MahmudElyamani/1kW-Resonant-Inductive-Wireless-Power-Transfer-System-Graduation-Project-/WPT Coil design/README.md

# Coil Topology Presentation
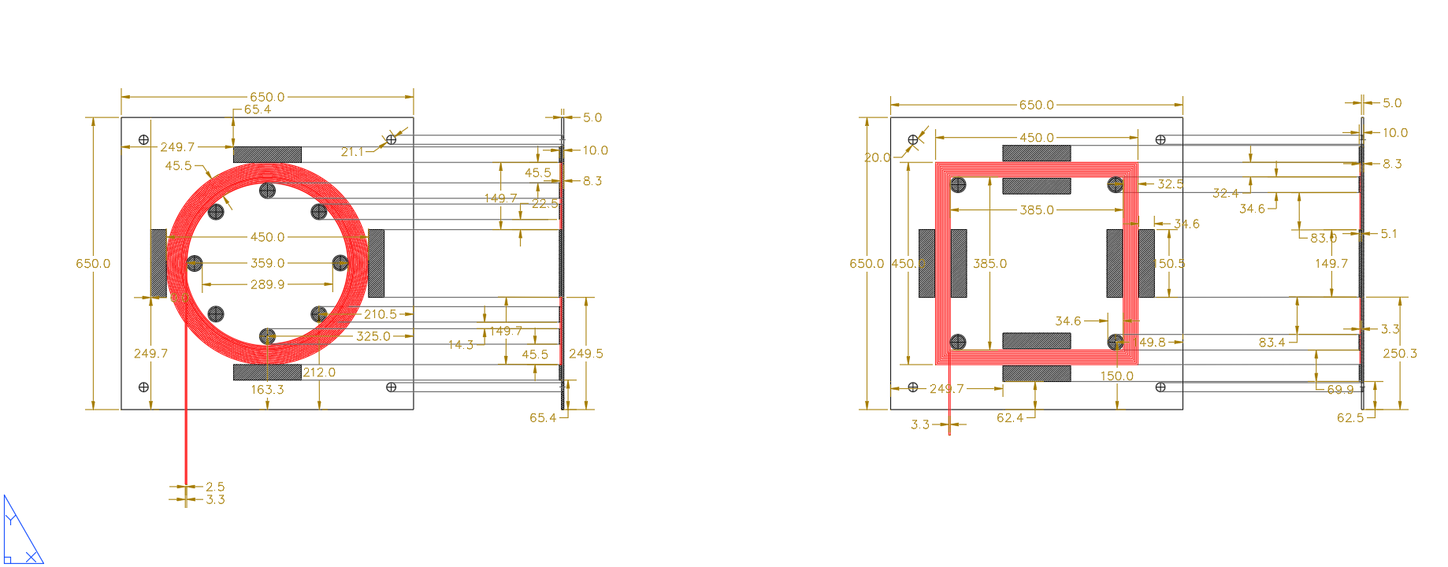
[picture p23: WPT Coil design/inductco.PNG]
Full Power System Model


# Actual Induction coils shot from laboratory 
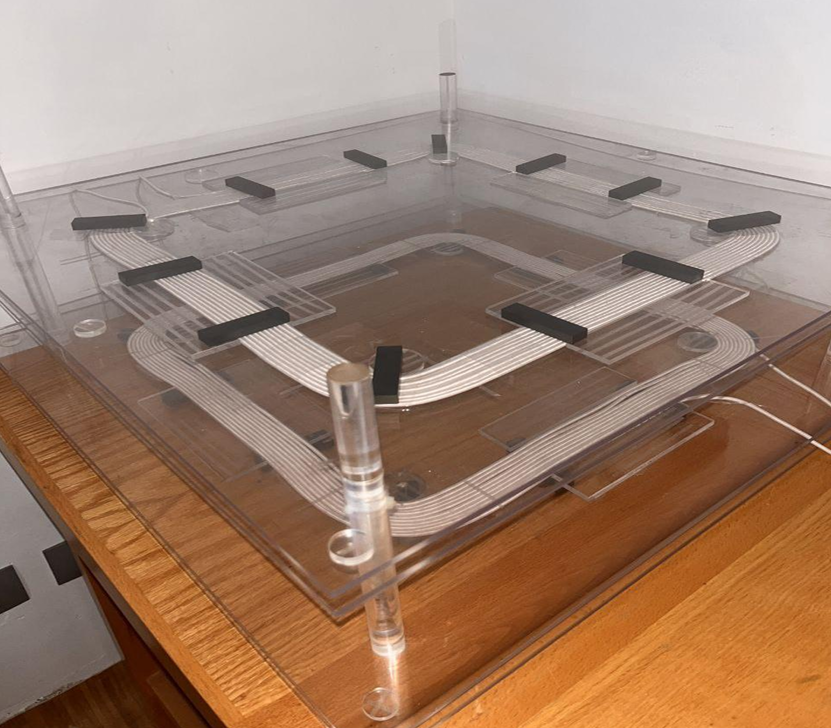
[picture p24: WPT Coil design/WPTC.PNG]
InductionCoilsActual
