MahmudElyamani/1kW-Resonant-Inductive-Wireless-Power-Transfer-System-Graduation-Project-/WPT-Book.pdf

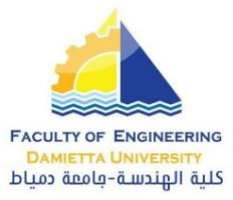
[picture p45: figure]
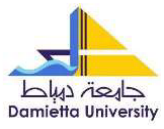
[picture p46: figure]

# An efficient 1KW resonant inductive wireless power transfer prototype for electric vehicles, with square-shaped coils

### Prepared by

Mahmoud Hisham Elyamani | Walid Salah Gebril
Mohamed Atef Ameen | Ezzeldin Ali Khedr
Mohamed Tarek Ouf | Manar Dawoud Mohammed
Eslam Ayman Badawy | Zeinab Elsayed Abdelbasset

B.Sc. Students in Electrical Power and Machines Department Faculty of Engineering, Damietta University

### Under Supervision of

# Prof.Dr. Osama Ali Orabi Dr. Mohamed Osman Atallah

Electrical Power and Machines Department Faculty of Engineering
Damietta University
| 2024 – 2025

# An efficient 1KW resonant inductive wireless power transfer prototype for electric vehicles, with square-shaped coils

### Prepared by

Mahmoud Hisham Elyamani | Walid Salah Gebril
Mohamed Atef Ameen | Ezzeldin Ali Khedr
Mohamed Tarek Ouf | Manar Dawoud Mohammed
Eslam Ayman Badawy | Zeinab Elsayed Abdelbasset

B.Sc. Students in Electrical Power and Machines Department Faculty of Engineering, Damietta University

### Under Supervision of

# Prof.Dr. Osama Ali Orabi Dr. Mohamed Osman Atallah

Electrical Power and Machines Department Faculty of Engineering
Damietta University
| 2024 – 2025

# ر ِحيِم

# ِن ال َّ

ـ

ٰ
ح َم

ْ
ر

# ـ ِه ال َّ

َّ

# سِم الل

ْ ِ
ب

## ل َحِكيمُ "

## لعَِليمُ اْ

## أن َت اْ

ن َك َ

َّ

## ل ْمتََناۖ إِ

َّ

## َل َما َع

َّ

## لَنا إِ

َ
لمَ

## لوا سُ ْب َحاَن َك ََل ِعْ

قاُ
َ "

## سورة البقرة اآلية )32(

I

# Team Data

No. | Name | E-mail
1 | Mahmoud Hisham Elyamani | Mahmoud.elyamani.7@gmail.com
2 | Walid Salah Gebril | walidsalahgebril1282002@gmail.com
3 | Mohamed Atef Ameen | mfarh2684@gmail.com
4 | Ezzeldin Ali Khedr | ezzoeldin24@gmail.com
5 | Mohamed Tarek Ouf | mohamedtarekouf1@gmail.com
6 | Manar Dawoud Mohammed | manardawoud80@gmail.com
7 | Eslam Ayman Badawy | eslaambadawy@gmail.com
8 | Zeinab Elsayed Abdelbasset | zeinabsraya@gmail.com

II

# Acknowledgment

## Before all, we deeply thank ALLAH for helping us to accomplish this Project and we devote it to our families especially our parents, for their encouragement, patience

and assistance over the years.

## It is a pleasure to express our deepest thanks and profound respect to Dr. Mohamed Osman Atallah for his continuous encouragement and invaluable supervision and guidance throughout this work. It has been an honor and a

privilege to work under his generous supervision.

Also, we wish to express our deep gratitude to Prof.Dr.

## Osama Ali Orabi for his kind support, help and careful

supervision.

## Furthermore, we wish to express our deep gratitude to Assistant Prof.Dr. Marwa Fayez Fahmy, the head of the Electrical Power and Machines Department, Faculty of

Engineering, Damietta University, for her supervision, guidance and meticulous oversight.

## Sponsored by:

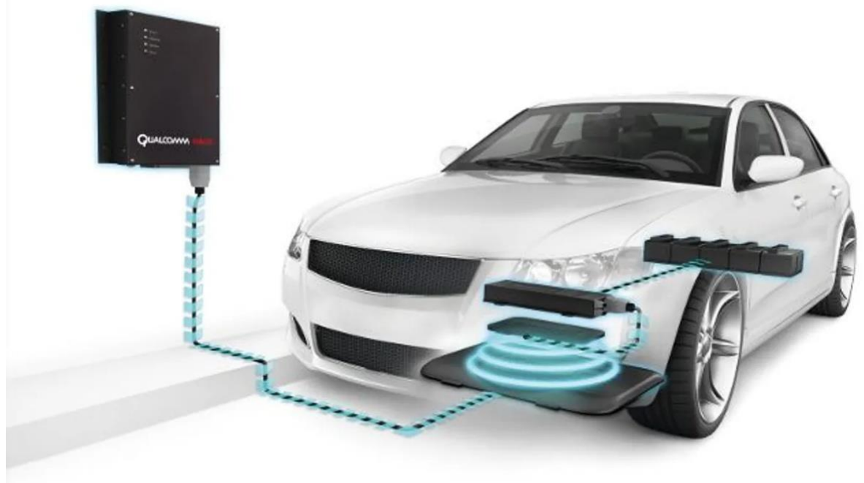
[picture p47: figure]

III

# Abstract

In this project, a practical prototype of a resonant inductive wireless

charging system for electric vehicles is implemented. The system delivers

a DC output power of 823-watt when the coils are aligned with a 15 cm air

gap between the 45 x 45 cm square transmitter coil and the 45 x 45 cm

square receiver coil. The system operates at a resonant frequency of 83.5

kHz which is in accordance with the SAE J2954 international standard,

achieving an efficiency of 77.5%.

The system is simulated using ANSYS Maxwell 3D and ANSYS

Simplorer softwares to study the magnetic-field distribution for different

coil geometries such as circular and square coils at various misalignment

positions as well as the effect of ferrite magnets, and to determine the

system parameters.

The simulation results are compared with practical values and

verified using mathematical equations and MATLAB/Simulink software

to ensure the accuracy of the simulation.

IV

# Table of Contents

V

# List of Abbreviations

AC | Alternating Current
BMS | Battery Management System
CC | Constant Current
CF | Crest Factor
CL | Capacitor Inductor
CV | Constant Voltage
CWPT | Capacitive Wireless Power Transfer
DC | Direct Current
DD | Double-D
EVs | Electric Vehicles
FEA | Finite Element Analysis
FEMs | Finite Element Models
GCR | Ground Clearance Range
GSP | Ground Side Pad
HF | High Frequency
HFI | High Frequency Inverter
HV | High Voltage
IWPT | Inductive Wireless Power Transfer
KVL | Kirchhoff’s Voltage Law
LC | Inductor Capacitor
LCC | Inductor Capacitor Capacitor
MEPT | Maximum Efficiency and Power Tracking
MGWPT | Magnetic Gear Wireless Power Transfer
MPP | Maximum Power Point
NPPs | Non-Polarized Pads
PF | Power Factor
PMs | Permanent Magnets
PP | Parallel-Parallel
PPs | Polarized pads
PS | Parallel-Series
QD | Quad-D
RIWPT | Resonant Inductive Wireless Power Transfer
SAE | Society of Automotive Engineering

VI

SP | Series-Parallel
SS | Series-Series
WPT | Wireless Power Transfer

VII

# List of Acronyms

CF | The filtering capacitance before the load
Cr | The capacitance of the receiving circuit
Ct | The capacitance of the transmitting circuit
Di | The inner diameter of each turn
Do | The outer diameter of each turn
Ds | The diameter of each strand
f | The resonant frequency
H A constant correlating to the number of strands, as | specified in the datasheet of Litz wire
h | The gap distance between the two coils
Iin | The input RMS supply current
IL | The output load DC current
Ir | The RMS receiving current
It | The RMS transmitting current
K The coupling coefficient
Lr | The self-inductance of the receiving coil
Lt | The self-inductance of the transmitting coil
lLitz | The length of the Litz wire
lr | The outer length of the receiving coil
lri | The inner length of the receiving coil
lt | The outer length of the transmitting coil
lti | The inner length of the transmitting coil
M The mutual inductance
N The number of strands
PAC | The RMS power delivered to the equivalent AC resistive load
Pbat | The battery power
Pin | The input active power
PL | The output load DC power
Qin | The input reactive power
RAC | The AC resistance of the Litz wire which represents both the skin and proximity effects
RDCl | The DC resistance of the Litz wire per length
RL | The DC resistive load
RLeq | The equivalent AC resistive load

VIII

Rr | The DC resistance of the receiving coil
Rt | The DC resistance of the transmitting coil
rr | The half of side length of the receiving coil
rt | The half of side length of the transmitting coil
Si | Surface copper area of each turn, without the insulation
sin | The input apparent power
So | Surface area of each turn, considering the insulation
Tr | No. of turns of the receiving coil
Tt | No. of turns of the transmitting coil
u | The square side length of each coil
V1 | The output HF AC voltage
V2 | The AC voltage across the equivalent AC resistive load
V1o | The output HF AC voltage at resonance
V2o | The AC voltage across the equivalent AC resistive load at resonance
Vbat | Battery Voltage
VDC | DC output voltage from the DC supply (Input DC voltage to HFI)
Vin | The input RMS supply voltage
VL | The output load DC voltage
W The resistance ratio of a single strand when isolated
wr | The outer width of the receiving coil
wri | The inner width of the receiving coil
wt | The outer width of the transmitting coil
wti | The inner width of the transmitting coil
ηs−s | The efficiency while using SS compensation
µo | The permeability of the vacuum
ρcu | The resistivity of the copper
ω | The angular frequency
ωo | The resonant angular frequency

IX

# List of Tables

Table 1-1: Specific characteristics of compensation circuit topology .......9

Table 1-4: The characteristics of Mn-Zn large size ferrite for high power

Table 2-1: Comparative analysis of the proposed system and existing

Table 3-1: SAE j2954 recommendations concerning Z- class

Table 3-3: Misalignment data in different positions for each scenario....36 Table 3-4: Multiple misalignment error data in case of horizontal

Table 3-5: Multiple misalignment error data in case of horizontal

Table 3-6: Multiple misalignment error data in case of horizontal misalignment in (-x, -y) with a non-uniform air gap in the Z-axis

Table 3-7: Multiple misalignment errors is a horizontal misalignment in (-x, -y) direction, combined with a non-uniform air gap in the Z-axis

X

Table 4-1: The simulated, calculated and measured values of the self-

Table 4-2: The simulated, calculated and practical values of the coupling

Table 4-3: The simulated, calculated and measured values of the self-

Table 4-4: The simulated, calculated and practical values of the coupling

Table 4-5: The simulated, calculated and measured values of the capacitances of the receiving and the transmitting circuits without using

Table 4-6: The simulated, calculated and measured values of the capacitances of the receiving and the transmitting circuits with using

Table 4-7: ANSYS Maxwell 3D results of the M, K and the magnitude of the magnetic flux of the two coils and ANSYS Simplorer results of the

Table 4-8: The comparison between the ANSYS Simplorer, MATLAB Simulink, calculated and practical values of the different electrical

XI

# List of Figures

Figure 3-2: The SS compensation topology with AC/DC converter .......25

Figure 3-4: The ANSYS Maxwell 3D model for the WPT system.........32

Figure 3-6: The different air gaps between the transmitter and receiver

Figure 3-7: The different positions of horizontal misalignment for each

Figure 3-8: Angles exist between the transmitting and receiving coil

Figure 3-9: A non-uniform air gap in the Z-axis direction with rotation

Figure 3-10: Multiple misalignment error positions in case of horizontal

Figure 3-11: Multiple misalignment error positions in case of horizontal

Figure 3-12: Multiple misalignment error positions in case of horizontal misalignment in (-x, -y) with a non-uniform air gap in the Z-axis

Figure 3-13: Multiple misalignment errors is a horizontal misalignment in (-x, -y) direction, combined with a non-uniform air gap in the Z-axis

Figure 3-16: The m-file and the function file for calculating the half of

Figure 3-17: The m-file and the function file for calculating the DC

XII

Figure 3-18: The m-file and the function file for calculating the self-

Figure 3-19: The m-file and the function file for calculating the mutual

Figure 3-20: The m-file and the function file for calculating the coupling

Figure 3-21: The m-file and the function file for calculating the capacitances of the transmitting and the receiving circuits without using

Figure 3-22: The m-file and the function file for calculating the RMS

Figure 3-23: The m-file and the function file for calculating the RMS

Figure 3-24: The m-file and the function file for calculating the RMS power delivered to the equivalent AC resistive load with using ferrite ...77 Figure 3-25: The m-file and the function file for calculating the efficiency

Figure 3-26: Pie chart showing the distribution of the production price for

Figure 4-1: the relationship between horizontal misalignment in X-axis

Figure 4-2: The relationship between horizontal misalignment in X-axis

Figure 4-3: The relationship between vertical misalignment in Z-axis and

Figure 4-4: The relationship between vertical misalignment in Z-axis and

Figure 4-5: The relationship between horizontal misalignment in X-axis,

XIII

Figure 4-6: The relationship between horizontal misalignment in X-axis,

Figure 4-7: The magnetic flux animations of shapes of figure 3-14, 1.

Figure 4-8: The magnetic flux animations of shapes of figure 3-14, 2.

Figure 4-9: The magnetic flux animation of the WPT design using ferrite

Figure 4-10: The results of m-file for calculating the half of side lengths

Figure 4-11: The results of m-file for calculating the DC resistances of

Figure 4-12: The results of m-file for calculating the self-inductances of

Figure 4-13: The results of m-file for calculating the mutual inductance

Figure 4-14: The results of m-file for calculating the coupling coefficient

Figure 4-15: The results of m-file for calculating the capacitances of the

Figure 4-16: The results of m-file for calculating the RMS transmitting

Figure 4-17: The results of m-file for calculating the RMS receiving

Figure 4-18: The results of m-file for calculating the RMS power

Figure 4-19: The results of m-file for calculating the efficiency while

Figure 4-20: The transmitter’s AC current wave obtained from ANSYS

Figure 4-21: The receiver’s AC current wave obtained from ANSYS

Figure 4-22: The load DC current through the resistive load obtained

Figure 4-23: The load DC voltage at the resistive load obtained from

Figure 4-24: The transmitter’s AC current wave obtained from MATLAB

XIV

Figure 4-25: The receiver’s AC current wave obtained from MATLAB
Simulink in case of 15 cm air gap | 121
Figure 4-26: The load DC current through the resistive load obtained
from MATLAB Simulink in case of 15 cm air gap | 122
Figure 4-27: The load DC voltage through the resistive load obtained
from MATLAB Simulink in case of 15 cm air gap | 122
Figure 4-28: The relation between the frequency and output power ..... 124 Figure 4-29: The relation between the frequency and the efficiency .... 124 Figure 4-30: The transmitter electrical box which includes the HFI and
the series transmitter’s compensation | 126
Figure 4-31: The receiver electrical box which includes the series
receiver’s compensation and the AC/DC converter | 126
Figure 4-32: The practical RIWPT system | 127
Figure 4-33: The reading of the DC voltage through the load by a
laboratory scope | 127
Figure 4-34: The reading of the DC current through the load by a
laboratory clamp meter | 128

Chapter (1) | Project Introduction | 1

### 1 Chapter (1): Project Introduction

### 1.1 Introduction

With the world's increasing interest in finding solutions to

environmental issues and climate change, the need has emerged to replace

traditional vehicles that run by fossil fuels with clean EVs that have been

recently developed and spread widely to reduce environmental

pollution[1,2,3]. Recently, electrification has been considered as a

significant revolution within the transportation sector, aiming to improve

efficiency, promote environmental sustainability and enhance safety [4].

The adoption of EVs contributes to decreasing greenhouse gas emissions,

reducing dependance on fossil fuels, improving driving satisfaction and

lower operational costs [4]. The challenges facing the widespread adoption

of EVs include concerns about charging infrastructure availability, range

limits and long duration of the recharging [4].

WPT offers numerous advantages, including automatic operation

without the need for driver intervention, maintenance-free operation,

enhanced safety and convenience in challenging conditions such as snow,

rain, and dust [4].

EV charging is classified into onboard and offboard charging. In

onboard charging, the charging and conversion system is inside the vehicle

and the charging speed is slow because it is limited by the size of the

vehicle, while in offboard charging, the charging and conversion system is

outside the vehicle, usually at charging stations and is connected directly

to the vehicle battery and the charging speed is faster. The charging

systems developed from slow charging (level 1) which is used in homes to

fast charging (level 2) which is used in public places and then to faster DC

charging (level 3) [2].

Chapter (1) | Project Introduction | 2

EV charging systems have developed to become wireless, which

relies on the transfer of energy through a magnetic field between

transmitter and receiver as it does not require cables like traditional

charging. The WPT process is autonomous, which has made it attractive to

charge self-driving EVs as the vehicle can charge itself automatically

without connecting the charging cable. It can also be developed to charge

vehicles while moving wirelessly, which helps increase the range that the

vehicle can travel before the battery runs out, thus saving time and making

the charging process more convenient [1,2,5].

Chapter (1) | Project Introduction | 3

### 1.2 Methods of WPT

I) CWPT: This type is characterized by its low cost, as it does not

require a ferrite magnet, and it also features simple power transfer [2]. In

this type, capacitors are used to transfer power, as shown in Figure 1-1. An

AC voltage is connected to an H-bridge inverter, which in turn produces a

high-frequency alternating voltage. Then, some inductors are connected in

series with the capacitors to reduce the impedance on both sides of the

transmitter and receiver. This type is used in low-power applications such

as phone chargers and rotating machinery [6].

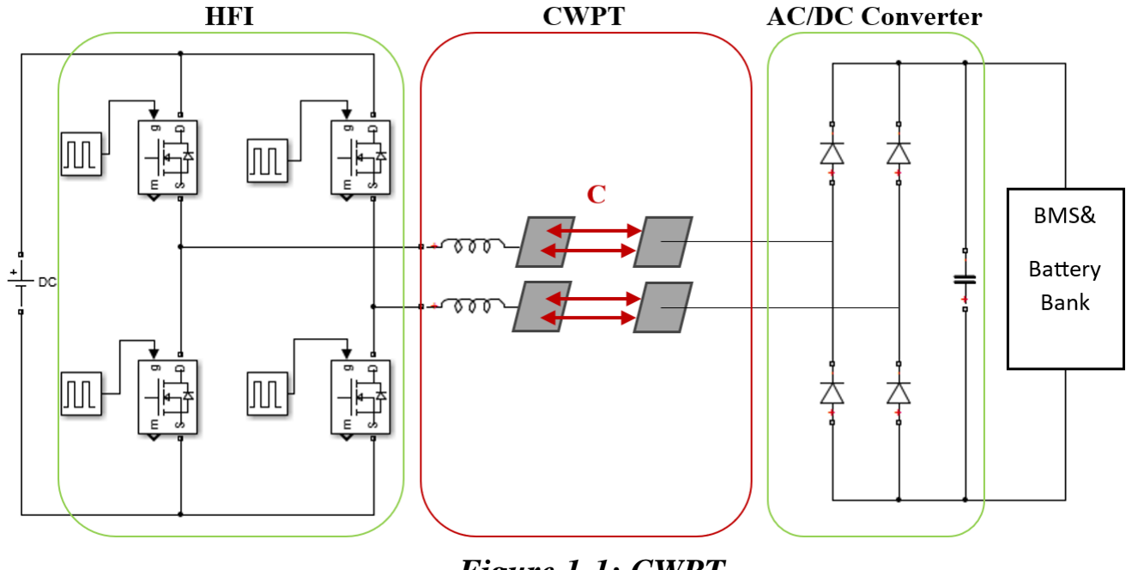
[picture p48: figure]

II) MGWPT: In this type, two synchronous PMs are placed next to

each other. An Alternating Current (AC) voltage is connected to the

transmitter winding, which generates a mechanical torque on the

transmitter magnet, causing it to rotate. This causes the receiver magnet to

rotate. It is clear that the transmitter magnet acts as a generator, while the

receiver magnet receives energy from the transmitter magnet. Through a

Battery Management System (BMS), this energy is delivered to the battery

[6], this process is shown in Figure 1-2.

Figure 1-1: CWPT

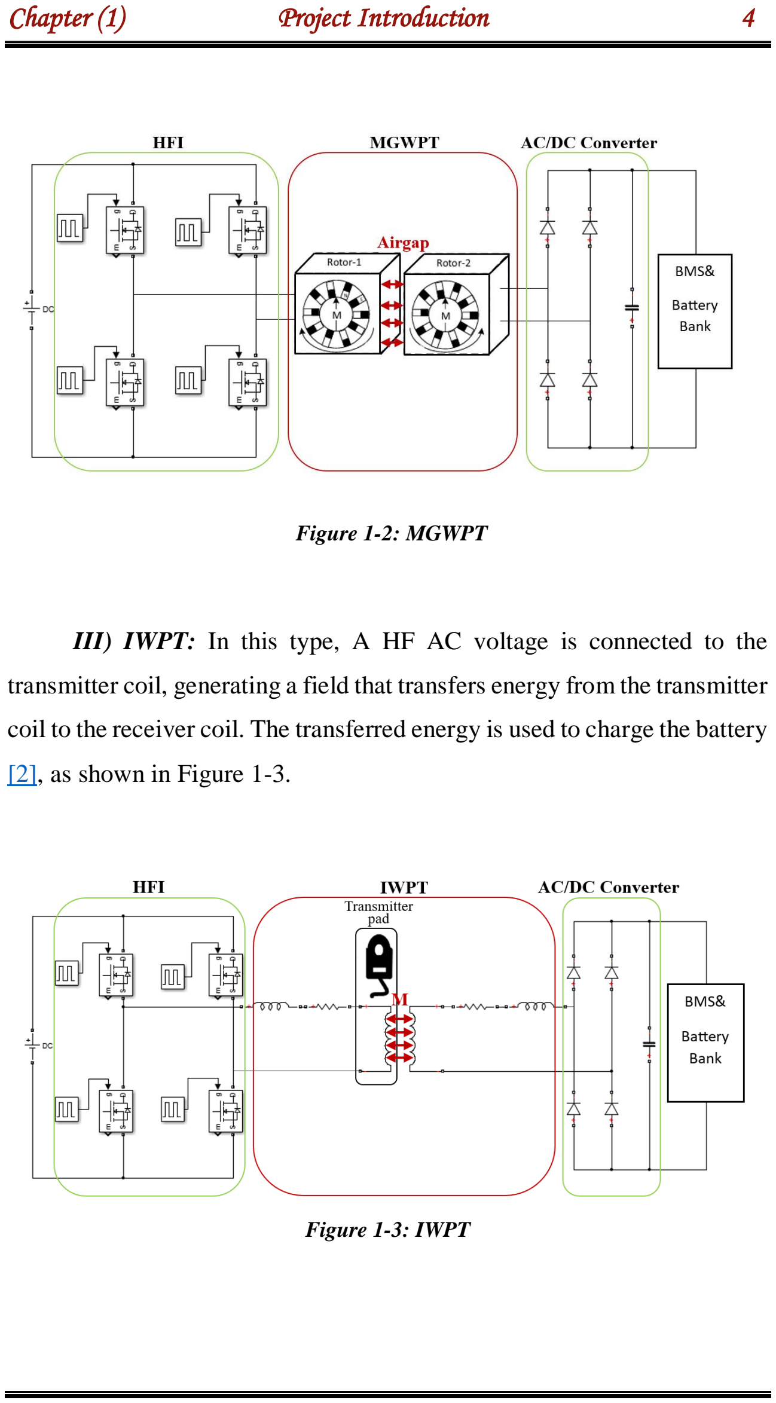
[picture p49: page 21]

Chapter (1) | Project Introduction | 4

III) IWPT: In this type, A HF AC voltage is connected to the

transmitter coil, generating a field that transfers energy from the transmitter

coil to the receiver coil. The transferred energy is used to charge the battery

[2], as shown in Figure 1-3.

Figure 1-3: IWPT

Figure 1-2: MGWPT

Chapter (1) | Project Introduction | 5

IV) RIWPT: This type is similar to IWPT, but it is more advanced.

It uses magnetically resonant coupled coils to transfer energy. A HF AC

voltage is connected to the transmitter coil, generating a magnetic field that

transfers energy. The receiver coil receives this energy, which is then used

to charge the battery. The difference between this type and IWPT is that

this type includes compensation circuits responsible for creating resonance,

reducing losses and improving power factors [6], this process is shown in

Figure 1-4. We will use this type in our project.

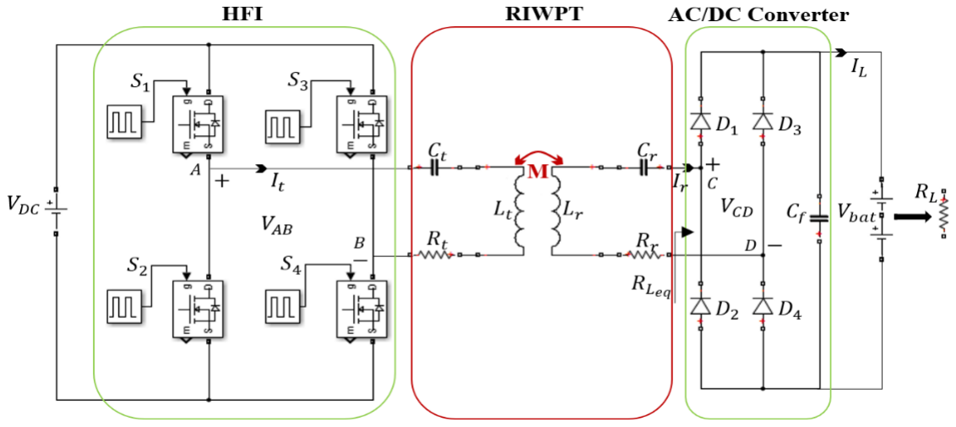
[picture p50: figure]

The schematic block diagram of WPT system for EVs is shown in

Figure 1-5. The AC voltage from the grid is converted to DC voltage

through AC/DC converter and then to high frequency AC voltage through

DC/AC inverter. To improve efficiency, Transmitting and receiving

compensation capacitors are added. The power is transferred through

magnetic field from the transmitter to the receiver both with ferrite magnets

to improve flux distribution and reduce leakage fluxes. The transmitted

power is converted to DC for charging the battery through AC/DC

converter. The transferred power decreases in case of misalignment

between the transmitter and the receiver [1,6].

Figure 1-4: RIWPT

Chapter (1) | Project Introduction | 6

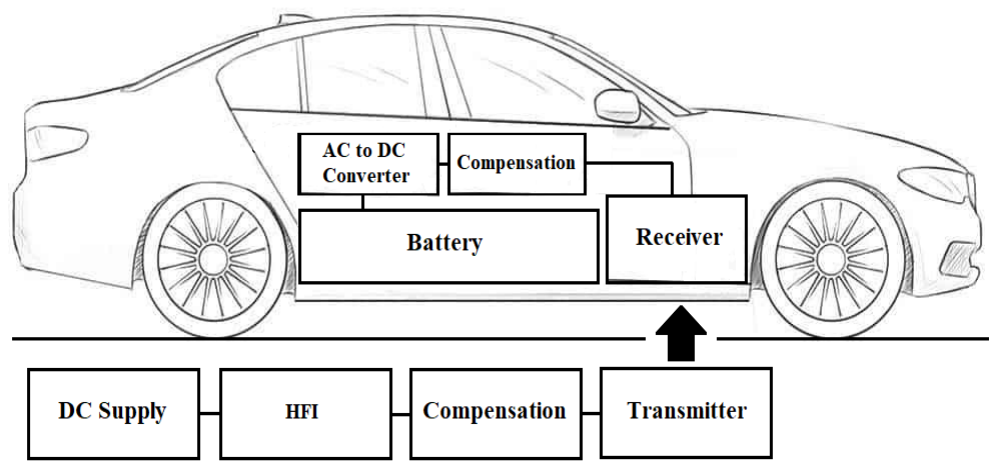
[picture p51: figure]

Figure 1-5: Schematic block diagram of WPT system for EVs

Chapter (1) | Project Introduction | 7

### 1.3 Compensation circuit

A major problem is efficiency in WPT, as cable charging is more

efficient than WPT. The transmitter and receiver coils in WPT have high

leakage inductance, requiring a large transmitter's current, which leads to

transmission losses and reduced efficiency. To solve this problem,

compensation capacitors are used [1].

Advantages of the compensation circuit include its ability to operate

in CV or CC modes, and it also improves the coupling coefficient (K) and

quality factor (Q) [7]. The main disadvantages are the high current and

voltage values associated with the resonance components [5].

To implement a compensation circuit, capacitors are added next to

the transmitter and the receiver coils in specific configurations. There are

four main types:

SS: A series capacitor is added to both transmitter and receiver coils.

SP: A series capacitor is added to the transmitter coil, and a parallel

capacitor is added to the receiver coil.

PS: A parallel capacitor is added to the transmitter coil, and a series

capacitor is added to the receiver coil.

PP: A parallel capacitor is added to the transmitter and receiver coils [2].

Figure 1-6. illustrates the compensation topologies. A capacitor is

placed next to the transmitter coil to reduce reactive power, and another

capacitor is placed next to the receiver coil to improve power transfer

efficiency [6].

Chapter (1) | Project Introduction | 8

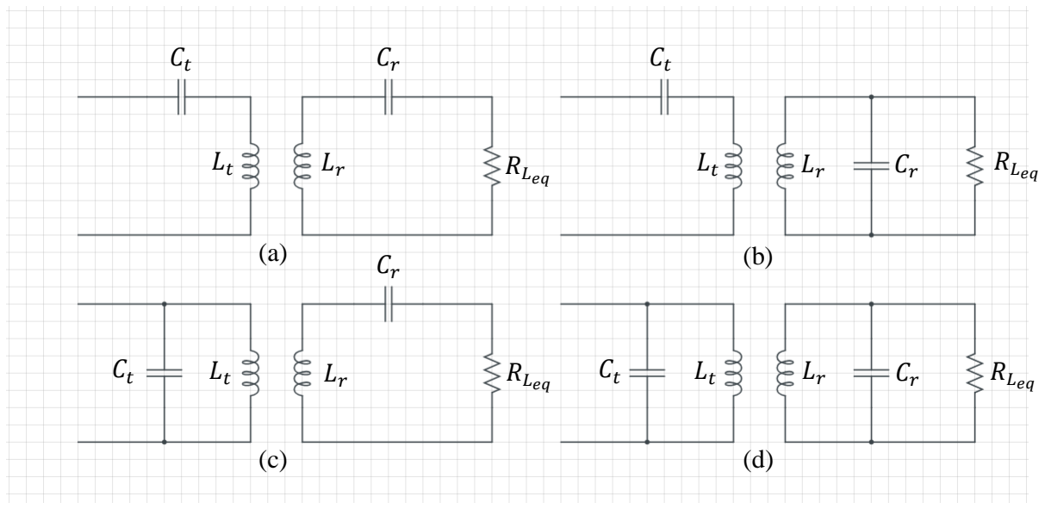
[picture p52: figure]
RLeq

Figure 1-6: Compensation topology

a. SS | b. SP | c. PS | d. PP

Each type of compensation circuit has its advantages and

disadvantages: PP and PS are safe because the transmitter coil does not

operate without the receiver coil. However, these types suffer from reduced

efficiency with misalignment. SP is highly beneficial because the

transmitter capacitor value does not depend on the mutual inductance but

on the load [6]. SS is one of the most common types and is ideal for EV

charging because it has an improved power transfer, the transmitter

capacitor value does not depend on the mutual inductance, and the resonant

frequency does not depend on the load or the mutual coupling [2].

Therefore, we will use this type in our project.

Each compensation circuit topology differs based on its specific

characteristics, including advantages, limitations, and parameters of

compensation. Table 1-1 [2,8] and table 1-2 [5,6] illustrate these

differences.

Chapter (1) | Project Introduction | 9

Table 1-1: Specific characteristics of compensation circuit topology

Features | SS | SP | PS | PP
Suitability for EV application | High | High | Moderate | Moderate
Frequency tolerance on efficiency | Low | High | Low | High
Power transfer capability | High | High | Low | Low
The sensitivity of the power factor over a distance | Low | Low | Moderate | Moderate
Alignment tolerance | High | High | Moderate | Low
The impedance at resonant state | Low | Low | High | High

Table 1-2: Parameters of compensation

Features | SS | SP | PS | PP
Transmitter capacitor | 1 2Lt ω0 | 1 M² ω0 2(Lt − ) Lr | 1 2 . M⁴ ω0 ω0 2(Lt − ) Lt . RL | 1 M⁴ 2 . RL ((Lt − M² ) + Lr 4 ω0 2 ) Lr M² . (Lt − ) 2 ω0 Lr
Receiver capacitor | 1 2Lr ω0 | 1 2Lr ω0 | 1 2Lr ω0 | 1 2Lr ω0
Load | ω0Lr Qr | ω0LrQr | ω0Lr Qr | ω0LrQr

Chapter (1) | Project Introduction | 10

### 1.4 Coil design

There are two types of coils based on main parts such as coil and protection

layers:

NPPs: consist of only one coil transmits and receives the flux in the

vertical direction only like traditional forms (circular, square, rectangular

and hexagonal). Circular coil is the most common shape because the eddy

current is as little as possible due to absence of any sharp edges. We used

the square coil because it allows horizontal misalignment compared to the

circular, reduces leakage flux and has higher power transfer capability. One

of the disadvantages of the square coil is that it has sharp edges which lead

to eddy current that increases the impedance, so it is not suitable in high

power applications [6].

PPs: Consist of several coils, transmit and receive flux in the vertical

and the horizontal directions, this is the least common type because it has

some disadvantages such as complex circuit design, slow switching speed

and high manufacturing costs. There are several shapes of it (Double D –

Bi-polar - Double D Quadrature - Quad D Quadrature) [6], table 1-3

illustrates these shapes.

Chapter (1) | Project Introduction | 11

Table 1-3: Several shapes of PPs

Shapes | Features
Double-D | It consists of two square or rectangular coils and generates flux in one direction only so the leakage flux at the edges decreases [6].
Bi-Polar | It consists of several coils of the same size but the coupling coefficient decreases if there is misalignment [6].
Double-D quadrature | It consists of more than one circular or square coil with a high coupling coefficient, its efficiency is very high, and it is very suitable in the receiver side because it attracts the magnetic flux in horizontal and vertical directions [6].
Quad-D Quadrature | It improves power transmission efficiency as it reduces energy loss during transmission. Its design reduces the effect of misalignment due to its multiple polarizations. It provides a wider charging area without the need for precise alignment.

Coil shapes are illustrated in Figure1-7.

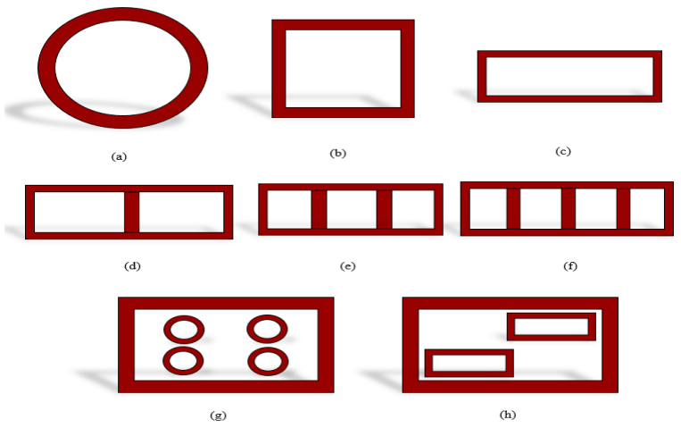
[picture p53: figure]

(a) Circular | (b) Square | (c) Rectangular | (d) Double D
(e) Bi-Polar | (f) DD Quadrature | (g) QD Quadrature | (h) Extended DD

Figure 1-7: Coil shapes

Chapter (1) | Project Introduction | 12

### 1.5 Ferrite magnets

Ferrite magnets are used in transmitting and receiving coils in WPT

systems to improve flux distribution. The high permeability of the ferrite

magnets minimizes the losses at high ranges of frequencies. The low

electrical conductivity of the ferrite magnets aids in minimizing eddy

currents [4].

When choosing ferrite magnets, several factors are taken into

consideration including shape, size, frequency and cost. Simple ferrite

shapes such as circular, square, rectangular and striated blocks have been

used in WPT systems for EVs.

Although other ferrite shapes such as U-core, Double U, T-core and

E-core give higher coupling coefficient, they are not suitable because of

their height as EVs have limited height from the ground, as shown in Figure

1-8 [6].

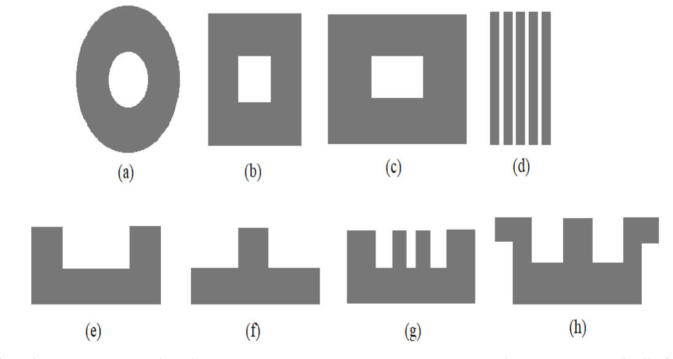
[picture p54: figure]

(a) Circular | (b) Square | (c) Rectangular | (d) Striated blocks
(e) U-core | (f) T-core | (g) Double U | (h) E-core

Figure 1-8: Ferrite shapes

Chapter (1) | Project Introduction | 13

Table 1-4 shows the characteristics of Mn-Zn large size ferrite for

high power (PC40) used in our prototype.

Table 1-4: The characteristics of Mn-Zn large size ferrite for high power (PC40) used in our prototype

Ferrite specifications
Initial permeability (µi) | 2300
Curie temperature | >200 °C
| At 100 KHz Pcv=420 kW/m³ Core loss
Electrical resistivity | 6.5 Ωm
Saturation magnetic flux density | At T=23°C Bs=500 mT At T=100°C Bs=380 mT
Remanent flux density | At T=23°C Br=125 mT

A thin aluminum layer is placed beneath the ferrites at a small

separation distance. This plate acts as a passive shielding, designed to

reduce the leakage electromagnetic fields [4].

Chapter (1) | Project Introduction | 14

### 1.6 Contribution

We conducted a detailed study on the issue of misalignment by

examining 52 different misalignment positions of the secondary coil to

understand their effect on the coupling coefficient and mutual inductance,

and consequently, on system efficiency. The misalignment cases

investigated can be categorized into the following types:

### 1. With uniform air gap:

- Air gap
- Horizontal misalignment
- Rotation around the Z-axis

### 2. With non-uniform air gap:

- Rotation around the X-axis or Y-axis

### 3. With multiple misalignment (hybrid):

- Horizontal misalignment with rotation around the Z-axis
- Horizontal misalignment in (-x, -y) direction with rotation

around the Z-axis

- Horizontal misalignment in (-x, -y) direction with a non-

uniform air gap along the Z-axis and rotation around the Y-axis

- Horizontal misalignment in (-x, -y) direction, combined with a

non-uniform air gap along the Z-axis and rotation around both

the Y-axis and Z-axis

Chapter (1) | Project Introduction | 15

We introduce by MATLAB software about ten script files which are

related to another ten script function files, in order to compare between the

calculated values of many parameters such as the self-inductances, the

mutual inductance, the coupling coefficient, ...etc. obtained by MATLAB

command windows, with the values obtained by ANSYS Maxwell 3D or

ANSYS Simplorer or MATLAB Simulink, also with the practical values.

We concluded a relation Eq. (22) to obtain our equivalent AC

resistive load. This is by equaling two equations of the transmitting RMS

current with each other. The first equation is Eq. (18), and the second

equation is Eq. (21) which is from Eq. (20) of the RMS power. At Eq. (22)

all parameters are included, where PAC is assumed, except RLeq

Chapter (2) | Literature Survey | 14

### 2 Chapter (2): Literature Survey

A prototype using a rectangular-shaped coil was created with a SS

compensation circuit at a frequency of 85 kHz. They then carried out a

comparison of different misalignment cases using ANSYS Maxwell 3D

software. One of the most significant challenges they encountered was the

misalignment issues [1].

This paper designs a WPT level 3/Z2-class with a circular

transmitting with both circular and DD receiver. The efficiency in the case

of circular receiver is 95.1% but it is reduced to 87.1% in maximum

misalignment case. While for a DD receiver the efficiency is 91.6% and it

is decreased to 89.5% which is higher compared to the circular receiver in

maximum misalignment case [4].

A comparison was made between SS and SP compensation

topologies. The effect of mutual inductance, load and operating resonant

frequency on them was studied to determine the suitable topology for WPT

systems for EVs. Studies have shown that SS topology is better in the case

of lower loads, while SP is preferred in the case of higher loads. Also, a

500-watt WPT system was designed using ANSYS Maxwell simulation to

study SS and SP compensation topologies. It was noted that at higher gaps

between the transmitter and the receiver, the efficiency of SP was better

than of SS. However, the SS does not depend on the mutual inductance or

coupling coefficient, therefore the SS compensation topology is suitable

for WPT systems for EVs [7,9].

A prototype using a circular coil was created with SS compensation

circuit and discovered a method to improve the charging performance,

thereby maximizing the charging efficiency [8].

Chapter (2) | Literature Survey | 15

A wireless charger for EVs was developed based on a high-

frequency power converter to charge a lithium-ion battery at an air gap of

10 cm, achieving an efficiency of 85%. They used transmitter and receiver

coils in a circular shape with 10 turns, and the distance between each turn

was 1 mm. They also chose a compensation circuit of the SS type and used

a ferrite magnet board to increase both the self and mutual inductances. A

DC voltage was used as the main power source, which was then converted

to AC at a frequency of 80 kHz using a single-phase inverter, providing 3.2

kW power on a 4-ohm load [10].

It discussed one of the main challenges in WPT, which is the

misalignment issue. To address this, they created 8 scenarios for

misalignment variations for a 1 kW prototype to solve the misalignment

issues at the MPP. In each scenario, the output power value varied

according to the specific misalignment pattern of that scenario. The coil

used in all scenarios was of the circular shaped coil, with SS-type

compensation [11].

A 1,000-watt prototype was created at a frequency of 85 kHz with

an air gap of 15 cm [12].

A MATLAB code was developed to calculate the parameters. Using

these parameters, they performed a simulation at ANSYS Maxwell 3D,

where they designed a rectangular coil with a SS compensation circuit at a

frequency of 17,702 Hz with an air gap of 20 cm. The output power was

15 kW with an efficiency of 75.38%. The dimensions were 100×60 cm and

60×60 cm respectively. They also studied different misalignment cases,

and the efficiency varied depending on the type of misalignment used in

the simulation. They analyzed the flux density distribution using ANSYS

Maxwell 3D and observed that the magnetic field exposure for the human

Chapter (2) | Literature Survey | 16

body remained within international safety standards. When comparing

MATLAB and ANSYS Maxwell 3D, it was found that the efficiency value

in MATLAB differed from that in ANSYS Maxwell 3D, because

MATLAB doesn’t account for losses [13].

A 300-W solar energy powered SS compensated WPT system that

requires fewer passive components is built over a transfer distance of 10

cm with an 88.5 % system efficiency. The proposed design has a ferrite-

less structure and efficient converters. The performance of the system is

evaluated under conditions of z-axes, horizontal and diagonal

misalignments. A 10 cm horizontal misalignment results in a 4.34 %

reduction in the output power, while the output power decreases by only

3.34 % with a diagonal misalignment. So, the system is robust under these

variations since there is no significant effect on the overall performance of

system [14].

The impact of tolerance on the overall performance of the WPT

system was studied and measured. The focus of this study was on the test

systems and coil structures outlined in SAE J2954, with particular

emphasis on tolerances related to the magnetic properties of materials and

the values of the compensation circuits. The main objective of this research

is to analyze the effect of uncertainties on the overall performance of the

WPT system, highlighting which components can have tolerances and

which cannot. This sheds light on the importance of component selection.

In this study, the coil used had a rectangular shape, and an SS-type

compensation circuit was implemented [15].

A mathematical optimization method was discovered and applied to

develop a prototype using a square coil with an LCC-S compensation

circuit and a power rating of 11 KW, in compliance with the SAE J2954

Chapter (2) | Literature Survey | 17

standard. The primary objective of the research was to ensure that the

overall system efficiency did not fall below 95%. To validate the results

before implementing the prototype, they conducted simulations using

MATLAB Simulink [16].

Two transmitter coils of same dimensions were used, connecting

their inner and outer terminals together, which improves the performance

of WPT system and its sensitivity to misalignment issues. A simulation

was conducted using ANSYS Maxwell 3D to calculate the mutual and self-

inductances of the system. Simulation results were verified using LTspice.

A prototype was developed using two transmitter coils and a receiver coil,

all in a circular shape. Additionally, an LCC-LCC compensation circuit

was implemented. The results showed that the system achieved a power

output of 1.95 kW with an efficiency of 93.07% at an air gap of 15 cm [17].

A system that integrates MEPT with an LCC-S compensation circuit

was developed, which dynamically adjusts its parameters and criteria to

enhance efficiency and overall WPT system performance, achieving

optimal operation, especially in cases of misalignment. They conducted

simulations using ANSYS Maxwell 3D and MATLAB Simulink to

validate the results, which showed that, compared to other compensation

circuits, this system improves efficiency by 4.67% and ensures dynamic

stability. A 3.3 kW prototype was built using a DD coil with a resonant

frequency of 85 kHz [18].

Chapter (2) | Literature Survey | 18

Table 2-1: Comparative analysis of the proposed system and existing literature

Ref. | f (KHz) | Compensation type | Coils size (cm) | Coils shape | Air gap (mm) | Power (KW) | Efficiency (%)
[1] | 85 | SS | 42x42, 32x32 | Rectangular | 60 | 4 | 96.89
[4] | 79.5 | LC-CL | 75x50, 35x32 | DD | 210 | 11.1 | 95.1
[7] | 85 | SS-SP | 10 outer diameter | Circular | ـــــ | 0.5 | ـــــ
[8] | 85 | SS | 50 outer diameter | Circular | 150 | 2 | 90.2
[10] | 80 | SS | 10 outer diameter | Circular | 100 | 3.2 | 85
[12] | 85 | SS | 44 outer diameter | Circular | 150 | 1 | 93.8
[13] | 17.702 | SS | 60x100, 60x60 | Rectangular | 200 | 15 | 75.38
[14] | 85 | SS | 40x40,35x35 | Square | 100 | 0.3 | 88.5
[17] | 85 | LCC-LCC | ـــــ | Dual | 150 | 1.95 | 93.07
[18] | 85 | LCC-Series | ـــــ | DD | 100 | 3.3 | 93.12
Proposed | 83.3 | SS | 45x45 | Square | 150 | 1 | Calculated 98.21 Practical 77.5

Chapter (3) | Methodology | 19

### 3 Chapter (3): Methodology

### 3.1 Equations

In the scaling of the windings, the outer and inner widths and lengths

of the transmitting and the receiving windings are denoted as wt ,
wti

, wr

,wri

, lt

,lti

,lrand lri
respectively as shown in Figure 3-1.

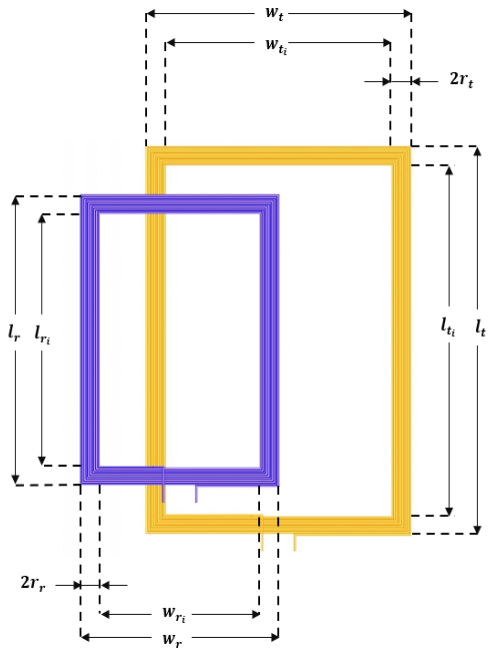
[picture p55: figure]

By following equations given by Sallán et al., the single side lengths

(2rt and 2rr) created by the windings are given by Eq. (1) and Eq. (2)

respectively [13].

rt = Tt√
So
π

(1)

Figure 3-1: Windings geometry

rr = Tr√
So
π

(2)

Where,

Tt

is the no. of turns of the transmitting coil.

So is the surface area of each turn, considering the insulation.

Tr

is the no. of turns of the receiving coil.

For considering both the skin and proximity effects, the AC

resistance of the Litz wire (RAC) is given by Eq. (3) [4].

RAC = RDCl

[W + H (

N Ds
Do

)

2
(

Ds √f
10.44 )

4
] | (3)

Where,

RDCl

is the DC resistance of the Litz wire per length.

W represents the resistance ratio of a single strand when isolated.

H is a constant correlating to a number of strands (N), as specified in

the datasheet.

N is the number of strands.

Ds

is the diameter of a strand.

Do is the outer diameter of each turn.

f is the resonant frequency.

But since we use Litz wire, the skin and proximity effects are

neglected. The DC transmitting and receiving windings resistances (Rt

and Rr) are given by Eq. (4) and Eq. (5) [13].

Rt = ρcuTt

2(wt+lt

)
Si

(4)

Rr = ρcuTr

2(wr+lr

)
Si

(5)

Where,
ρcu is the resistivity of the copper.

Tt

is the number of turns of the transmitting coil.

wt

is the outer width of the transmitting coil.

lt

is the outer length of the transmitting coil.

Si

is the surface copper area of each turn, without the insulation.

Tr

is the number of turns of the receiving coil.

wr

is the outer width of the receiving coil.

lr

is the outer length of the receiving coil.

The transmitting and the receiving windings self-inductances are

given by Eq. (6) and Eq. (7) [13].

Lt=

µo
π

×Tt

2
[ at+bt − 2ct + 0. 25(wt + lt)] | (6)

Where,
µo is the vaccum permeability.

Tt

is the number of turns of the transmitting coil.

wt

is the outer width of the transmitting coil.

lt

is the outer length of the transmitting coil.

at = wt × ln

2wt

lt
rt(wt + √wt
2 + l
t

2
)

bt = lt × ln

2wt

lt
rt

(lt + √wt
2 + l
t

2
)

ct = wt + lt − √wt
2 + l
t

2

Lr=

µo
π

×Tr

2
[ ar+br − 2cr + 0. 25(wr + lr)] | (7)

Where,
µo is the vaccum permeability.

Tr

is the number of turns of the receiving coil.

wr

is the outer width of the receiving coil.

lr

is the outer length of the receiving coil.

ar = wr × ln

2wr

lr
rr(wr + √wr
2 + lr

2)

br = lr × ln

2wr

lr
rr(lr + √wr
2 + lr

2)

cr = wr + lr − √wr
2 + lr

2

The mutual inductance can be approximated using the following

expression derived from Neumman’s formula, that is, valid for square coils

that are perfectly aligned [19].

M =

2µo
π

×TtTr

[uln(

u√h2+u2+h
2+u

2
hu+h√h2+2u2

) + h − 2√h2 + u2 + √h2 + 2u2]

(8)

Where,
µo is the vaccum permeability.

Tt

is the number of turns of the transmitting coil.

Tr

is the number of turns of the receiving coil.

u is the square side length of each coil (equals wt = lt = wr = lr , for
square coils).

h is the gap distance between the two coils.

The degree of coupling between the transmitting and receiving coils

is represented by the magnetic coupling coefficient K, which is directly

related to mutual inductance. This can be defined by Eq. (9) [1].

K =

M
√Lt×Lr

(9)

Where,

M is the mutual inductance.

Lt
is the self-inductance of the transmitting coil.

Lr
is the self-inductance of the receiving coil.

Wireless Power Transfer (WPT) technology is less efficient than

conductive charging methods while transferring and receiving power,

which remains its main limitation. Most recent research on WPT focuses

on developing resonant circuit topologies and optimizing power electronic

converter control strategies, whether on the charger side or the load side.

For efficient power transfer, a large transmitter current is required.

However, this high current reduces the system’s efficiency because it

causes losses in the system. To improve efficiency, reactive elements can

be compensated using capacitors, leaving only resistive elements in the

system, which helps minimize losses. Various compensation topologies

have been explored, each with their own benefits and drawbacks. The

choice of topology depends on the specific requirements of the application.

For electric vehicle (EV) charging, the series-series compensation

topology is the most suitable, as it can be designed independently of

coupling and load variations. At resonance, the following relation can be

satisfied as shown in Eq. (10). For WPT, the SAE J2954 frequency range

of 79 to 90 KHz should be used. The 85 KHz is the nominal frequency.

The capacitances of the SS compensations of the transmitting and

the receiving circuits can be calculated by Eq. (10) and Eq. (11).

Ct =

1
4 π2 f

2 Lt

(10)

Cr =

1
4 π2 f

2 Lr

(11)

Where,
f is the resonant frequency.

Lt
is the self-inductance of the transmitting coil. Lr
is the self-inductance of the receiving coil.

The resonant angular frequency can be calculated by Eq. (12).

ωo =

1
√Lt×Ct

=

1
√Lr×Cr

(12)

Where,
Lt
is the self-inductance of the transmitting coil.

Ct
is the capacitance of the transmitting circuit.

Lr
is the self-inductance of the receiving coil. Cr
is the capacitance of the receiving circuit.

The input DC voltage to HFI (VDC), is converted into HF AC

voltage. The electromagnetic field effect transfers AC power to the

receiving coil. The transmitting and receiving coils act as magnetic

couplers between the power source and the load. The AC power from the

receiving coil is then rectified, with an output capacitor filtering any ripples

as shown in Figure 3-2.

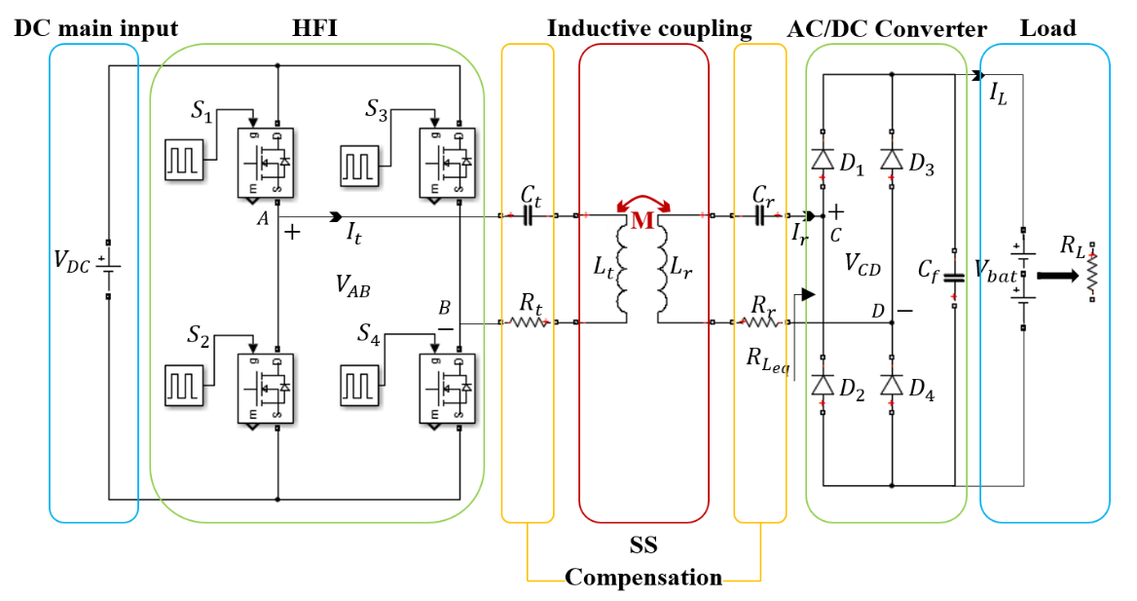
[picture p56: figure]

Figure 3-2: The SS compensation topology with AC/DC converter

The receiver side rectifier, filter and battery load are modeled as an

equivalent AC resistive load (RLeq

) based on battery power (Pbat) and

voltage (Vbat) [1,12]. as shown in Figure 3-3. This can be defined by Eq.

(13)

RLeq
=

8
π2

×

Vbat

2

Pbat

(13)

Where,

Vbat is the battery voltage.

Pbat is the battery power.

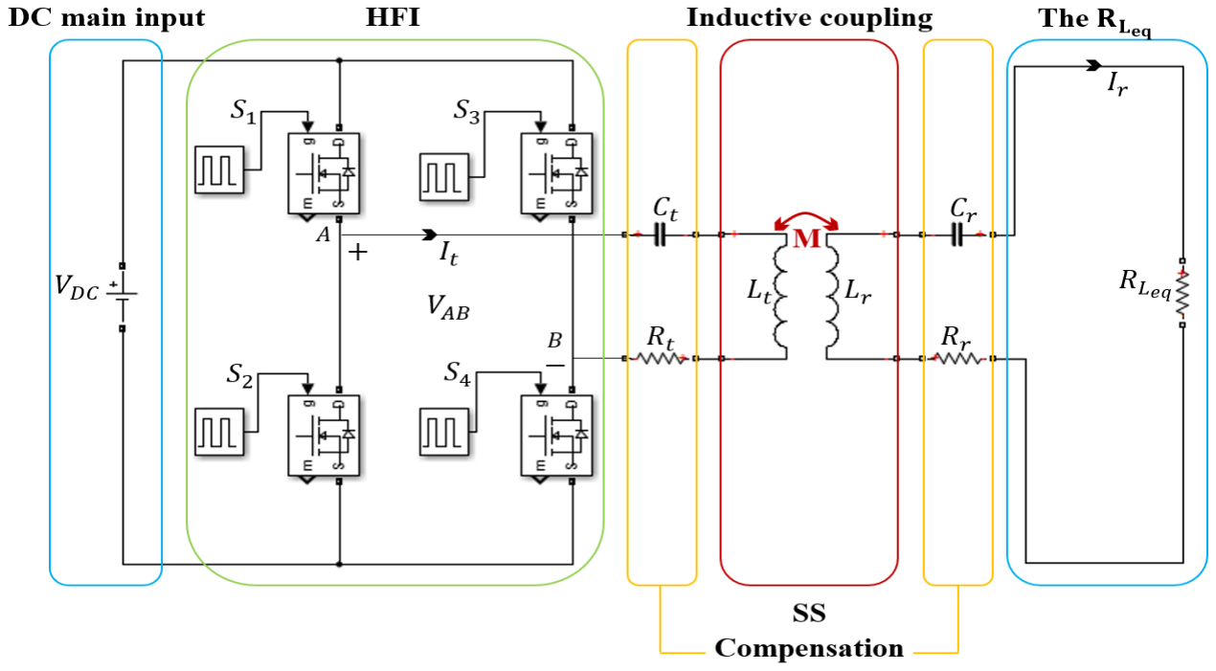
[picture p57: figure]

The effect of mutual inductance on the electrical circuit containing

the transmitting coil can be represented by a dependent voltage source,

which is a function of the current flowing through the receiving coil. By

applying Kirchhoff’s Voltage Law (KVL) to the transmitting coil circuit,

the output high-frequency (HF) AC voltage is given by Eq. (14) [1].

V1= (

1
jωCt

+ jωLt + Rt ) It − jωMIr
(14)

Where,
ω is the angular frequency.

Ct
is the capacitance of the transmitting circuit.

Lt
is the self-inductance of the transmitting coil. Rt
is the DC resistance of the transmitting coil.

Figure 3-3: The SS compensation topology with RLeq load

It
is the RMS transmitting current.

M is the mutual inductance.

Ir
is the RMS receiving current.

Similarly, the effect of mutual inductance on the electrical circuit

containing the receiving coil can be represented by a dependent voltage

source, which depends on the current flowing through the transmitting coil.

By applying KVL to the receiving coil circuit, the AC voltage across the

equivalent AC resistive load is given by Eq. (15) [1].

V2= (

1
jωCr

+ jωLr + Rr ) Ir − jωMIt
(15)

Where,
ω is the angular frequency.

Cr
is the capacitance of the receiving circuit. Lr
is the self-inductance of the receiving coil.

Rr
is the DC resistance of the receiving coil.

Ir
is the RMS receiving current.

M is the mutual inductance.

It
is the RMS transmitting current.

At resonance, V1o

and V2o
can be calculated by Eq. (16) and Eq. (17) [1].

V1o= ItRt − jωoMIr
(16)

V2o= IrRr − jωoMIt
(17)

Where,
It
is the RMS transmitting current.

Rt
is the DC resistance of the transmitting coil.

ωo is the resonant angular frequency.

M is the mutual inductance.

Ir
is the RMS receiving current.
Rr
is the DC resistance of the receiving coil.

The expressions for RMS current flowing through the transmitting

and receiving coils at resonance are given by Eq. (18) and Eq. (19) [12].

It =

V1o

(RLeq

+Rr

)

Rt

(RLeq+Rr

)+(ωoM)

2

(18)

Ir =

−jωoMIt

RLeq+Rr

(19)

Where,
V1o
is the output HF AC voltage at resonance.

RLeq
is the equivalent AC resistive load.

Rr
is the DC resistance of the receiving coil. Rt
is the DC resistance of the transmitting coil.

ωo is the resonant angular frequency.

M is the mutual inductance.

At resonance, the RMS power delivered to the equivalent AC

resistive load is given by Eq. (20) [19].

PAC =

(ωoMIt

)

2

RLeq+Rr

(20)

Where,
ωo is the resonant angular frequency.

M is the mutual inductance.

It
is the RMS transmitting current.

RLeq
is the equivalent AC resistive load.

Rr
is the DC resistance of the receiving coil.

From the previous equation, we get the transmitting current as given

by Eq. (21).

It = √
PAC(RLeq+Rr

)

(ωoM)

2

(21)

Where,

RLeq
is the equivalent AC resistive load.

Rr
is the DC resistance of the receiving coil.

ωo is the resonant angular frequency.

M is the mutual inductance.

By equaling Eq. (18) with Eq. (21), we get the following relation

(22) in which all parameters are included, where PAC is assumed, except

our equivalent AC resistive load.

PAC
(ωoM)

2 =

V1o

2

(RLeq

+Rr)

[Rt(RLeq

+Rr)+(ωoM)
2]

2

( 22)

When using SS compensation, the efficiency ηs−s can be given by

Eq. (23) [1,8].

ηs−s =

(ωoM)

2 RLeq

Rt(RLeq +Rr)

2
+(ωoM)

2(RLeq+Rr
)

=

RLeq

RLeq+Rr+(

Rt(RLeq+Rr)

2

(ωoM)

2

)

(23)

Where,
ωo is the resonant angular frequency.

M is the mutual inductance.

RLeq
is the equivalent AC resistive load.

Rt
is the DC resistance of the transmitting coil. Rr
is the DC resistance of the receiving coil.

### 3.2 Simulations

### 3.2.1 Simulation with ANSYS Maxwell 3D

To simulate this application, we first used ANSYS Maxwell 3D to

design the two coils. ANSYS Maxwell 3D uses FEA to analyze the

magnetic field emitted from the transmitter to the receiver and provides the

most accurate results as much as possible since it has golden value for

applications where it is impossible to obtain accurate analytical solutions.

FEA can calculate the values of self-inductance, mutual inductance,

coupling coefficient, and magnetic flux as numerical and graphical results.

Based on the previously mentioned assumptions, we were able to

calculate the outer and inner diameters of the coil. Consequently, we

determined the number of turns and thus could estimate the length of the

wire that is used to wind the transmitter and receiver coils. We used these

parameters in the design to achieve the required power value with the

desired efficiency.

Table 3-1 shows SAE j2954 recommendations concerning Z- class

requirements and transmission power levels. We designed an ANSYS

Maxwell 3D model for the transmitter and receiver coils in a square shape

with the specifications shown in table 3-2 , and the spacing between two

coils equals 15 cm.

Table 3-1: SAE j2954 recommendations concerning Z- class requirements and transmission power levels

Table 3-2: The specifications of ANSYS Maxwell 3D model

Figure 3-4 shows the ANSYS Maxwell 3D model for the WPT

system. For minimizing computational time and effort for FEA, while

striking a suitable balance between accuracy and model complexity, the

coil windings may be represented in the configuration as one block of

copper, each representing a single turn [4].

GCR (cm) | Actual h | Power levels for light-duty EVs (kVA)
Z1-class | Z2-class | Z3-class | Above ground | Flush ground | Under ground | WPT1 | WPT2 | WPT3 | WPT4
10-15 | 14-21 | 17-25 | >GCR | =GCR | >GCR | 3.7 | 7.7 | 11.1 | 22
Specifications | Transmitter | Receiver
Length of wire | 20 m | 20 m
Diameter of wire | 3.25 mm | 3.25 mm
Dimension of coils | 450 mm × 450 mm | 450 mm × 450 mm
Number of turns | 10 turns | 10 turns
Region medium | Air
Material of coils | Copper | Copper
Current excitation | 10 A | 10 A
Terminal length | 700 mm | 700 mm

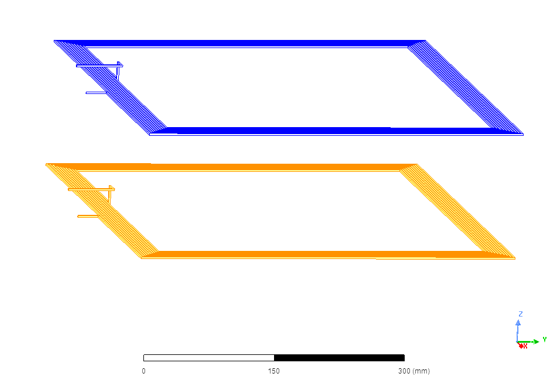
[picture p58: figure]

With this design, we have calculated the values of self-inductance,

mutual inductance, and the coupling coefficient both numerically and

graphically.

What sets ANSYS Maxwell 3D Electronics Desktop apart from

other simulation programs is the ability to design the transmitter and

receiver coils in ANSYS Maxwell 3D. This allows us to calculate values

such as mutual inductance, self-inductance, coupling coefficient, and

magnetic flux.

Then, this design can be used in the electric circuit in ANSYS

Simplorer and two model are simulate Jointly to ensure accurate results in

various electrical calculations necessary for wireless charging of electric

vehicles Similar to reality results.

Figure 3-5 illustrates the electrical circuit for ANSYS Simplorer, and

the components used in its design to create a WPT system.

Figure 3-4: The ANSYS Maxwell 3D model for the WPT system

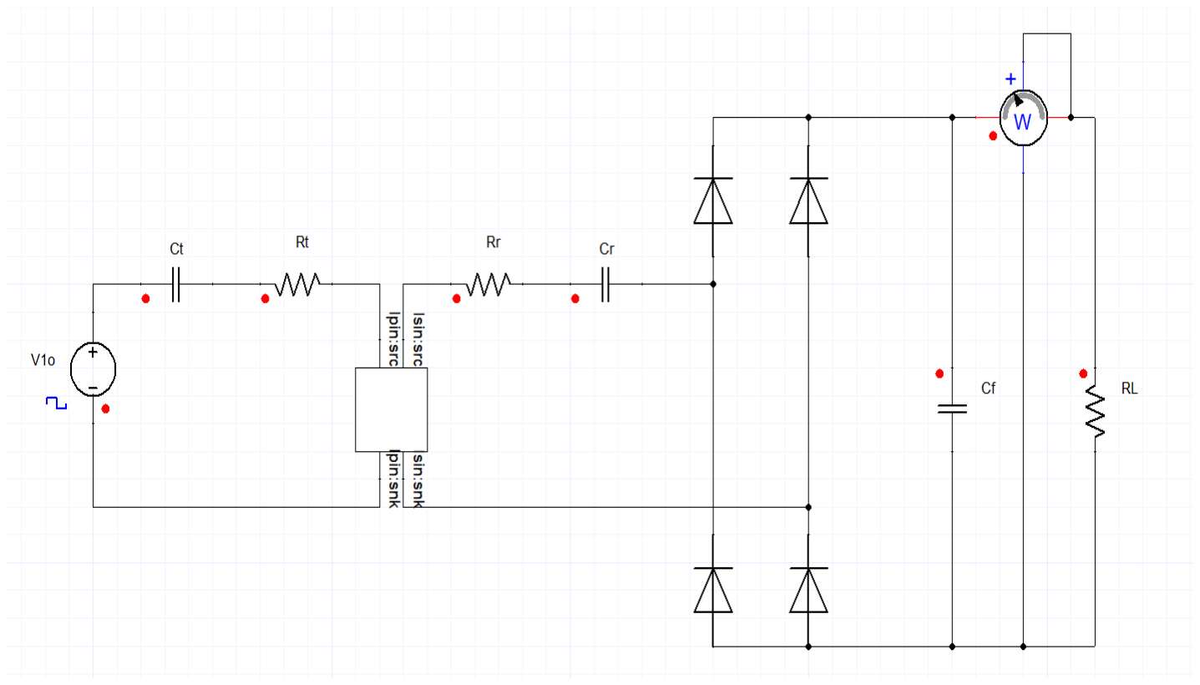
[picture p59: figure]

The issue of misalignment is considered one of the biggest problems

facing wireless charging for electric cars, if not the biggest. For this reason,

in this research paper, we conducted a detailed study on all the different

misalignment scenarios that could occur in reality to understand their

impact on transmission efficiency. This way, we can take them into account

and try to find solutions or reduce their effects.

First, we studied different air gap scenarios between the transmitter

and the receiver, where the vertical distance between the transmitter and

receiver increases by raising the receiver upwards, as shown in Figure 3-6.

Figure 3-5: ANSYS Simplorer RIWPT system

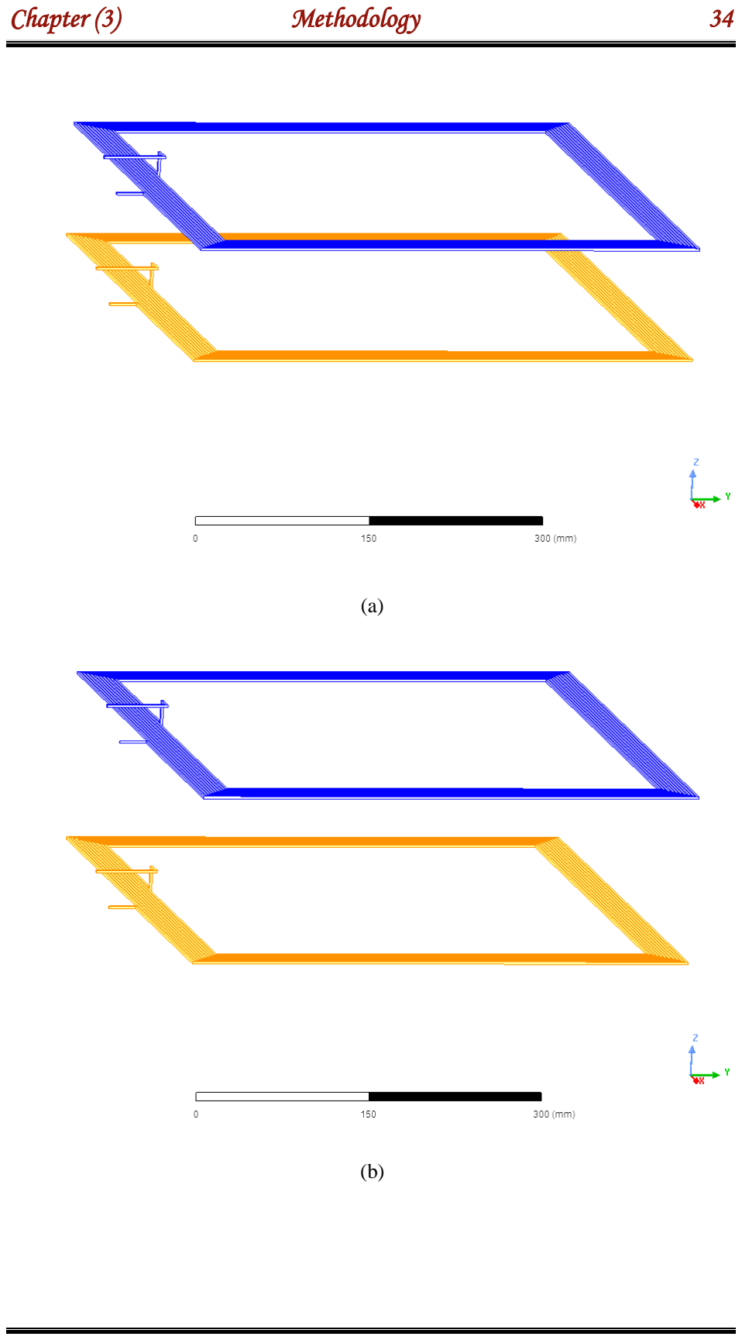
[picture p60: page 53]

(a)

(b)

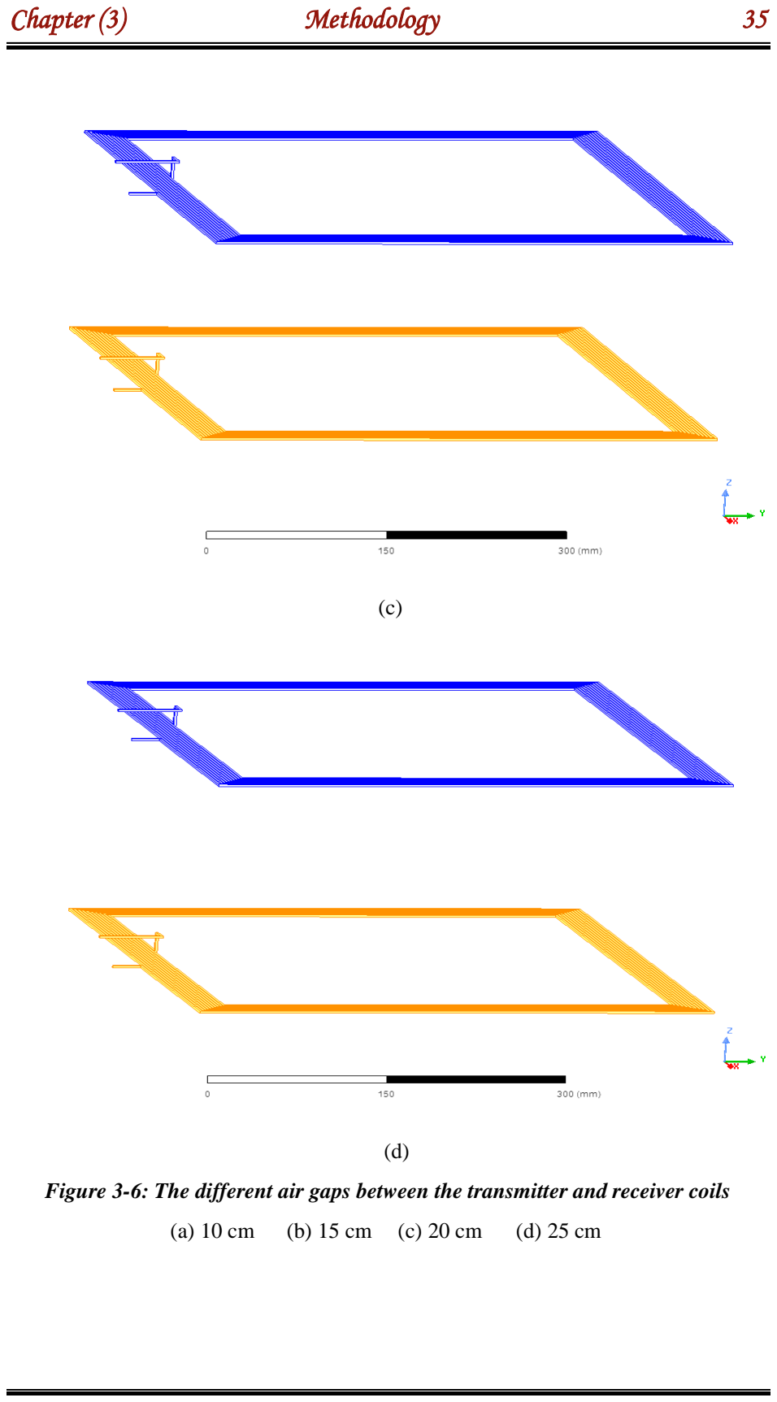
[picture p61: page 54]

Figure 3-6: The different air gaps between the transmitter and receiver coils

(a) 10 cm | (b) 15 cm | (c) 20 cm | (d) 25 cm

(c)

(d)

Secondly, we studied different horizontal misalignment scenarios,

as shown in table 3-3.

Table 3-3: Misalignment data in different positions for each scenario

Here, the receiver coil moves parallel to the transmitter coil in

different positions for each scenario, as shown in Figure 3-7.

Misalignment data in different positions for each scenario

No. | Case | a | b | c
1 | (-x, -y) (cm) | (-10, -12) | (-15, -15) | ____
2 | -x (cm) | -10 | -15 | -30
3 | -y (cm) | -12 | -15 | -30
4 | (-x, +y) (cm) | (-10, +12) | (-15, +15) | ____

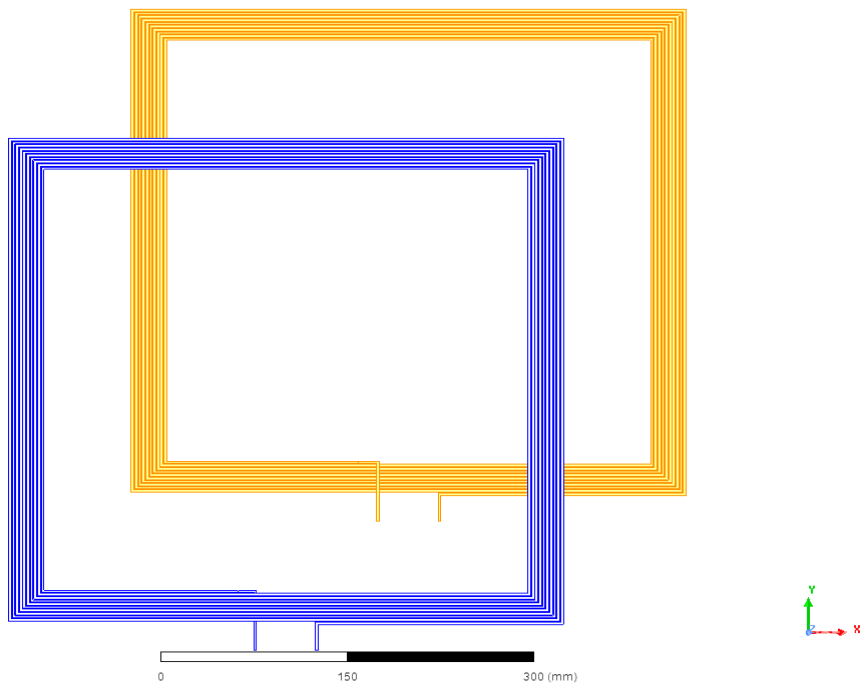
[picture p62: figure]

(a)

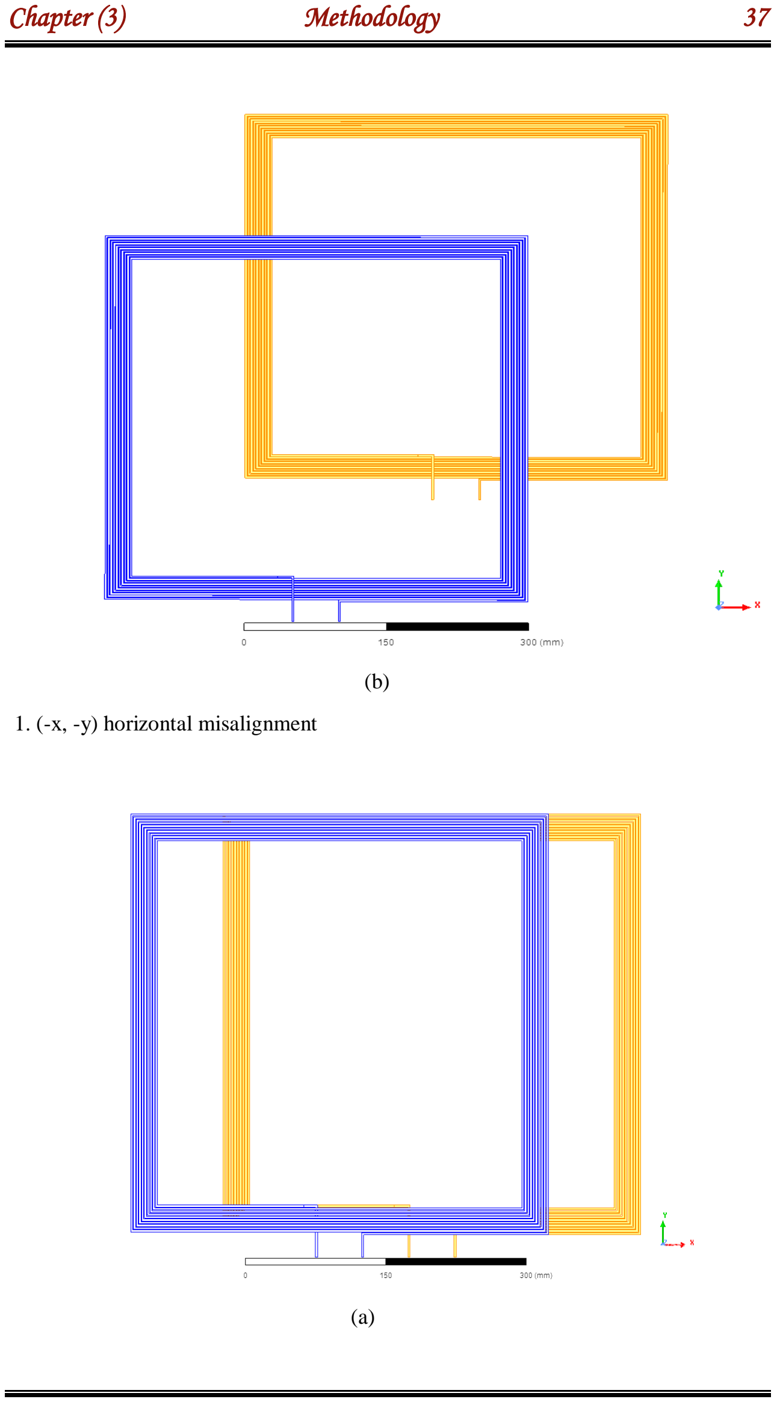
[picture p63: page 56]

1. (-x, -y) horizontal misalignment

(b)

(a)

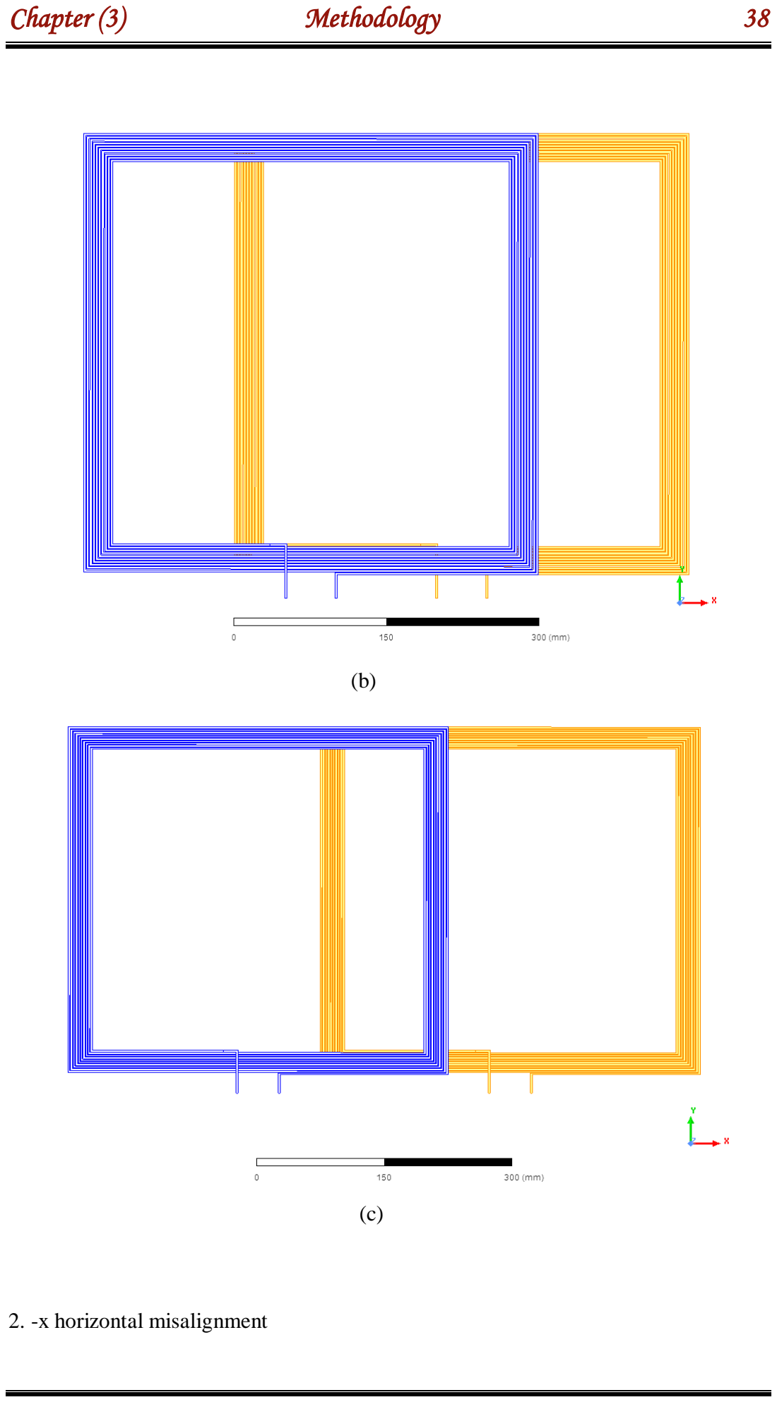
[picture p64: page 57]

2. -x horizontal misalignment

(b)

(c)

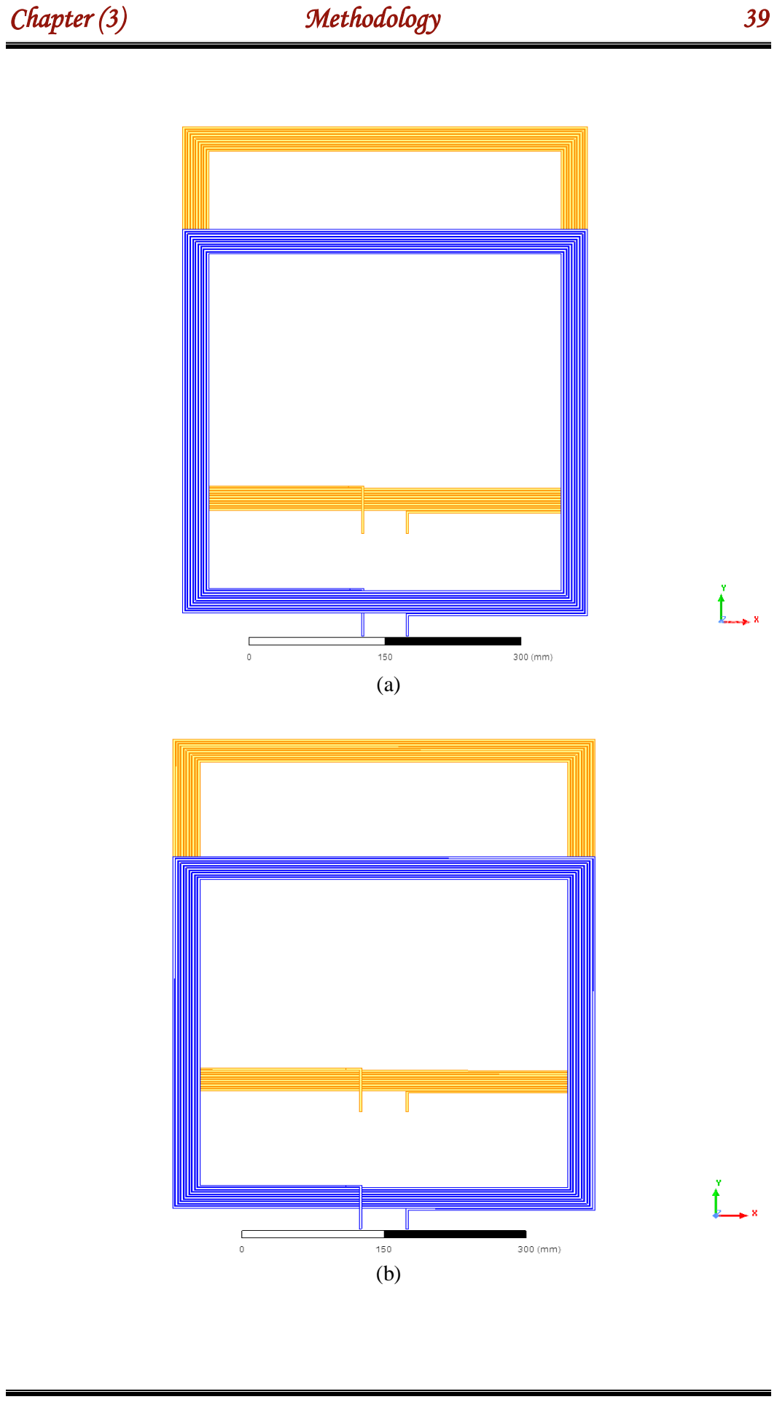
[picture p65: page 58]

(a)

(b)

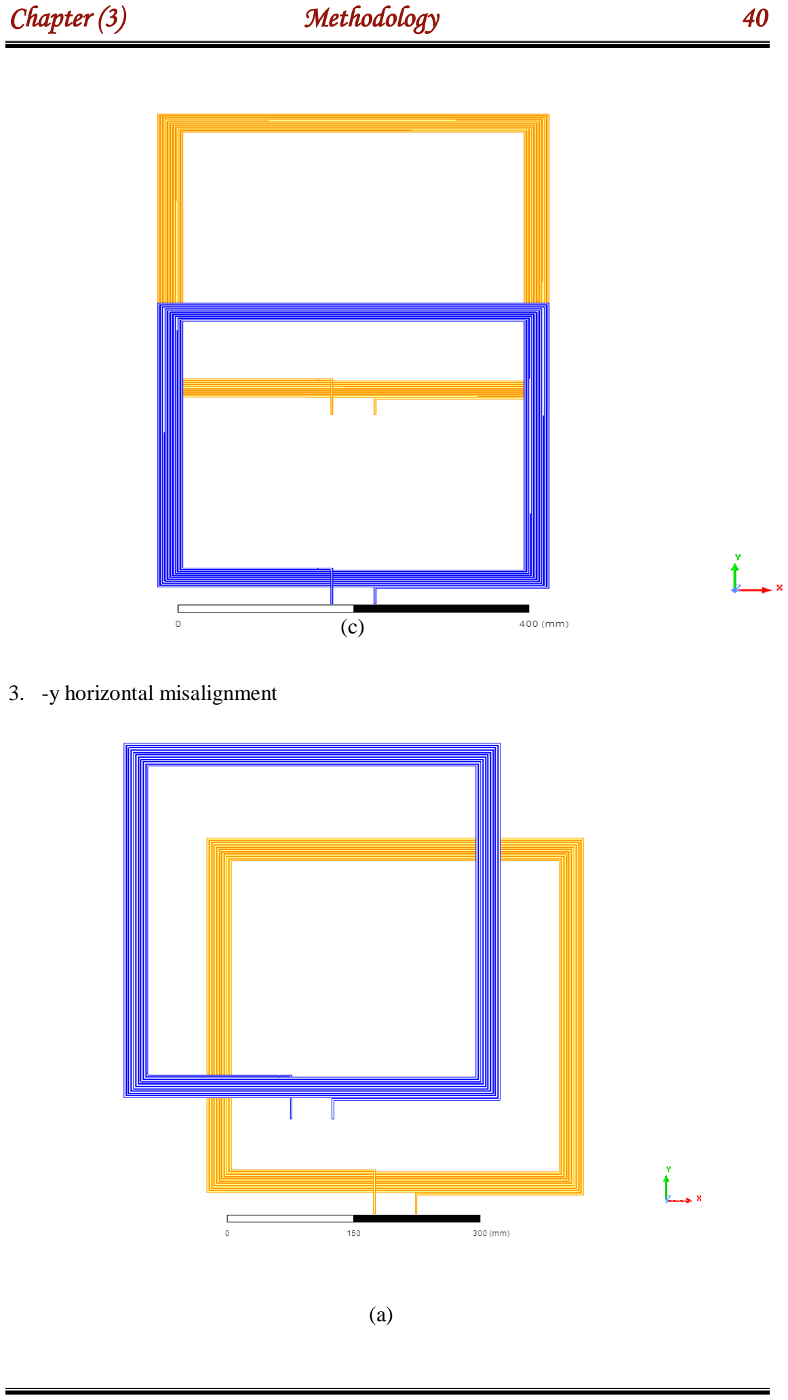
[picture p66: page 59]

3. -y horizontal misalignment

(c)

(a)

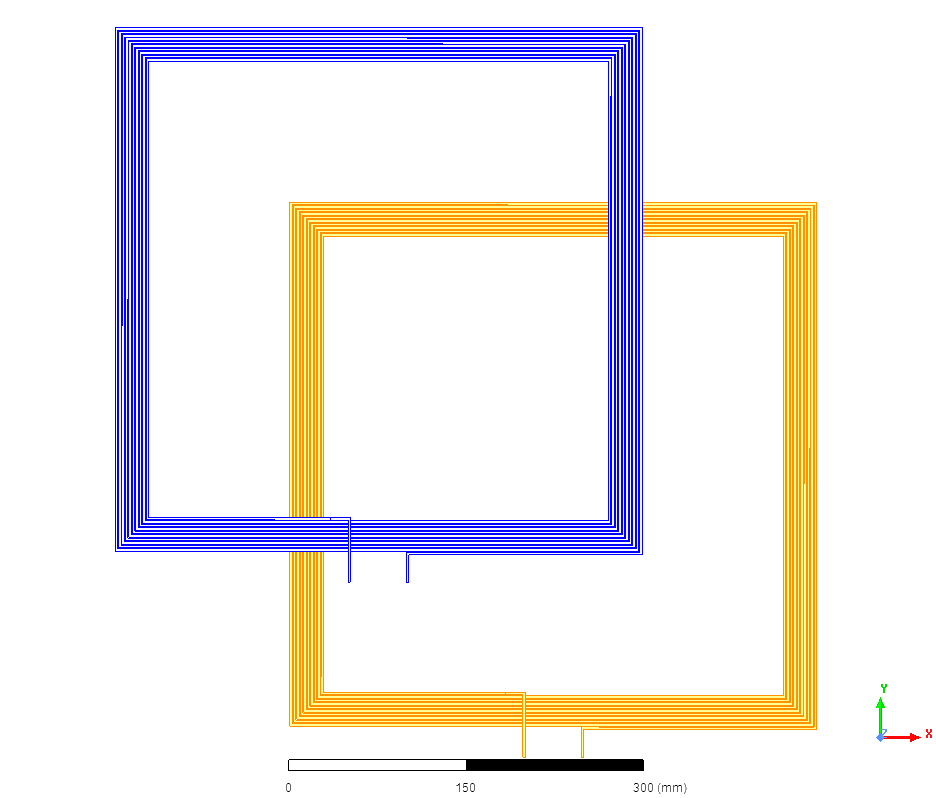
[picture p67: figure]

4. (-x, +y) horizontal misalignment

Figure 3-7: The different positions of horizontal misalignment for each scenario

1. (-x, -y) | 2. -x | 3. -y 4. (-x, +y)

Thirdly, we studied one of the most critical misalignment cases that

may frequently occur during wireless charging: the rotation around the Z-

axis. In this situation, the receiver coil is parallel to the transmitter coil, but

an angle exists between them concerning the Z-axis. The study was

conducted for various angles to comprehensively understand this type of

misalignment, as illustrated in Figure 3-8.

(b)

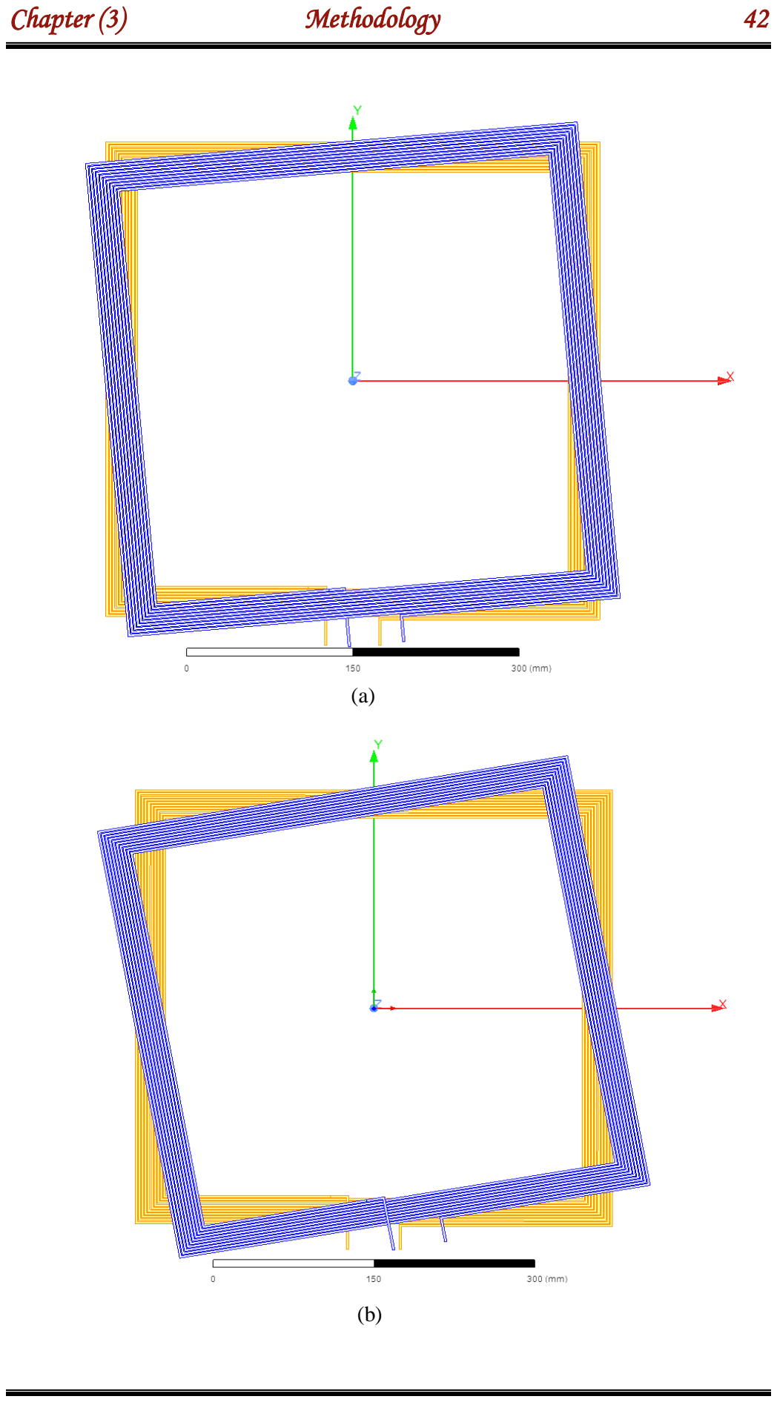
[picture p68: page 61]

(b)

(a)

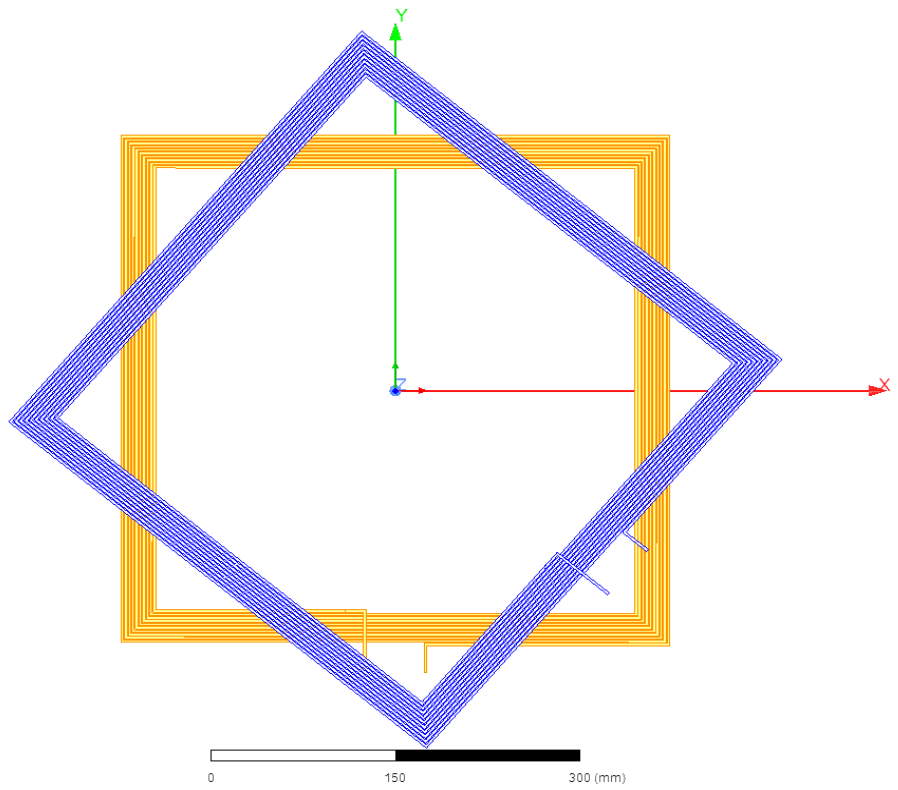
[picture p69: figure]

Figure 3-8: Angles exist between the transmitting and receiving coil concerning the Z-axis

(a) 5° | (b) 10 ° | (c) 50°

In all the previous cases, the transmitting coil was parallel to the

receiver coil. Due to the possibility of one side of the receiver coil moving

downward, we conducted a fourth study on the non-uniform airgap. This

study was performed by rotating the receiver around the Y-axis. To

understand the impact of this type of error, we analyzed it at different

angles as shown in Figure 3-9.

(c)

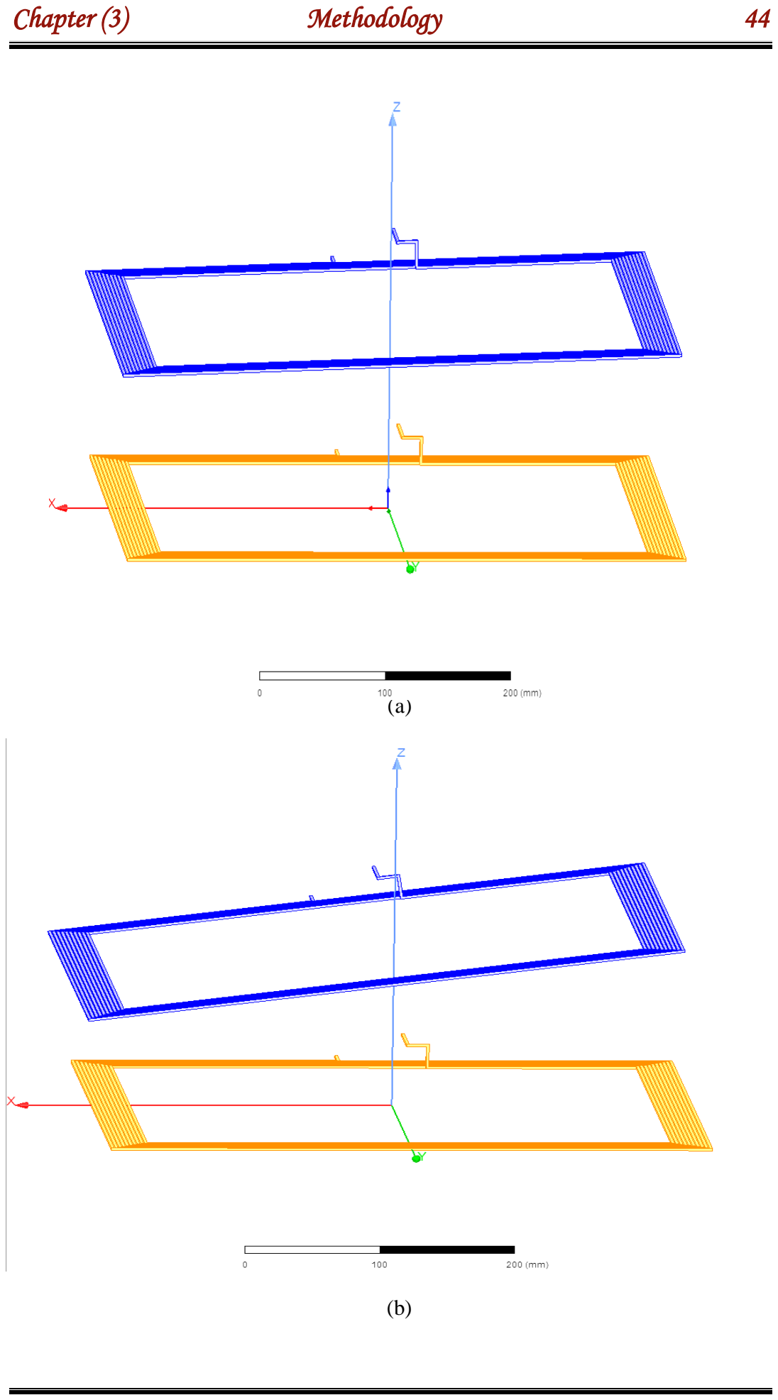
[picture p70: page 63]

(a)

(b)

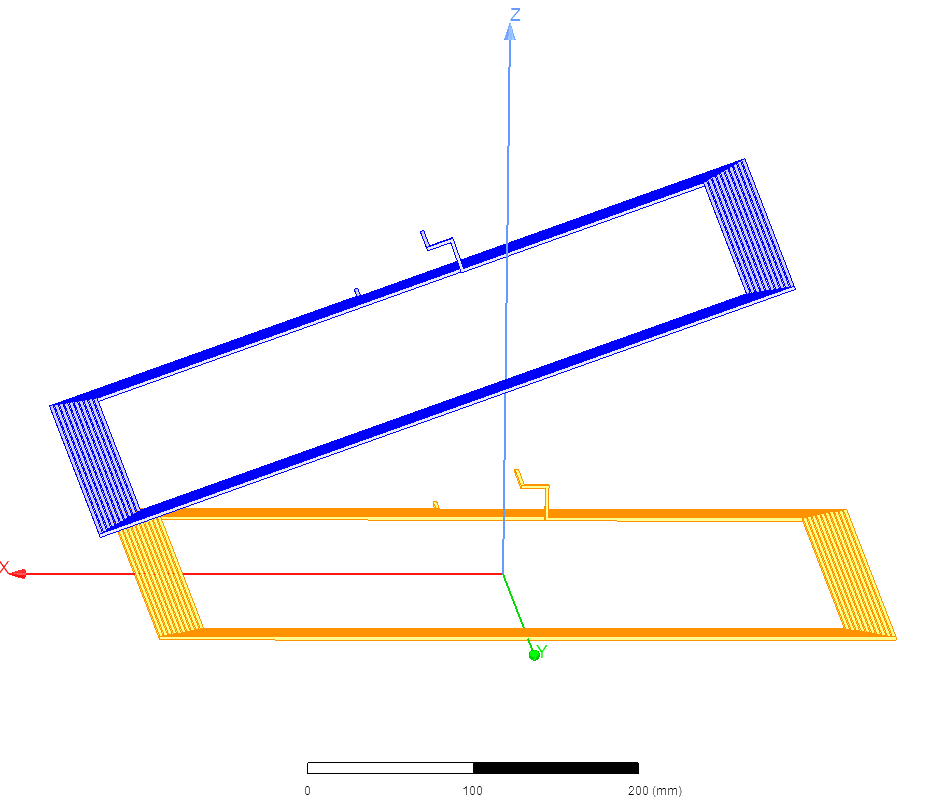
[picture p71: figure]

Figure 3-9: A non-uniform air gap in the Z-axis direction with rotation around the Y- axis

(a) 5° | (b) 8° | (c) 20°

Due to the likelihood of multiple misalignment errors occurring

during the wireless charging of electric vehicles, we conducted an

extensive study focusing on this crucial aspect.

The first multiple misalignment error is horizontal misalignment

with rotation around the Z-axis, as shown in table 3-4.

(c)

Table 3-4: Multiple misalignment error data in case of horizontal misalignment with rotation around the Z-axis

Figure 3-10 shows multiple misalignment error positions since the

receiver coil moves parallel to the transmitter coil in different positions

with an angle existing between them concerning the Z-axis.

Case No. | -y (cm) | D°
1 | -5 | 10
2 | -5 | 50
3 | -15 | 10
4 | -15 | 50
5 | -30 | 10
6 | -30 | 50

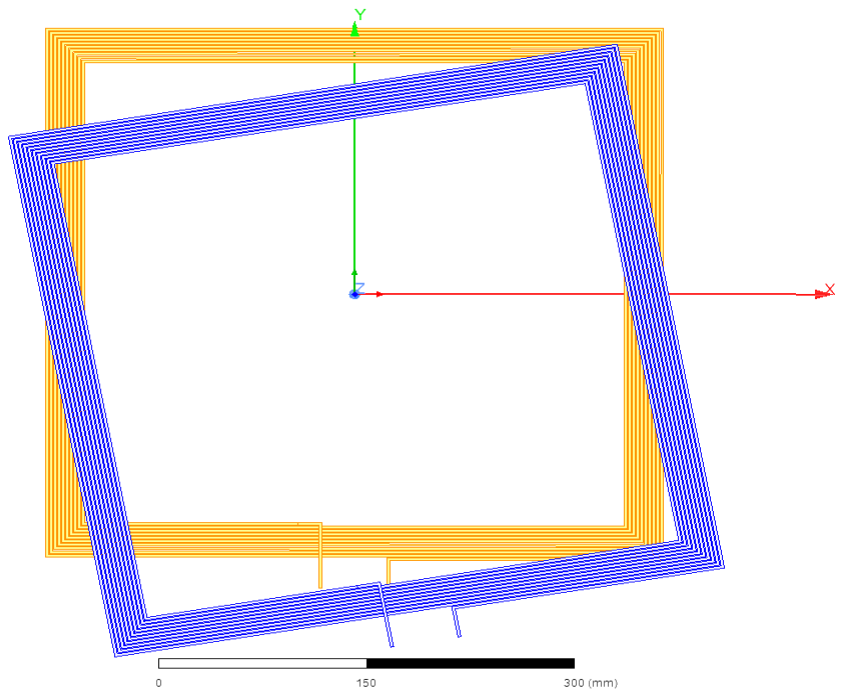
[picture p72: figure]

Case 1

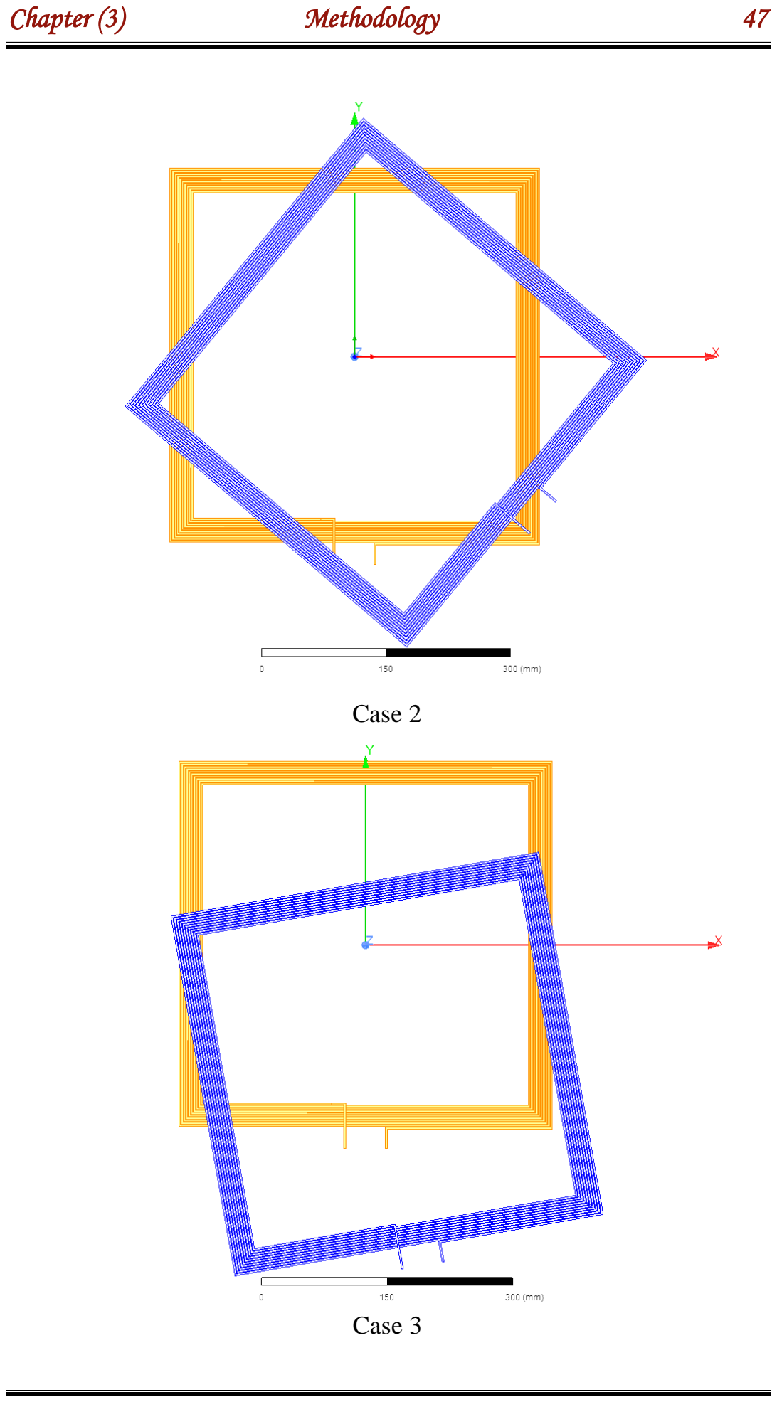
[picture p73: page 66]

Case 2

Case 3

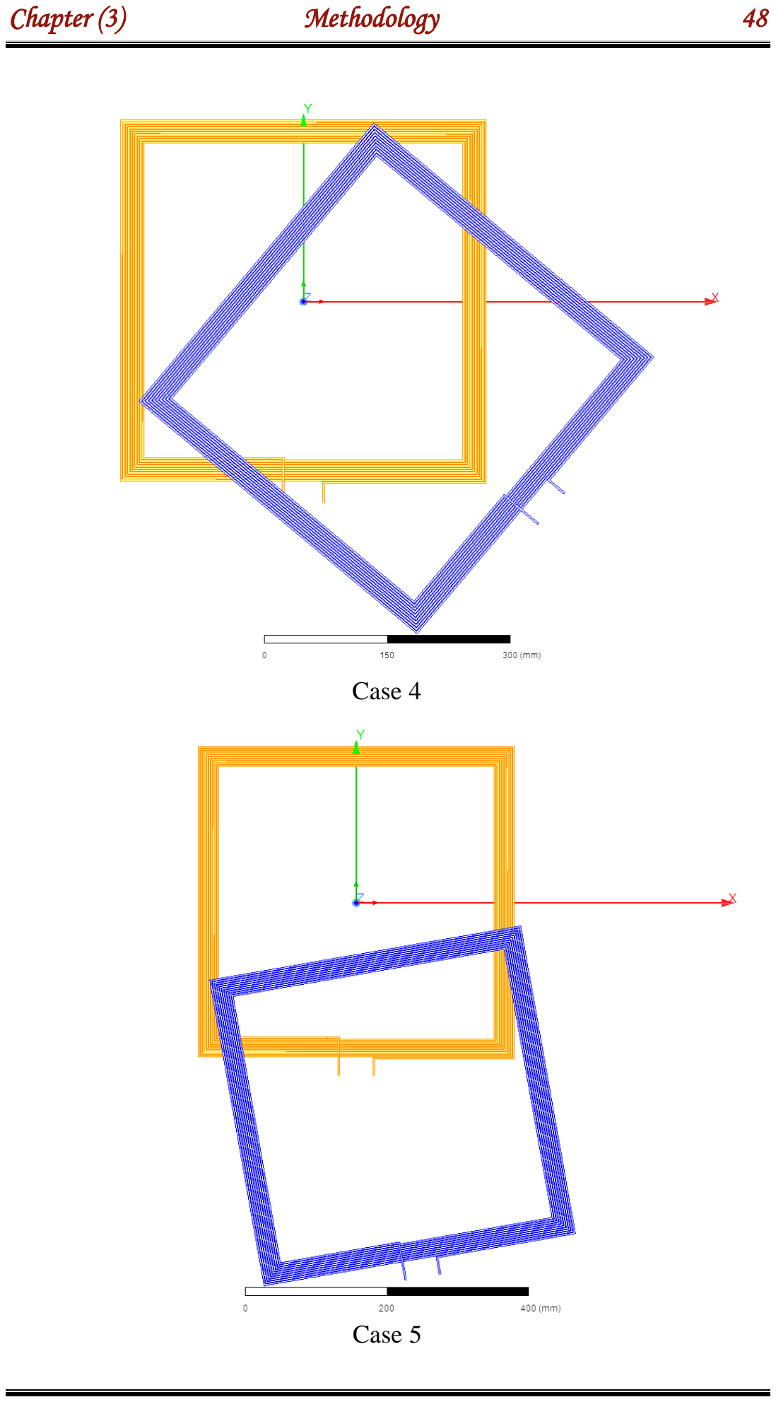
[picture p74: page 67]

Case 4

Case 5

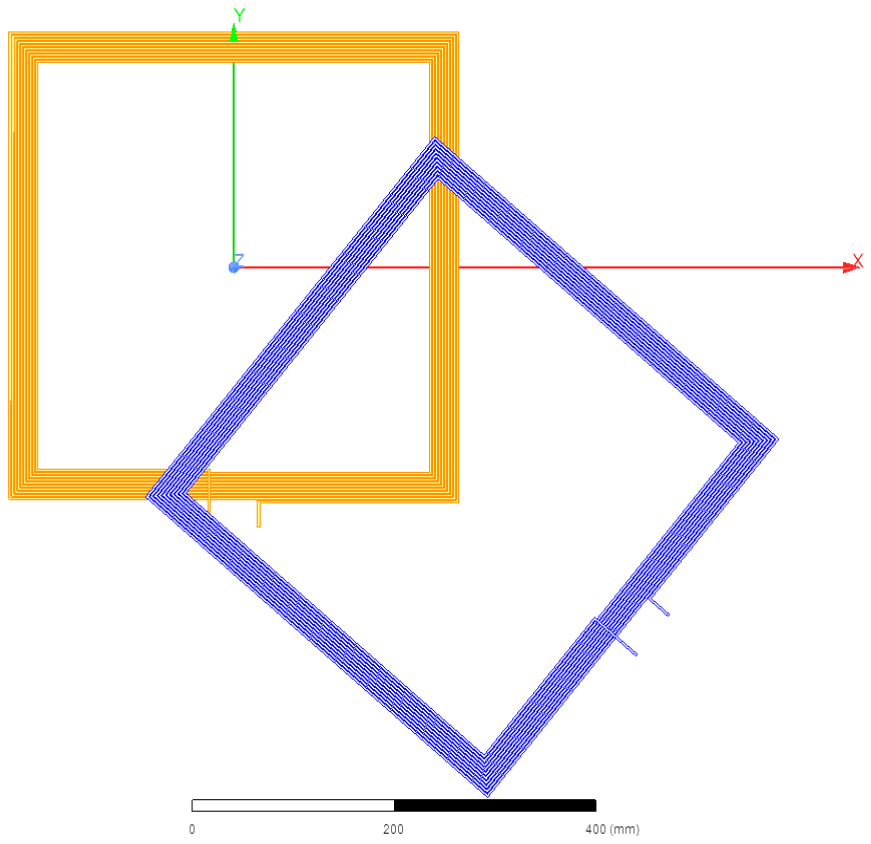
[picture p75: figure]

Figure 3-10: Multiple misalignment error positions in case of horizontal misalignment with rotation around the Z-axis

Case 1) -5 cm, 10° | Case 2) -5cm ,50° | Case 3) -15 cm ,10°
Case 4) -15 cm, 50° | Case 5) -30 cm, 10° Case 6) -30 cm, 50°

The second multiple misalignment error is horizontal misalignment

in (-x, -y) with rotation around the Z-axis as shown in table 3-5.

Case 6

Table 3-5: Multiple misalignment error data in case of horizontal misalignment in (-x, -y) with rotation around the Z-axis

Figure 3-11 shows multiple misalignment error positions since the

receiver coil moves parallel to the transmitter coil in different positions in

(-x, -y) with an angle existing between them concerning the Z-axis.

Case No. | (-x, -y) (cm) | D°
1 | (-5, -5) | 10
2 | (-5, -5) | 50
3 | (-15, -15) | 10
4 | (-15, -15) | 50

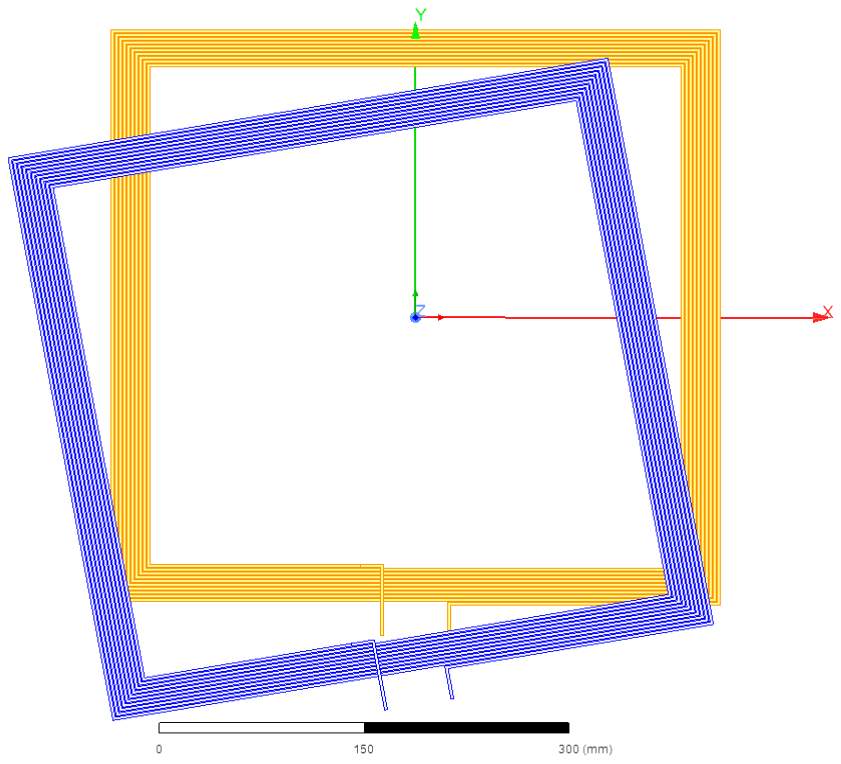
[picture p76: figure]

Case 1

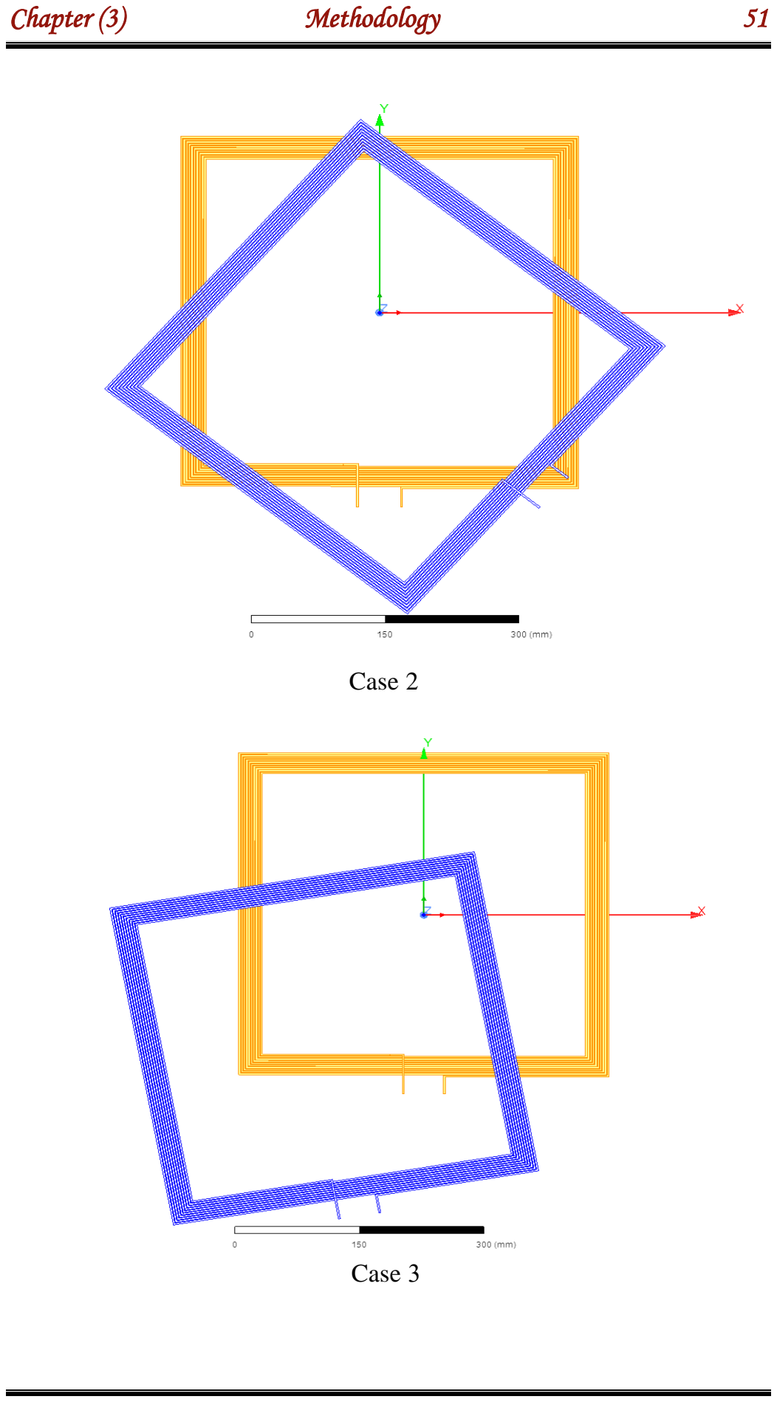
[picture p77: page 70]

Case 2

Case 3

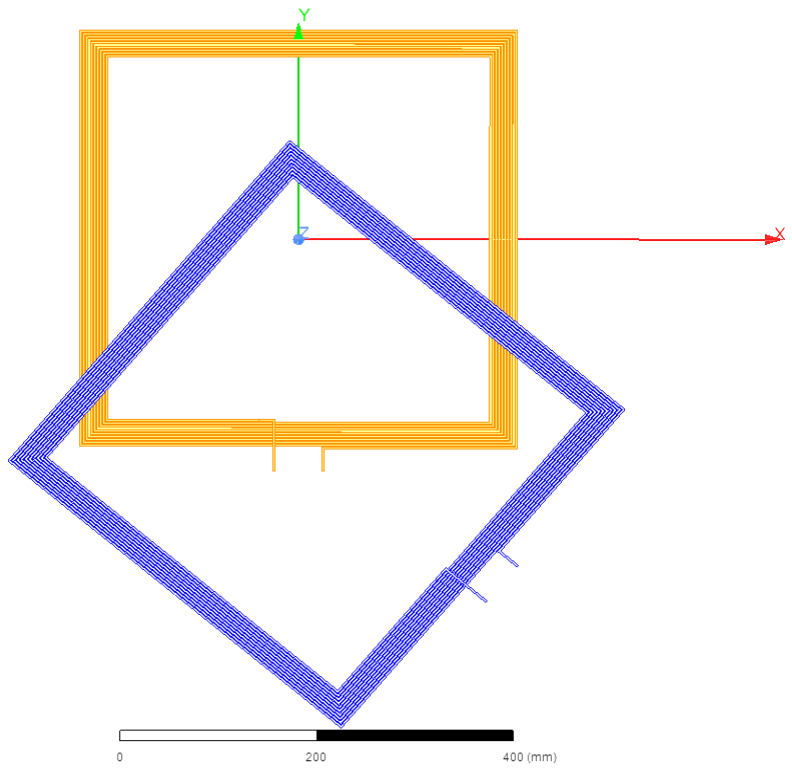
[picture p78: figure]

Figure 3-11: Multiple misalignment error positions in case of horizontal misalignment in (-x, -y) with rotation around the Z-axis

Case 1) (-5, -5) cm, 10° | Case 2) (-5, -5) cm ,50°
Case 3) (-15, -15) cm ,10° | Case 4) (-15, -15) cm, 50°

The third multiple misalignment error is horizontal misalignment in

(-x, -y) with a non-uniform air gap in the Z-axis direction with rotation

around the Y- axis as shown in table 3-6.

Case 4

Table 3-6: Multiple misalignment error data in case of horizontal misalignment in (-x, -y) with a non-uniform air gap in the Z-axis direction with rotation around the Y- axis

Figure 3-12 shows multiple misalignment error positions since one

side of the receiver coil moving downward with an angle that exists

between them concerning the Y-axis, also it moves in different positions in

(-x, -y).

Case No. | Non-uniform | Horizontal (cm)
1 | 5° | (-5, -5)
2 | 8° | (-5, -5)
3 | 5° | (-15, -15)
4 | 8° | (-15, -15)

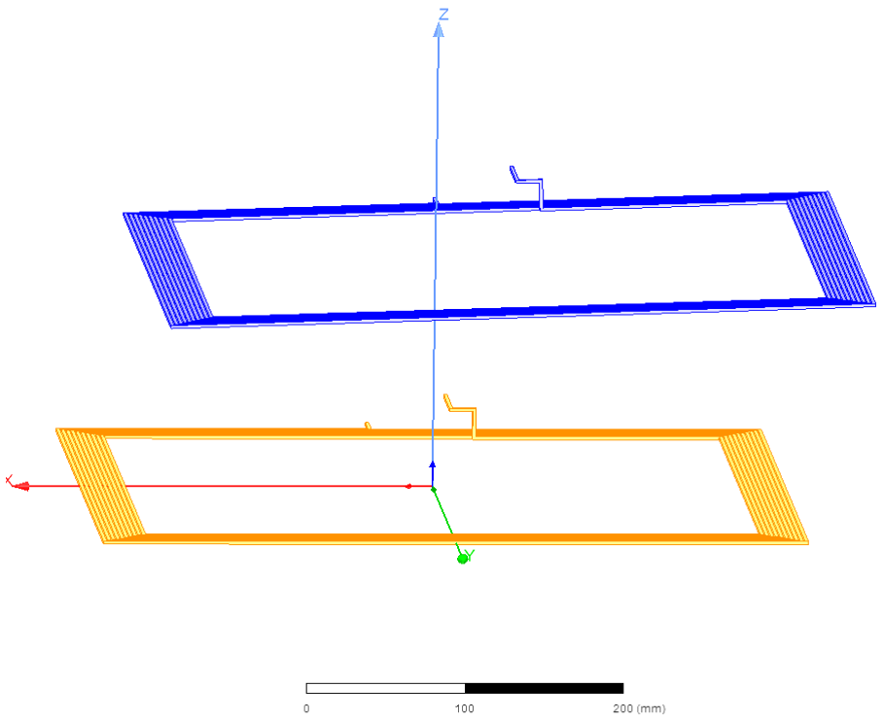
[picture p79: figure]

Case 1

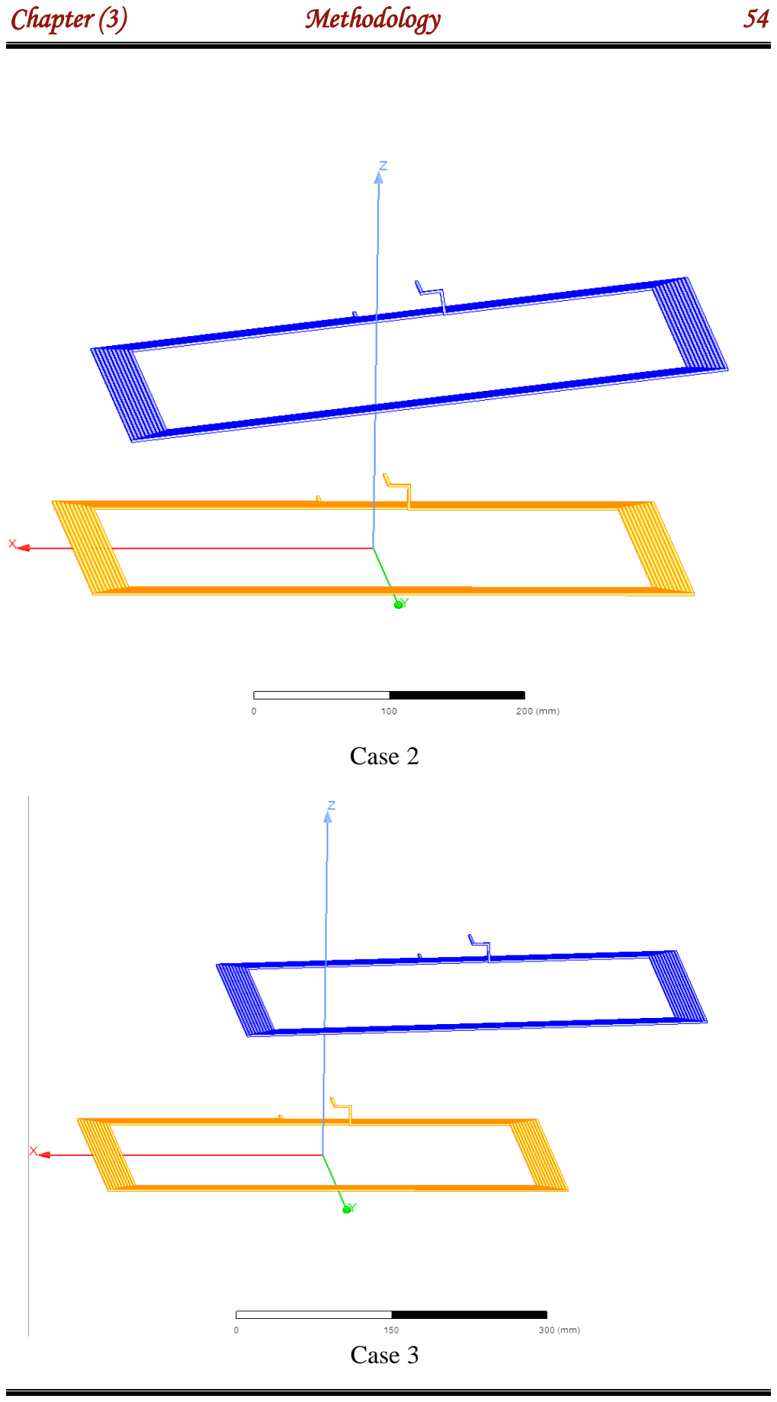
[picture p80: page 73]

Case 2

Case 3

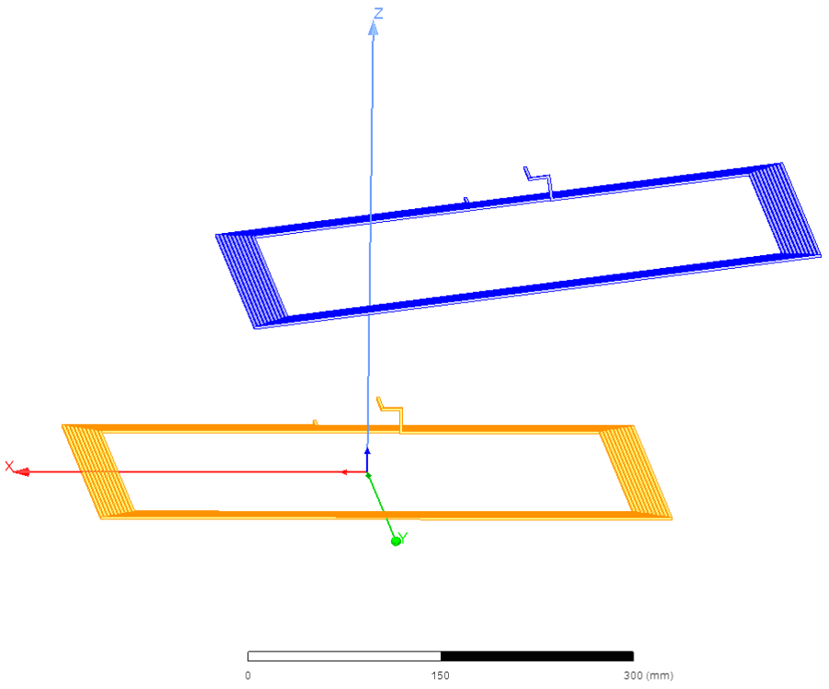
[picture p81: figure]

Figure 3-12: Multiple misalignment error positions in case of horizontal misalignment in (-x, -y) with a non-uniform air gap in the Z-axis direction with rotation around the Y- axis

Case 1) (-5, -5) cm, 5° | Case 2) (-5, -5) cm ,8°
Case 3) (-15, -15) cm, 5° | Case 4) (-15, -15) cm, 8°

Case 4

In this final section, we will examine the most extreme cases of

multiple misalignments that may occur during the charging of an electric

vehicle, particularly when three types of misalignments happen

simultaneously.

The final case of multiple misalignment errors is a horizontal

misalignment in (-x, -y) direction, combined with a non-uniform air gap in

the Z-axis direction with rotation around the Y-axis and Z-axis that

identified in table 3-7.

Table 3-7: Multiple misalignment errors is a horizontal misalignment in (-x, -y) direction, combined with a non-uniform air gap in the Z-axis direction with rotation around the Y-axis and Z-axis

Fig 3-13 shows multiple misalignment error positions since the

receiver coil moves horizontally with a non-uniform air gap to the

transmitter coil in different positions with an angle existing between them

concerning the Y-axis and Z-axis.

Case No. | Non-uniform air gap (D°) | Horizontal (cm) | Around Z-axis (D°)
1 | 8 | (-15, -15) | 10
2 | 8 | (-15, -15) | 50
3 | 8 | (-10, -12) | 10
4 | 8 | (-10, -12) | 50
5 | 5 | (-10, -12) | 10
6 | 5 | (-15, -15) | 10

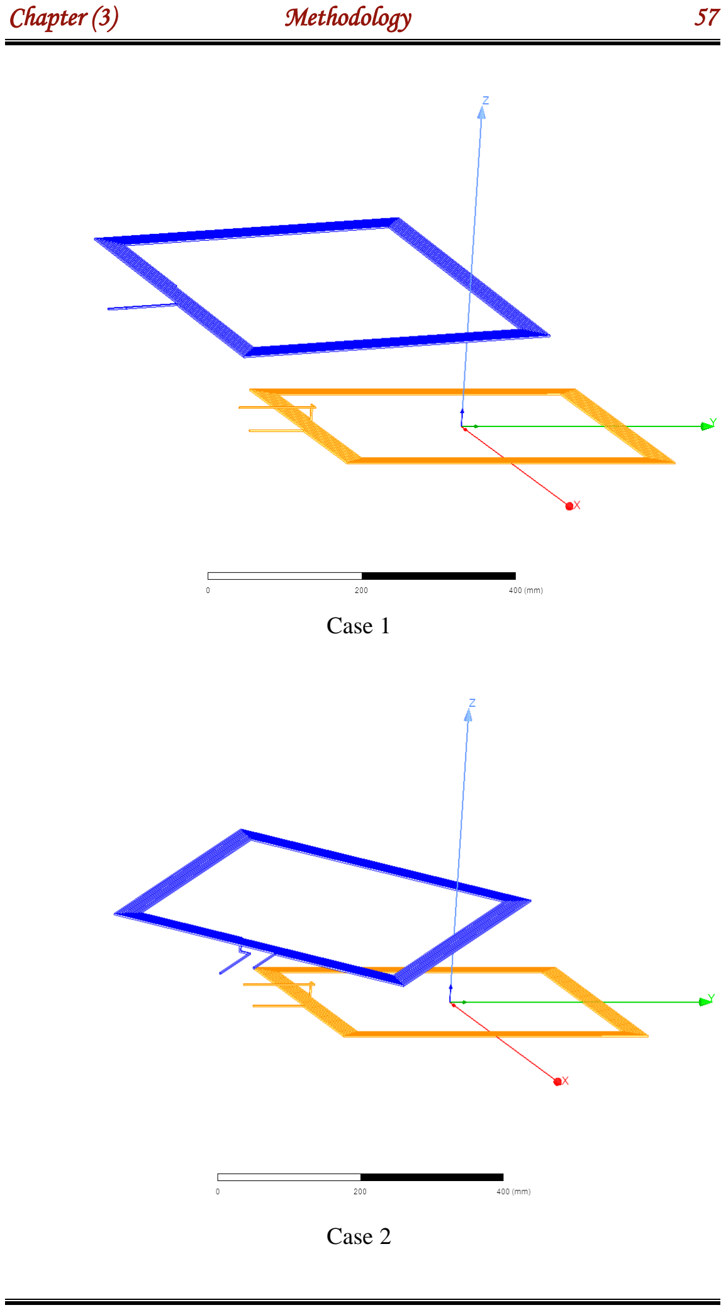
[picture p82: page 76]

Case 1

Case 2

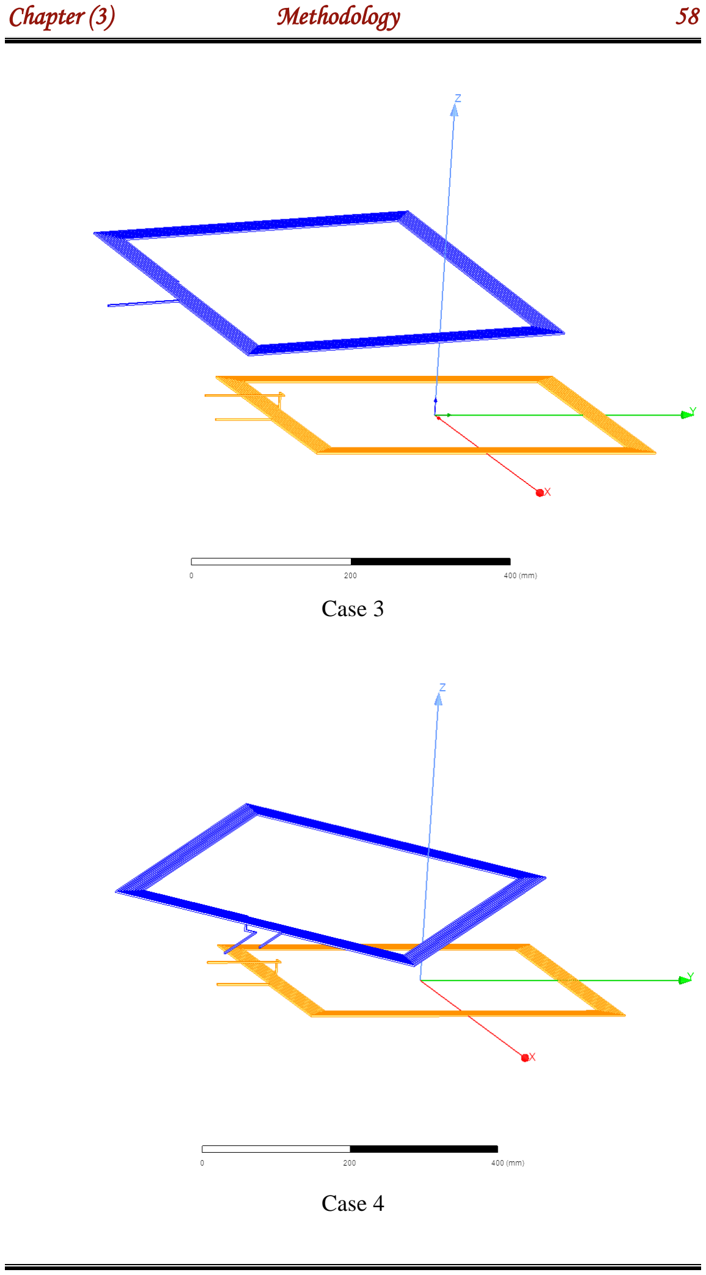
[picture p83: page 77]

Case 3

Case 4

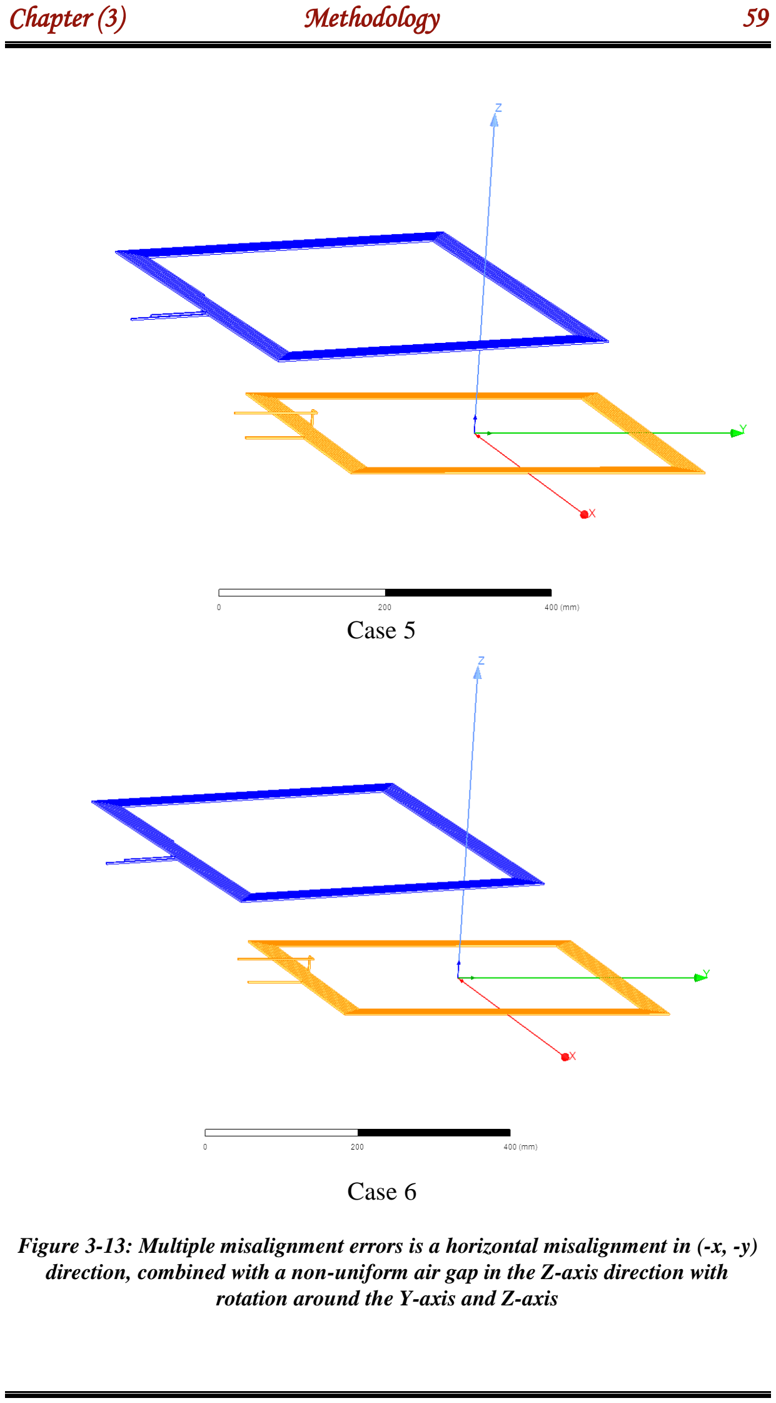
[picture p84: page 78]

Figure 3-13: Multiple misalignment errors is a horizontal misalignment in (-x, -y) direction, combined with a non-uniform air gap in the Z-axis direction with rotation around the Y-axis and Z-axis

Case 5

Case 6

Finally, given that the misalignment issue is the most significant

problem, as mentioned earlier, we will conduct an extensive study of the

different shapes of the coils. We will compare them in terms of horizontal

misalignment scenarios as shown in table 3-8 to identify the most suitable

design for the WPT system.

Table 3-8: The models used in design for WPT system

1.Aligned at 15 cm vertical air gap

| a | b | c | d
Transmitter | Circle | Square | Circle | Square
Receiver | Circle | Square | Square | Circle

2.Horizontal misalignment of 15 cm in X-axis

| a | b | c | d
Transmitter | Circle | Square | Circle | Square
Receiver | Circle | Square | Square | Circle

3.Horizontal misalignment of 25 cm in X-axis

| a | b | c | d
Transmitter | Circle | Square | Circle | Square
Receiver | Circle | Square | Square | Circle

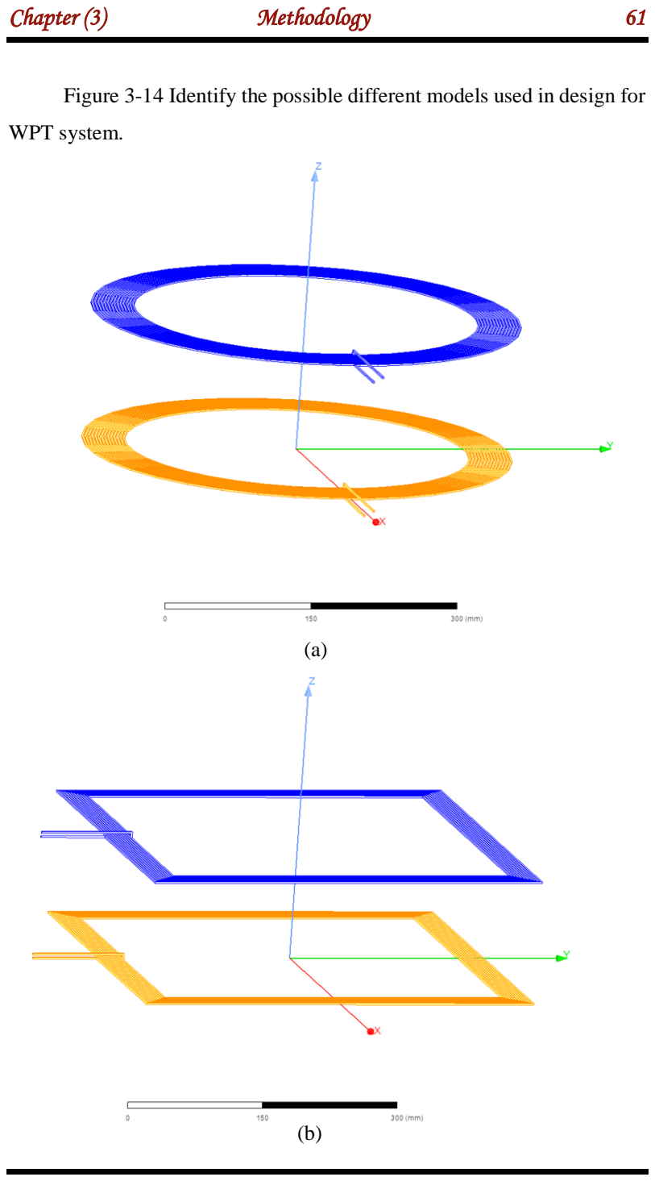
[picture p85: page 80]

Figure 3-14 Identify the possible different models used in design for

WPT system.

(a)

(b)

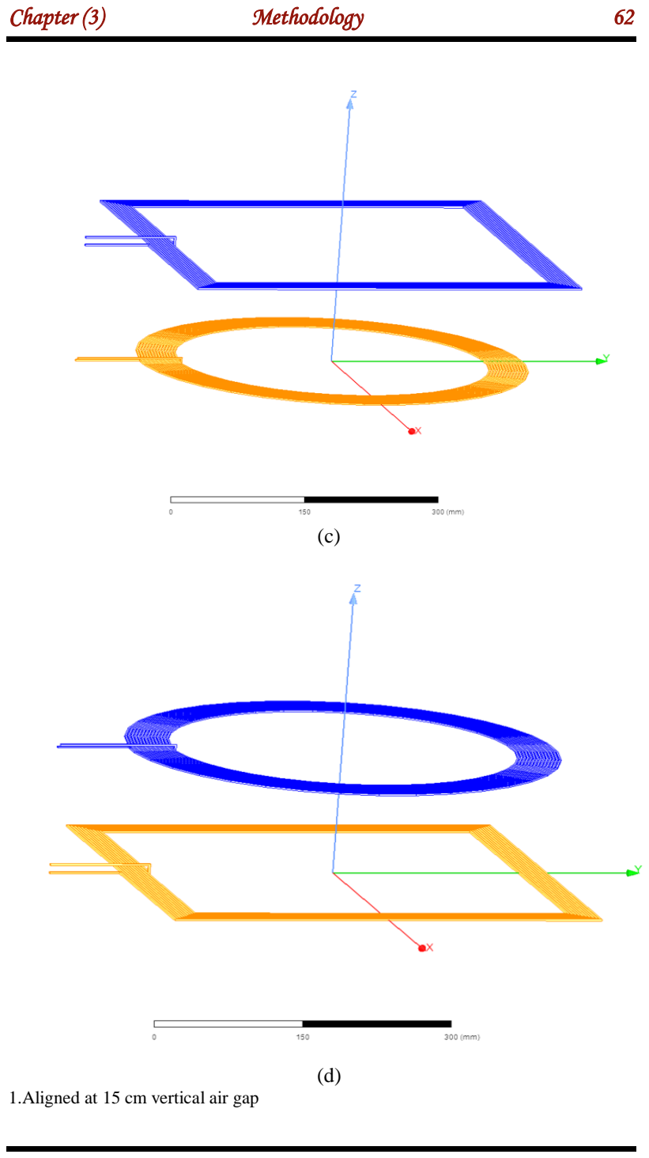
[picture p86: page 81]

1.Aligned at 15 cm vertical air gap

(c)

(d)

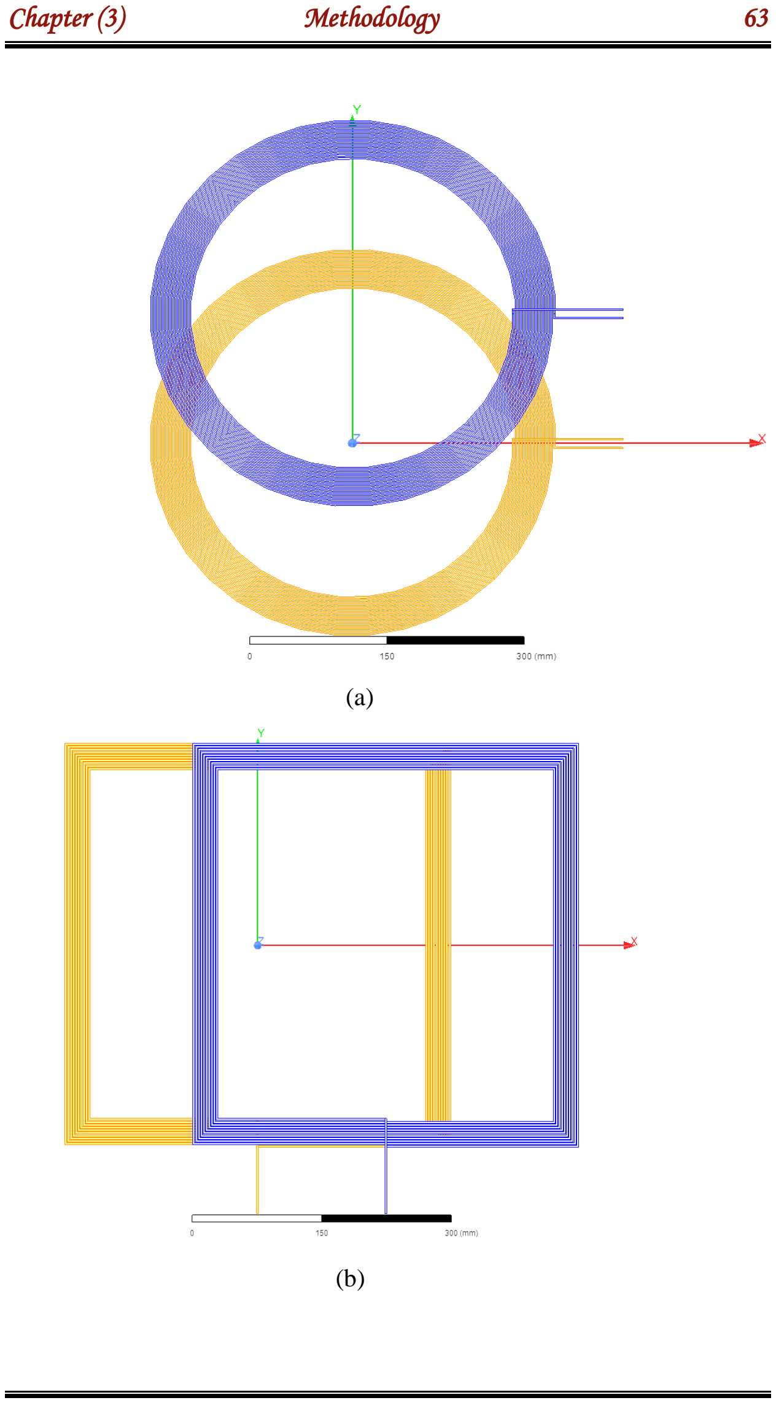
[picture p87: page 82]

(b)

(a)

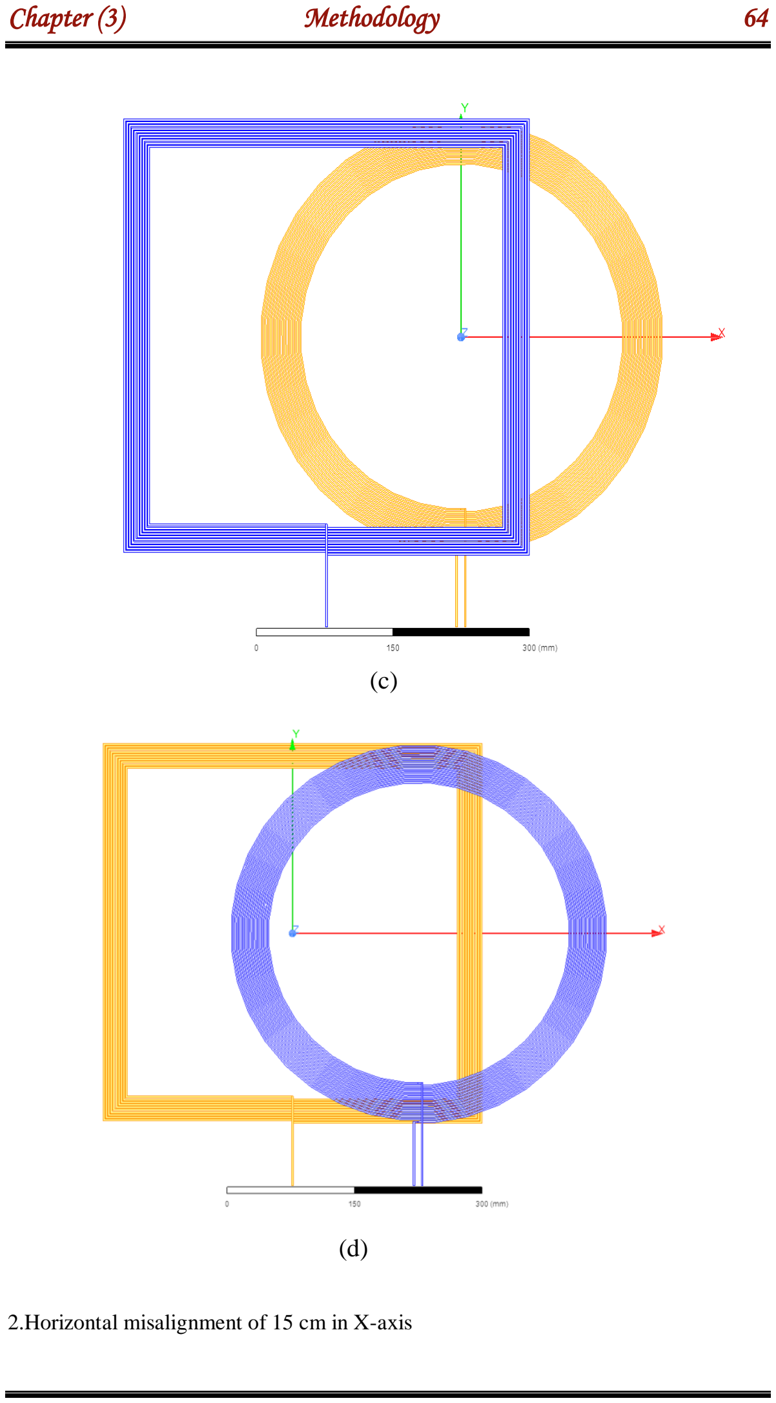
[picture p88: page 83]

2.Horizontal misalignment of 15 cm in X-axis

(c)

(d)

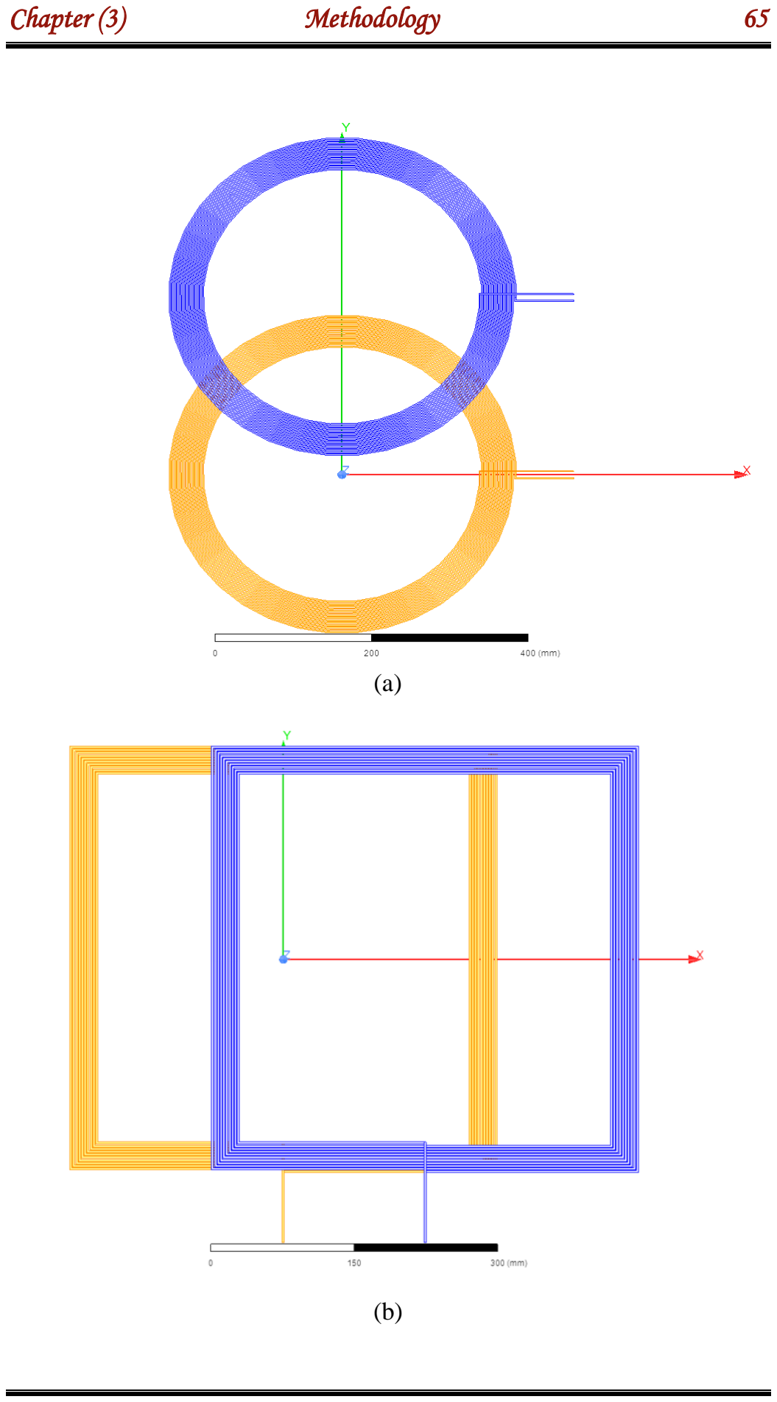
[picture p89: page 84]

(a)

(b)

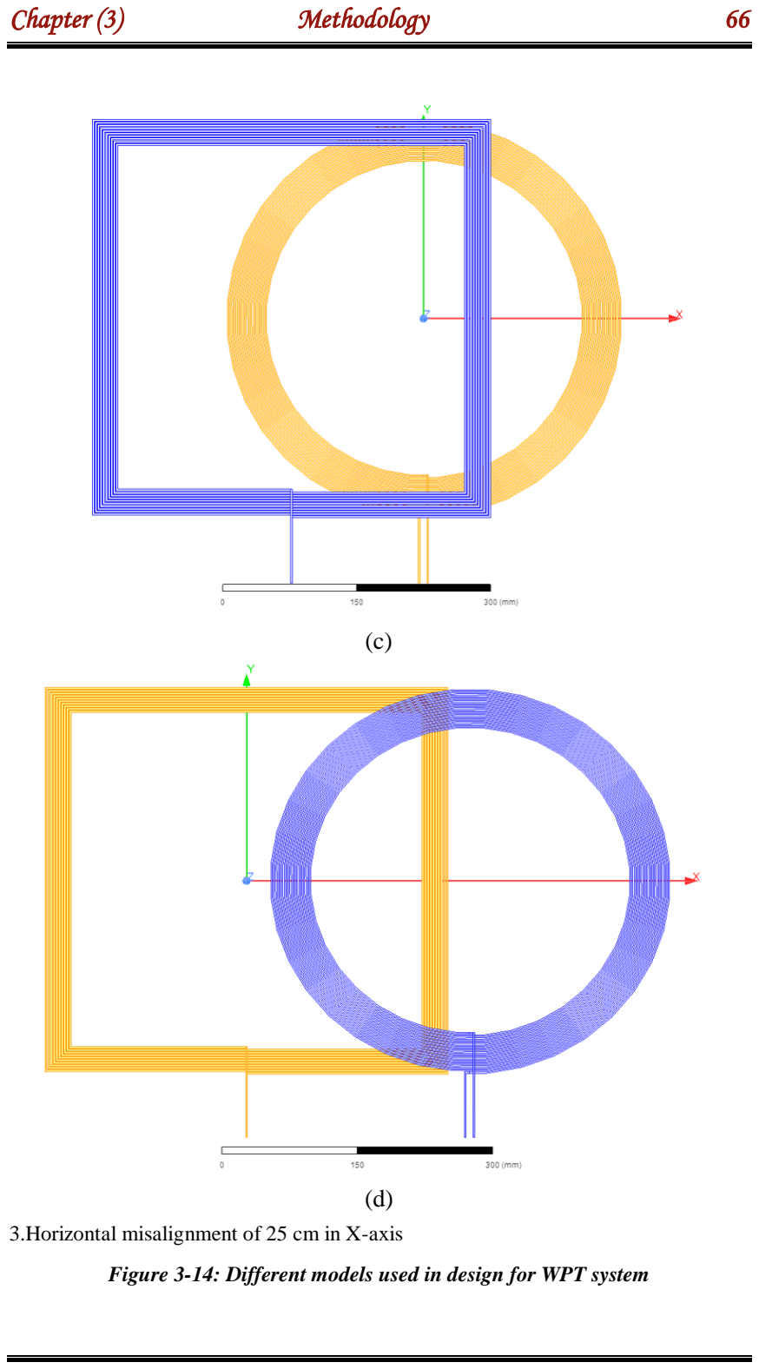
[picture p90: page 85]

3.Horizontal misalignment of 25 cm in X-axis

Figure 3-14: Different models used in design for WPT system

(b)

(c)

(d)

### 3.2.2 Simulation with MATLAB

The values of self-inductances for both the transmitting and

receiving coils (Lt and Lr
), mutual inductance (M) and coupling coefficient
(K) were obtained using ANSYS Maxwell 3D.

Depending on the number of turns and coil dimensions, equations

were used in MATLAB code to obtain the values of both resistances and

self-inductances of both the transmitting and receiving coils, and

depending on the number of turns, coil dimensions and the air gap between

the coils the mutual inductance was calculated, and using the values of both

the self-inductances and mutual inductance, the value of coupling

coefficient was calculated.

After confirming the design values and comparing them

with ANSYS Maxwell 3D, MATLAB code was used also to calculate the

compensation values, output power and the efficiency of the system and

calculate the values of the mutual inductance, coupling coefficient and the

output power also when there is a misalignment between the transmitting

and receiving coils.

MATLAB®/Simulink is used to simulate the wireless power

transfer system and to verify the output power and the efficiency of the

system, the simulation model is shown in Figure 3-15.

First the AC voltage is converted to dc voltage by using a rectifier.

After that the dc voltage is converted to high frequency (HF) ac voltage

using an inverter and the block called mutual inductance then is used in

MATLAB as an alternative to the two coils.

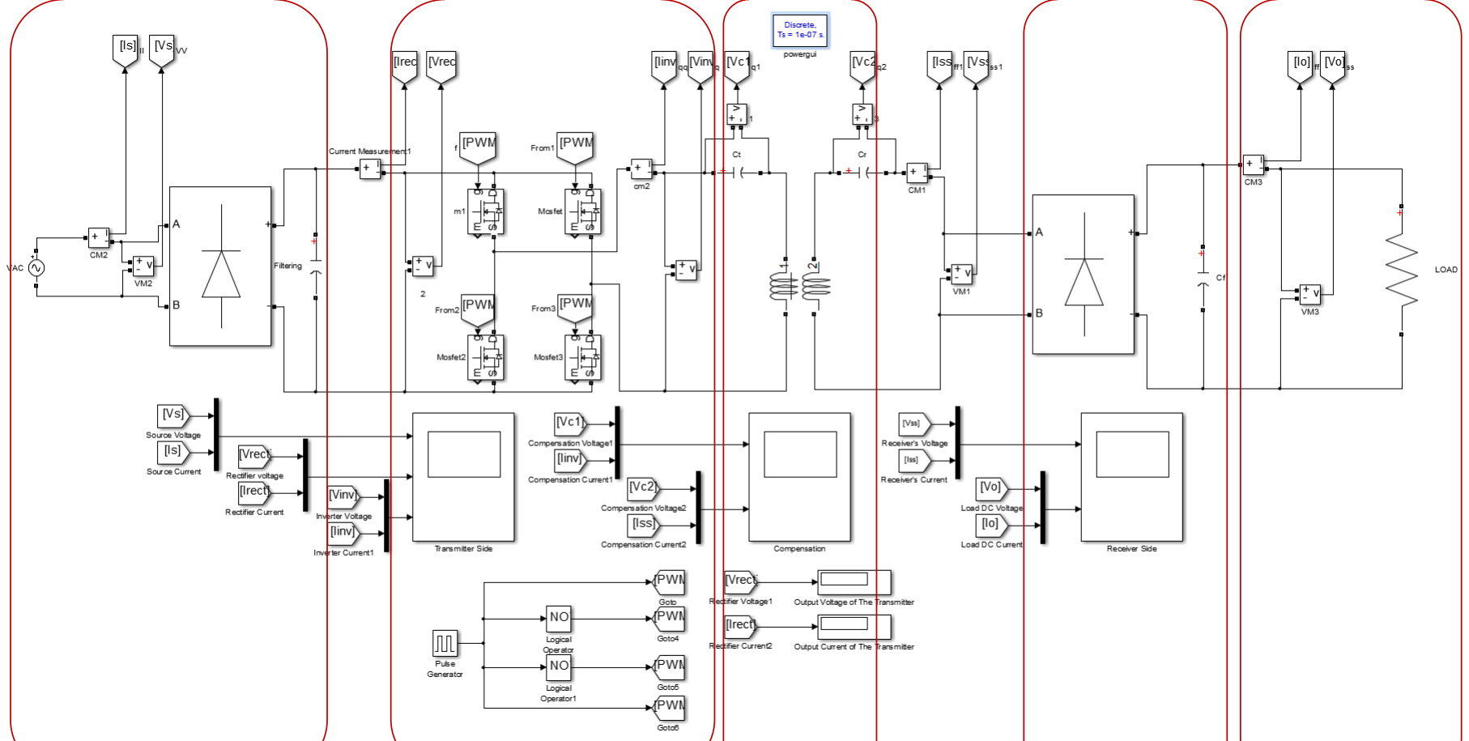
[picture p91: figure]

Figure 3-15: MATLAB Simulink RIWPT system

The specifications of the components used in MATLAB are shown

in table 3-9.

Table 3-9: Parameters values in MATLAB

Diodes | Value | MOSFETs | Value | Pulse generator | Value
Ron | 0.001 Ω | Ron | 0.1 Ω | Amplitude | 1
Vf | 0.8 V | Rd | 0.01 Ω | Period | 1/83500
Cs | 250 nF | Cs | ꝏ | Pulse Width -Phase delay | 50% - 0
DC Supply | HFI | RIWPT | AC/DC Converter | Load

Figure 3-16 shows the m-file and the function file for calculating the

half of side lengths of both coils.

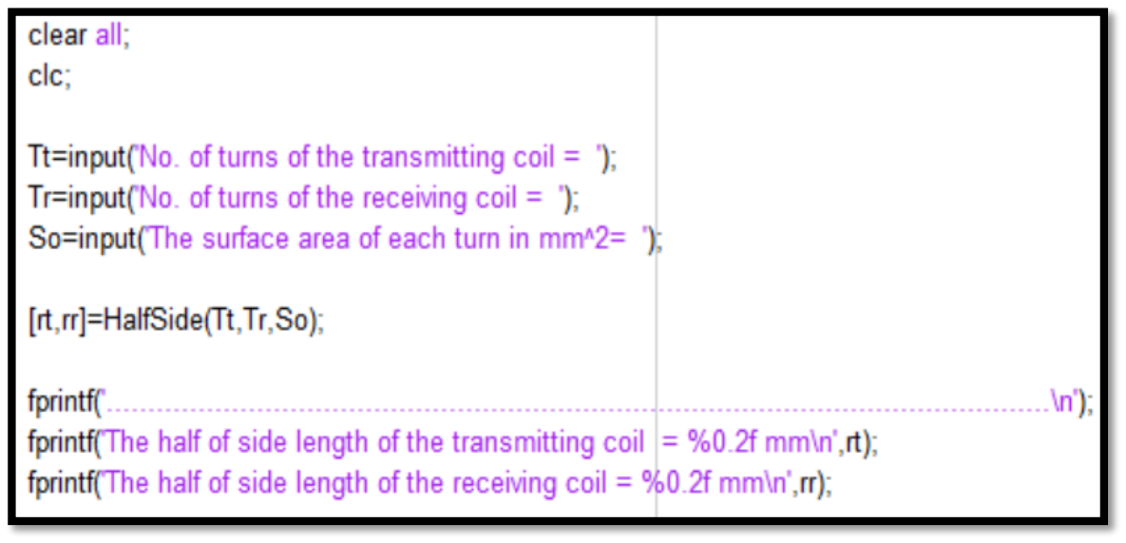
[picture p92: figure]
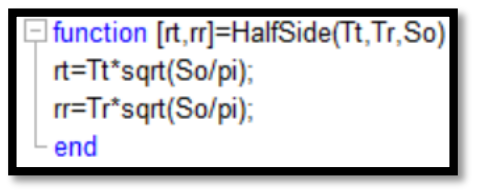
[picture p93: figure]

Figure 3-16: The m-file and the function file for calculating the half of side lengths of both coils

Figure 3-17 shows the m-file and the function file for calculating

the DC resistances of both coils.

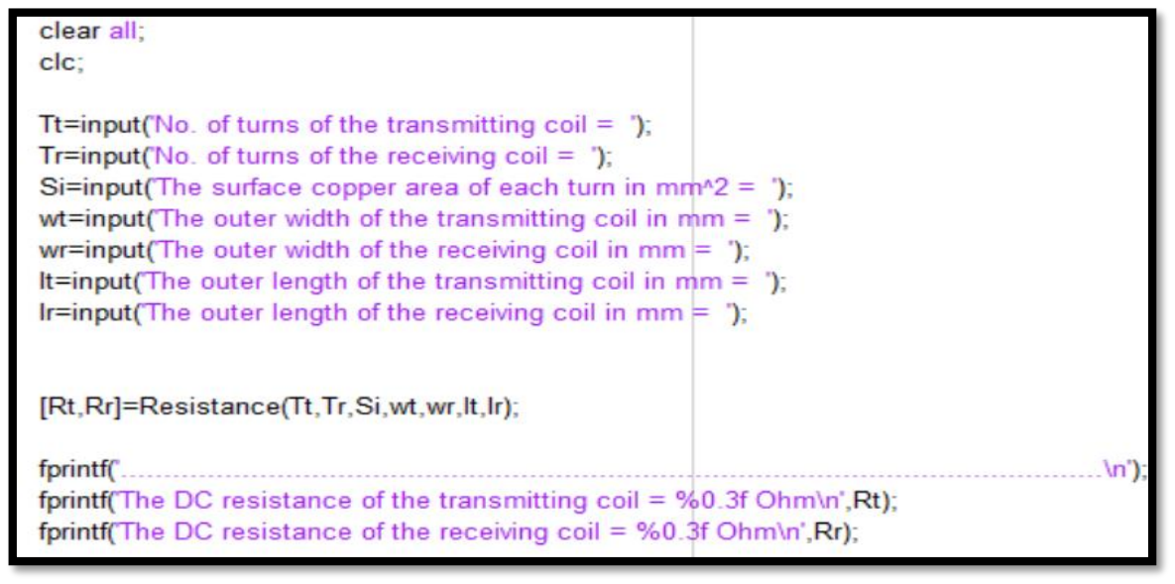
[picture p94: figure]
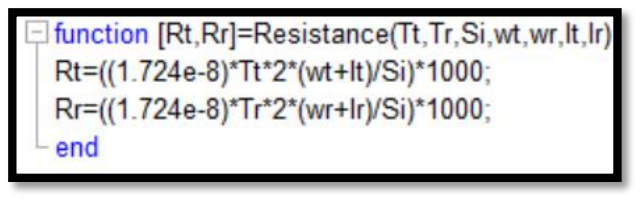
[picture p95: figure]

Figure 3-17: The m-file and the function file for calculating the DC

resistances of both coils

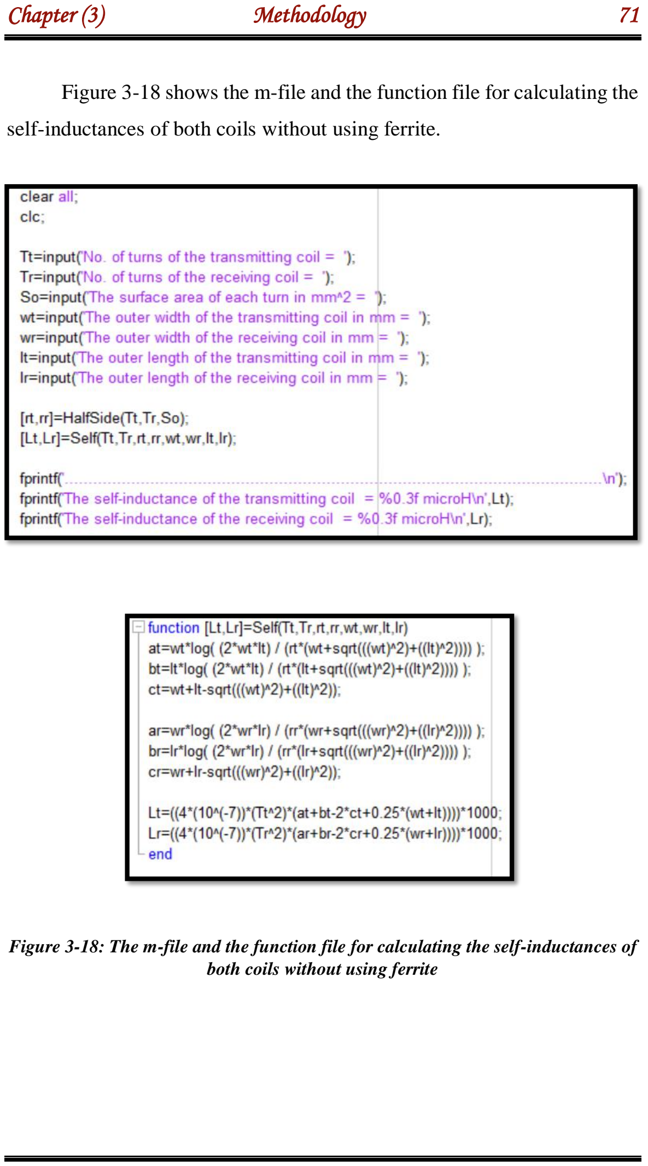
[picture p96: page 90]

Figure 3-18 shows the m-file and the function file for calculating the

self-inductances of both coils without using ferrite.

Figure 3-18: The m-file and the function file for calculating the self-inductances of both coils without using ferrite

Figure 3-19 shows the m-file and the function file for calculating the

mutual inductance between both coils without using ferrite.

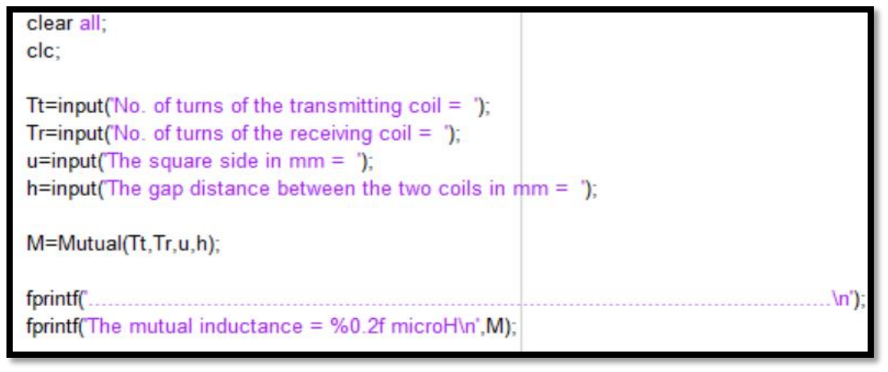
[picture p97: figure]
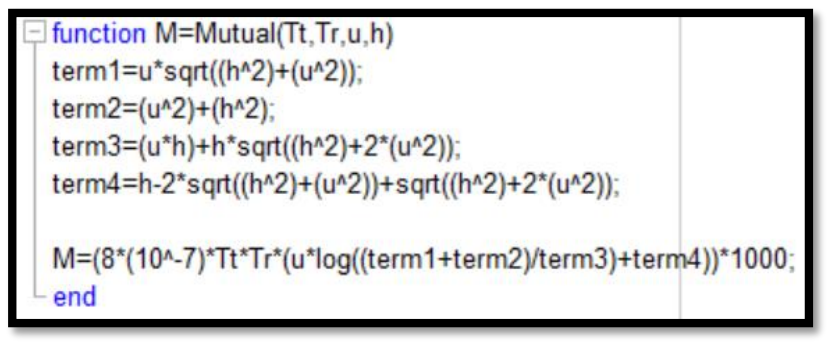
[picture p98: figure]

Figure 3-19: The m-file and the function file for calculating the mutual inductance between both coils without using ferrite

Figure 3-20 shows the m-file and the function file for calculating the

coupling coefficient between both coils without using ferrite.

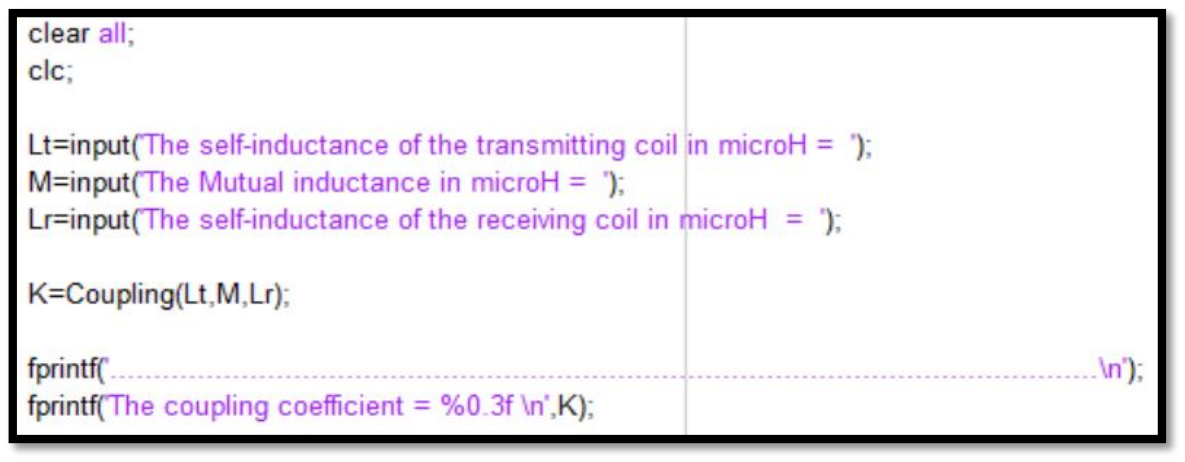
[picture p99: figure]
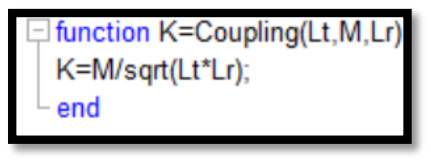
[picture p100: figure]

Figure 3-20: The m-file and the function file for calculating the coupling coefficient between both coils without using ferrite

Figure 3-21 shows the m-file and the function file for calculating the

capacitances of the transmitting and the receiving circuits without using

ferrite.

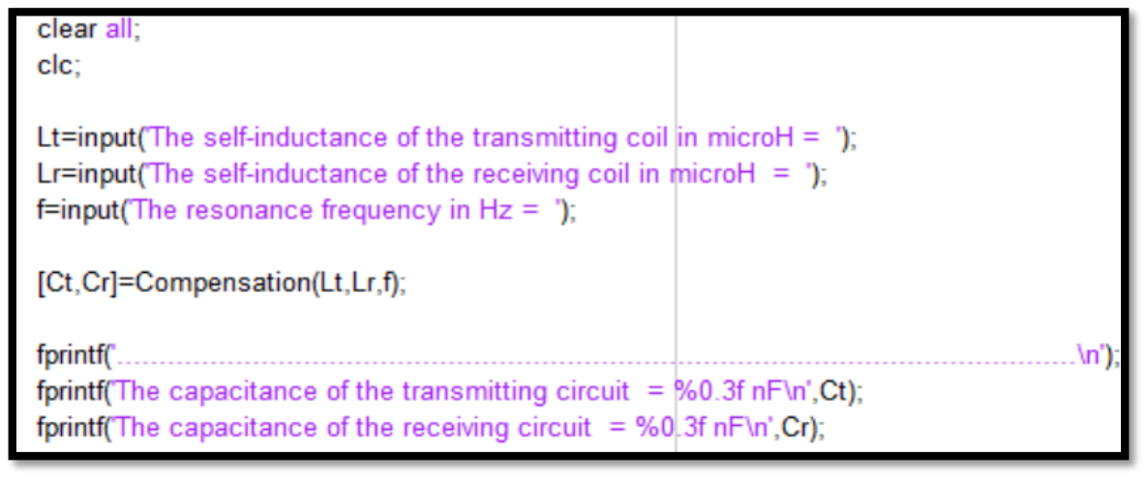
[picture p101: figure]
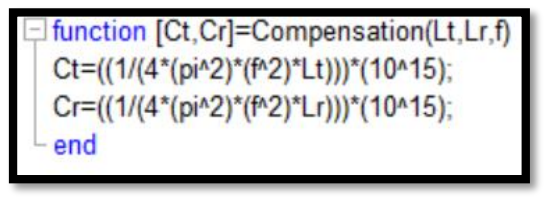
[picture p102: figure]

Figure 3-21: The m-file and the function file for calculating the capacitances of the transmitting and the receiving circuits without using ferrite

Figure 3-22 shows the m-file and the function file for calculating the

RMS transmitting current with using ferrite.

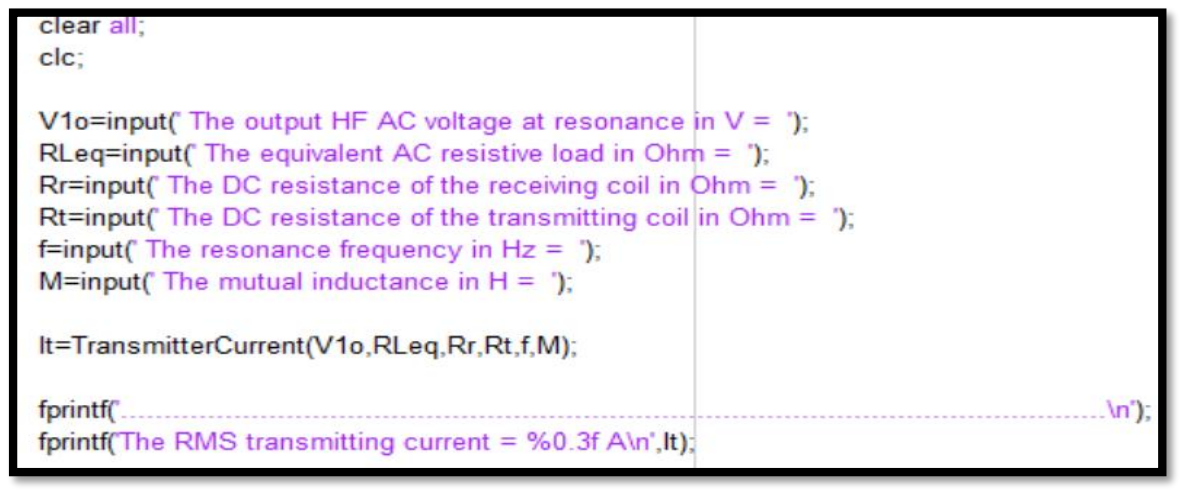
[picture p103: figure]
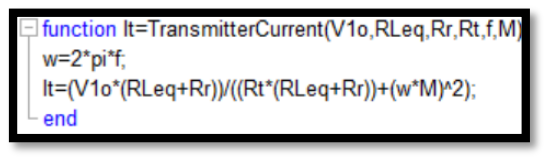
[picture p104: figure]

Figure 3-22: The m-file and the function file for calculating the RMS transmitting current with using ferrite

Figure 3-23 shows the m-file and the function file for calculating the

RMS receiving current with using ferrite.

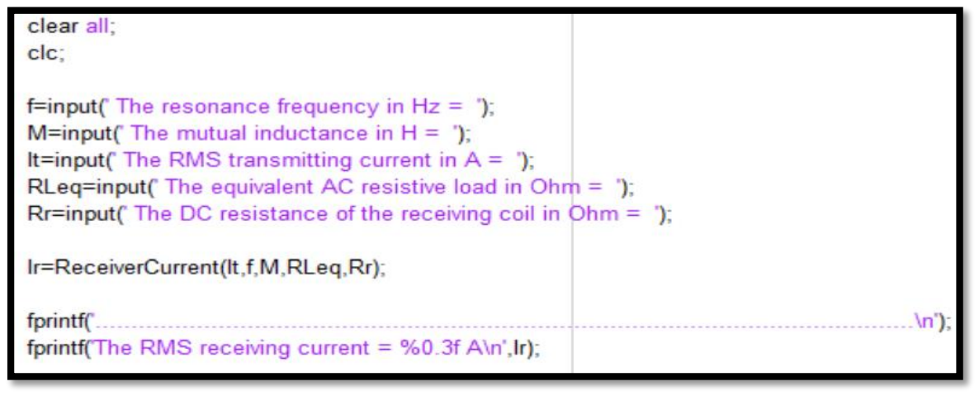
[picture p105: figure]
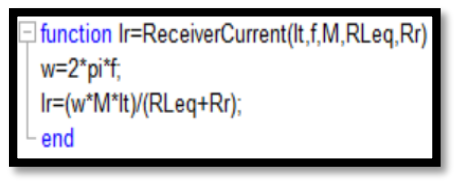
[picture p106: figure]

Figure 3-23: The m-file and the function file for calculating the RMS receiving current with using ferrite

Figure 3-24 shows the m-file and the function file for calculating the

RMS power delivered to the equivalent AC resistive load with using ferrite.

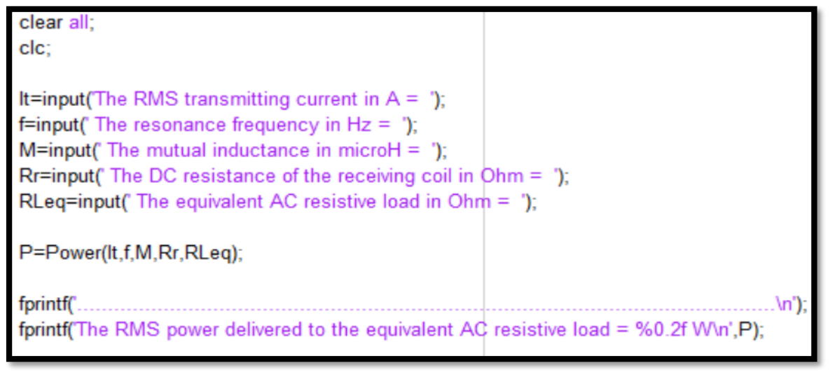
[picture p107: figure]
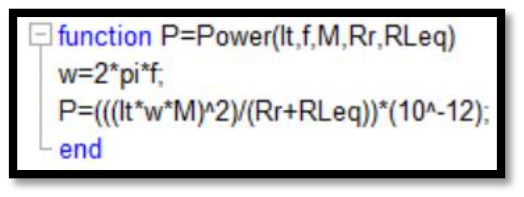
[picture p108: figure]

Figure 3-24: The m-file and the function file for calculating the RMS power delivered to the equivalent AC resistive load with using ferrite

Figure 3-25 shows the m-file and the function file for calculating the

efficiency while using the SS compensation with using ferrite.

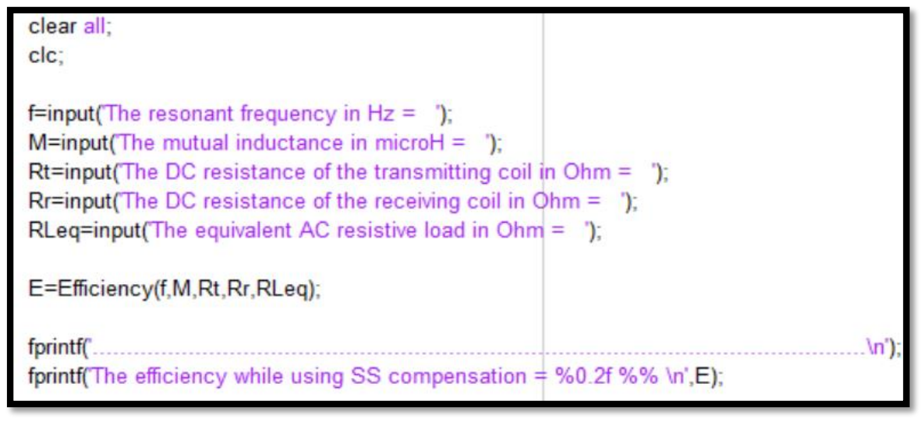
[picture p109: figure]
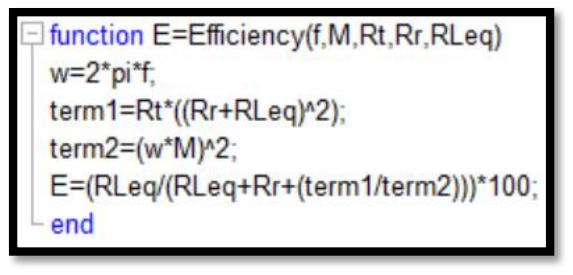
[picture p110: figure]

Figure 3-25: The m-file and the function file for calculating the efficiency while using the SS compensation with using ferrite

### 3.2.3 WPT system’s costs

Table 3-10: Cost of the HFI

Component | Quantity | Price (each) | Taxes (L.E) | Shipping (L.E) | Total price (L.E)
G3R40MT12D SiC Mosfet (https://www.aliexpress.com/item/1005008948528361.html?pdp_ext_f=%7b) [20] | 4 | 131.91 | 75 | 290.19 | 1025
Aluminum Heatsink (https://makerselectronics.com/product/aluminum-heatsink-10x10-20x10cm) 100*150*20 (https://makerselectronics.com/product/aluminum-heatsink-10x10-20x10cm) [21] | 1 | 260 | — | 70 | 330
PCB Prototype Board (https://makerselectronics.com/product/pcb-prototype-board-vero-board-fr-2-dotted-line-center-splitted-breadboard) [22] | 1 | 18 | — | — | 18
PCB for Inverter (https://metanoia-eg.com/order-now/) [23] | 1 | 800 | — | 100 | 900
STM32F401 (https://makerselectronics.com/product/stm32f401rct6-stm32-development-board-the-black-pill) microcontroller (https://makerselectronics.com/product/stm32f401rct6-stm32-development-board-the-black-pill) [24] | 1 | 320 | — | — | 320
ST-LINK V2 Emulator (https://makerselectronics.com/product/st-link-v2-emulator-and-debuggerprogrammer-for-stm8-and-stm32) [25] | 1 | 220 | — | — | 220
3.3V voltage adapter (https://www.amazon.eg/-/en/Adaptor-Adapter-Heater-Replacement-YusufMarket/dp/B0DP5NVX8Q?sr=8-1) [26] | 1 | 86 | — | — | 86
IR2110 Gate driver (https://makerselectronics.com/product/ir2110-high-side-and-low-side-gate) [27] | 2 | 95 | — | 70 | 260
UF4007 Fast recovery diode (https://makerselectronics.com/product/diodes-fast-recovery-rectifier-uf4007-1-7v1a-75ns-1a-1kv-do-41) [28] | 6 | 1 | — | — | 6
Carbon Resistor 13Ω 0.25W (https://makerselectronics.com/product/carbon-resistor-13%cf%89-0-25w-through-hole) [29] | 10 | 0.15 | — | — | 1.5
22uF 160V Capacitor (https://makerselectronics.com/product/capacitor-22uf-160v) [30] | 2 | 1.5 | — | — | 3
0.22uF 50V Capacitor (https://makerselectronics.com/product/capacitor-220nf-50v) [31] | 3 | 0.75 | — | — | 2.25
490nF 275V Ceramic (https://makerselectronics.com/product/capacitors-polypropylene-film-470nf-2) Capacitor (https://makerselectronics.com/product/capacitors-polypropylene-film-470nf-2) [32] | 4 | 2 | — | — | 8
Breadboard (https://makerselectronics.com/product/breadboard-830-point-splitted-power-rails) [33] | 1 | 40 | — | — | 40
5.6k 0.25W ohm Resistor (https://makerselectronics.com/product/carbon-resistor-5-6k%cf%89-0-25w-through-hole) [34] (https://makerselectronics.com/product/carbon-resistor-5-6k%cf%89-0-25w-through-hole) | 10 | 0.15 | — | — | 1.5
6N135 Optocoupler (https://makerselectronics.com/product/6n135-high-speed-optocoupler-with-transistor-output-dip-8) [35] | 2 | 30 | — | — | 60
220V to 12Vdc converter (https://makerselectronics.com/product/ac-dc-220vac-to-12vdc-400ma-4-5w-converter-step-down) [36] | 3 | 65 | — | — | 195
Terminal block 2 pins (https://makerselectronics.com/product/kf127-5-0-2p-green-terminal-block) [37] | 5 | 3.25 | — | — | 16.25
Red Led (https://makerselectronics.com/product/red-led-5mm-trans) [38] | 1 | 0.5 | — | — | 0.5
Jumper Wire (https://makerselectronics.com/product/jumper-wire-10-cm-male-to-male-pin) [39] | 30 | 0.75 | — | — | 22.5
Total Price: | | | | | 3515.5

Table 3-11: Cost of the transmitter’s compensation

Component | Quantity | Price (each) | Taxes (L.E) | Shipping (L.E) | Total price (L.E)
0.33uF Resonance Film (https://makerselectronics.com/product/high-voltage-resonance-film-capacitor-for-induction-0-33uf-1200v) Capacitor (https://makerselectronics.com/product/high-voltage-resonance-film-capacitor-for-induction-0-33uf-1200v) [40] | 14 | 40 | — | 70 | 630
PCB prototype board (https://makerselectronics.com/product/pcb-prototype-board-vero-board-fr-4-dotted-line-center-splitted) [41] | 1 | 32 | — | — | 32
Total Price: | | | | | 662

Table 3-12: Cost of the induction coils

Component | Quantity | Price (each) | Taxes (L.E) | Shipping (L.E) | Total price (L.E)
Litz Wire 0.1*600 strands (https://www.aliexpress.com/item/1005009074696221.html?pdp_ext_f=%7b) (20m) (https://www.aliexpress.com/item/1005009074696221.html?pdp_ext_f=%7b) [42] | 2 | 2100 | 4477.94 | 7000 | 15677.94
Iclyric Board 65*65cm | 4 | 822.5 | — | — | 3290
Iclyric Rod 20cm | 4 | 167.5 | — | — | 670
PC40 Mn-Zn Soft Ferrite (https://www.aliexpress.com/item/1005006158154308.html?pdp_ext_f=%7b) core 4 pieces 60*16*8 (https://www.aliexpress.com/item/1005006158154308.html?pdp_ext_f=%7b) [43] | 6 | 425 | 1580 | Free | 4130
Total Price: | | | | | 23767.94

Table 3-13: Cost of the receiver’s compensation

Component | Quantity | Price (each) | Taxes (L.E) | Shipping (L.E) | Total price (L.E)
0.33uF Resonance Film (https://makerselectronics.com/product/high-voltage-resonance-film-capacitor-for-induction-0-33uf-1200v) Capacitor (https://makerselectronics.com/product/high-voltage-resonance-film-capacitor-for-induction-0-33uf-1200v) [40] | 14 | 40 | — | 70 | 630
PCB prototype board (https://makerselectronics.com/product/pcb-prototype-board-vero-board-fr-4-dotted-line-center-splitted) [41] | 1 | 32 | — | — | 32
Total Price: | | | | | 662

Table 3-14: Cost of the AC/DC converter

Component | Quantity | Price (each) | Taxes (L.E) | Shipping (L.E) | Total price (L.E)
220uF 450V Capacitor (https://makerselectronics.com/product/capacitor-220%ce%bcf-450v) [44] | 3 | 35 | — | 70 | 175
SEI60-10A Diode 1000V (https://makerselectronics.com/product/dsei60-10a-diode-1000-v-60a-to-247ad) 60A (https://makerselectronics.com/product/dsei60-10a-diode-1000-v-60a-to-247ad) [45] | 4 | 90 | — | — | 360
Secondary Rectifier PCB (https://metanoia-eg.com/order-now/) [46] | 1 | 200 | — | — | 200
5.8ohm 5KW Load | 1 | 2000 | — | 20 | 2020
Total Price: | | | | | 2755

Table 3-15: Cost of other components

Component | Quantity | Price (each) | Taxes (L.E) | Shipping (L.E) | Total price (L.E)
Electrical Box PI65 (30*40*17) cm | 1 | 1280 | — | — | 1280
Electrical Box PI65 (25*35*15) cm | 1 | 680 | — | — | 680
DC Fan 12V 0.22A (https://makerselectronics.com/product/dc-fan-12v-0-22a-8x8cm) [47] | 3 | 55 | — | — | 165
Male Blade crimp Terminal | 100 | 1 | — | — | 100
Female Blade crimp Terminal | 100 | 1 | — | — | 100
AC Power Socket 3 Pin (https://makerselectronics.com/product/ac-power-socket-3-pin-male-plug-connector-10a-250v-with-fuse-compartment) [48] (https://makerselectronics.com/product/ac-power-socket-3-pin-male-plug-connector-10a-250v-with-fuse-compartment) | 1 | 15 | — | — | 15
PCB Male Terminals (https://makerselectronics.com/product/terminal-pcb-male-flat-6-3mm) [49] | 20 | 1 | — | — | 20
Stranded 6mm copper wire (5m) | 2 | 50 | — | — | 100
Total Price: | | | | | 2460

Table 3-16: Total production price for the project

Part | Total price (L.E)
HFI | 3515.5
Transmitter’s compensation | 662
Induction coils | 23767.94
Receiver’s compensation | 662
AC/DC converter | 2755
Other components | 2460
Total Price: | 33822.44

Figure 3-26 shows the distribution of the production price for the

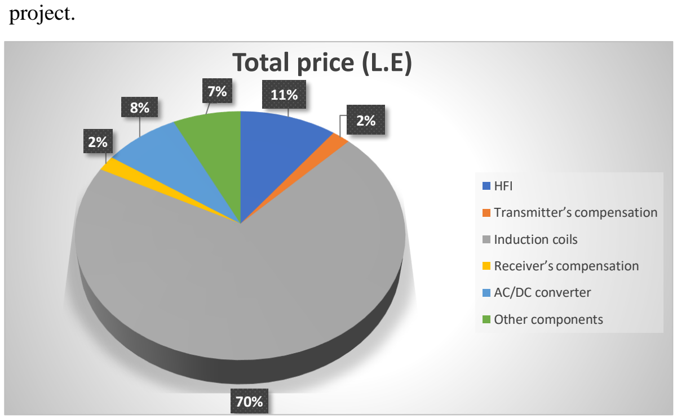
[picture p111: figure]
project.; Total price (L.E); HFI; Transmitter’s compensation; Induction coils; Receiver’s compensation; AC/DC converter; Other components

Figure 3-26: Pie chart showing the distribution of the production price for the project

### 3.3 Practical implementation

The real-life implementation of the proposed system differs from

actual charging systems designed for EVs in that it’s not designed to charge

a battery but rather to provide the power capable of charging the battery in

the receiving side, in normal conditions, this power would then be

converted to the volts and amps necessary for the battery via a BMS and

an on-board charging controller, for the sake of simplicity this step has

been skipped and an AC/DC converter and a high power load will take

place of the on-board charging system to demonstrate the power

transferred. The components of the proposed system are demonstrated in 7

parts as shown in Figure 3-27 and will be discussed in the following steps.

### 1. DC Supply: the start of the system, where it provides the necessary

power to be transferred from grid by converting 220v 50Hz AC to DC,

rating for this project a 1kVA power supply has been selected as the DC

source due to its safety of operation as well as flexibility in varying the

output voltage for testing purposes.

Figure 3-27: The components of the proposed system

The DC supply used in our prototype is shown in Figure 3- 28

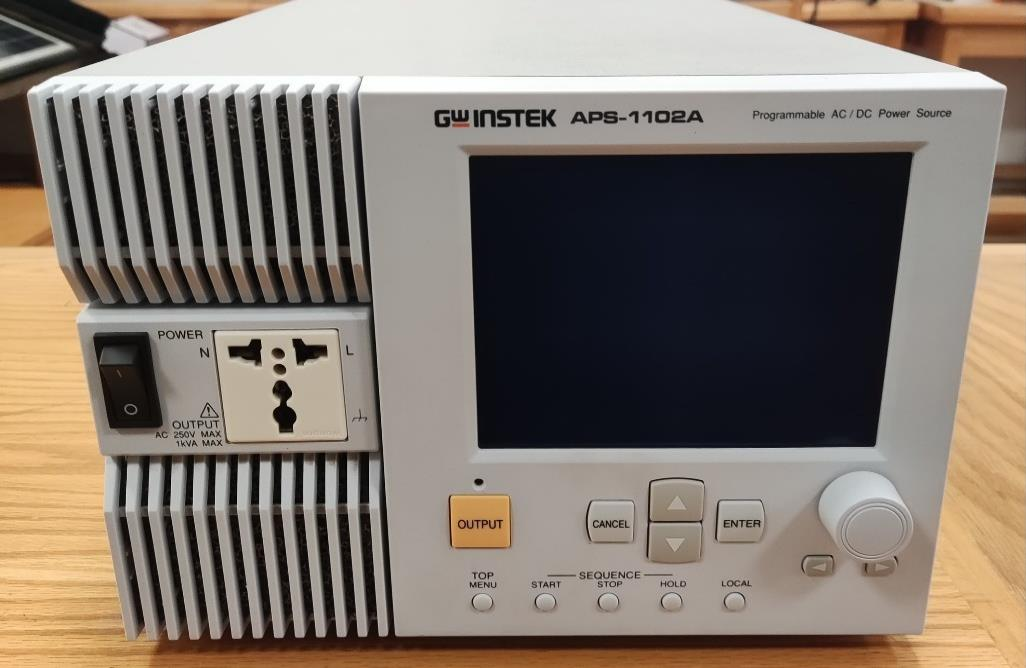
[picture p112: figure]

### 2. HFI: in order to obtain a high frequency signal for the

transmission process, a high frequency inverter is developed, The DC

current is turned into a square wave AC current via an H-Bridge MOSFET

connection, the gate pulses provided to the MOSFET are through a half

bridge drive (IR2110) which takes input from a separate micro-controller

(STM32F401RCT6, Black Pill) which can be modified to output a high

frequency pulse with the specified duty cycle.

Table 3-17: Gate driver specifications

Gate driver specifications
Turn-on propagation delay | 120 ns
Turn-off propagation delay | 94 ns
Shutdown propagation delay | 110 ns
Turn-on rise time | 25 ns
Turn-off fall time | 17 ns
Delay matching | 10 ns
High side floating supply offset voltage | 500 V
Turn-on propagation delay | 120 ns

Figure 3-28: The laboratory power supply

Table 3-18: STM specifications

STM specifications
Operating voltage | 1.7 to 3.6 V
Maximum CPU frequency | 84 MHz
Flash memory | 256 Kbytes
SRAM | 64 Kbytes
Operating temperatures | Ambient temperatures: –40 to +85 °C/–40 to +105 °C/–40 to +125°C Junction temperature: –40 to + 130°C

The MOSFETs are picked up on the basis of their switching speed

and current rating. Ultra-fast switching (G3R40MT12D SiC) MOSFETs

with ratings of 1200 V were picked as they work perfectly. Table 3-19

shows SiC MOSFET specifications.

Table 3-19: SiC MOSFET specifications

SiC MOSFET specifications
Drain-Source Voltage Vds (max) | 1200 V
Continuous Forward Current | T=25°C Id=63A T=100°C Id=44A T=135°C Id=32A
Turn on delay time | 45 ns
Rise time | 16 ns
Turn off delay time | 19 ns
Fall time | 11 ns
Drain-Source On resistance | 40 mΩ
Gate Threshold Voltage | 2.7 V

The optocoupler (6N135) is a vital component that ensures safe

transmission of the pulses from the microcontroller to the gate driver, the

STM's ground pin should be completely isolated from the rest of the circuit

otherwise a fault will occur, given the very high frequency this inverter

operates at, it is necessary that the optocoupler is capable of handling that

frequency, the 6N135 has a rise time and fall time of 1.5 µs and can handle

switching of up to 300 kHz, that's why it was chosen for this operation.

Table 3-20: Optocoupler specifications

Optocoupler specifications

Rise time | 1.5 µs
Fall time | 1.5 µs
Switching frequency | Up to 300 KHz

The HFI components are shown in Figure 3-29

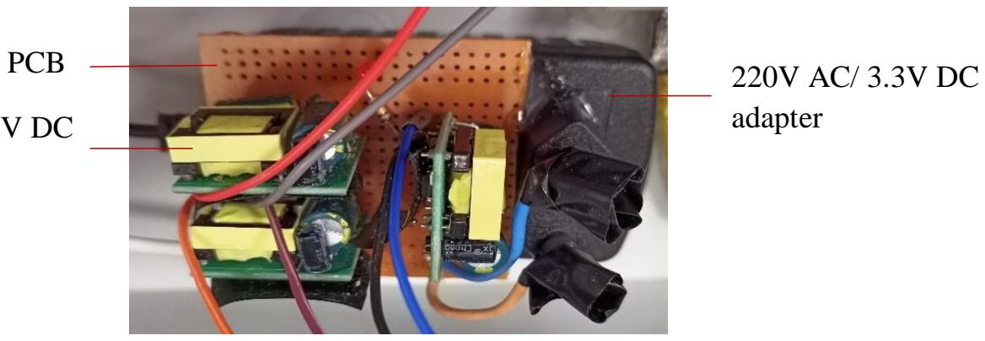
[picture p113: figure]
PCB; adapter
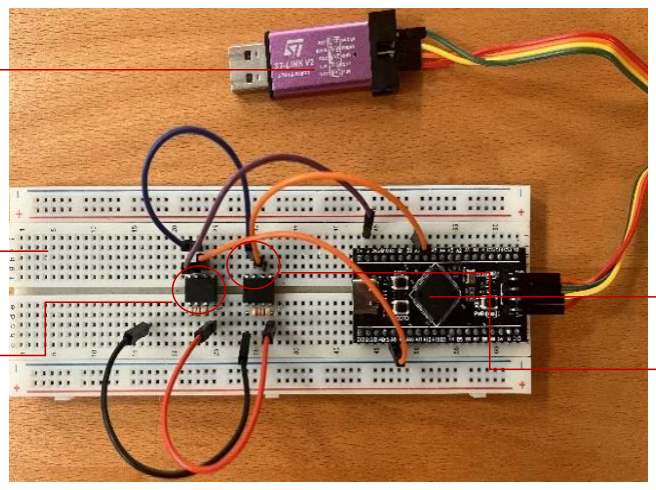
[picture p114: figure]
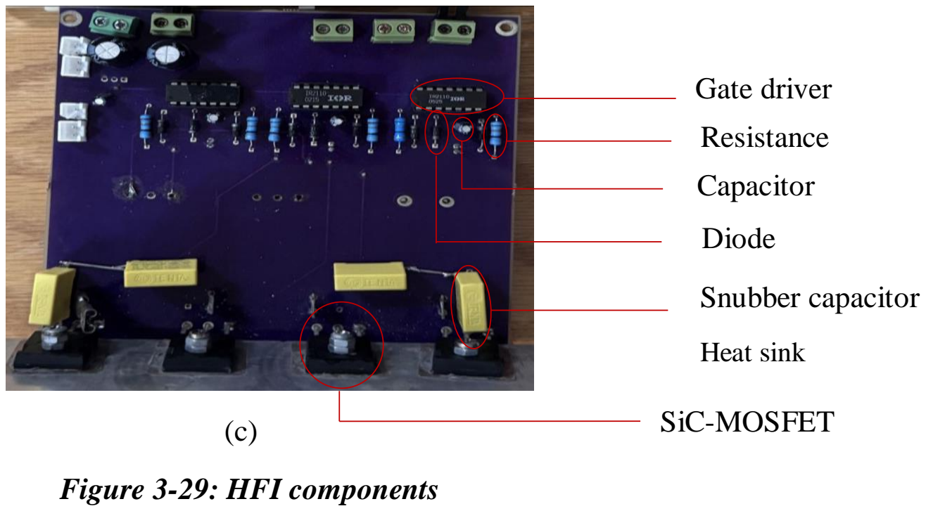
[picture p115: figure]
Heat sink; SiC-MOSFET; Snubber capacitor; Gate driver; Diode; Resistance; Capacitor; Figure 3-29: HFI components

(a) Feeding of gate
driver and fan cooling
(b) STM and
optocoupler circuits
(c) MOSFETs and gate
driver circuits

Optocoupler

STM

Bread board

220V AC /12V DC
converter

(a)

(b)

Resistance

ST-LINK

### 3. Transmitter’s Compensation Topology: an important part which

is responsible for the resonance in the transmitter's circuit, the topology

was picked to be series as discussed in [6] and the capacitors used to fit

that purpose have characteristics which are presented in table 3-21.

Table 3-21: Compensation characteristics

Metallized Polypropylene Film Capacity

Rated DC voltage | 1200 V
Capacitance | 0.33 μF
DC Voltage proof | 2*UR/ 10s
Insulation resistance | ≥30000 Ω (100 DC V, 60s)
Tangent of loss angle (20℃) | ≤0.0007 (10 kHz)
Pulse rise time (dv/dt) | 500V/μs Max

The series transmitter's compensation with its capacitance read by the LCR

meter is shown in Figure 3-30

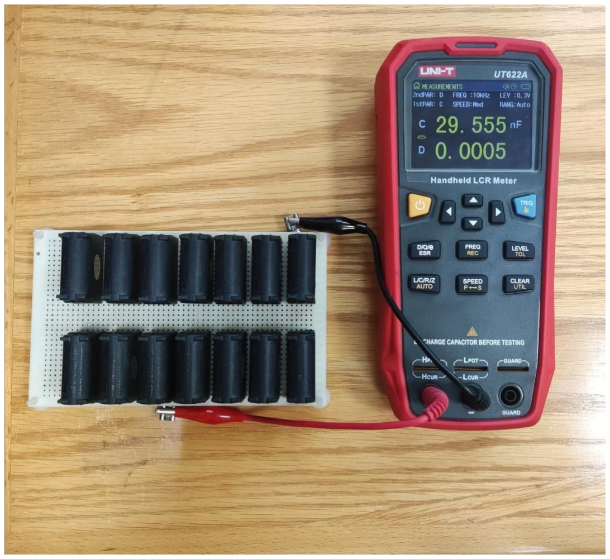
[picture p116: figure]

Figure 3-30: Transmitter's practical compensation

### 4. Inductive Coupling: the design of the two coils was identical in

order to achieve optimal operation in the SS topology state [1]. As well as

it was easier to predict the behavior of equation-wise. Two designs were

discussed, circular and square, the material used for the construction of the

coils was Litz wire 0.1x600 strands, and that’s due to skin effect of current

passing through the conductor, each strand of Litz wire is insulated from

one another. The number of the strands is high to reduce conduction losses

as well as heating losses within the wire.

The coils were placed on a platform made out of Iclyric for

transparency as well as not to interfere with the electromagnetic field

radiated from the coil [19]. The design and construction of the coils is

shown in Figure 3-31.

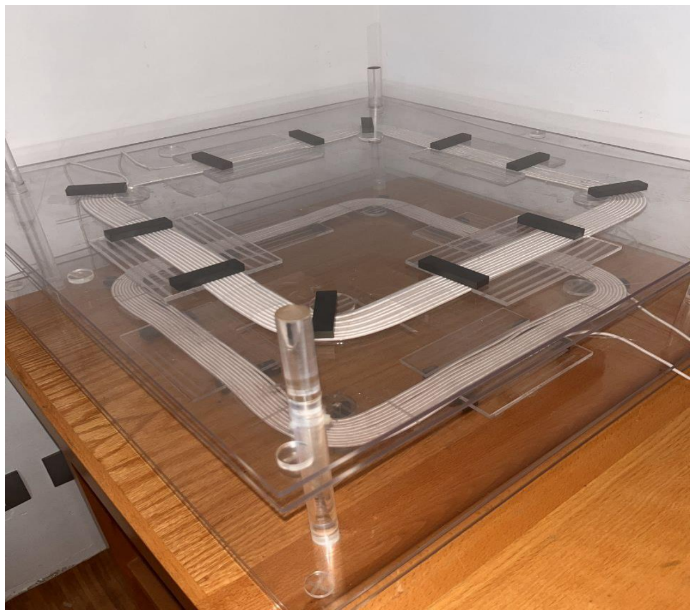
[picture p117: figure]

Figure 3-31: The coil design

The parameters of the coils were studied to reach optimal efficiency.

The model followed by constructing such a design is presented in the

flowchart shown in Figure 3-32. This flowchart determines the number of

turns and dimensions of coils, assuming a desired air gap distance. The

relation will also determine the approximate wire length needed for the

construction of the system.

Table 3-22: WPT Coil Properties

Parameter | Value | Parameter | Value
Di | 2.45 mm | rt | 16.25 mm
| 3.25 mm | | 4.17 mm² Si Do
| 0.1 mm | So | 8.3 mm² Ds
| 150 mm | T r | 10 turns h
l | 40 m Litz | T | 10 turns t
lr | 450 mm | u | 450 mm
lri | 385 mm | wr | 450 mm
lt | 450 mm | wri | 385 mm
lti | 385 mm | wt | 450 mm
N | 600 strands | wti | 385 mm
RDC l | 0.006 Ω/m | µo | 4 π × 10⁻7 H/m
r | 16.25 mm | ρcu r | 1.724 × 10⁻8 Ωm

Table 3-23: The DC resistances of the Litz wire used

DC resistance | Calculated value by Eq.4 and Eq.5 | Measured Value by LCR meter device
Rr | 0.0744 Ω | 0.1 Ω
Rt | 0.0744 Ω | 0.1 Ω

After the coil parameters are obtained, the values of self and mutual

inductances are calculated based on the m-file script provided in [Figure 3-

18 and Figure 3-19].

Once these values have been calculated a coupling coefficient is

calculated to determine whether the system produced is viable or not.

According to SAE J2954, K should not reach below 0.2 or the WPT system

will not be efficient.

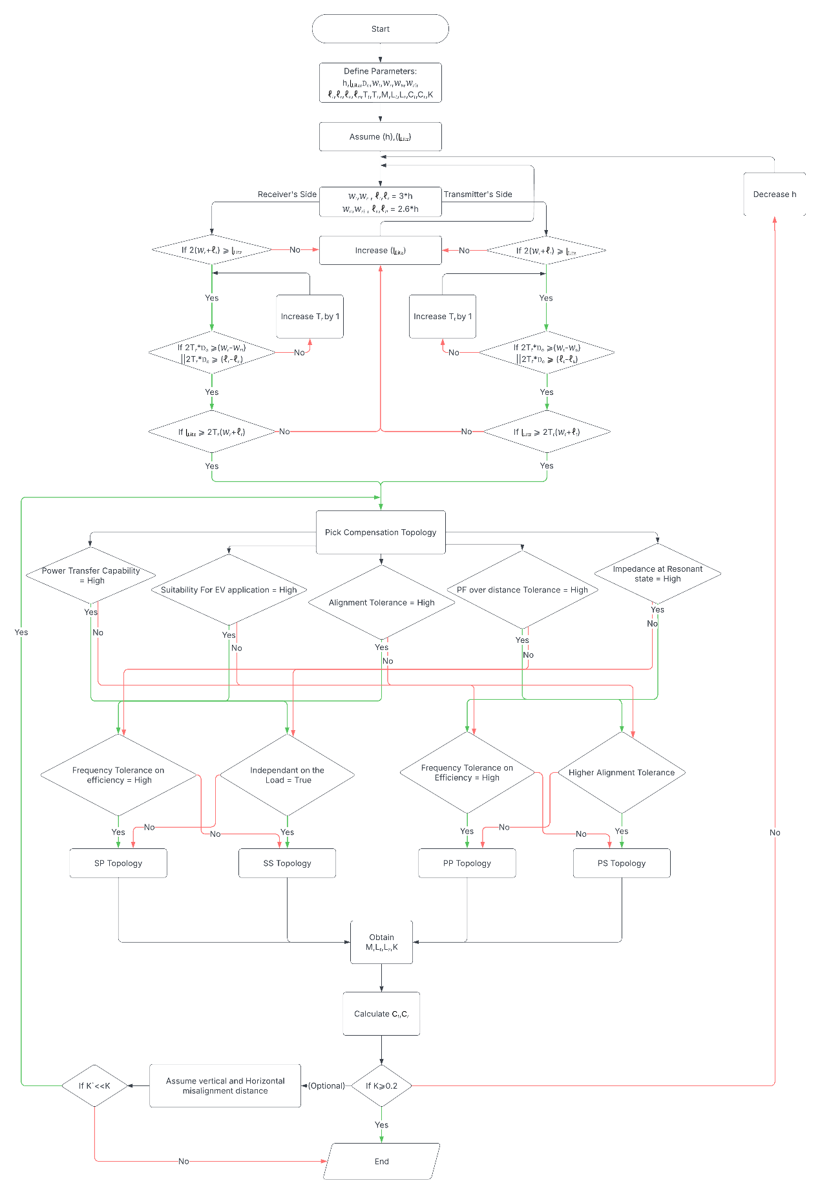
[picture p118: figure]

Figure 3-32: Flow chart of the design

The general design procedure for implementing WPT system, as

outlined in the flowchart:

a) Define system parameters such as the coil’s inner and outer dimensions

from height and width, length of the wire used as well as the number

of turns, air gab distance between the two coils and special parameters

such as coils’ self and mutual inductances, transmitter and receiver

capacitances as well as coupling coefficient.

b) We obtain the required Litz wire length per air gab distance by

assuming their desired values for start, these values will change until a

proper solution is achieved based on the equations presented in the

flowchart.

c) Coils’ inner and outer dimensions are obtained with an equation that

involves the air gab distance between them, the first stage involves

ensuring that the wire could complete one full turn of the coil based on

the obtained dimensions.

d) The possible number of turns is calculated based on the difference

between the inner and outer dimensions; the second stage ensures that

the wire length could cover the coil dimensions per turn of the obtained

number of turns value.

e) Picking the compensation topology depends on the type of application

needed for your system, for example if a high alignment tolerance is

needed as well as frequency tolerance on efficiency then SP

compensation is most fitting.

f) Once a compensation topology has been picked, the rest of the coil’s

parameters from self and mutual inductances as well as compensation

capacitors’ values are calculated based on the perspective equations of

picked compensation topology.

g) To ensure the system is reliable, based on the SAE J2954 standard, if the coupling coefficient of 0.2 or above is not met, the assumed air gab

distance at the start will have to be reconsidered and the process will

repeat.

h) Optionally, if alignment considerations are not met as desired, the

compensation topology will have to be reconsidered for one that works

better for misalignment conditions.

### 5. Receiver’s Compensation Topology: the connection is series to

obtain the SS topology, the capacitor characteristics used is given in table

3-21.

The series receiver's compensation with its capacitance read by the

LCR meter is shown in Figure 3-33.

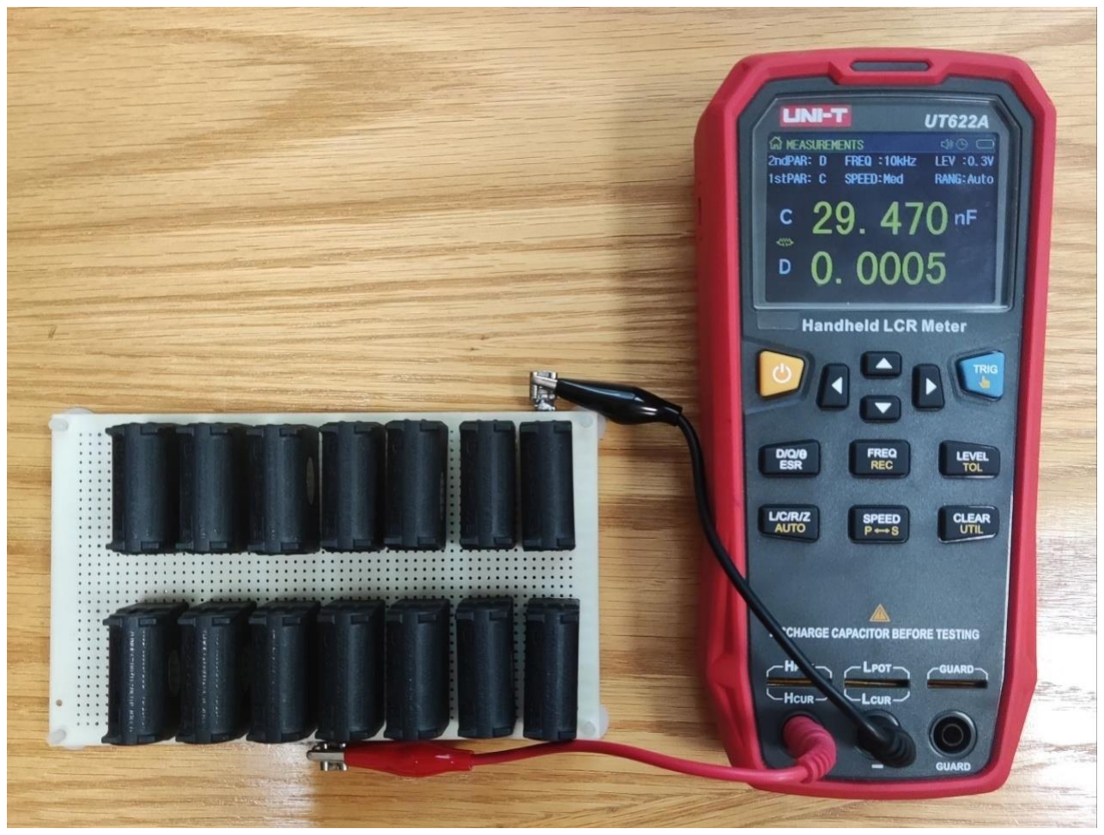
[picture p119: figure]

Figure 3-33: Receiver's practical compensation

### 6. AC/DC Converter: to turn the received power from the coil into

DC, the use of ultra-high switching speed diodes is required, this minimizes

the amount of power lost in rectification thereby increasing efficiency for

this prototype a (DSEI 60) diode was used. Table 3-24 shows Diode

specifications.

Table 3-24: Diode specifications

Diodes specifications

Reverse Recovery Time | 50 ns
Peak Inverse Voltage | 1000 V
Forward Current Rating | 60 A

Figure 3-34 shows the full bridge AC/DC coverter before the load

which consists of four ultra-high switching, 1000V-60A rating diodes and

3×220 uF electrolytic capacitors in order to filter the DC output voltage

across the load and ensure small ripples in it.

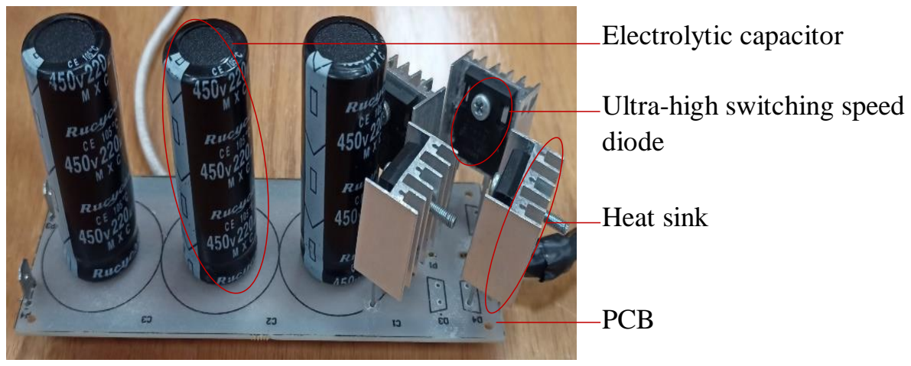
[picture p120: figure]
Ultra-high switching speed diode; PCB; Electrolytic capacitor; Heat sink

Figure 3-34: Practical AC/DC converter

### 7. Load: the load used is 5 Ω power resistance rated at 5 KW, which

can handle the high power coming from the coil.

Figure 3-35 shows the 5KW rated load which followed the AC/DC

converter, and we will measure the DC current through it and also the DC

voltage across it.

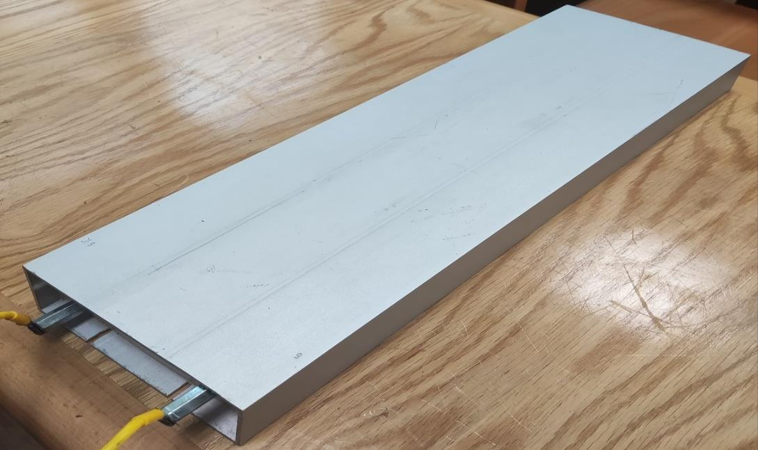
[picture p121: figure]

Figure 3-35: The practical resistive load

Chapter (4) | Results and Discussion | 97
| 4 Chapter (4): Results and Discussion

### 4.1 Simulation results

Table 4-1: The simulated, calculated and measured values of the self-inductances for both coils, without using ferrite

Self-inductance | Obtained value from ANSYS Maxwell 3D | Calculated value from Eq.6 and Eq.7 | Measured value by LCR meter device
Lt | 113.187 µH | 100.688 µH | 101 µH
Lr | 113.182 µH | 100.688 µH | 101.5 µH

Table 4-2: The simulated, calculated and practical values of the coupling coefficient and the mutual inductance, without using ferrite

Coupling coefficient and mutual inductance | Obtained value from ANSYS Maxwell 3D | Calculated value from Eq.8 and Eq.9 | Practical Values
M | 19.343 µH | 23.47 µH | 17.5 µH
K | 0.171 | 0.233 | 0.173

Table 4-3: The simulated, calculated and measured values of the self-inductances for both coils, with using ferrite

Self-inductance | Obtained value from ANSYS Maxwell 3D | Calculated value from Eq.6 and Eq.7 | Measured value by LCR meter device
Lt | 125.817 µH | ____ | 116.7 µH
Lr | 125.83 µH | ____ | 117.13 µH

Table 4-4: The simulated, calculated and practical values of the coupling coefficient and the mutual inductance, with using ferrite

Coupling coefficient and mutual inductance | Obtained value from ANSYS Maxwell 3D | Calculated value from Eq.8 and Eq.9 | Practical Values
M | 21.9 µH | ____ | 20 µH
K | 0.174 | ____ | 0.171

Chapter (4) | Results and Discussion | 98

Table 4-5: The simulated, calculated and measured values of the capacitances of the receiving and the transmitting circuits without using ferrite

Capacitances | Simulated value used in ANSYS Simplorer | Calculated value from Eq.10 and Eq.11 | Measured value by LCR meter device
Ct | 32.097 nF | 36.082 nF | 35.964 nF
Cr | 32.099 nF | 36.082 nF | 35.691 nF

Table 4-6: The simulated, calculated and measured values of the capacitances of the receiving and the transmitting circuits with using ferrite

Capacitances | Simulated value used in ANSYS Simplorer | Calculated value from Eq.10 and Eq. 11 | Measured value by LCR meter device
Ct | 28.875 nF | ____ | 29.555 nF
Cr | 28.872 nF | ____ | 29.47 nF

Chapter (4) | Results and Discussion | 99

Table 4-7: ANSYS Maxwell 3D results of the M, K and the magnitude of the magnetic flux of the two coils and ANSYS Simplorer results of the PAC and ηs-s for different cases

Cases | M (µH)
K

Magnetic
flux of
transmitter
(mWb)

Magnetic
flux of
receiving
(mWb)

PAC
(KW)

ηs-s

Figure 3-6: The different air gaps between the transmitter and receiver coils

10 | 28.28 | 0.253 | 1.12 | 1.12 | 1.6 | 97.63
15 | 19.34 | 0.171 | 1.06 | 1.06 | 3.346 | 97.31
20 | 13.57 | 0.12 | 1.011 | 1.01 | 6.178 | 96.5
25 | 9.737 | 0.085 | 0.993 | 0.998 | 10.83 | 95.44

Figure 3-7: The different positions of horizontal misalignment for each scenario

1. (-x, -y)
(-10, -12) | 13.07 | 0.115 | 1.013 | 1.01 | 6.667 | 96.6
(-15, -15) | 9.51 | 0.084 | 0.982 | 0.979 | 10.4 | 95.38
2. (-x)
-10 | 16.52 | 0.146 | 1.032 | 1.032 | 4.353 | 97.07
-15 | 13.75 | 0.12 | 1.02 | 1.021 | 5.92 | 96.6
-30 | 4.745 | 0.042 | 0.94 | 0.941 | 12.1 | 87.29
3. (-y)
-12 | 15.38 | 0.135 | 1.031 | 1.029 | 5.1 | 96.92
-15 | 13.67 | 0.119 | 1.024 | 1.02 | 6.1 | 96.65
-30 | 4.97 | 0.042 | 0.94 | 0.941 | 13.67 | 87.9
4. (-x, +y)
(-10, +12) | 13.07 | 0.115 | 1.014 | 1.017 | 6.468 | 96.45
(-15, +15) | 9.64 | 0.085 | 0.979 | 0.982 | 9.65 | 95.3

Chapter (4) | Results and Discussion | 100

Figure 3-8: Angles exist between the transmitting and receiving coil concerning the Z-axis
5° | 19.63 | 0.17 | 1.074 | 1.072 | 3.22 | 97.28
10° | 19.65 | 0.173 | 1.063 | 1.063 | 3.222 | 97.35
50° | 19.2 | 0.168 | 1.066 | 1.067 | 3.333 | 97.27

Figure 3-9: Angles exist between the transmitting and receiving coil concerning the Y- axis

5° | 19.58 | 0.172 | 1.066 | 1.065 | 3.258 | 97.36
8° | 19.81 | 0.174 | 1.065 | 1.066 | 3.175 | 97.36
20° | 21.63 | 0.19 | 1.081 | 1.081 | 2.684 | 97.26

Figure 3-10: Multiple misalignment error positions in case of horizontal misalignment with rotation around the Z-axis
(-5,10°) | 18.85 | 0.164 | 1.06 | 1.07 | 3.47 | 97.18
(-5,50°) | 18.55 | 0.162 | 1.064 | 1.064 | 3.57 | 97.18
(-15,10°) | 14 | 0.122 | 1.026 | 1.026 | 5.783 | 96.66
(-15,50°) | 14.1 | 0.123 | 1.027 | 1.027 | 5.731 | 96.68
(-30,10°) | 5 | 0.043 | 0.953 | 0.952 | 15.19 | 88.57
(-30,50°) | 4.95 | 0.043 | 0.952 | 0.953 | 14.5 | 88.53

Figure 3-11: Multiple misalignment error positions in case of horizontal misalignment in (-x, -y) with rotation around the Z-axis
((-5, -5), 10°) | 18.06 | 0.157 | 1.06 | 1.06 | 3.72 | 97.1
((-5, -5), 50°) | 17.91 | 0.156 | 1.057 | 1.057 | 3.77 | 97.15
((-15, -15), 10°) | 9.82 | 0.086 | 0.986 | 0.985 | 9.7 | 95.47
((-15, -15), 50°) | 10.24 | 0.089 | 0.996 | 0.995 | 8.9 | 95.51

Chapter (4) | Results and Discussion | 101

Figure 3-12: Multiple misalignment error positions in case of horizontal misalignment in (-x, -y) with a non-uniform air gap in the Z-axis direction with rotation around the Y- axis

(5°, (-5, -5)) | 17.93 | 0.158 | 1.046 | 1.046 | 3.774 | 96.98
(8°, (-5, -5)) | 18.03 | 0.159 | 1.047 | 1.046 | 3.736 | 97.01
(5°, (-15, -15)) | 9.63 | 0.084 | 0.985 | 0.982 | 10.28 | 95.44
(8°, (-15, -15)) | 9.64 | 0.084 | 0.988 | 0.985 | 10.202 | 95.43

Figure 3-13: Multiple misalignment errors is a horizontal misalignment in (-x, -y) direction, combined with a non-uniform air gap in the Z-axis direction with rotation around the Y-axis and Z-axis

(-15, -15) cm, 10° around Z, 8°around Y | 9.55 | 0.084 | 0.985 | 0.980 | 12.809 | 95.9
(-15, -15) cm, 50° around Z, 8°around Y | 10.25 | 0.091 | 0.988 | 0.984 | 10.58 | 96
(-10, -12) cm, 10° around Z, 8°around Y | 13.18 | 0.117 | 1.012 | 1.008 | 7.212 | 96.85
(-10, -12) cm, 50° around Z, 8°around Y | 13.77 | 0.122 | 1.015 | 1.014 | 6.378 | 96.85
(-10, -12) cm, 10° around Z, 5°around Y | 13.13 | 0.116 | 1.015 | 1.011 | 7.249 | 96.83
(-15, -15) cm, 10° around Z, 5°around Y | 9.53 | 0.085 | 0.979 | 0.975 | 12.833 | 95.87

Figure 3-14: Different models used in design for WPT system

1. Aligned at 15cm vertical air gap
(circular, circular) | 27.37 | 0.181 | 1.429 | 1.428 | 1.713 | 97.61
(square, square) | 19.33 | 0.171 | 1.058 | 1.06 | 3.508 | 97.37
(circular, square) | 22.148 | 0.17 | 1.384 | 1.077 | 2.571 | 97.5
(square, circular) | 22.129 | 0.17 | 1.076 | 1.384 | 2.584 | 97.46

Chapter (4) | Results and Discussion | 102

All ANSYS Simplorer results at table 4-7, are obtained at 311 V as

the input DC voltage to the HFI with resonance frequency of 83.3 KHz.

The number of turns of each circular coil designed at a ANSYS

Maxwell 3D is 14 turns with a 450 mm outer diameter. The number of turns

of each square coil designed at a ANSYS Maxwell 3D is 10 turns with a

size of 450 mm × 450 mm.

The length of the Litz wire of each circular coil is 17.8 m. and is 17.4

m for each square coil.

The self-inductance of each circular coil is about 150 µH, and it is

about 113 µH for each square coil.

2. Horizontal misalignment of 15cm in X-axis
(circular, circular) | 17.84 | 0.117 | 1.355 | 1.355 | 3.76 | 97.167
(square, square) | 13.77 | 0.122 | 1.013 | 1.015 | 6.112 | 96.76
(circular, square) | 15.573 | 0.119 | 1.334 | 1.028 | 5.159 | 97.14
(square, circular) | 15.569 | 0.12 | 1.022 | 1.332 | 5.382 | 97.15
3. Horizontal misalignment of 25cm in X-axis
(circular, circular) | 7.85 | 0.052 | 1.27 | 1.27 | 15.724 | 94.67
(square, square) | 7.75 | 0.068 | 0.966 | 0.966 | 15.342 | 94.5
(circular, square) | 7.73 | 0.06 | 1.27 | 0.961 | 16.542 | 94.88
(square, circular) | 7.78 | 0.06 | 0.962 | 1.27 | 16.475 | 94.6

Chapter (4) | Results and Discussion | 103

The capacitance of the series compensation with each circular coil is

about 24 nF at a resonance frequency of 83.3 KHz. And the capacitance of

the series compensation with each square coil is about 32 nF at a resonance

frequency of 83.3 KHz.

The RMS power delivered to the equivalent AC resistive load is

taken at a certain equivalent AC resistive load of a 4.7 Ω.

At a constant output HF AC voltage, and from Eq. (18), the RMS

transmitting current in approximately inversely proportional to the square

of the mutual inductance, since all the other parameters in Eq. (18) are

constants.

From Eq. (20), the RMS power delivered to the equivalent AC

resistive load is directly proportional to the square of both the mutual

inductance and the RMS transmitting current which as we said, is inversely

proportional to the square of the mutual inductance at a constant output HF

AC voltage.

So, we can conclude that the RMS power delivered to the equivalent

AC resistive load is inversely proportional to the square of the mutual

inductance, at a constant output HF AC voltage.

This illustrates why the RMS power delivered to the equivalent AC

resistive load increases when the gap distance between the two coils

increased where the mutual inductance decreases.

But if the RMS transmitting current is kept constant, then from Eq.

(20), the RMS power delivered to the equivalent AC resistive load is

directly proportional to the square of the mutual inductance.

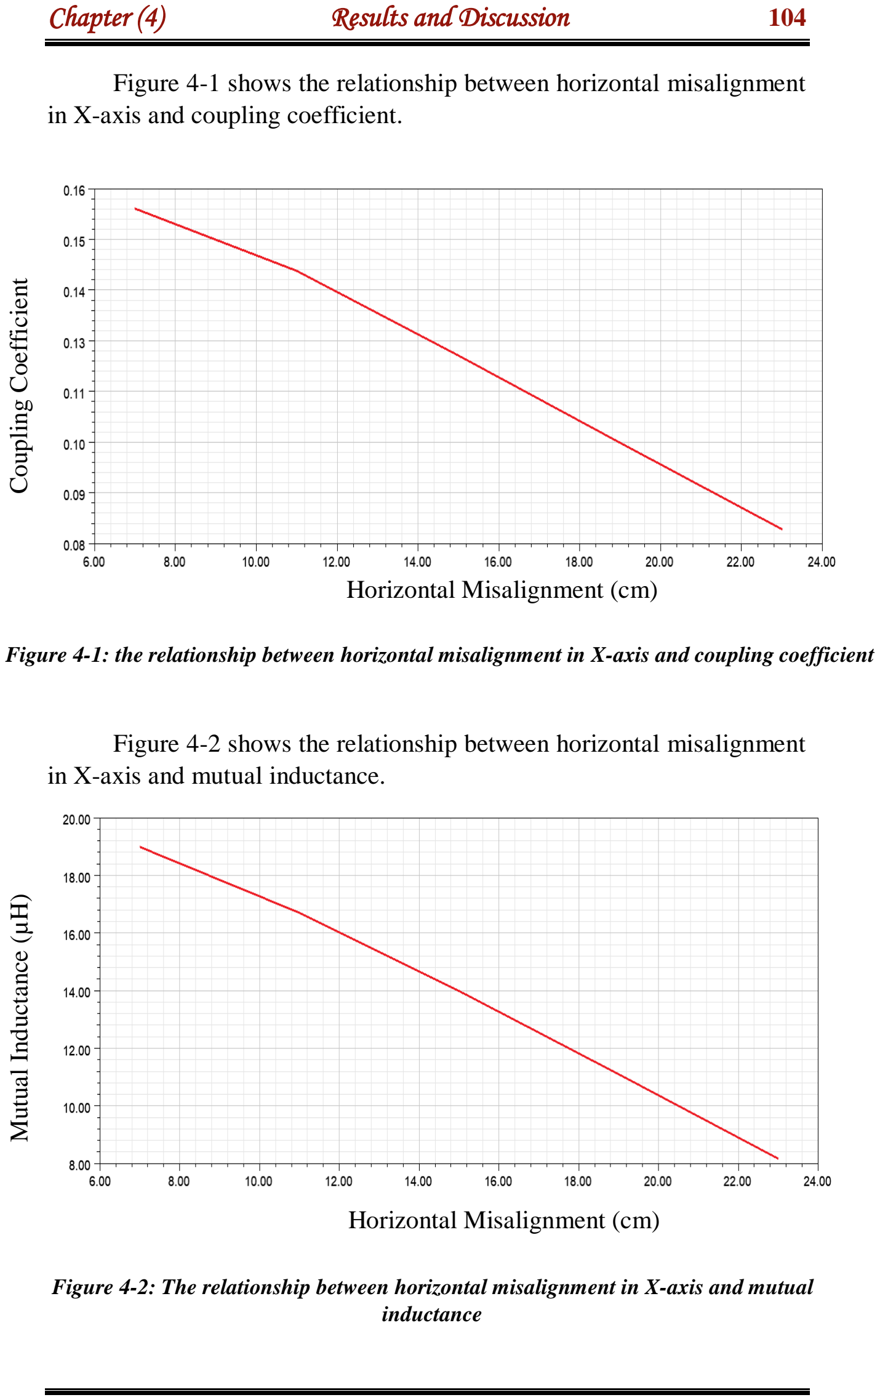
[picture p122: page 123]

Chapter (4) | Results and Discussion | 104

Figure 4-1 shows the relationship between horizontal misalignment in X-axis and coupling coefficient.

Figure 4-2 shows the relationship between horizontal misalignment in X-axis and mutual inductance.

Horizontal Misalignment (cm)

Coupling Coefficient

Horizontal Misalignment (cm)

Mutual Inductance (µH)

Figure 4-2: The relationship between horizontal misalignment in X-axis and mutual inductance

Figure 4-1: the relationship between horizontal misalignment in X-axis and coupling coefficient

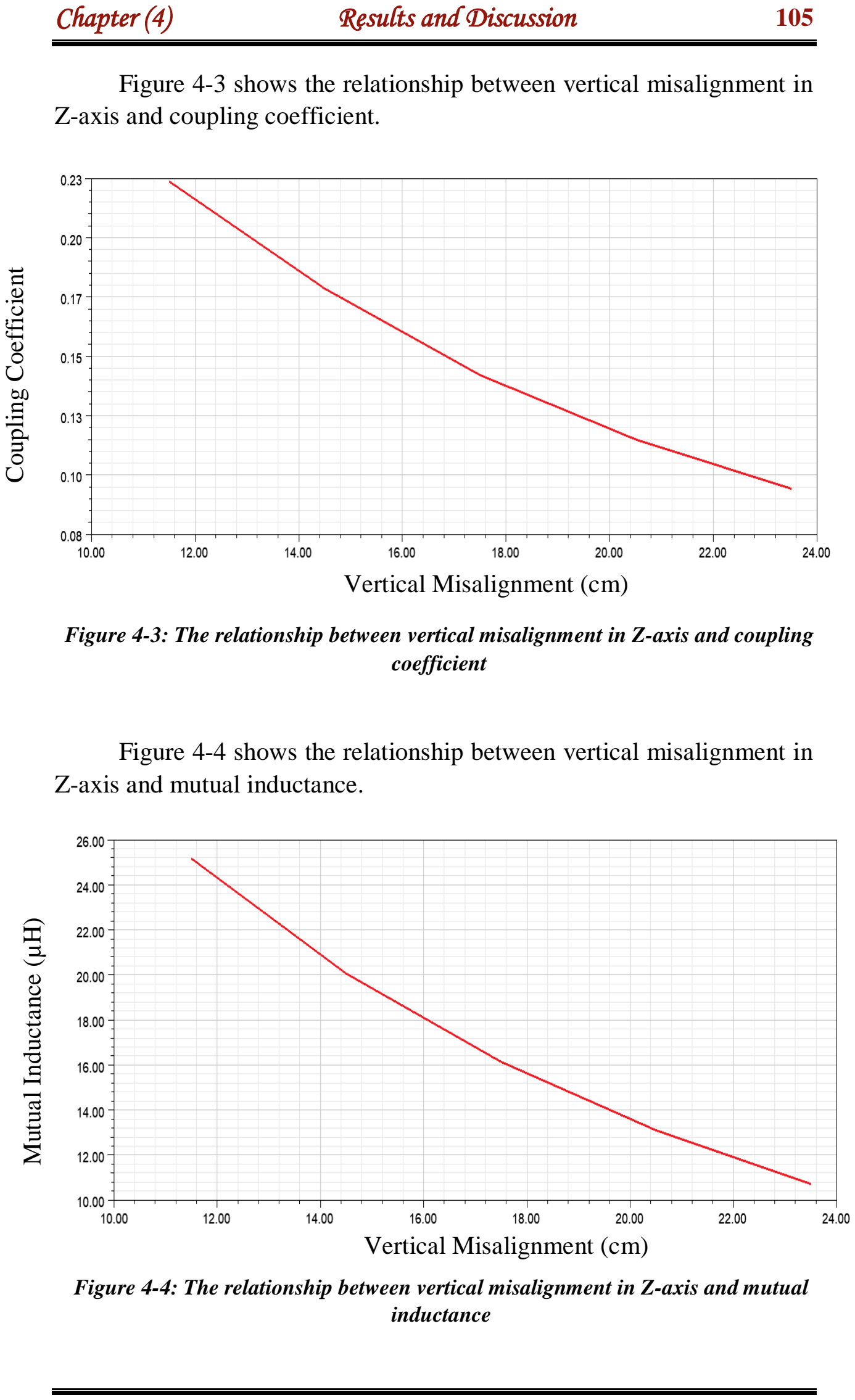
[picture p123: page 124]

Chapter (4) | Results and Discussion | 105

Figure 4-3 shows the relationship between vertical misalignment in Z-axis and coupling coefficient.

Figure 4-4 shows the relationship between vertical misalignment in Z-axis and mutual inductance.

Vertical Misalignment (cm)

Mutual Inductance (µH)

Figure 4-4: The relationship between vertical misalignment in Z-axis and mutual inductance

Vertical Misalignment (cm)

Coupling Coefficient

Figure 4-3: The relationship between vertical misalignment in Z-axis and coupling coefficient

Chapter (4) | Results and Discussion | 106

Figure 4-5 shows the relationship between horizontal misalignment in X-axis, vertical misalignment in Z-axis and coupling coefficient.

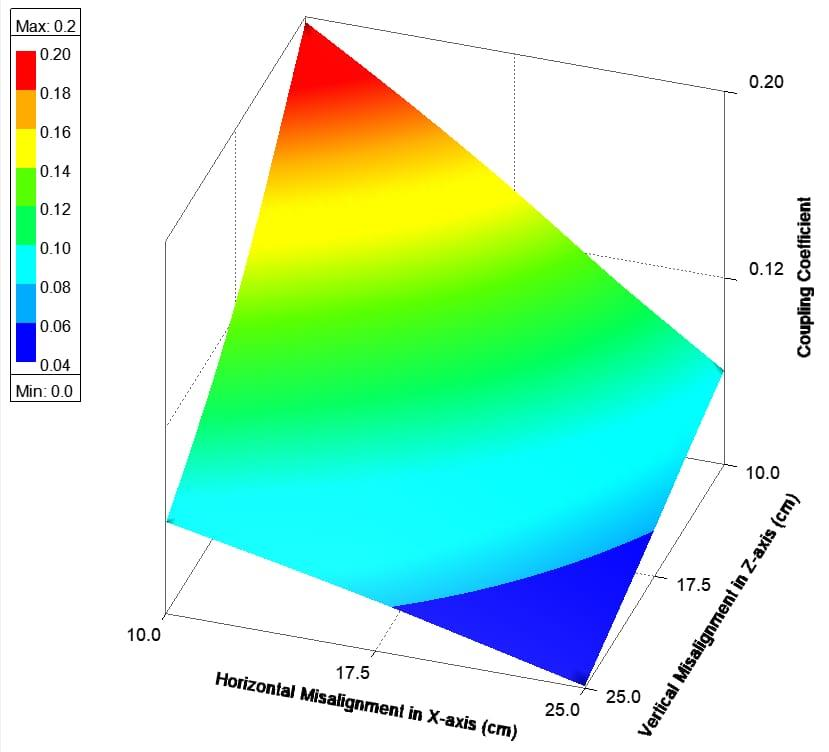
[picture p124: figure]

Figure 4-5: The relationship between horizontal misalignment in X-axis, vertical misalignment in Z-axis and coupling coefficient

Chapter (4) | Results and Discussion | 107

Figure 4-6 shows the relationship between horizontal misalignment in X-axis, vertical misalignment in Z-axis and mutual inductance.

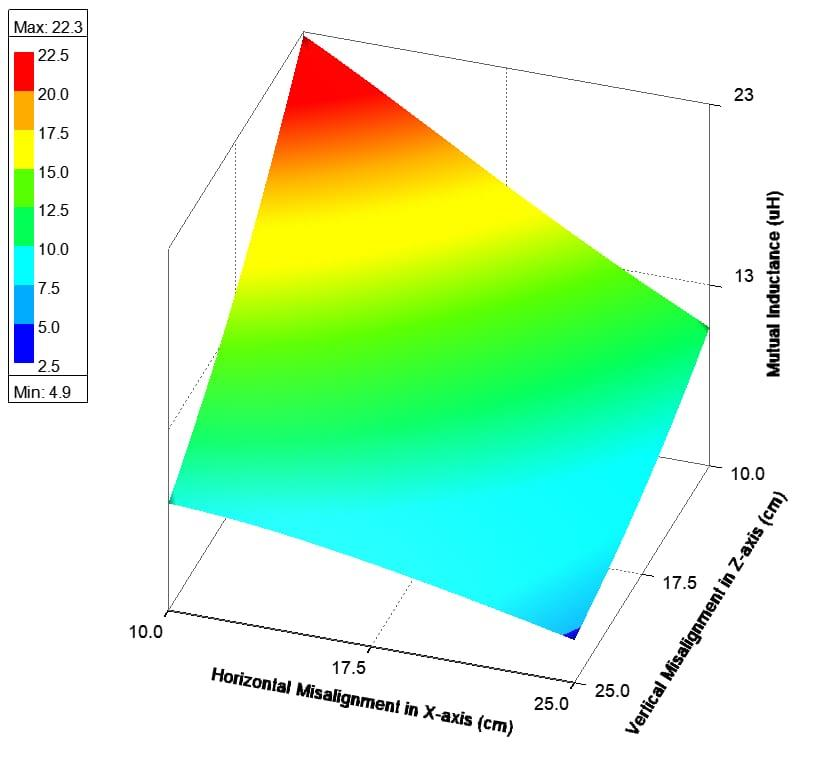
[picture p125: figure]

Figure 4-6: The relationship between horizontal misalignment in X-axis, vertical misalignment in Z-axis and mutual inductance

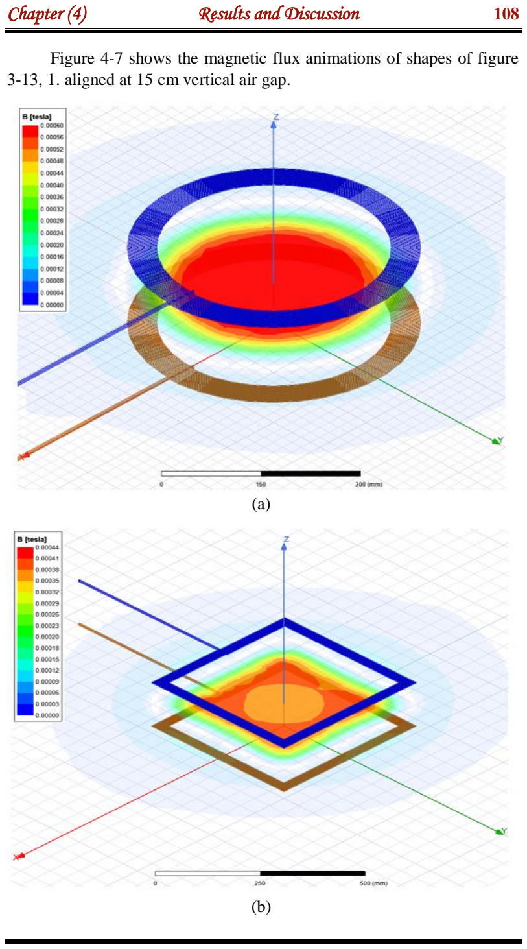
[picture p126: page 127]

Chapter (4) | Results and Discussion | 108

Figure 4-7 shows the magnetic flux animations of shapes of figure 3-13, 1. aligned at 15 cm vertical air gap.

(a)

(b)

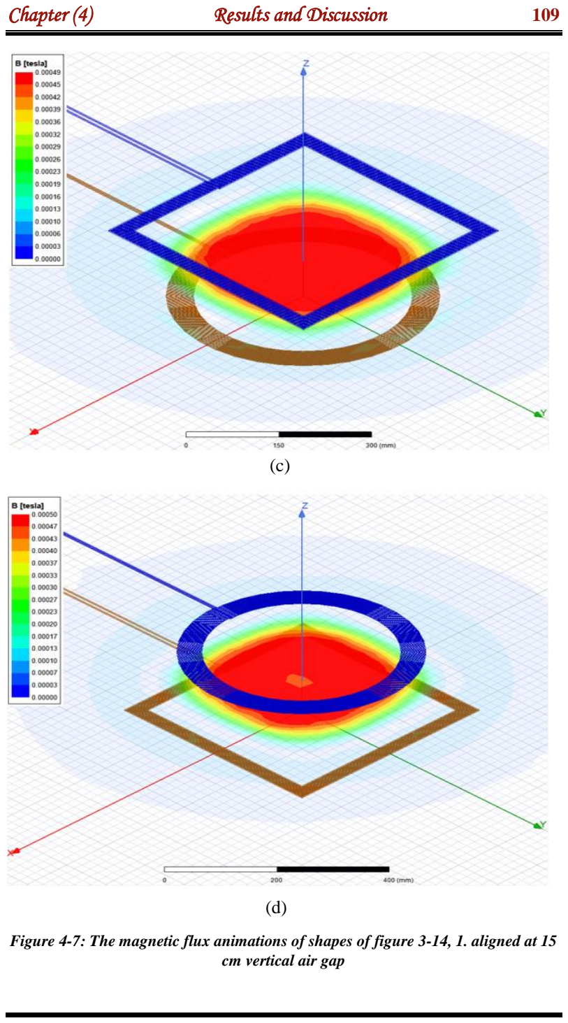
[picture p127: page 128]

Chapter (4) | Results and Discussion | 109

Figure 4-7: The magnetic flux animations of shapes of figure 3-14, 1. aligned at 15 cm vertical air gap

(c)

(d)

Chapter (4) | Results and Discussion | 110

Figure 4-8 shows the magnetic flux animations of shapes of figure 3-13, 2. horizontal misalignment of 15 cm in X-axis.

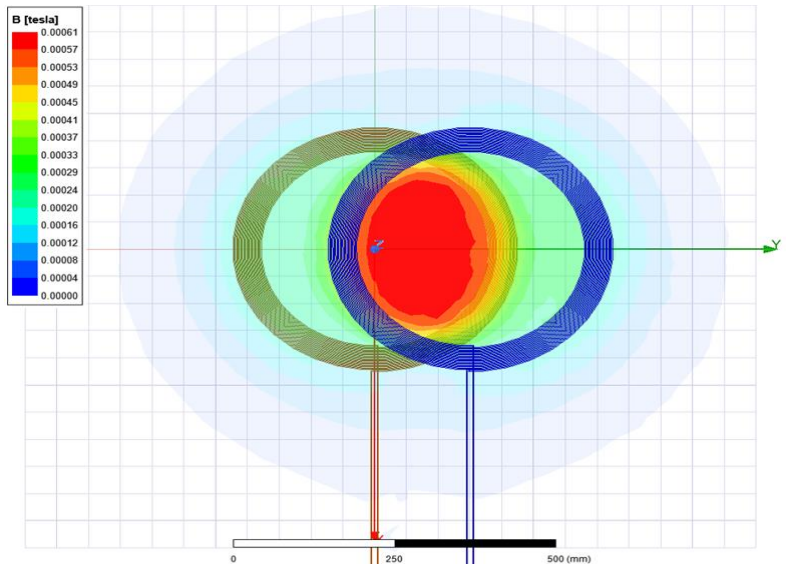
[picture p128: figure]

(a)

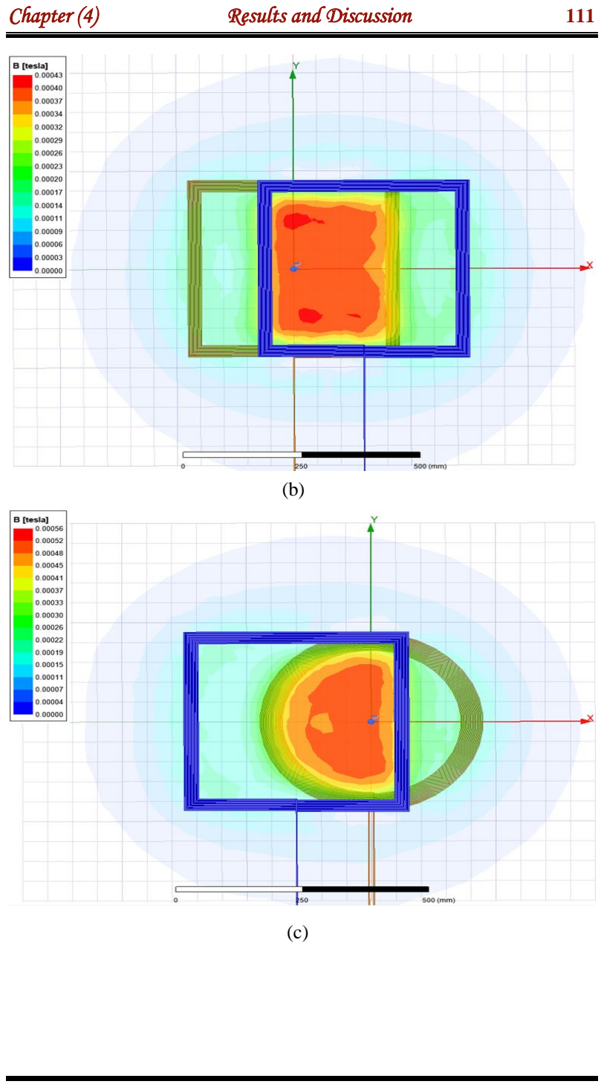
[picture p129: page 130]

Chapter (4) | Results and Discussion | 111

(b)

(c)

Chapter (4) | Results and Discussion | 112

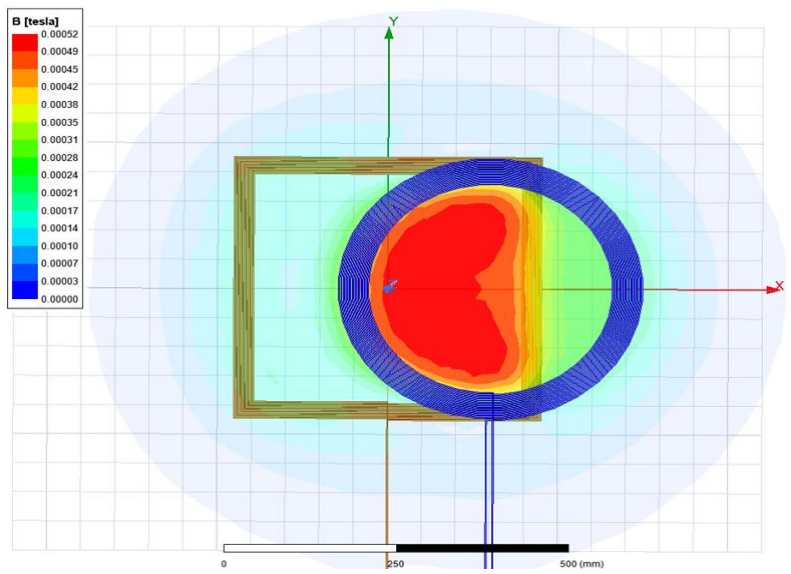
[picture p130: figure]

Figure 4-8: The magnetic flux animations of shapes of figure 3-14, 2. horizontal misalignment of 15 cm in X-axis

(d)

Chapter (4) | Results and Discussion | 113

Figure 4-9 shows the magnetic flux animation of the WPT design using ferrite.

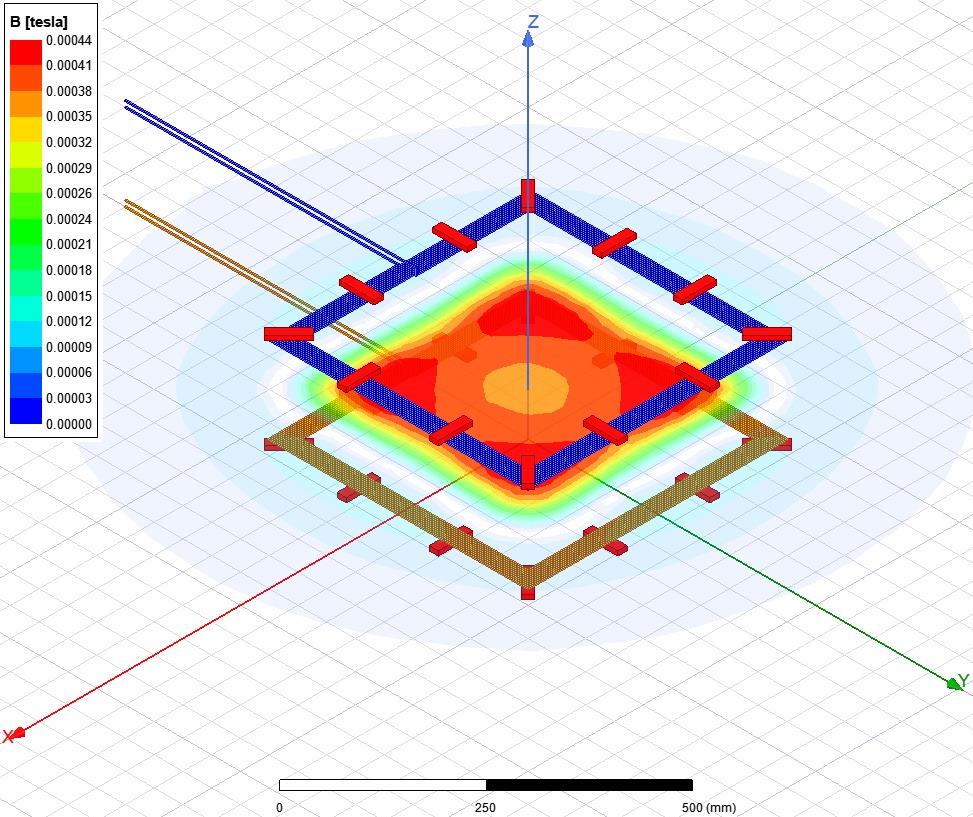
[picture p131: figure]

Figure 4-9: The magnetic flux animation of the WPT design using ferrite

Chapter (4) | Results and Discussion | 114

Figure 4-10 shows the results of m-file for calculating the half of side lengths of both coils.

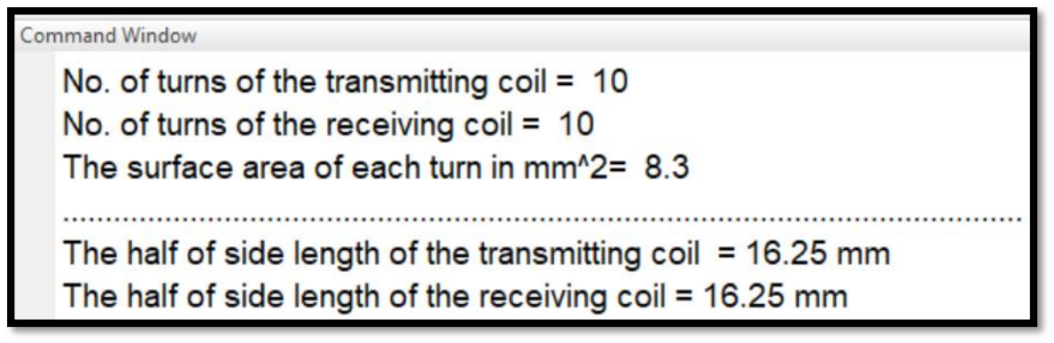
[picture p132: figure]

Figure 4-10: The results of m-file for calculating the half of side lengths of both coils

Figure 4-11 shows the results of m-file for calculating the DC resistances of both coils.

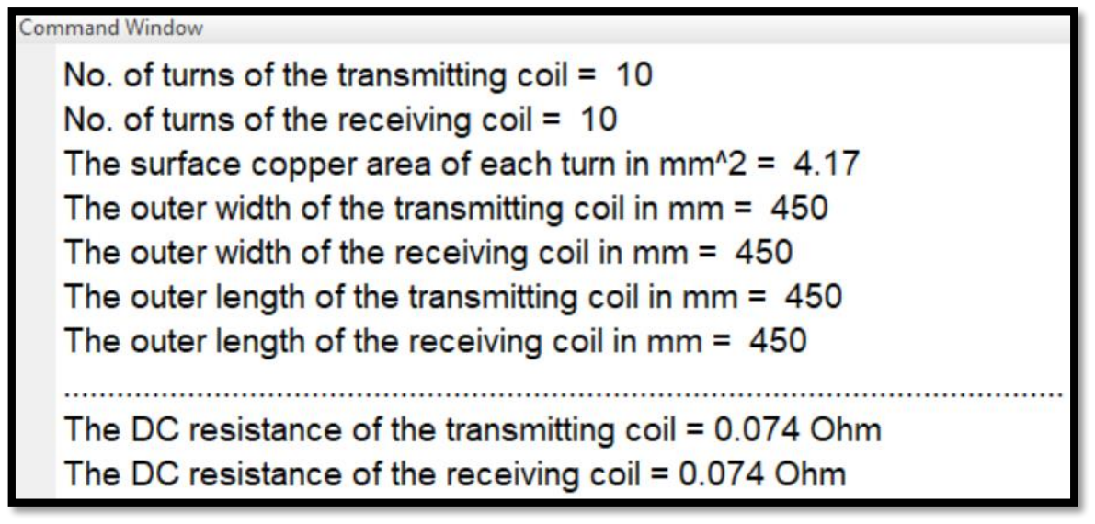
[picture p133: figure]

Figure 4-11: The results of m-file for calculating the DC resistances of both coils

Chapter (4) | Results and Discussion | 115

Figure 4-12 shows the results of m-file for calculating the self-inductances of both coils without using ferrite.

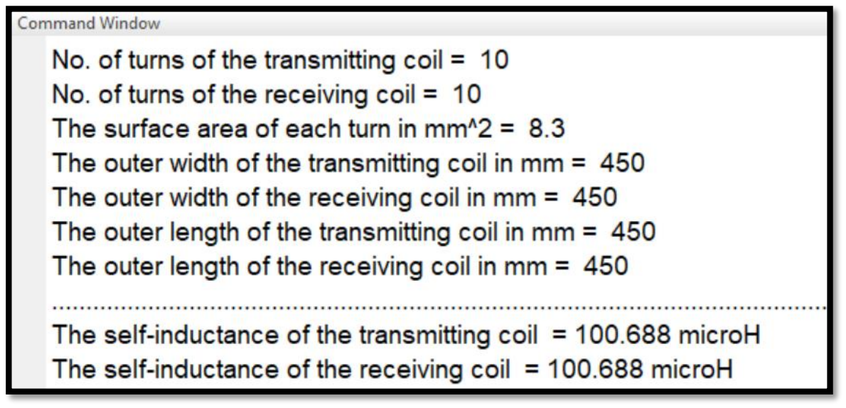
[picture p134: figure]

Figure 4-12: The results of m-file for calculating the self-inductances of both coils without using ferrite

Figure 4-13 shows the results of m-file for calculating the mutual inductance between both coils without using ferrite.

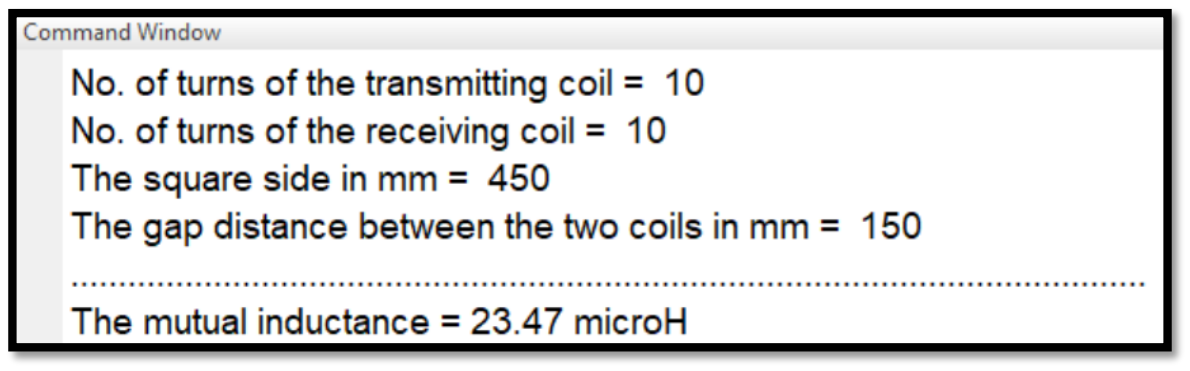
[picture p135: figure]

Figure 4-13: The results of m-file for calculating the mutual inductance between both coils without using ferrite

Chapter (4) | Results and Discussion | 116

Figure 4-14 shows the results of m-file for calculating the coupling coefficient between both coils without using ferrite.

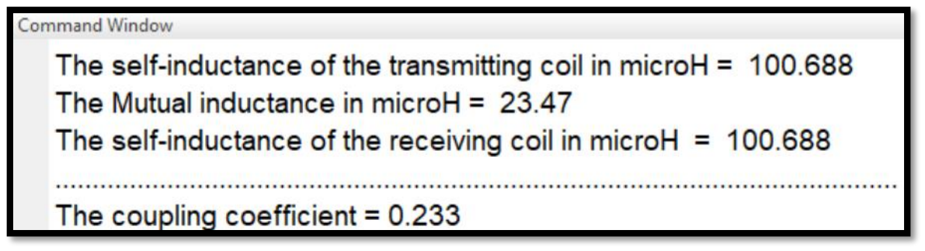
[picture p136: figure]

Figure 4-15 shows the results of m-file for calculating the capacitances of the transmitting and the receiving circuits without using ferrite.

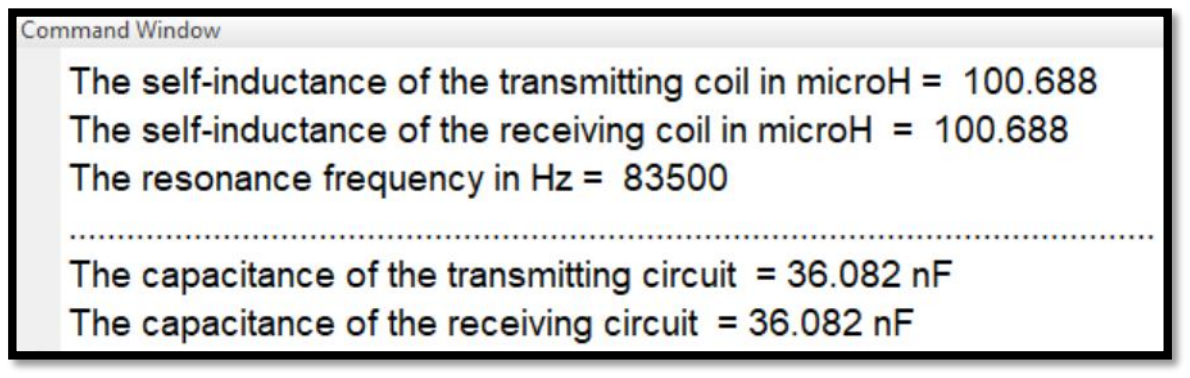
[picture p137: figure]

Figure 4-15: The results of m-file for calculating the capacitances of the transmitting and the receiving circuits without using ferrite

Figure 4-14: The results of m-file for calculating the coupling coefficient between both coils without using ferrite

Chapter (4) | Results and Discussion | 117

Figure 4-16 shows the results of m-file for calculating the RMS transmitting current with using ferrite.

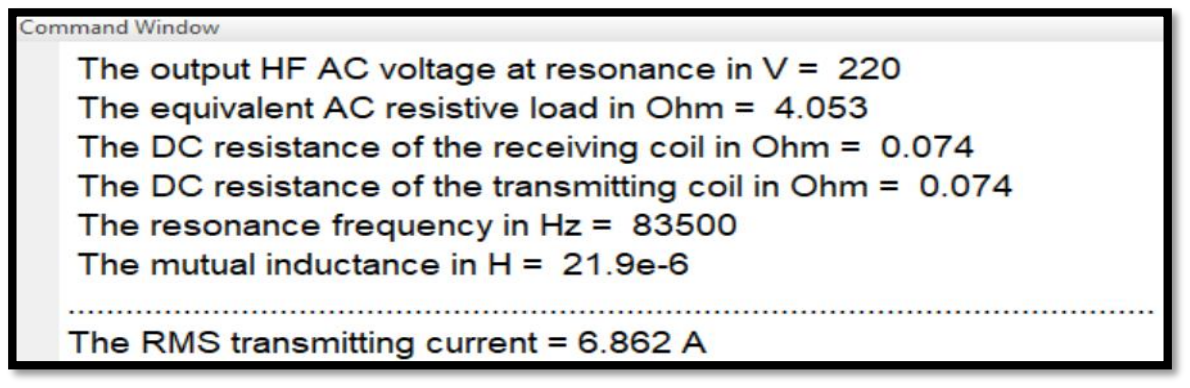
[picture p138: figure]

Figure 4-16: The results of m-file for calculating the RMS transmitting current with using ferrite

Figure 4-17 shows the results of m-file for calculating the RMS receiving current with using ferrite.

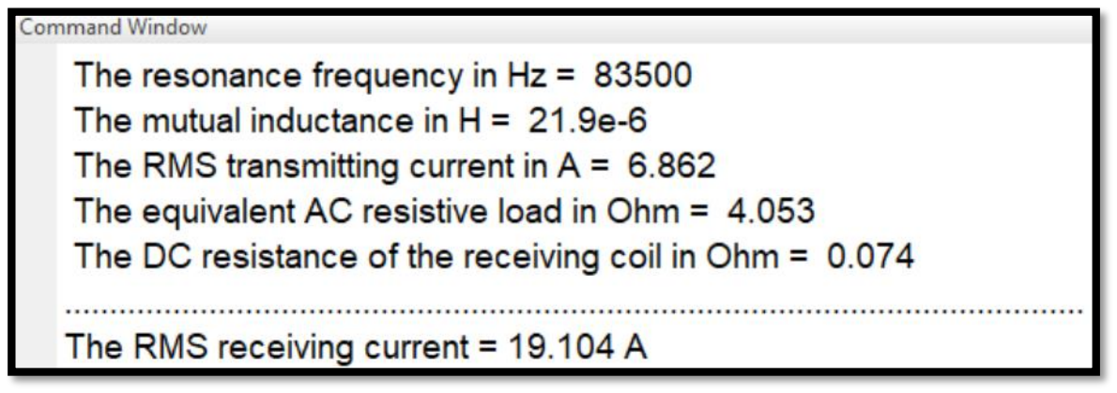
[picture p139: figure]

Figure 4-17: The results of m-file for calculating the RMS receiving current with using ferrite

Chapter (4) | Results and Discussion | 118

Figure 4-18 shows the results of m-file for calculating the RMS power delivered to the equivalent AC resistive load.

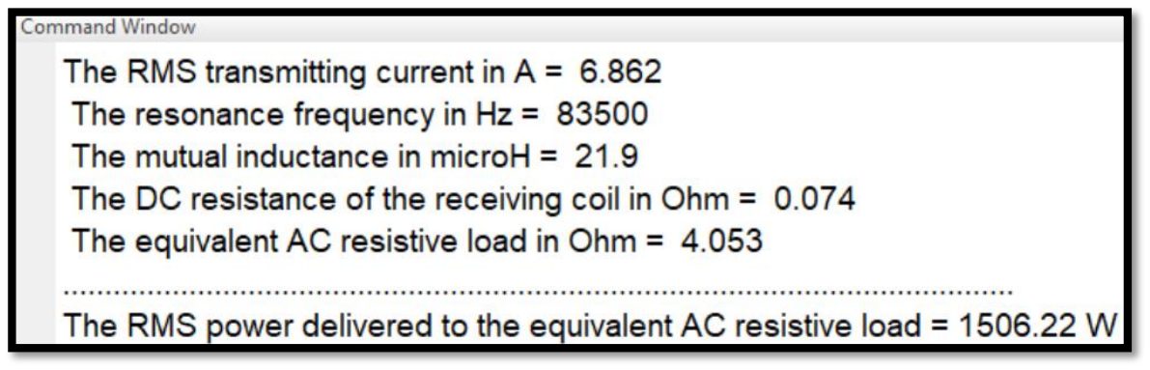
[picture p140: figure]

Figure 4-19 shows the results of m-file for calculating the efficiency while using the SS compensation.

Figure 4-18: The results of m-file for calculating the RMS power delivered to the equivalent AC resistive load

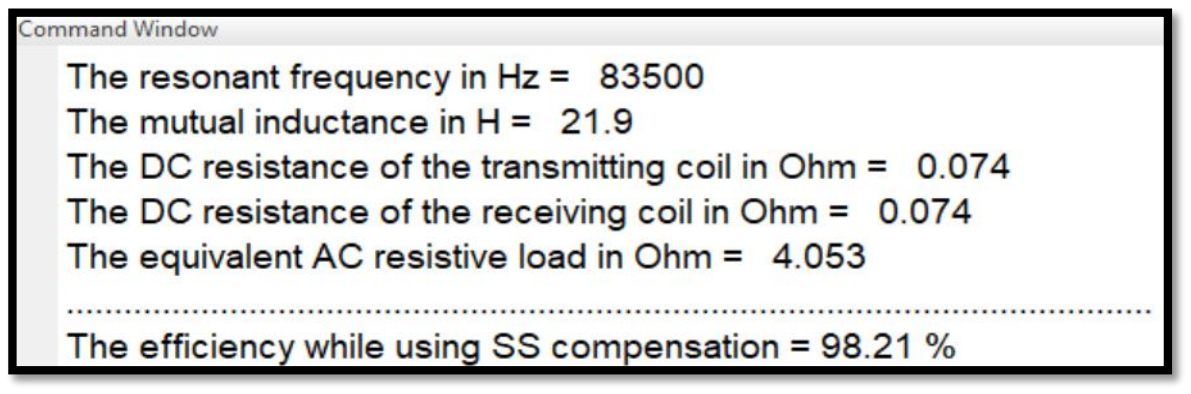
[picture p141: figure]

Figure 4-19: The results of m-file for calculating the efficiency while using the SS compensation

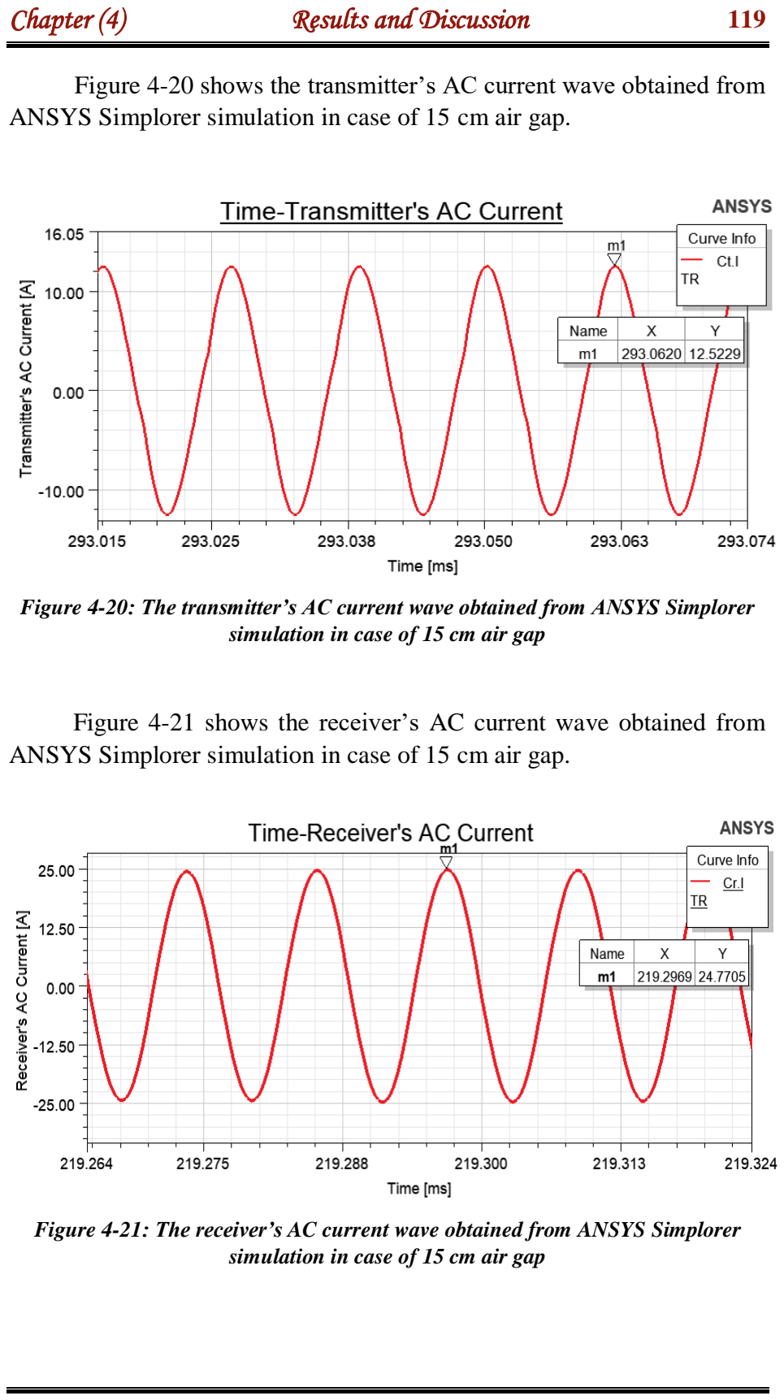
[picture p142: page 138]

Chapter (4) | Results and Discussion | 119

Figure 4-20 shows the transmitter’s AC current wave obtained from ANSYS Simplorer simulation in case of 15 cm air gap.

Figure 4-20: The transmitter’s AC current wave obtained from ANSYS Simplorer simulation in case of 15 cm air gap

Figure 4-21 shows the receiver’s AC current wave obtained from ANSYS Simplorer simulation in case of 15 cm air gap.

Figure 4-21: The receiver’s AC current wave obtained from ANSYS Simplorer simulation in case of 15 cm air gap

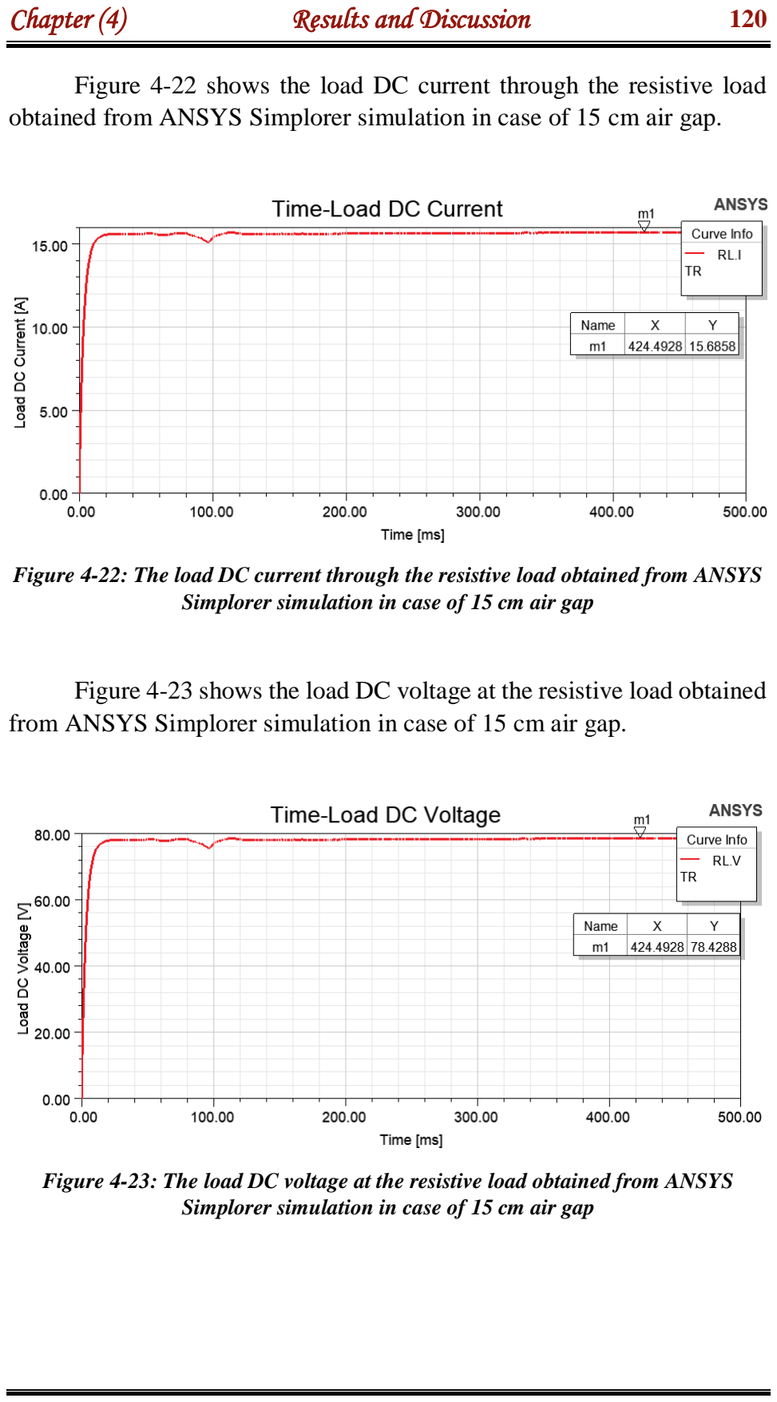
[picture p143: page 139]

Chapter (4) | Results and Discussion | 120

Figure 4-22 shows the load DC current through the resistive load obtained from ANSYS Simplorer simulation in case of 15 cm air gap.

Figure 4-22: The load DC current through the resistive load obtained from ANSYS Simplorer simulation in case of 15 cm air gap

Figure 4-23 shows the load DC voltage at the resistive load obtained from ANSYS Simplorer simulation in case of 15 cm air gap.

Figure 4-23: The load DC voltage at the resistive load obtained from ANSYS Simplorer simulation in case of 15 cm air gap

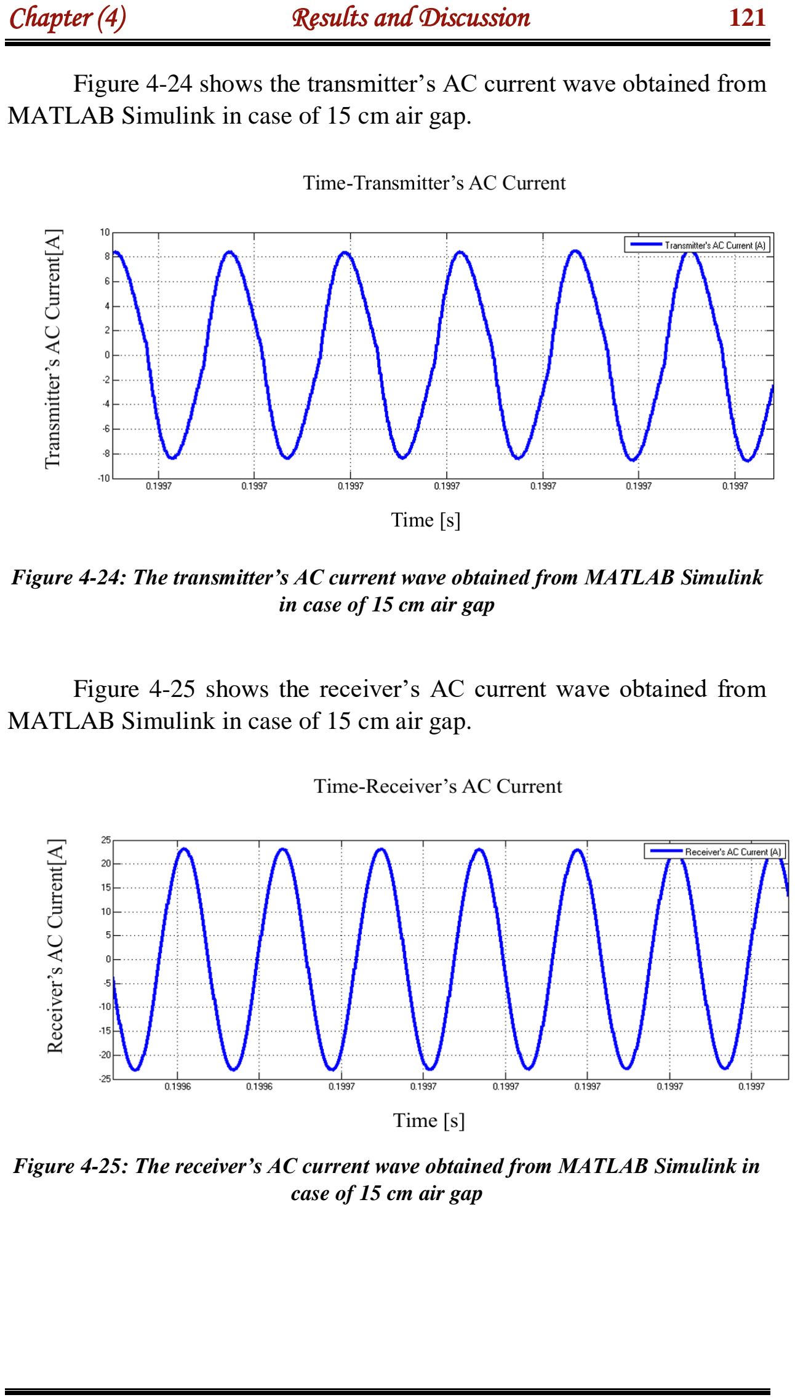
[picture p144: page 140]

Chapter (4) | Results and Discussion | 121

Figure 4-24 shows the transmitter’s AC current wave obtained from MATLAB Simulink in case of 15 cm air gap.

Figure 4-24: The transmitter’s AC current wave obtained from MATLAB Simulink in case of 15 cm air gap

Figure 4-25 shows the receiver’s AC current wave obtained from MATLAB Simulink in case of 15 cm air gap.

Figure 4-25: The receiver’s AC current wave obtained from MATLAB Simulink in case of 15 cm air gap

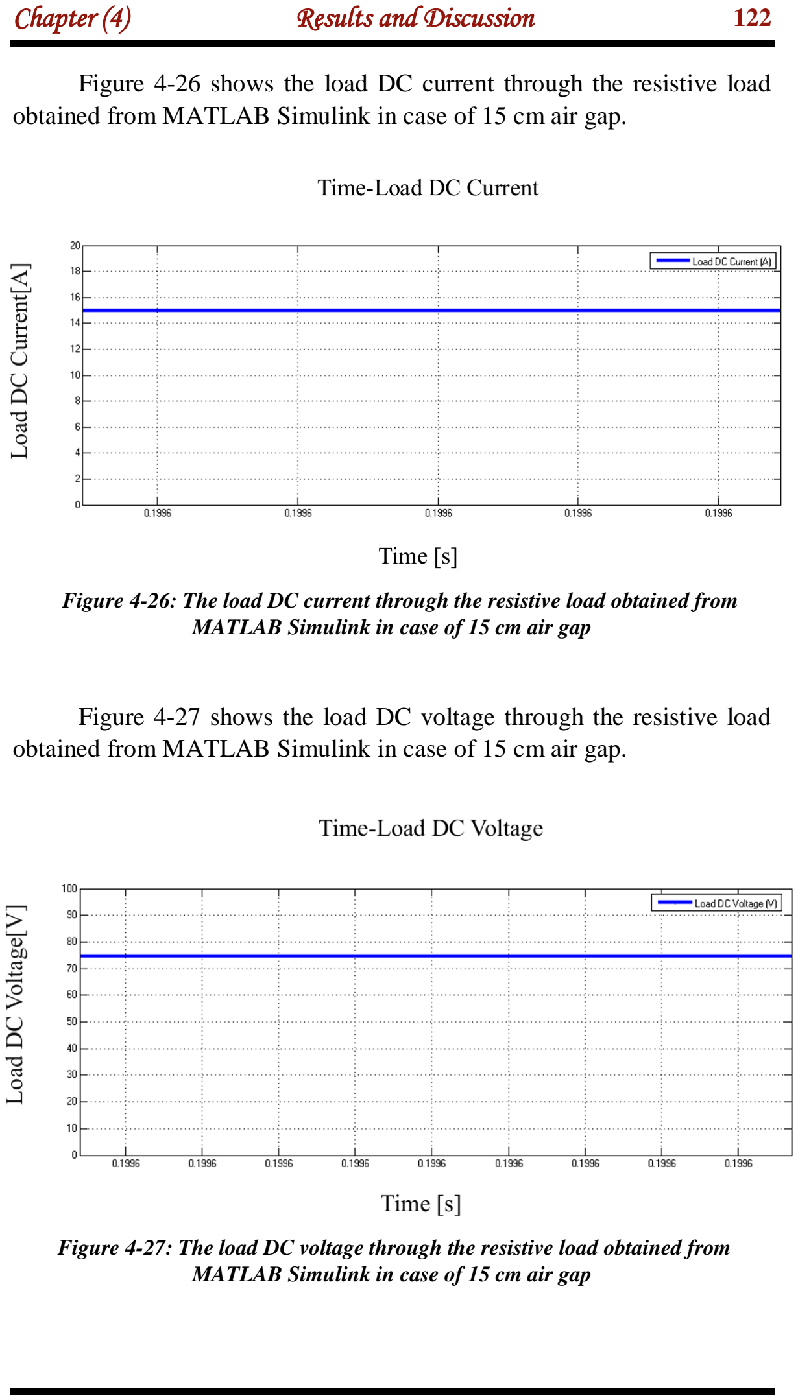
[picture p145: page 141]

Chapter (4) | Results and Discussion | 122

Figure 4-26 shows the load DC current through the resistive load obtained from MATLAB Simulink in case of 15 cm air gap.

Figure 4-26: The load DC current through the resistive load obtained from MATLAB Simulink in case of 15 cm air gap

Figure 4-27 shows the load DC voltage through the resistive load obtained from MATLAB Simulink in case of 15 cm air gap.

Figure 4-27: The load DC voltage through the resistive load obtained from MATLAB Simulink in case of 15 cm air gap

Chapter (4) | Results and Discussion | 123

Table 4-8: The comparison between the ANSYS Simplorer, MATLAB Simulink, calculated and practical values of the different electrical parameters

The different electrical parameters | Obtained value from ANSYS Simplorer | Obtained value from MATLAB Simulink | Calculated Value | Practical value
Transmitter’s RMS current | 8.855 A | 6.01 A | 7.935 A | ____
Receiver’s RMS current | 17.51 A | 16.79 A | 19.095 A | ____
The load DC voltage | 78.43 V | 75 V | ____ | 64.15
The load DC current | 15.68 A | 15 A | ____ | 12.83

All results obtained from ANSYS Simplorer are according to the

electrical circuit shown in Figure 3-5.

This electrical circuit starts with a square wave 83.5 KHz, 220 V

RMS (the RMS value for the square wave voltage source is same as the

peak value). This voltage source represents the output HF voltage from the

HFI.

The reason for not starting in ANSYS Simplorer with DC supply

feeds the MOSFETs, is that the solver time of ANSYS Simplorer while

using many electronic components is slow.

Other than the simulation done by MATLAB Simulink which

according to the electrical circuit shown in Figure 3-15 , the starting of the

circuit is the grid feeds the DC supply. This is due to the fast solver time

of MATLAB Simulink.

As we see, the results obtained from both programs are close

together.

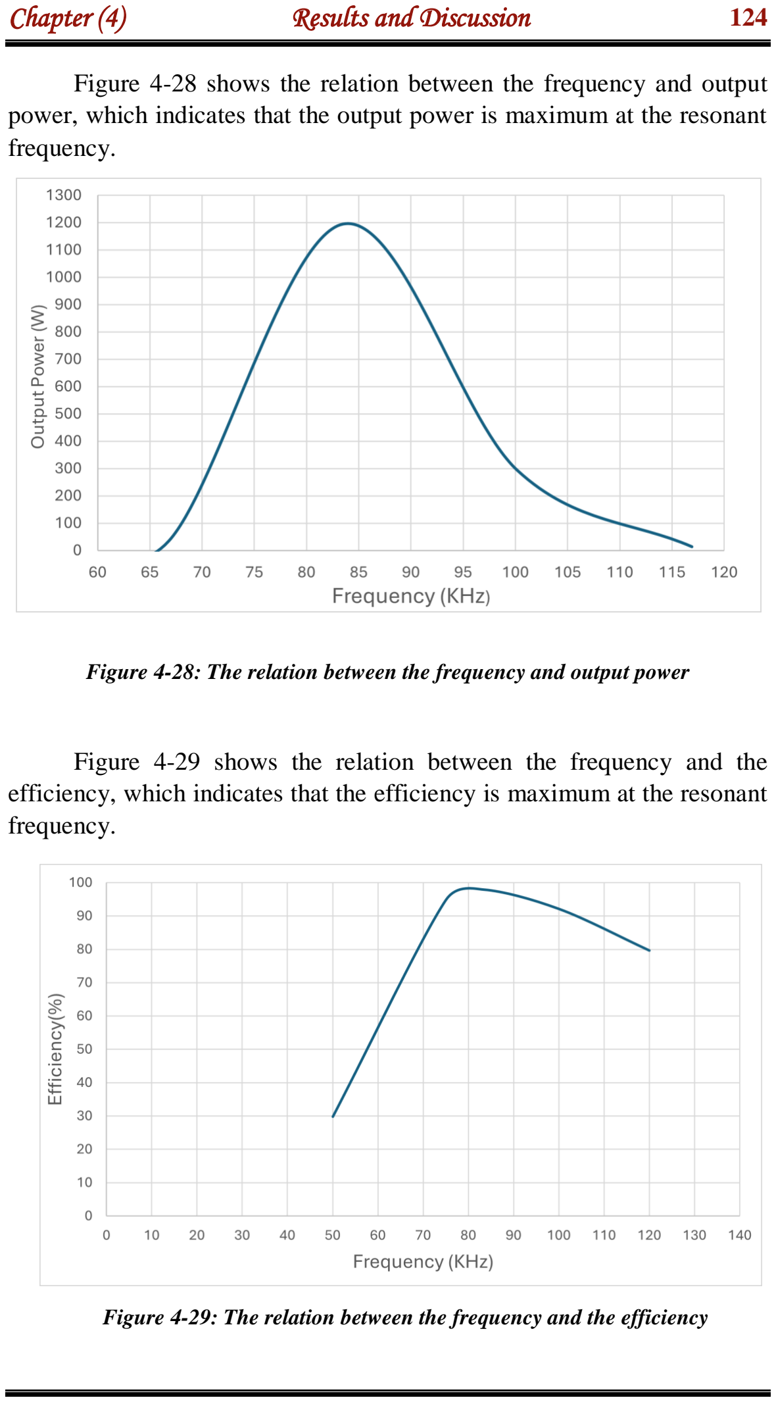
[picture p146: page 143]

Chapter (4) | Results and Discussion | 124

Figure 4-28 shows the relation between the frequency and output power, which indicates that the output power is maximum at the resonant frequency.

Figure 4-28: The relation between the frequency and output power

Figure 4-29 shows the relation between the frequency and the efficiency, which indicates that the efficiency is maximum at the resonant frequency.

Figure 4-29: The relation between the frequency and the efficiency

Chapter (4) | Results and Discussion | 125

The previous two relations are done for the system shown in Figure 4-9, with a 150 mm gap between both coils, with the output HF AC voltage of a 220 V.

There is only one resonant frequency in the X-axis of both previous figures, and each frequency of the other frequencies is not a resonant one.

Meaning that the capacitances of the SS compensation are kept constants for all frequencies, achieving only the resonant frequency of a 83.5 KHz.

The maximum output power and the maximum efficiency are obtained at this only resonant frequency.

Chapter (4) | Results and Discussion | 126

### 4.2 Practical results

Figure 4-30 shows the transmitter electrical box which includes the HFI and the series transmitter’s compensation.

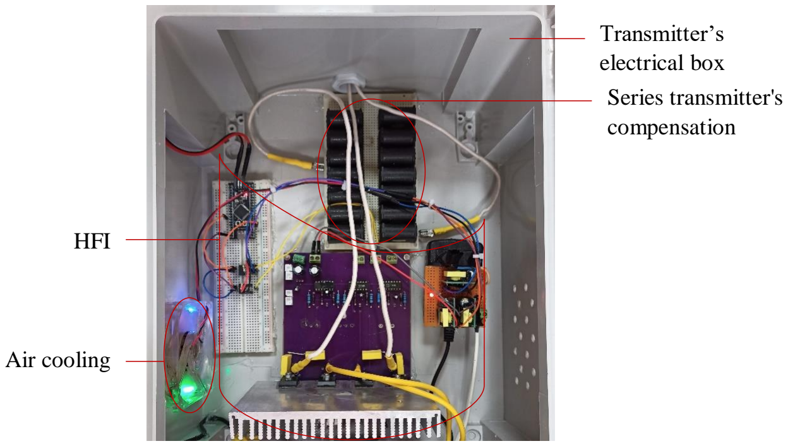
[picture p147: figure]
Air cooling; HFI; Series transmitter's compensation; Transmitter’s electrical box

Figure 4-30: The transmitter electrical box which includes the HFI and the series transmitter’s compensation

Figure 4-31 shows the receiver electrical box which includes the series receiver’s compensation and the AC/DC converter.

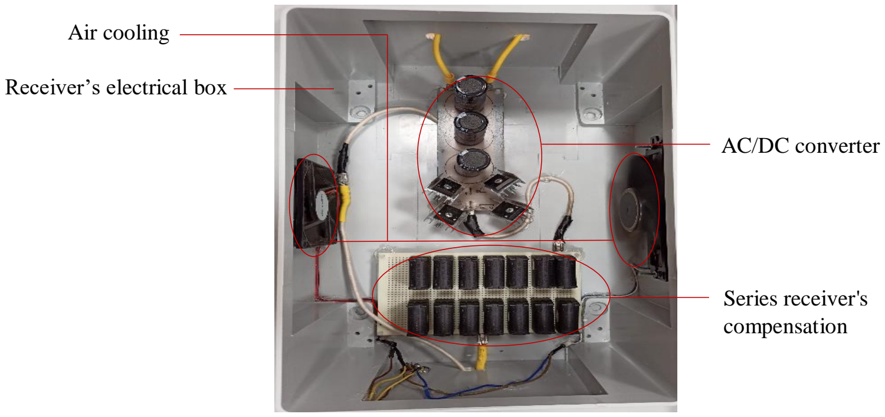
[picture p148: figure]
AC/DC converter; Series receiver's compensation; Receiver’s electrical box; Air cooling

Figure 4-31: The receiver electrical box which includes the series receiver’s compensation and the AC/DC converter

Chapter (4) | Results and Discussion | 127

Figure 4-32 shows the practical RIWPT system

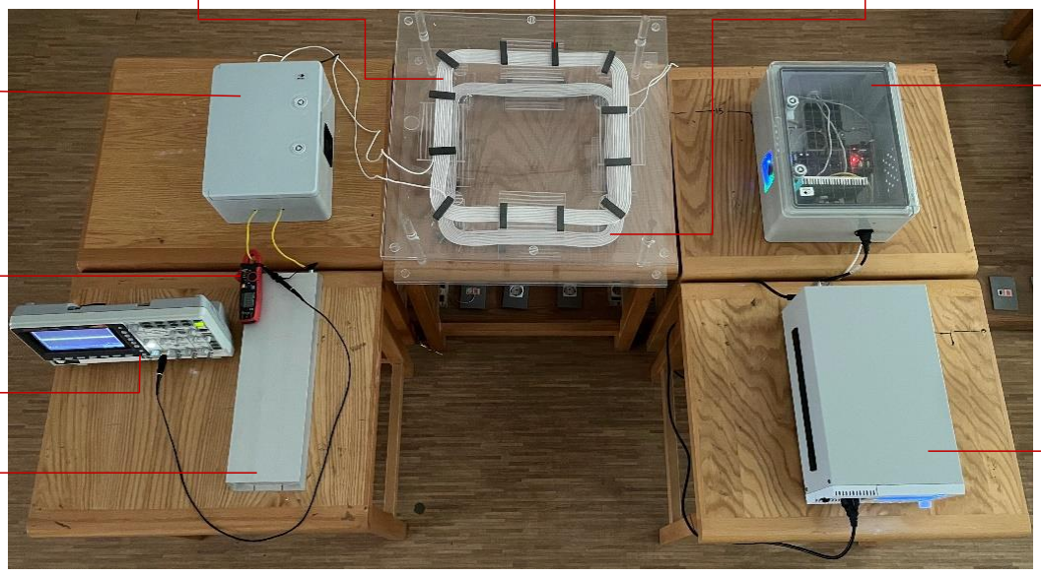
[picture p149: figure]

Figure 4-33 shows the reading of the DC voltage through the load by a laboratory scope.

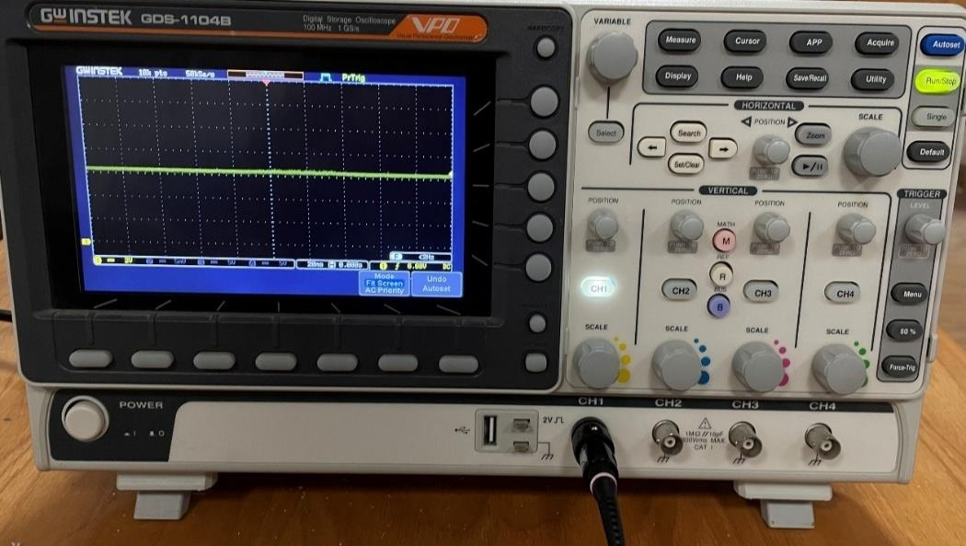
[picture p150: figure]

The attenuator in an oscilloscope is set to 10x and the amplitude of the input signal is reduced to 1/10th of its original value, The voltage per division in oscilloscope is set to 2V/div and the oscilloscope reads approximately 6.415V, So the original input signal is about 64.15V.

DC supply

HFI with series
transmitter's
compensation

Clamp meter

Receiving coil | PC40 Mn-Zn ferrite | Transmitting coil

Series receiver's
compensation with
AC/DC converter

Figure 4-32: The practical RIWPT system

Figure 4-33: The reading of the DC voltage through the load by a laboratory scope

Chapter (4) | Results and Discussion | 128

Figure 4-34 shows the reading of the DC current through the load by a laboratory clamp meter.

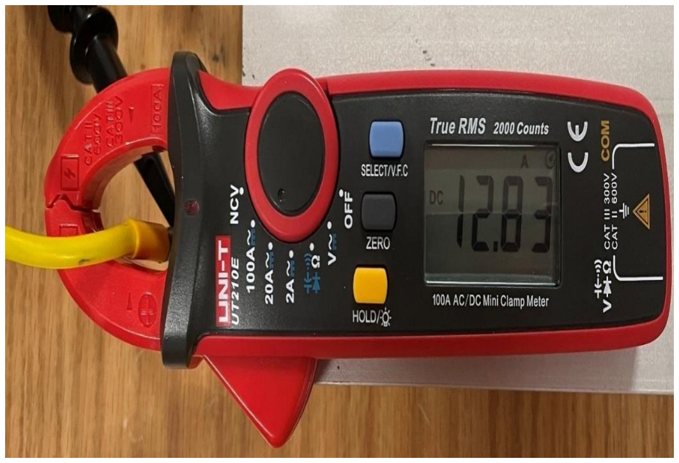
[picture p151: figure]

Figure 4-34: The reading of the DC current through the load by a laboratory clamp meter

Chapter (4) | Results and Discussion | 129

Table 4-9: Designed parameters of the practical system

Symbol/ Abbreviation | Parameter | Value
Vin | Input RMS supply voltage | 187.1 V
Iin | Input RMS supply current | 5.74 A
sin | Input apparent power | 1074 VA
Q | Input reactive power | 166 Var in
Pin | Input active power | 1061 W
PF | Power factor | 0.99
CF | Crest factor | 1.33
VDC | DC output voltage from the DC supply (Input DC voltage to HFI) | 220 V
u | The square side length of each coil | 450 mm
T | No. of turns of the transmitting coil | 10 turns t
T | No. of turns of the receiving coil | 10 turns r
Si | without the insulation | 4.17 mm² Surface copper area of each turn,
So | the insulation | 8.3 mm² Surface area of each turn, considering
h | The gap distance between the two coils | 15 cm
Lt | The self-inductance of the transmitting coil | 116.7 µH
Lr | The self-inductance of the receiving coil | 117.13 µH
M | The mutual inductance | 20 µH
K | The coupling coefficient | 0.171
f | The resonant frequency | 83500 Hz
Ct | The capacitance of the receiving circuit | 29.555 nF
Cr | The capacitance of the transmitting circuit | 29.47 nF
CF | The filtering capacitance before the load | 660 µF
RL | The DC resistive load | 5 Ω
VL | Output load DC voltage | 64.15 V
IL | Output load DC current | 12.83 A
PL | Output load DC power | 823 W
ηs-s | Practical efficiency | 77.5 %

Chapter (4) | Results and Discussion | 130

The power supply has a step-down transformer which converts the

grid 220V RMS to 187.1 V RMS. The RMS input current taken by the

power supply from the grid is 5.74 A. The input apparent power is 187.1V

multiplied by 5.74 A, which equals 1074 VA.

The power supply readings show that there is a small value of the

reactive power drawn by the proposed system, which equals 166 VAr. The

input active power is 1061 W, so the input power factor equals the input

active power divided by the input apparent power, which equals to 0.99

approximately.

The measured Crest Factor of 1.33, instead of the ideal 1.414 for a

pure sine wave, indicates that the output waveform of the power supply is

not a perfect sinusoidal signal. This deviation can be due to several reasons:

most laboratory power supplies produce a filtered or modified output

waveform. As a result, the waveform has lower peak values which reduces

the Crest Factor. Additionally, waveform distortion caused by internal

filtering circuits or the power supply design itself can also lead to a lower

Crest Factor.

The RMS 187.1 V is converted by the power supply into a DC 220

V, which is the input to the HFI.

The power pads were square shaped coils, which have a 450 mm

square side and a 150 mm as an air gap distance between them. Each coil

was covered by a 12 piece of PC40 Mn-Zn ferrite for improving the

coupling coefficient.

Chapter (4) | Results and Discussion | 131

The self-inductances of both coils were measured by the LCR meter.

The SS compensation is designed so that a resonant frequency of an 83.5

KHz was achieved, and the capacitances of a SS compensation were

measured by LCR meter.

The output load DC voltage measured by the laboratory scope is

64.15 V which is relatively different from values obtained from

simulations, and this is because that the magnetic and switching losses

were not considered in the simulations. The output load DC current

measured by a clamp meter device is 12.83 A.

The output load DC power is the output load DC voltage multiplied

by the output load DC current, or it is the square of the output load DC

voltage divided by the value of the resistive load (5 Ω), or it is the square

of the output load DC current multiplied by the value of the resistive load

(5 Ω). The output load DC power calculated by any previous method equals

823 W.

By dividing the output load DC power by the input active power, we

can calculate the practical efficiency which equals to 77.5%, a difference

arises between the efficiency values obtained from the practical and those

calculated using the MATLAB code because of a certain factors such as

magnetic and switching losses were not accounted for in the MATLAB

code by which the efficiency was 98.21%.

Chapter (5) | Conclusion | 132
| 5 Chapter (5): Conclusion

### 5.1 Overview

The project presented an 823 W RIWPT system using SS

compensation and square coupling coils. The SS compensation topology

was chosen due to its several advantages, including the ability to size the

capacitors during the design independently of load or coupling variations,

stable voltage source characteristics and built-in short-circuit protection. A

resonant frequency of 83.5 kHz was selected for the system's operation.

The system parameters were computed using a MATLAB script,

based on the winding dimensions and the selected SS compensation

scheme. Using the calculated parameters, the RIWPT system model was

developed in ANSYS Maxwell 3D and integrated with ANSYS Simplorer.

The square inductive coils were designed using ANSYS Maxwell 3D

electromagnetic simulation software, which enables detailed analysis of the

magnetic field distribution.

Simulation results indicate that the magnetic field strength and

consequently, power transfer efficiency are maximized when the vertical

distance between the transmitter and receiver coils is minimized. Using

Litz wire significantly enhances efficiency by minimizing coil resistance.

Two key parameters influencing the efficiency of a WPT system are the

coupling coefficient and the mutual inductance between the coils, which

are highly dependent on the relative positioning of the coils. Any vertical

misalignment between the transmitting and receiving coils reduces both the

coupling coefficient and the mutual inductance, resulting in a decrease in

power transfer efficiency.

Chapter (5) | Conclusion | 133

The efficiency of the proposed system under ideal operating

conditions was found to be 77.5%. However, certain factors, such as

magnetic and switching losses, were not considered in the MATLAB code,

which yielded a theoretical efficiency of 98.21%. This discrepancy

highlights the difference between the practical efficiency values and those

calculated using the MATLAB code.

### 5.2 Challenges

The proposed prototype faces several limitations, including high

implementation costs, constraints related to weight and size of electronic

components, susceptibility to magnetic interference, sensitivity to

temperature variations, a limited operating range, potential safety concerns,

and relatively low power transfer efficiency.

Chapter (6) | References | 134
| 6 Chapter (6): References

[1]Viqar, S., Ahmad, A., Kirmani, S., Rafat, Y., Hussan, M. R., & Alam,
M. S. (2024). Modelling, simulation and hardware analysis of misalignment and compensation topologies of wireless power transfer for electric vehicle charging application. Sustainable Energy Grids and Networks, 38, 101285.
https://doi.org/10.1016/j.segan.2024.101285.

[2]Latha, B., Irfan, M. M., Flah, A., Blazek, V., Prokop, L., & Rangarajan,
S. S. (2024). Advances in EV wireless Charging Technology – A Systematic review and future trends. e-Prime - Advances in Electrical
Engineering | | Electronics | and | Energy, | 100765.
https://doi.org/10.1016/j.prime.2024.100765.

[3]Sun, G., Yang, Y., Zhang, J., Cao, Y., Tan, X., & Pei, J. (2021). Modeling and optimization of pavement scale-model for magnetically coupled resonant in wireless power transmission systems. Construction
and | Building | Materials, | 319, | 126066.
https://doi.org/10.1016/j.conbuildmat.2021.126066.

[4]Elymany, M. M., Mohamed, A. a. S., Shaier, A. A., Enany, M. A., Metwally, H., & Selem, S. I. (2024). Misalignment analysis of WPT level 3/Z2-class of CirPT with DDPR and CirPR for EVs stationary charging. Scientific Reports, 14(1). https://doi.org/10.1038/s41598-024-76381-2.

[5]Mohamed, N., Aymen, F., Alharbi, T. E. A., El-Bayeh, C. Z., Lassaad, S., Ghoneim, S. S. M., & Eicker, U. (2022). A comprehensive analysis of wireless charging systems for electric vehicles. IEEE Access, 10, 43865–43881.
https://doi.org/10.1109/access.2022.3168727.

[6]Panchal, C., Stegen, S., & Lu, J. (2018). Review of static and dynamic wireless electric vehicle charging system. Engineering Science and
Technology | an | International | Journal, | 21(5), | 922–937.
https://doi.org/10.1016/j.jestch.2018.06.015.

Chapter (6) | References | 135

[7]Yeole, D. S., & Thosar, A. G. (2024). Design and analysis of SS and SP compensation topologies for 500W WPT System. 2022 IEEE 7th International Conference for Convergence in Technology (I2CT). https://doi.org/10.1109/i2ct61223.2024.10544222.

[8]Mohamed, N., Aymen, F., Alqarni, M., Turky, R. A., Alamri, B., Ali,
Z. M., & Aleem, S. H. A. (2021). A new wireless charging system for electric vehicles using two receiver coils. Ain Shams Engineering Journal, 13(2), 101569.
https://doi.org/10.1016/j.asej.2021.08.012.

[9]Sagar, A., Bertoluzzo, M., & Kumar, A. (2023). Analysis and Comprehensive Comparison of Wireless Power Transfer System Using SS and SP topology for Electric Vehicle Charging. 2023 International
Conference | on | Computational | Intelligence, | Communication
Technology | and | Networking | (CICTN), | 235–240.
https://doi.org/10.1109/cictn57981.2023.10140761.
[10] Ranjan, A., Ghosh, P., Alset, U., & Mehta, H. (2022). Design and Development of a 3.2 kW Wireless Battery Charger for an Electric Vehicle with a High-Frequency Full-Bridge Converter using ANSYS Simplorer. 2022 International Virtual Conference on Power Engineering Computing and Control: Developments in Electric Vehicles and Energy Sector for Sustainable Future (PECCON), 1–4. https://doi.org/10.1109/peccon55017.2022.9851169.
[11] Issi, F. (2024). Modeling and implementation of a machine learning-based wireless charging system with high misalignment tolerance. Ain
Shams | Engineering | Journal, | 15(10), | 102970.
https://doi.org/10.1016/j.asej.2024.102970.
[12] Vinod, M., Kishan, D., Reddy, B. D., & Harischandrappa, N. (2024). Efficient and cost-effective wireless CC/CV charging for electric vehicles: A bipolar duty cycle approach. Computers & Electrical
Engineering, | 118, | 109470.
https://doi.org/10.1016/j.compeleceng.2024.109470.

Chapter (6) | References | 136
[13] Kuzey, S., Balci, S., & Altin, N. (2017). Design and analysis of a wireless power transfer system with alignment errors for electrical vehicle applications. International Journal of Hydrogen Energy, 42(28), 17928–17939.
https://doi.org/10.1016/j.ijhydene.2017.03.160.
[14] Erel, M. Z., Özdemir, M. A., & Aydemir, M. T. (2025). SOLAR ENERGY-POWERED WIRELESS CHARGING SYSTEM FOR THREE-WHEELED E-SCOOTER APPLICATIONS. Renewable Energy, 122933.
https://doi.org/10.1016/j.renene.2025.122933.
[15] Cirimele, V., Torchio, R., Villa, J. L., Freschi, F., Alotto, P., Codecasa, L., & Di Rienzo, L. (2020). Uncertainty quantification for SAE J2954 compliant static wireless charge components. IEEE Access, 8, 171489–171501.
https://doi.org/10.1109/access.2020.3025052.
[16] García-Izquierdo, O., Sanz, J., Villa, J., & Martin-Segura, G. (2024). Optimal design of an LCC-S WPT3 Z1 SAE J2954 compliant system, using NSGA-II with nested genetic algorithms for simultaneous local
optimization. | Applied | Energy, | 367, | 123369.
https://doi.org/10.1016/j.apenergy.2024.123369.
[17] Kodeeswaran, S., Fusic, S. J., Kannabhiran, A., Gayathri, M. N., & Padmanaban, S. (2024). Design of dual transmitter and single receiver coil to improve misalignment performance in inductive wireless power transfer system for electric vehicle charging applications. Results in Engineering,24, 103602.
https://doi.org/10.1016/j.rineng.2024.103602.
[18] Ramesh, P., Pongiannan, R., Demel, L., Hrbac, R., & Narayanamoorthi, R. (2025). Maximum efficiency and power point tracking system for hybrid compensated wireless charging of electric
vehicle. | Results | in | Engineering, | 104100.
https://doi.org/10.1016/j.rineng.2025.104100.

Chapter (6) | References | 137
[19] Del Toro García, X., Vázquez, J., & Roncero‐Sánchez, P. (2015). Design, implementation issues and performance of an inductive power transfer system for electric vehicle chargers with series–series
compensation. | IET | Power | Electronics, | 8(10), | 1920–1930.
https://doi.org/10.1049/iet-pel.2014.0877.
[20] G3R40MT12D | TO-247 | 1200V | 71A | SiC | MOSFET.
https://ar.aliexpress.com. [Online; accessed 8. May. 2025].
[21] Aluminum Heatsink | Makers Electronics. (2025, June 25). Makers
Electronics.
https://makerselectronics.com/product/aluminum-heatsink-10x10-20x10cm. (https://makerselectronics.com/product/aluminum-heatsink-10x10-20x10cm)
[22] PCB Prototype Board - VeRO Board FR-2 (Dotted & Line & Center Splitted & Breadboard) Makers Electronics. (2025, January 16). Makers Electronics.
https://makerselectronics.com/product/pcb-prototype-board-vero-board-fr-2-dotted-line-center-splitted-breadboard. (https://makerselectronics.com/product/pcb-prototype-board-vero-board-fr-2-dotted-line-center-splitted-breadboard)
[23] PCB for Inverter | Metanoia. (2024, June 21). Metanoia.
https://metanoia-eg.com/order-now/.
[24] STM32F401RCT6 - STM32 Development Board (The Black Pill) |
Makers | Electronics. | (2025, | April | 27). | Makers | Electronics.
https://makerselectronics.com/product/stm32f401rct6-stm32-development-board-the-black-pill. (https://makerselectronics.com/product/stm32f401rct6-stm32-development-board-the-black-pill)
[25] ST-LINK V2 Emulator and Debugger/Programmer for STM8 and
STM32 | Makers Electronics. (2025, April 27). Makers Electronics.
https://makerselectronics.com/product/st-link-v2-emulator-and-debuggerprogrammer-for-stm8-and-stm32. (https://makerselectronics.com/product/st-link-v2-emulator-and-debuggerprogrammer-for-stm8-and-stm32)

Chapter (6) | References | 138
[26] Adaptor (Adapter) Gas Heater Replacement Stone 3V 2A Black by YusufMarket: Buy Online at Best Price in Egypt - Souq is now Amazon.eg. (n.d.).
https://www.amazon.eg/-/en/Adaptor-Adapter-Heater-Replacement-YusufMarket/dp/B0DP5NVX8Q?sr=8-1. (https://www.amazon.eg/-/en/Adaptor-Adapter-Heater-Replacement-YusufMarket/dp/B0DP5NVX8Q?sr=8-1)
[27] IR2110 High side and Low side Gate Driver IC DIP-14. (2025, April 29). Makers Electronics.
https://makerselectronics.com/product/ir2110-high-side-and-low-side-gate. (https://makerselectronics.com/product/ir2110-high-side-and-low-side-gate)
[28] Diodes Fast Recovery Rectifier UF4007 1.7V@1A 75NS 1A 1KV
DO-41 | Makers Electronics. (2024, December 19). Makers Electronics.
https://makerselectronics.com/product/diodes-fast-recovery-rectifier-uf4007-1-7v1a-75ns-1a-1kv-do-41. (https://makerselectronics.com/product/diodes-fast-recovery-rectifier-uf4007-1-7v1a-75ns-1a-1kv-do-41)
[29] Carbon resistor 13Ω 0.25W through hole | Makers Electronics.
(2023, | October | 3). | Makers | Electronics.
https://makerselectronics.com/product/carbon-resistor-13%cf%89-0-25w-through-hole. (https://makerselectronics.com/product/carbon-resistor-13%cf%89-0-25w-through-hole)
[30] Capacitor 22UF 160V | Makers Electronics. (2024, December 31).
Makers Electronics.
https://makerselectronics.com/product/capacitor-22uf-160v.
[31] Capacitor 220NF 50V | Makers Electronics. (2024, October 4).
Makers Electronics.
https://makerselectronics.com/product/capacitor-220nf-50v.
[32] Capacitors Polypropylene Film 470NF 275VAC. (2025, July 1). Makers Electronics.
https://makerselectronics.com/product/capacitors-polypropylene-film-470nf-2. (https://makerselectronics.com/product/capacitors-polypropylene-film-470nf-2)
[33] Breadboard 830 point (Splitted Power Rails) | Makers Electronics.
(2025, | July | 3). | Makers | Electronics.
https://makerselectronics.com/product/breadboard-830-point-splitted-power-rails. (https://makerselectronics.com/product/breadboard-830-point-splitted-power-rails)

Chapter (6) | References | 139
[34] Carbon resistor 5.6kΩ 0.25W through hole | Makers Electronics.
(2025, | March | 5). | Makers | Electronics.
https://makerselectronics.com/product/carbon-resistor-5-6k%cf%89-0-25w-through-hole. (https://makerselectronics.com/product/carbon-resistor-5-6k%cf%89-0-25w-through-hole)
[35] 6N135 High Speed Optocoupler with Transistor Output DIP-8 |
Makers | Electronics. | (2025, | March | 1). | Makers | Electronics.
https://makerselectronics.com/product/6n135-high-speed-optocoupler-with-transistor-output-dip-8. (https://makerselectronics.com/product/6n135-high-speed-optocoupler-with-transistor-output-dip-8)
[36] AC-DC 220VAC to 12VDC 400MA 4.5W Converter Step down |
Makers | Electronics. | (2023, | July | 4). | Makers | Electronics.
https://makerselectronics.com/product/ac-dc-220vac-to-12vdc-400ma-4-5w-converter-step-down. (https://makerselectronics.com/product/ac-dc-220vac-to-12vdc-400ma-4-5w-converter-step-down)
[37] KF127-5.0-2P Green Terminal Block 300V/10A 2 pins 5mm pitch.
(2025, | June | 19). | Makers | Electronics.
https://makerselectronics.com/product/kf127-5-0-2p-green-terminal-block. (https://makerselectronics.com/product/kf127-5-0-2p-green-terminal-block)
[38] Red LED 5mm (Transparent) | Makers Electronics. (2025, January
7). Makers Electronics.
https://makerselectronics.com/product/red-led-5mm-trans.
[39] Jumper Wire 10 cm (Male To Male Pin) | Makers Electronics. (2024,
October | 18). | Makers | Electronics.
https://makerselectronics.com/product/jumper-wire-10-cm-male-to-male-pin. (https://makerselectronics.com/product/jumper-wire-10-cm-male-to-male-pin)
[40] High voltage resonance film capacitor for induction 0.33UF 1200V | Makers Electronics. (2024, September 14). Makers Electronics.
https://makerselectronics.com/product/high-voltage-resonance-film-capacitor-for-induction-0-33uf-1200v. (https://makerselectronics.com/product/high-voltage-resonance-film-capacitor-for-induction-0-33uf-1200v)

Chapter (6) | References | 140
[41] PCB Prototype Board – VERO Board FR-4 (Dotted & Line &
Center Splitted) | Makers Electronics. (2025, July 3). Makers
Electronics.
https://makerselectronics.com/product/pcb-prototype-board-vero-board-fr-4-dotted-line-center-splitted. (https://makerselectronics.com/product/pcb-prototype-board-vero-board-fr-4-dotted-line-center-splitted)
[42] Litz Wire 0.1*600 strands (20m).
https://ar.aliexpress.com . [Online; accessed 8. November. 2024].
[43] PC40 | Mn-Zn | Soft | Ferrite | core | 4 | pieces | 60*16*8.
https://ar.aliexpress.com . [Online; accessed 3. April. 2025].
[44] Capacitor 220μF 450V | Makers Electronics. (2025, May 27).
Makers Electronics.
https://makerselectronics.com/product/capacitor-220%ce%bcf-450v.
[45] DSEI60-10A Diode 1000 V 60A through hole TO-247AD. (2025,
June | 1). | Makers | Electronics.
https://makerselectronics.com/product/dsei60-10a-diode-1000-v-60a-to-247ad. (https://makerselectronics.com/product/dsei60-10a-diode-1000-v-60a-to-247ad)
[46] Secondary Rectifier PCB | Metanoia. (2024b, June 21). Metanoia.
https://metanoia-eg.com/order-now/.
[47] DC Fan 12V 0.22A (8x8cm) | Makers Electronics. (2025, January
23). Makers Electronics.
https://makerselectronics.com/product/dc-fan-12v-0-22a-8x8cm.
[48] AC Power Socket 3 Pin Male Plug connector 10A 250V with fuse
compartment | Makers Electronics. (2025, March 24). Makers
Electronics.
https://makerselectronics.com/product/ac-power-socket-3-pin-male-plug-connector-10a-250v-with-fuse-compartment. (https://makerselectronics.com/product/ac-power-socket-3-pin-male-plug-connector-10a-250v-with-fuse-compartment)
[49] Terminal PCB Male Flat 6.3mm | Makers Electronics. (2022,
November | | 26). | | Makers | | | Electronics.
https://makerselectronics.com/product/terminal-pcb-male-flat-6-3mm.

Chapter (7) | Appendices | 141
| 7 Chapter (7): Appendices

### 7.1 MATLAB m-file codes

Tt=input('No. of turns of the transmitting coil = ');

Tr=input('No. of turns of the receiving coil = ');

So=input('The surface area of each turn in mm^2= ');

[rt,rr]=HalfSide(Tt,Tr,So);

fprintf(' | \n');

fprintf('The half of side length of the transmitting coil = %0.2f mm\n',rt);

fprintf('The half of side length of the receiving coil = %0.2f mm\n',rr);

ـــــــــــــــــــــــــــــــــــــــــــــــــــــــــــــــــــــــــــــــــــــــــــــــــــــــــــــــــــــــــــــــــــــــــــــــ

Tt=input('No. of turns of the transmitting coil = ');

Tr=input('No. of turns of the receiving coil = ');

Si=input('The surface copper area of each turn in mm^2 = ');

wt=input('The outer width of the transmitting coil in mm = ');

wr=input('The outer width of the receiving coil in mm = ');

lt=input('The outer length of the transmitting coil in mm = ');

lr=input('The outer length of the receiving coil in mm = ');

[Rt,Rr]=Resistance(Tt,Tr,Si,wt,wr,lt,lr);

fprintf(' | \n');

fprintf('The DC resistance of the transmitting coil = %0.3f Ohm\n',Rt);

fprintf('The DC resistance of the receiving coil = %0.3f Ohm\n',Rr);

Chapter (7) | Appendices | 142

Tt=input('No. of turns of the transmitting coil = ');

Tr=input('No. of turns of the receiving coil = ');

So=input('The surface area of each turn in mm^2 = ');

wt=input('The outer width of the transmitting coil in mm = ');

wr=input('The outer width of the receiving coil in mm = ');

lt=input('The outer length of the transmitting coil in mm = ');

lr=input('The outer length of the receiving coil in mm = ');

[rt,rr]=HalfSide(Tt,Tr,So);

[Lt,Lr]=Self(Tt,Tr,rt,rr,wt,wr,lt,lr);

fprintf(' | \n');

fprintf('The self-inductance of the transmitting coil = %0.3f microH\n',Lt);

fprintf('The self-inductance of the receiving coil = %0.3f microH\n',Lr);

ـــــــــــــــــــــــــــــــــــــــــــــــــــــــــــــــــــــــــــــــــــــــــــــــــــــــــــــــــــــــــــــــــــــــــــــــ

Tt=input('No. of turns of the transmitting coil = ');

Tr=input('No. of turns of the receiving coil = ');

u=input('The square side in mm = ');

h=input('The gap distance between the two coils in mm = ');

M=Mutual(Tt,Tr,u,h);

fprintf(' | \n');

fprintf('The mutual inductance = %0.2f microH\n',M);

Chapter (7) | Appendices | 143

Lt=input('The self-inductance of the transmitting coil in microH = ');

M=input('The Mutual inductance in microH = ');

Lr=input('The self-inductance of the receiving coil in microH = ');

K=Coupling(Lt,M,Lr);

fprintf(' | \n');

fprintf('The coupling coefficient = %0.3f \n',K);

ـــــــــــــــــــــــــــــــــــــــــــــــــــــــــــــــــــــــــــــــــــــــــــــــــــــــــــــــــــــــــــــــــــــــــــــــ

Lt=input('The self-inductance of the transmitting coil in microH = ');

Lr=input('The self-inductance of the receiving coil in microH = ');

f=input('The resonance frequency in Hz = ');

[Ct,Cr]=Compensation(Lt,Lr,f);

fprintf(' | \n');

fprintf('The capacitance of the transmitting circuit = %0.3f nF\n',Ct);

fprintf('The capacitance of the receiving circuit = %0.3f nF\n',Cr);

Chapter (7) | Appendices | 144

V1o=input(' The output HF AC voltage at resonance in V = ');

RLeq=input(' The equivalent AC resistive load in Ohm = ');

Rr=input(' The DC resistance of the receiving coil in Ohm = ');

Rt=input(' The DC resistance of the transmitting coil in Ohm = ');

f=input(' The resonance frequency in Hz = ');

M=input(' The mutual inductance in H = ');

It=TransmitterCurrent(V1o,RLeq,Rr,Rt,f,M);

fprintf(' | \n');

fprintf('The RMS transmitting current = %0.3f A\n',It);

ـــــــــــــــــــــــــــــــــــــــــــــــــــــــــــــــــــــــــــــــــــــــــــــــــــــــــــــــــــــــــــــــــــــــــــــــ

f=input(' The resonance frequency in Hz = ');

M=input(' The mutual inductance in H = ');

It=input(' The RMS transmitting current in A = ');

RLeq=input(' The equivalent AC resistive load in Ohm = ');

Rr=input(' The DC resistance of the receiving coil in Ohm = ');

Ir=ReceiverCurrent(It,f,M,RLeq,Rr);

fprintf(' | \n');

fprintf('The RMS receiving current = %0.3f A\n',Ir);

Chapter (7) | Appendices | 145

It=input('The RMS transmitting current in A = ');

f=input(' The resonance frequency in Hz = ');

M=input(' The mutual inductance in microH = ');

Rr=input(' The DC resistance of the receiving coil in Ohm = ');

RLeq=input(' The equivalent AC resistive load in Ohm = ');

P=Power(It,f,M,Rr,RLeq);

fprintf(' | \n');

fprintf('The RMS power delivered to the equivalent AC resistive load = %0.2f W\n',P);

ـــــــــــــــــــــــــــــــــــــــــــــــــــــــــــــــــــــــــــــــــــــــــــــــــــــــــــــــــــــــــــــــــــــــــــــــ

f=input('The resonant frequency in Hz = ');

M=input('The mutual inductance in H = ');

Rt=input('The DC resistance of the transmitting coil in Ohm = ');

Rr=input('The DC resistance of the receiving coil in Ohm = ');

RLeq=input('The equivalent AC resistive load in Ohm = ');

E=Efficiency(f,M,Rt,Rr,RLeq);

fprintf(' | \n');

fprintf('The efficiency while using SS compensation = %0.2f %% \n',E);

Chapter (7) | Appendices | 146

### 7.2 MATLAB function codes

function [rt,rr]=HalfSide(Tt,Tr,So)

rt=Tt*sqrt(So/pi);

rr=Tr*sqrt(So/pi);

End

ـــــــــــــــــــــــــــــــــــــــــــــــــــــــــــــــــــــــــــــــــــــــــــــــــــــــــــــــــــــــــــــــــــــــــــــــ

function [Rt,Rr]=Resistance(Tt,Tr,Si,wt,wr,lt,lr)

Rt=((1.724e-8)Tt*2(wt+lt)/Si)*1000;

Rr=((1.724e-8)Tr*2(wr+lr)/Si)*1000;

End

ـــــــــــــــــــــــــــــــــــــــــــــــــــــــــــــــــــــــــــــــــــــــــــــــــــــــــــــــــــــــــــــــــــــــــــــــ

function [Lt,Lr]=Self(Tt,Tr,rt,rr,wt,wr,lt,lr)

at=wt*log( (2*wt*lt) / (rt*(wt+sqrt(((wt)^2)+((lt)^2)))) );

bt=lt*log( (2*wt*lt) / (rt*(lt+sqrt(((wt)^2)+((lt)^2)))) );

ct=wt+lt-sqrt(((wt)^2)+((lt)^2));

ar=wr*log( (2*wr*lr) / (rr*(wr+sqrt(((wr)^2)+((lr)^2)))) );

br=lr*log( (2*wr*lr) / (rr*(lr+sqrt(((wr)^2)+((lr)^2)))) );

cr=wr+lr-sqrt(((wr)^2)+((lr)^2));

Lt=((4*(10^(-7))(Tt^2)(at+bt-2*ct+0.25*(wt+lt))))*1000;

Lr=((4*(10^(-7))(Tr^2)(ar+br-2*cr+0.25*(wr+lr))))*1000;

End

Chapter (7) | Appendices | 147

function M=Mutual(Tt,Tr,u,h)

term1=u*sqrt((h^2)+(u^2));

term2=(u^2)+(h^2);

term3=(u*h)+h*sqrt((h^2)+2*(u^2));

term4=h-2*sqrt((h^2)+(u^2))+sqrt((h^2)+2*(u^2));

M=(8*(10^-7)Tt*Tr(u*log((term1+term2)/term3)+term4))*1000;

End

ـــــــــــــــــــــــــــــــــــــــــــــــــــــــــــــــــــــــــــــــــــــــــــــــــــــــــــــــــــــــــــــــــــــــــــــــ

function K=Coupling(Lt,M,Lr)

K=M/sqrt(Lt*Lr);

End

ـــــــــــــــــــــــــــــــــــــــــــــــــــــــــــــــــــــــــــــــــــــــــــــــــــــــــــــــــــــــــــــــــــــــــــــــ

function [Ct,Cr]=Compensation(Lt,Lr,f)

Ct=((1/(4*(pi^2)(f^2)*Lt)))(10^15);

Cr=((1/(4*(pi^2)(f^2)*Lr)))(10^15);

End

ـــــــــــــــــــــــــــــــــــــــــــــــــــــــــــــــــــــــــــــــــــــــــــــــــــــــــــــــــــــــــــــــــــــــــــــــ

function It=TransmitterCurrent(V1o,RLeq,Rr,Rt,f,M)

w=2*pi*f;

It=(V1o*(RLeq+Rr))/((Rt*(RLeq+Rr))+(w*M)^2);

End

ـــــــــــــــــــــــــــــــــــــــــــــــــــــــــــــــــــــــــــــــــــــــــــــــــــــــــــــــــــــــــــــــــــــــــــــــ

function Ir=ReceiverCurrent(It,f,M,RLeq,Rr)

w=2*pi*f;

Ir=(w*M*It)/(RLeq+Rr);

End

Chapter (7) | Appendices | 148

function P=Power(It,f,M,Rr,RLeq)

w=2*pi*f;

P=(((It*w*M)^2)/(Rr+RLeq))*(10^-12);

End

ـــــــــــــــــــــــــــــــــــــــــــــــــــــــــــــــــــــــــــــــــــــــــــــــــــــــــــــــــــــــــــــــــــــــــــــــ

function E=Efficiency(f,M,Rt,Rr,RLeq)

w=2*pi*f;

term1=Rt*((Rr+RLeq)^2);

term2=(w*M)^2;

E=(RLeq/(RLeq+Rr+(term1/term2)))*100;

End

Chapter (7) | Appendices | 149

### 7.3 Stm32CubeIDE code

/* USER CODE BEGIN Header */

/**

***********************************************************

* @file | : main.c
* @brief | : Main program body

***********************************************************

* @attention

*

* Copyright (c) 2025 STMicroelectronics.

* All rights reserved.

*

* This software is licensed under terms that can be found in the LICENSE file

* in the root directory of this software component.

* If no LICENSE file comes with this software, it is provided AS-IS.

*

**********************************************************

*/

/* USER CODE END Header */

/* Includes -----------------------------------------------------------------------*/

#include "main.h"

/* Private includes ----------------------------------------------------------------*/

/* USER CODE BEGIN Includes */

/* USER CODE END Includes */

Chapter (7) | Appendices | 150

/* Private typedef -----------------------------------------------------------------*/

/* USER CODE BEGIN PTD */

/* USER CODE END PTD */

/* Private define ------------------------------------------------------------------*/

/* USER CODE BEGIN PD */

/* USER CODE END PD */

/* Private macro ------------------------------------------------------------------*/

/* USER CODE BEGIN PM */

/* USER CODE END PM */

/* Private variables ---------------------------------------------------------------*/

TIM_HandleTypeDef htim1;

/* USER CODE BEGIN PV */

/* USER CODE END PV */

/* Private function prototypes ---------------------------------------------------*/

void SystemClock_Config(void);

static void MX_GPIO_Init(void);

static void MX_TIM1_Init(void);

/* USER CODE BEGIN PFP */

Chapter (7) | Appendices | 151

/* USER CODE END PFP */

/* Private user code ---------------------------------------------------------------*/

/* USER CODE BEGIN 0 */

/* USER CODE END 0 */

/**

* @brief The application entry point.

* @retval int

*/

int main(void)

{

/* USER CODE BEGIN 1 */

/* USER CODE END 1 */

/* MCU Configuration----------------------------------------------------------*/

/* Reset of all peripherals, Initializes the Flash interface and the Systick. */

HAL_Init ();

/* USER CODE BEGIN Init */

/* USER CODE END Init */

Chapter (7) | Appendices | 152

/* Configure the system clock */

SystemClock_Config ();

/* USER CODE BEGIN SysInit */

/* USER CODE END SysInit */

/* Initialize all configured peripherals */

MX_GPIO_Init ();

MX_TIM1_Init ();

/* USER CODE BEGIN 2 */

HAL_TIM_PWM_Start(&htim1, TIM_CHANNEL_1);

HAL_TIMEx_PWMN_Start(&htim1, TIM_CHANNEL_1);

/* USER CODE END 2 */

/* Infinite loop */

/* USER CODE BEGIN WHILE */

while (1)

{

/* USER CODE END WHILE */

/* USER CODE BEGIN 3 */

}

Chapter (7) | Appendices | 153

/* USER CODE END 3 */

}

/**

* @brief System Clock Configuration

* @retval None

*/

void SystemClock_Config(void)

{

RCC_OscInitTypeDef RCC_OscInitStruct = {0};

RCC_ClkInitTypeDef RCC_ClkInitStruct = {0};

/** Configure the main internal regulator output voltage

*/

__HAL_RCC_PWR_CLK_ENABLE ();

__HAL_PWR_VOLTAGESCALING_CONFIG(PWR_REGULATOR_ VOLTAGE_SCALE2);

/** Initializes the RCC Oscillators according to the specified parameters

* in the RCC_OscInitTypeDef structure.

*/

RCC_OscInitStruct.OscillatorType = RCC_OSCILLATORTYPE_HSI;

RCC_OscInitStruct.HSIState = RCC_HSI_ON;

RCC_OscInitStruct.HSICalibrationValue | =
RCC_HSICALIBRATION_DEFAULT;

RCC_OscInitStruct.PLL.PLLState = RCC_PLL_NONE;

if (HAL_RCC_OscConfig(&RCC_OscInitStruct) != HAL_OK)

Chapter (7) | Appendices | 154

{

Error_Handler ();

}

/** Initializes the CPU, AHB and APB buses clocks

*/

RCC_ClkInitStruct.ClockType= RCC_CLOCKTYPE_HCLK|RCC_CLOCKTYPE_SYSCLK |RCC_CLOCKTYPE_PCLK1|RCC_CLOCKTYPE_PCLK2;

RCC_ClkInitStruct.SYSCLKSource = RCC_SYSCLKSOURCE_HSI;

RCC_ClkInitStruct.AHBCLKDivider = RCC_SYSCLK_DIV1;

RCC_ClkInitStruct.APB1CLKDivider = RCC_HCLK_DIV1;

RCC_ClkInitStruct.APB2CLKDivider = RCC_HCLK_DIV1;

If(HAL_RCC_ClockConfig(&RCC_ClkInitStruct,FLASH_LATENCY_0 ) != HAL_OK)

{

Error_Handler();

}

}

/**

* @brief TIM1 Initialization Function

* @param None

* @retval None

*/

static void MX_TIM1_Init(void)

{

Chapter (7) | Appendices | 155

/* USER CODE BEGIN TIM1_Init 0 */

/* USER CODE END TIM1_Init 0 */

TIM_MasterConfigTypeDef sMasterConfig = {0};

TIM_OC_InitTypeDef sConfigOC = {0};

TIM_BreakDeadTimeConfigTypeDef sBreakDeadTimeConfig = {0};

/* USER CODE BEGIN TIM1_Init 1 */

/* USER CODE END TIM1_Init 1 */

htim1.Instance = TIM1;

htim1.Init.Prescaler = 0;

htim1.Init.CounterMode = TIM_COUNTERMODE_UP;

htim1.Init.Period = 193;

htim1.Init.ClockDivision = TIM_CLOCKDIVISION_DIV1;

htim1.Init.RepetitionCounter = 0;

htim1.Init.AutoReloadPreload | =
TIM_AUTORELOAD_PRELOAD_DISABLE;

if (HAL_TIM_PWM_Init(&htim1) != HAL_OK)

{

Error_Handler();

}

sMasterConfig.MasterOutputTrigger = TIM_TRGO_RESET;

sMasterConfig.MasterSlaveMode | =
TIM_MASTERSLAVEMODE_DISABLE;

Chapter (7) | Appendices | 156

if(HAL_TIMEx_MasterConfigSynchronization(&htim1,&sMasterConfig ) != HAL_OK)

{

Error_Handler();

}

sConfigOC.OCMode = TIM_OCMODE_PWM1;

sConfigOC.Pulse = 96;

sConfigOC.OCPolarity = TIM_OCPOLARITY_LOW;

sConfigOC.OCNPolarity = TIM_OCNPOLARITY_LOW;

sConfigOC.OCFastMode = TIM_OCFAST_DISABLE;

sConfigOC.OCIdleState = TIM_OCIDLESTATE_RESET;

sConfigOC.OCNIdleState = TIM_OCNIDLESTATE_RESET;

if(HAL_TIM_PWM_ConfigChannel(&htim1,&sConfigOC,TIM_CHAN NEL_1) != HAL_OK)

{

Error_Handler();

}

sBreakDeadTimeConfig.OffStateRunMode = TIM_OSSR_DISABLE;

sBreakDeadTimeConfig.OffStateIDLEMode = TIM_OSSI_DISABLE;

sBreakDeadTimeConfig.LockLevel = TIM_LOCKLEVEL_OFF;

sBreakDeadTimeConfig.DeadTime = 2;

sBreakDeadTimeConfig.BreakState = TIM_BREAK_DISABLE;

sBreakDeadTimeConfig.BreakPolarity | =
TIM_BREAKPOLARITY_HIGH;
sBreakDeadTimeConfig.AutomaticOutput | =
TIM_AUTOMATICOUTPUT_DISABLE;

if(HAL_TIMEx_ConfigBreakDeadTime(&htim1,&sBreakDeadTimeCon fig) != HAL_OK)

Chapter (7) | Appendices | 157

{

Error_Handler();

}

/* USER CODE BEGIN TIM1_Init 2 */

/* USER CODE END TIM1_Init 2 */

HAL_TIM_MspPostInit(&htim1);

}

/**

* @brief GPIO Initialization Function

* @param None

* @retval None

*/

static void MX_GPIO_Init(void)

{

/* USER CODE BEGIN MX_GPIO_Init_1 */

/* USER CODE END MX_GPIO_Init_1 */

/* GPIO Ports Clock Enable */

__HAL_RCC_GPIOA_CLK_ENABLE();

/* USER CODE BEGIN MX_GPIO_Init_2 */

/* USER CODE END MX_GPIO_Init_2 */

Chapter (7) | Appendices | 158

}

/* USER CODE BEGIN 4 */

/* USER CODE END 4 */

/**

* @brief This function is executed in case of error occurrence.

* @retval None

*/

void Error_Handler(void)

{

/* USER CODE BEGIN Error_Handler_Debug */

/* User can add his own implementation to report the HAL error return state */

__disable_irq();

while (1)

{

}

/* USER CODE END Error_Handler_Debug */

}

#ifdef USE_FULL_ASSERT

/**

* @brief Reports the name of the source file and the source line number

* where the assert_param error has occurred.

* @param file: pointer to the source file name

* @param line: assert_param error line source number

Chapter (7) | Appendices | 159

* @retval None

*/

void assert_failed(uint8_t *file, uint32_t line)

{

/* USER CODE BEGIN 6 */

/* User can add his own implementation to report the file name and line number,

ex: printf("Wrong parameters value: file %s on line %d\r\n", file, line) */

/* USER CODE END 6 */

}

#endif /* USE_FULL_ASSERT *
