MahmudElyamani/1kW-Resonant-Inductive-Wireless-Power-Transfer-System-Graduation-Project-/Hardware/WPT Project Core Cost.pdf

Last updated Jul 3, 2025

# WPT System budget

# Inverter circuit

Component | Quantity | Price each | Taxes (EGP) | Shipping (EGP) | Total price (EGP)
G3R40MT12D SiC Mosfet (https://www.aliexpress.com/item/1005008948528361.html?utparam-url=scene%3Asearch%7Cquery_from%3A) | 4 | 131.91 | 75 | 290.19 | 1025
Aluminum Heatsink 100*150*20 (https://makerselectronics.com/product/aluminum-heatsink-10x10-20x10cm) | 1 | 260 | — | 70 | 330
PCB Prototype Board (https://makerselectronics.com/product/pcb-prototype-board-vero-board-fr-2-dotted-line-center-splitted-breadboard) | 1 | 18 | — | — | 18
PCB for Inverter (https://metanoia-eg.com/order-now/) | 1 | 800 | — | 100 | 900
STM32F401 microcontroller (https://makerselectronics.com/product/stm32f401rct6-stm32-development-board-the-black-pill) | 1 | 320 | — | — | 320
ST-LINK V2 Emulator (https://makerselectronics.com/product/st-link-v2-emulator-and-debuggerprogrammer-for-stm8-and-stm32) | 1 | 220 | — | — | 220
3.3V voltage adapter (https://www.amazon.eg/-/en/Adaptor-Adapter-Heater-Replacement-YusufMarket/dp/B0DP5NVX8Q?sr=8-1) | 1 | 86 | — | — | 86
IR2110 Gate driver (https://makerselectronics.com/product/ir2110-high-side-and-low-side-gate) | 2 | 95 | — | 70 | 260
UF4007 Fast recovery diode (https://makerselectronics.com/product/diodes-fast-recovery-rectifier-uf4007-1-7v1a-75ns-1a-1kv-do-41) | 6 | 1 | — | — | 6
Carbon Resistor 13Ω 0.25W (https://makerselectronics.com/product/carbon-resistor-13%cf%89-0-25w-through-hole) | 10 | 0.15 | — | — | 1.5
22uF 160V Capacitor (https://makerselectronics.com/product/capacitor-22uf-160v) | 2 | 1.5 | — | — | 3
0.22uF 50V Capacitor (https://makerselectronics.com/product/capacitor-220nf-50v) | 3 | 0.75 | — | — | 2.25
490nF 275V Ceramic Capacitor (https://makerselectronics.com/product/capacitors-polypropylene-film-470nf-2) | 4 | 2 | — | — | 8
Breadboard (https://makerselectronics.com/product/breadboard-830-point-splitted-power-rails) | 1 | 40 | — | — | 40
5.6k 0.25W ohm Resistor (https://makerselectronics.com/product/carbon-resistor-5-6k%cf%89-0-25w-through-hole) | 10 | 0.15 | — | — | 1.5
6N135 Optocoupler (https://makerselectronics.com/product/6n135-high-speed-optocoupler-with-transistor-output-dip-8) | 2 | 30 | — | — | 60
220V to 12Vdc converter (https://makerselectronics.com/product/ac-dc-220vac-to-12vdc-400ma-4-5w-converter-step-down) | 3 | 65 | — | — | 195
Terminal block 2 pins (https://makerselectronics.com/product/kf127-5-0-2p-green-terminal-block) | 5 | 3.25 | — | — | 16.25
Red Led (https://makerselectronics.com/product/red-led-5mm-trans) | 1 | 0.5 | — | — | 0.5
Jumper Wire (https://makerselectronics.com/product/jumper-wire-10-cm-male-to-male-pin) | 30 | 0.75 | — | — | 22.5
Total Price: | | | | | 3515.5

# Primary Compensation

Component | Quantity | Price each | Taxes (EGP) | Shipping (EGP) | Total price (EGP)
0.33uF Resonance Film Capacitor (https://makerselectronics.com/product/high-voltage-resonance-film-capacitor-for-induction-0-33uf-1200v) | 14 | 40 | — | 70 | 630
PCB prototype board (https://makerselectronics.com/product/pcb-prototype-board-vero-board-fr-4-dotted-line-center-splitted) | 1 | 32 | — | — | 32
Total Price: | | | | | 662

# Induction Coils

Component | Quantity | Price each | Taxes (EGP) | Shipping (EGP) | Total price (EGP)
Litz Wire 0.1*600 strands (20m) (https://www.aliexpress.com/item/1005009074696221.html?utparam-url=scene%3Asearch%7Cquery_from%3A) | 2 | 2100 | 4,477.94 | 7000 | 15677.94
Iclyric Board 65*65cm | 4 | 822.5 | — | — | 3290
Iclyric Rod 20cm | 4 | 167.5 | — | — | 670
PC40 Mn-Zn Soft Ferrite core 4 pieces 60*16*8 (https://www.aliexpress.com/item/1005006158154308.html?utparam-url=scene%3Asearch%7Cquery_from%3A) | 6 | 425 | 1580 | Free | 4130
Total Price: | | | | | 23767.94

# Secondary Compensation

Component | Quantity | Price each | Taxes (EGP) | Shipping (EGP) | Total price (EGP)
0.33uF Resonance Film Capacitor (https://makerselectronics.com/product/high-voltage-resonance-film-capacitor-for-induction-0-33uf-1200v) | 14 | 40 | — | 70 | 630
PCB prototype board (https://makerselectronics.com/product/pcb-prototype-board-vero-board-fr-4-dotted-line-center-splitted) | 1 | 32 | — | — | 32
Total Price: | | | | | 662

# Secondary Circuit

Component | Quantity | Price each | Taxes (EGP) | Shipping (EGP) | Total price (EGP)
220uF 450V Capacitor (https://makerselectronics.com/product/capacitor-220%ce%bcf-450v) | 3 | 35 | — | 70 | 175
SEI60-10A Diode 1000V 60A (https://makerselectronics.com/product/dsei60-10a-diode-1000-v-60a-to-247ad) | 4 | 90 | — | — | 360
Secondary Rectifier PCB (https://metanoia-eg.com/order-now/) | 1 | 200 | — | — | 200
5.8ohm 5KW Load | 1 | 2000 | — | 20 | 2020
Total Price: | | | | | 2755

# Other

Component | Quantity | Price each | Taxes (EGP) | Shipping (EGP) | Total price (EGP)
Electrical Box PI65 (30*40*17) | 1 | 1280 | — | — | 1280
Electrical Box PI65 (25*35*15) | 1 | 680 | — | — | 680
DC Fan 12V 0.22A (https://makerselectronics.com/product/dc-fan-12v-0-22a-8x8cm) | 3 | 55 | — | — | 165
Male Blade crimp Terminal | 100 | 1 | — | — | 100
Female Blade crimp Terminal | 100 | 1 | — | — | 100
AC Power Socket 3 Pin (https://makerselectronics.com/product/ac-power-socket-3-pin-male-plug-connector-10a-250v-with-fuse-compartment) | 1 | 15 | — | — | 15
PCB Male Terminals (https://makerselectronics.com/product/terminal-pcb-male-flat-6-3mm) | 20 | 1 | — | — | 20
Stranded 6mm copper wire (5m) | 2 | 50 | — | — | 100
Total Price: | | | | | 2460

# Total Production Price for The Project

Part | Total price (EGP)
Inverter Circuit | 3515.5
Primary Compensation | 662
Induction Coils | 23767.94
Secondary Compensation | 662
Secondary Circuit | 2755
Other | 2460
Total Price: | 33822.44
