MahmudElyamani/1kW-Resonant-Inductive-Wireless-Power-Transfer-System-Graduation-Project-/WPT Coil design/coilpad.pdf

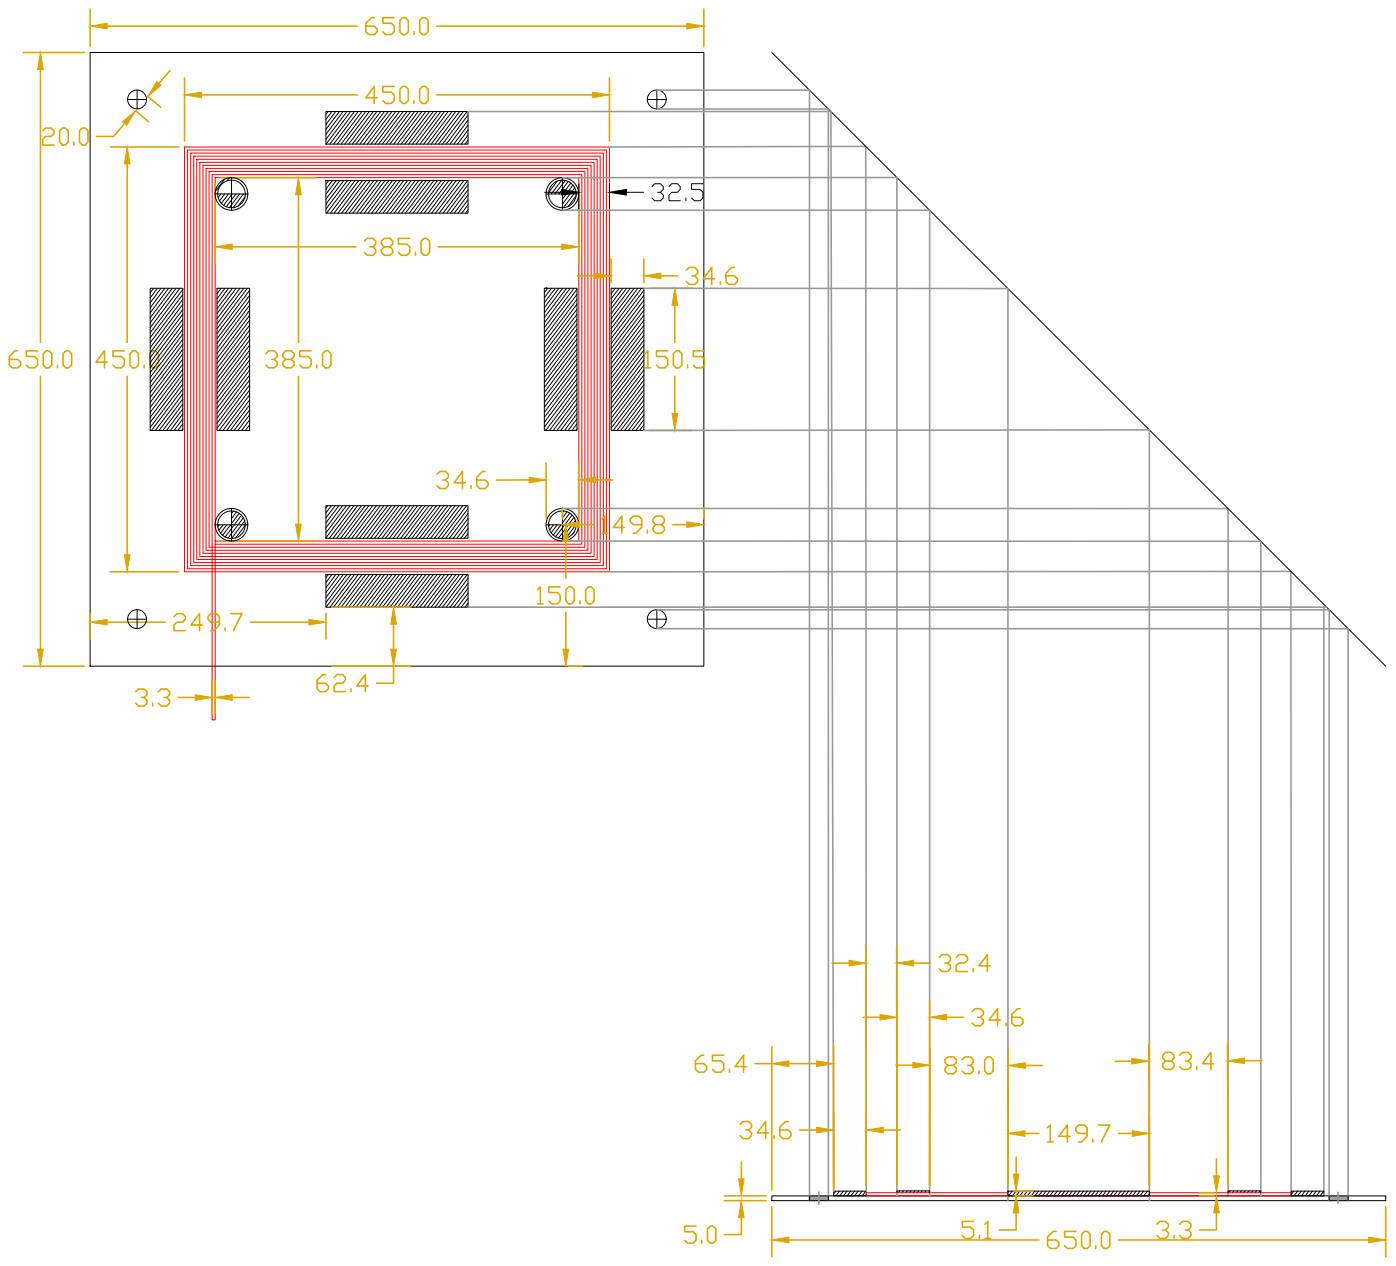
[picture p157: page 1]
