MahmudElyamani/1kW-Resonant-Inductive-Wireless-Power-Transfer-System-Graduation-Project-/WPT Coil design/coilpadcircular.pdf

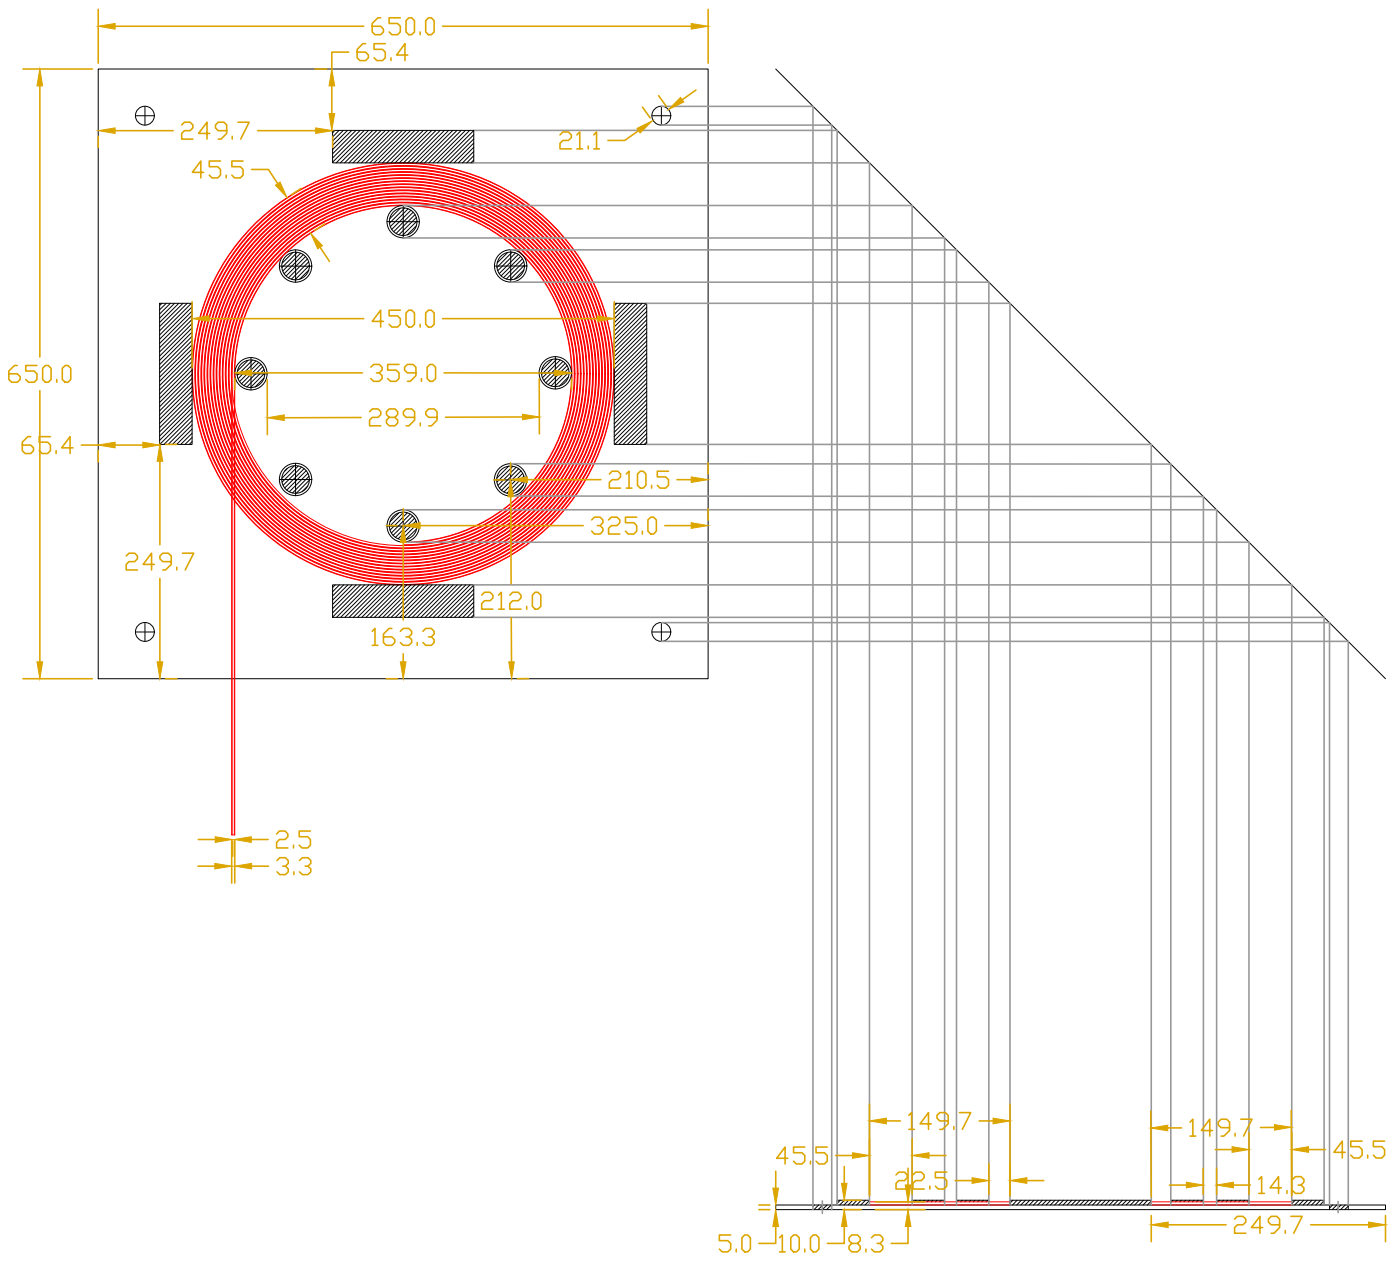
[picture p158: page 1]
