MahmudElyamani/1kW-Resonant-Inductive-Wireless-Power-Transfer-System-Graduation-Project-/Hardware/AltiumProject/PDFtype/FourCircuits.pdf

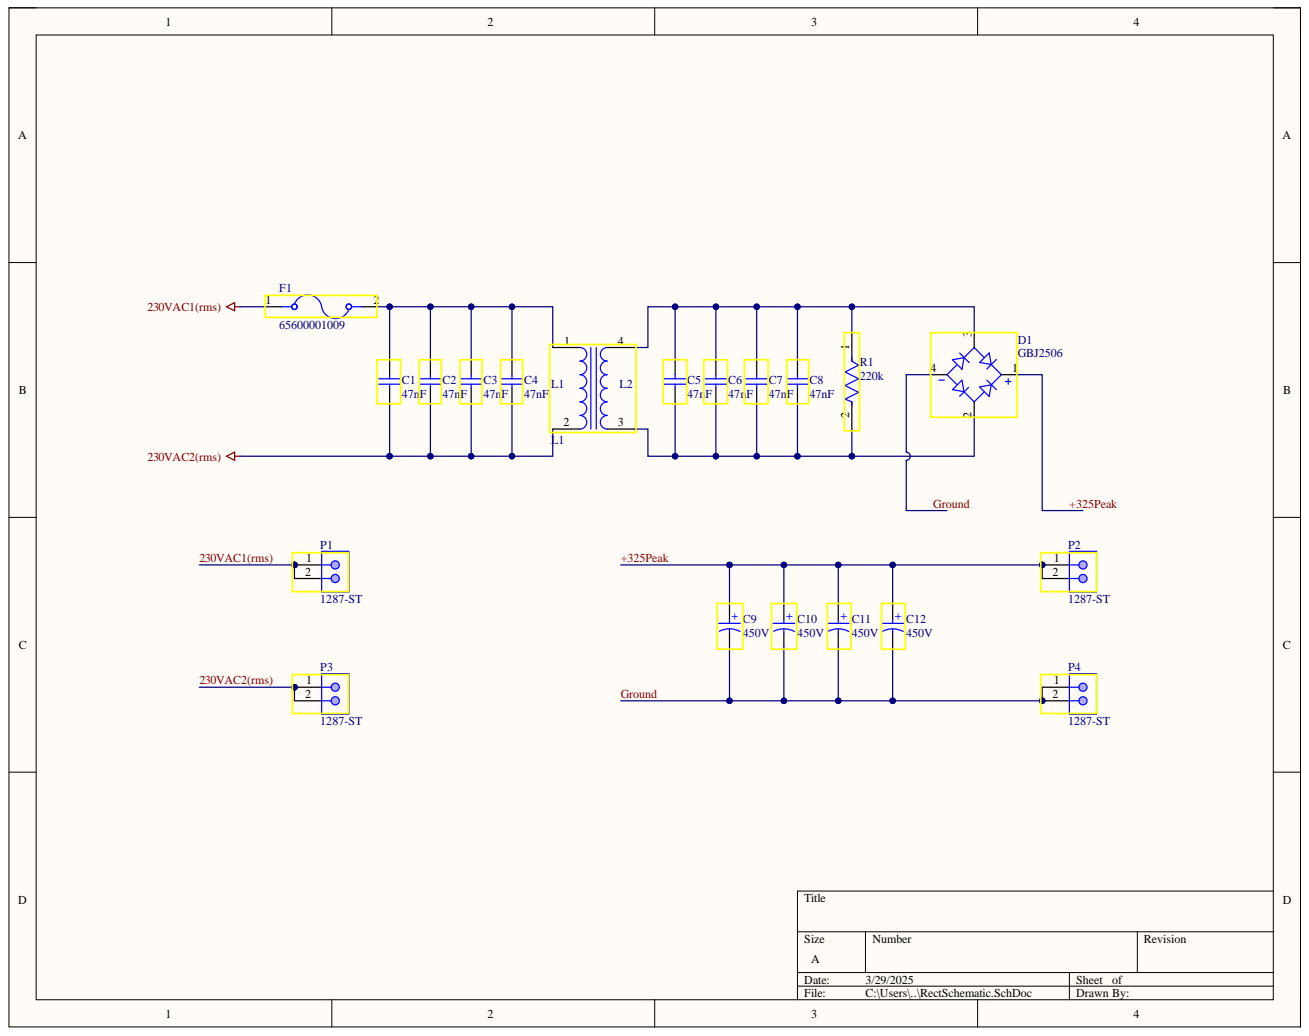
[picture p159: page 1]

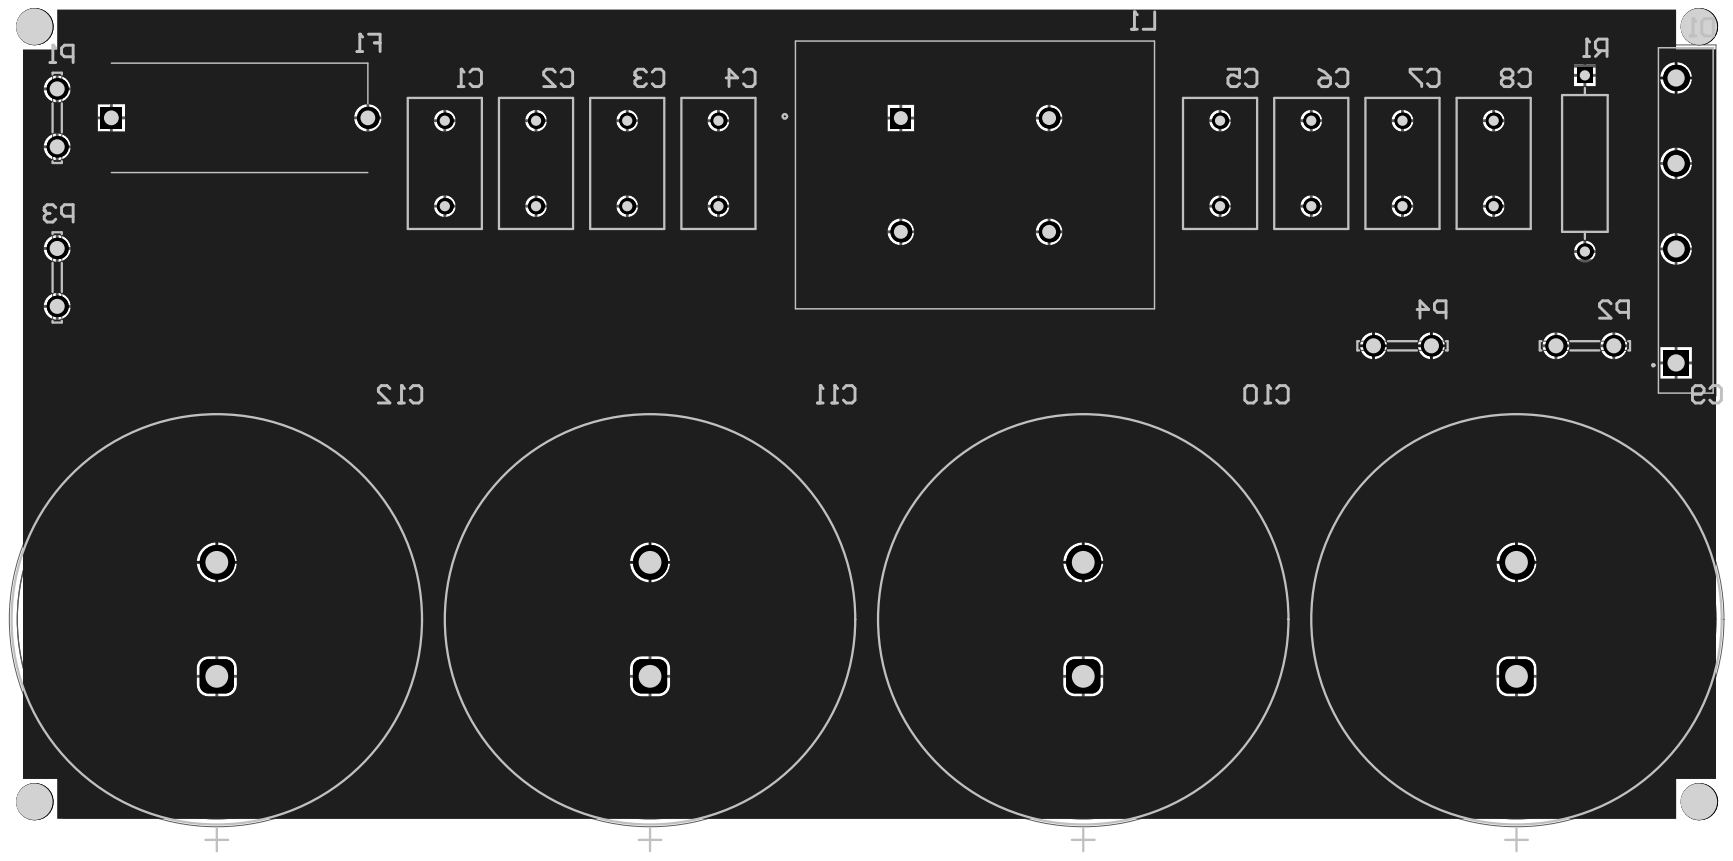
[picture p160: page 2]

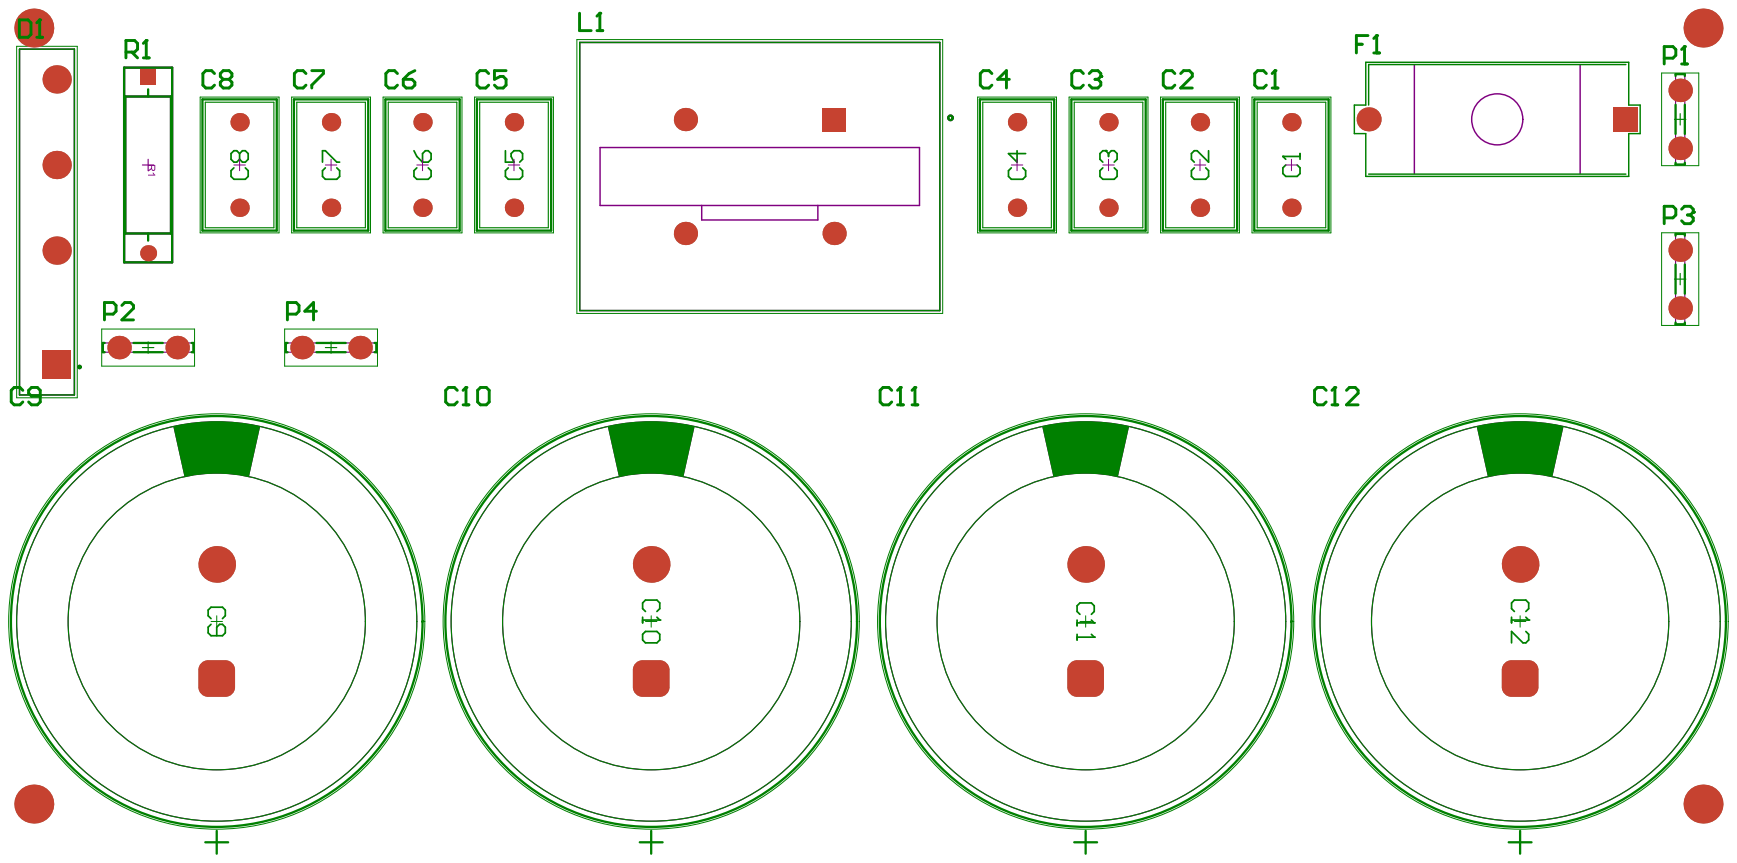
[picture p161: page 3]

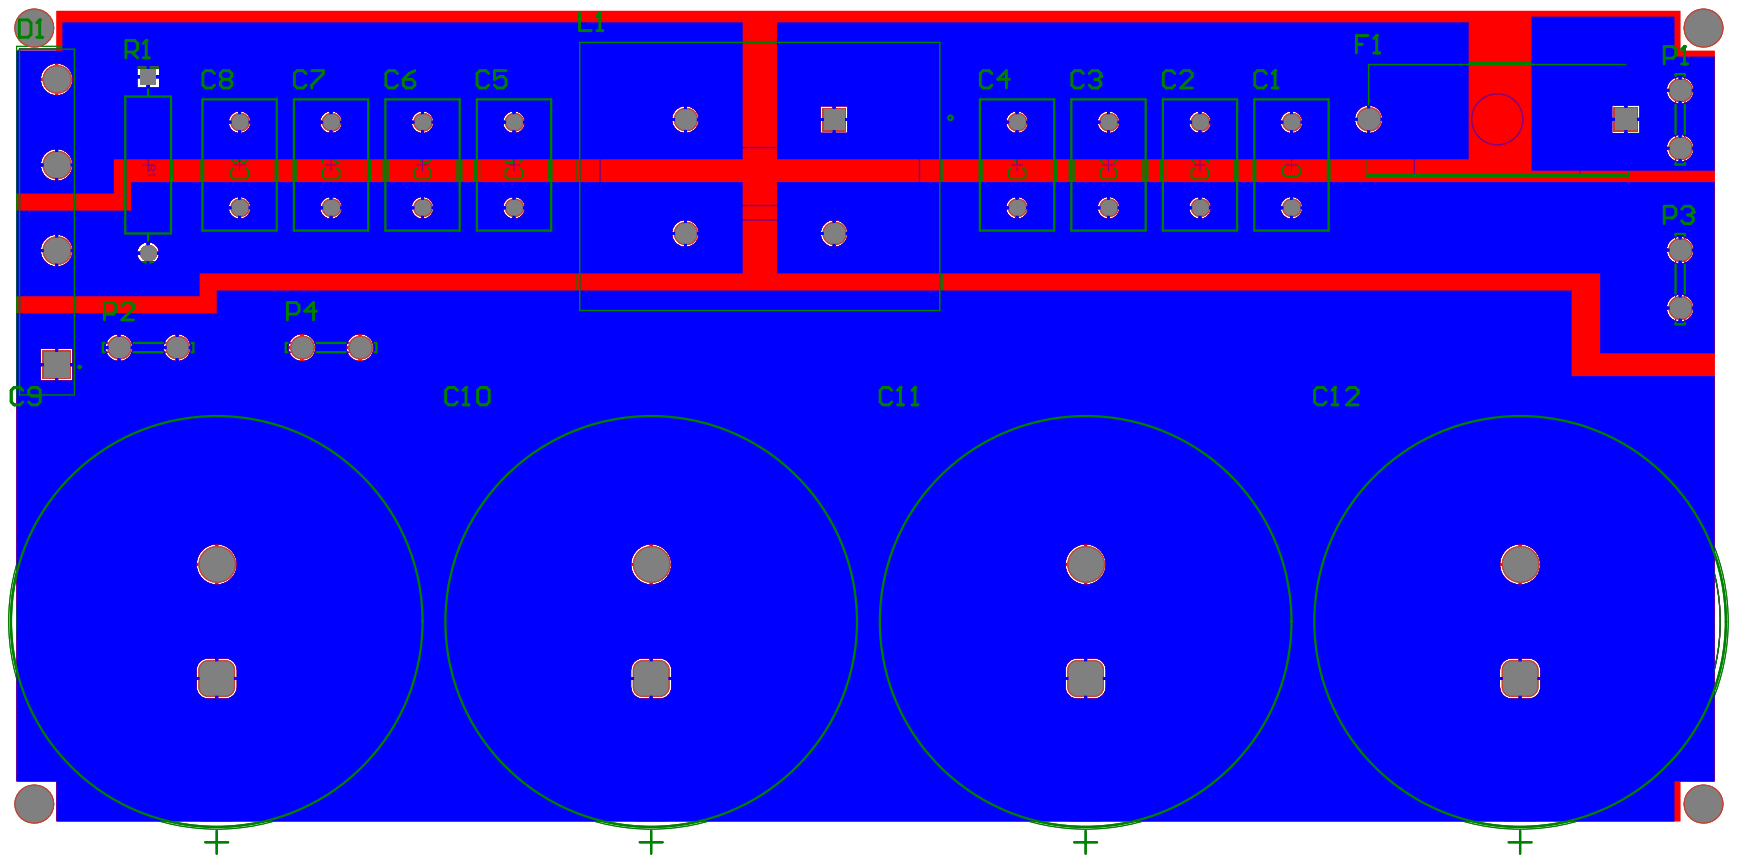
[picture p162: page 4]

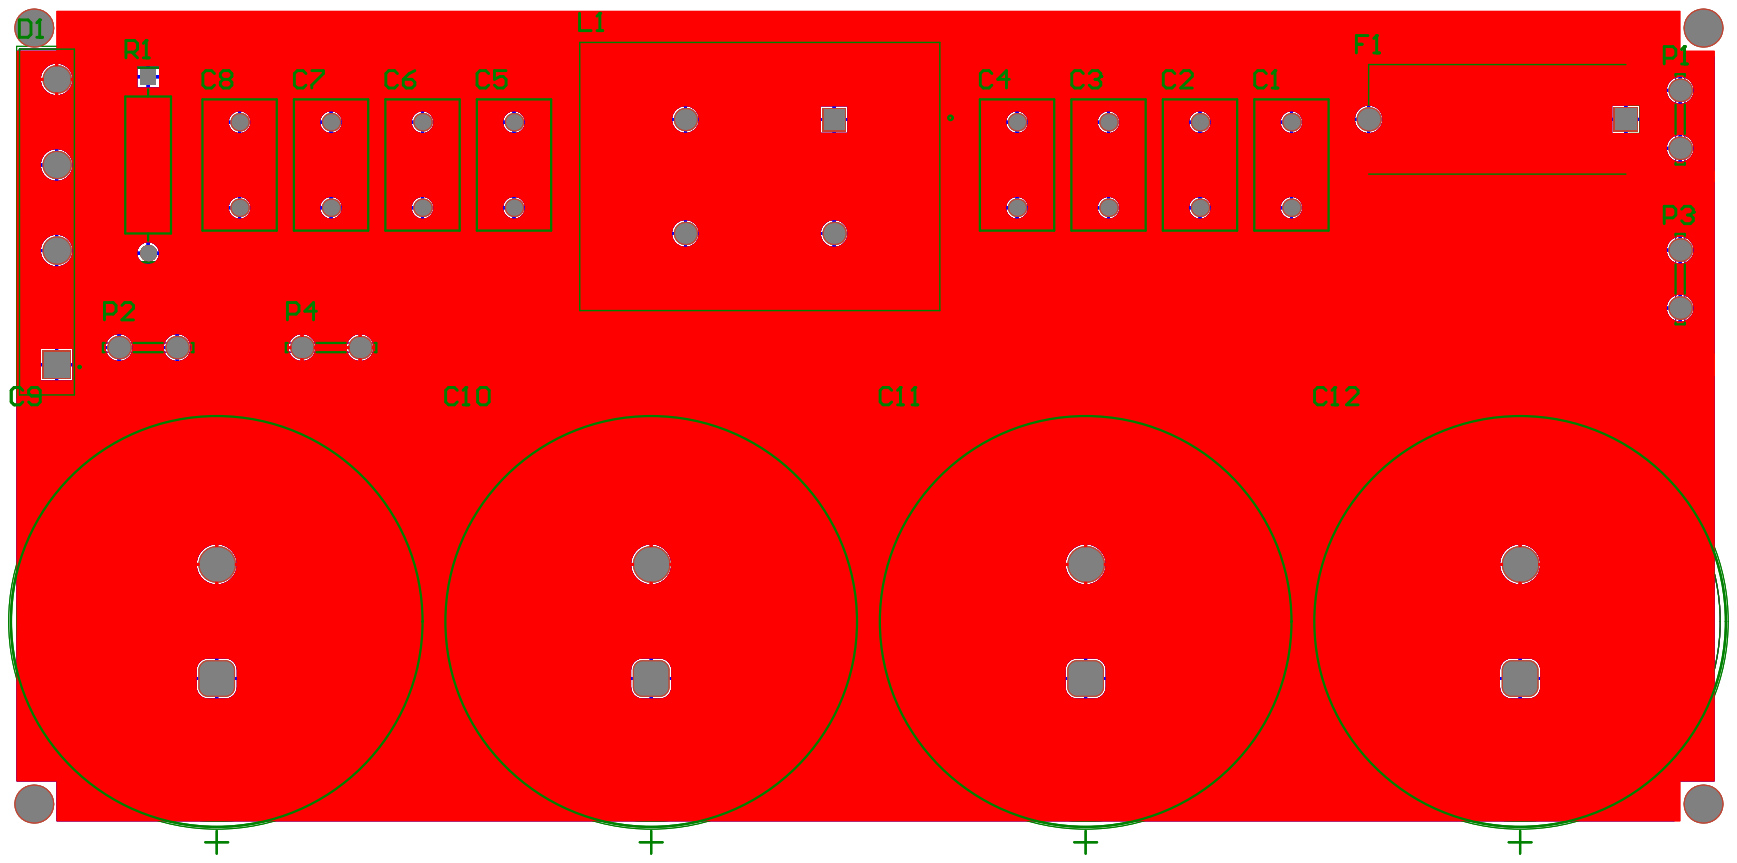
[picture p163: page 5]

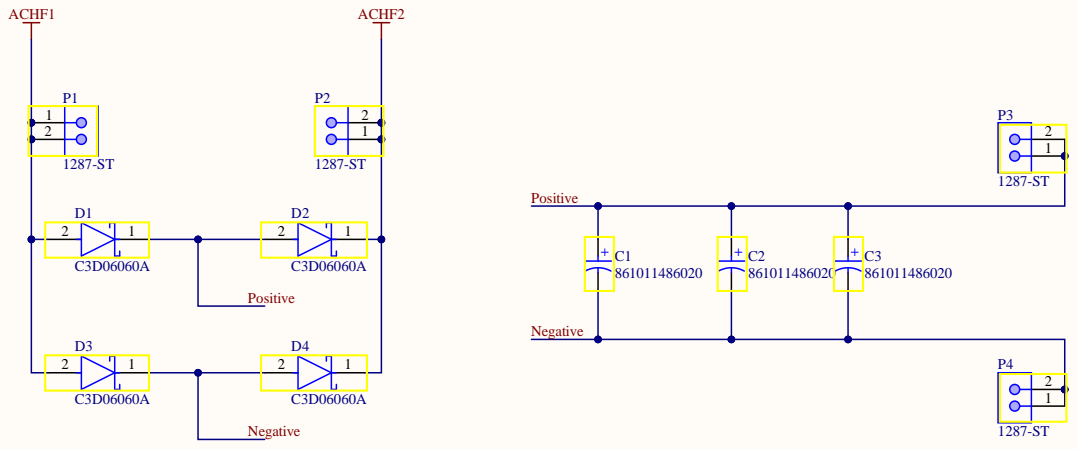
[picture p164: page 6]
Numbe; Revi; ion; ADat; She; ers; chDoc; Dra; Pos; ive; ega; ACH

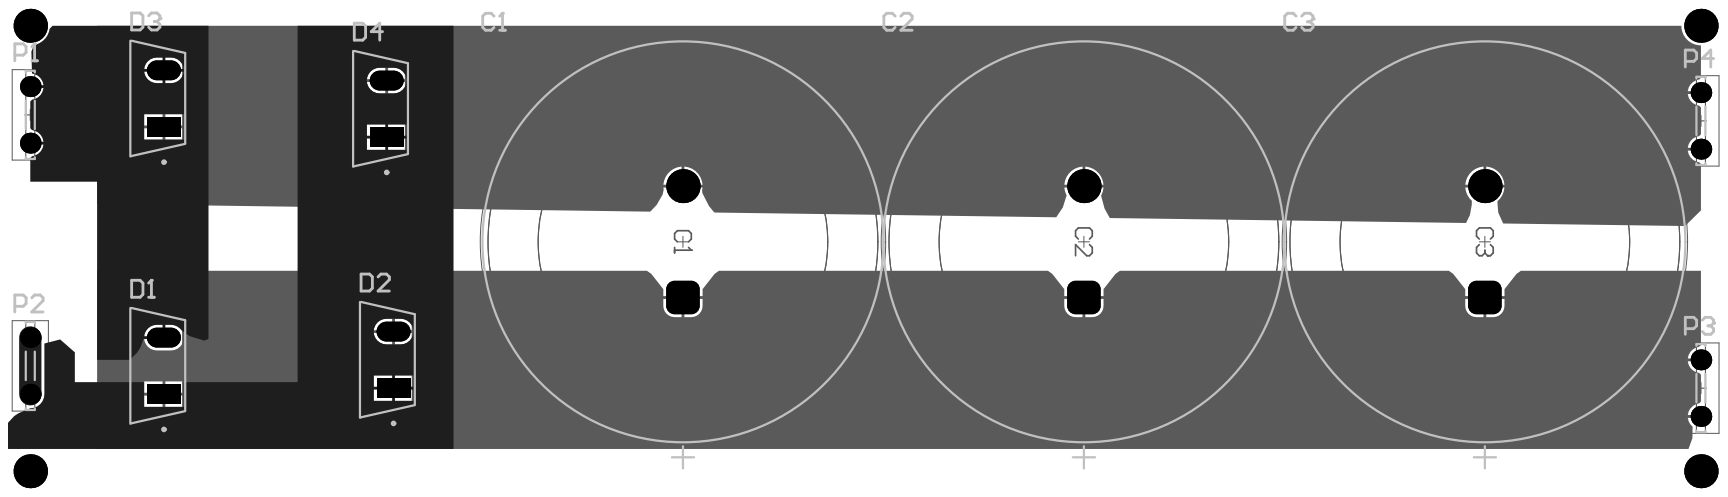
[picture p165: page 7]

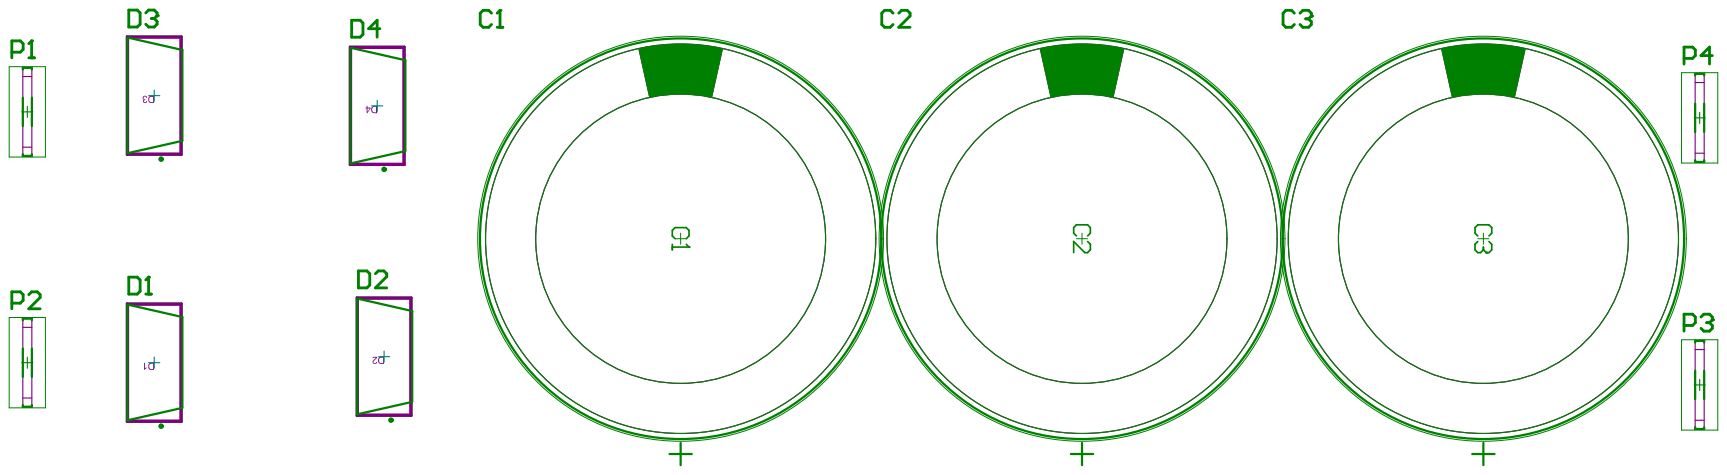
[picture p166: page 9]

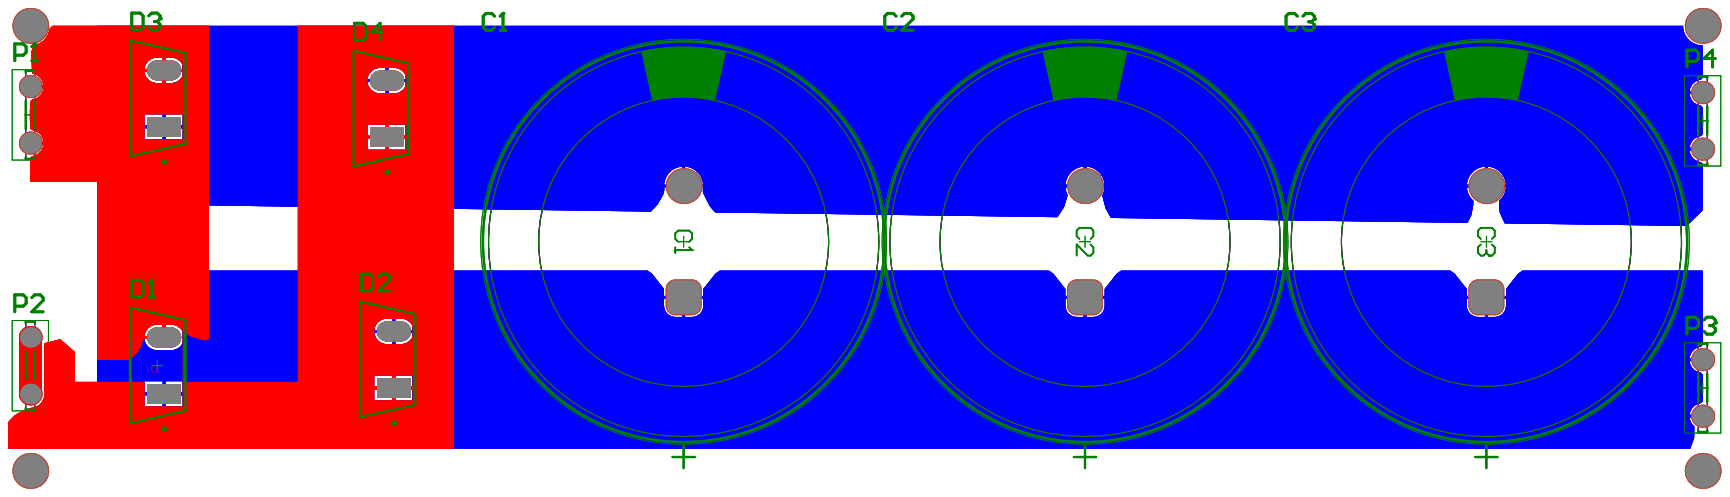
[picture p167: page 10]

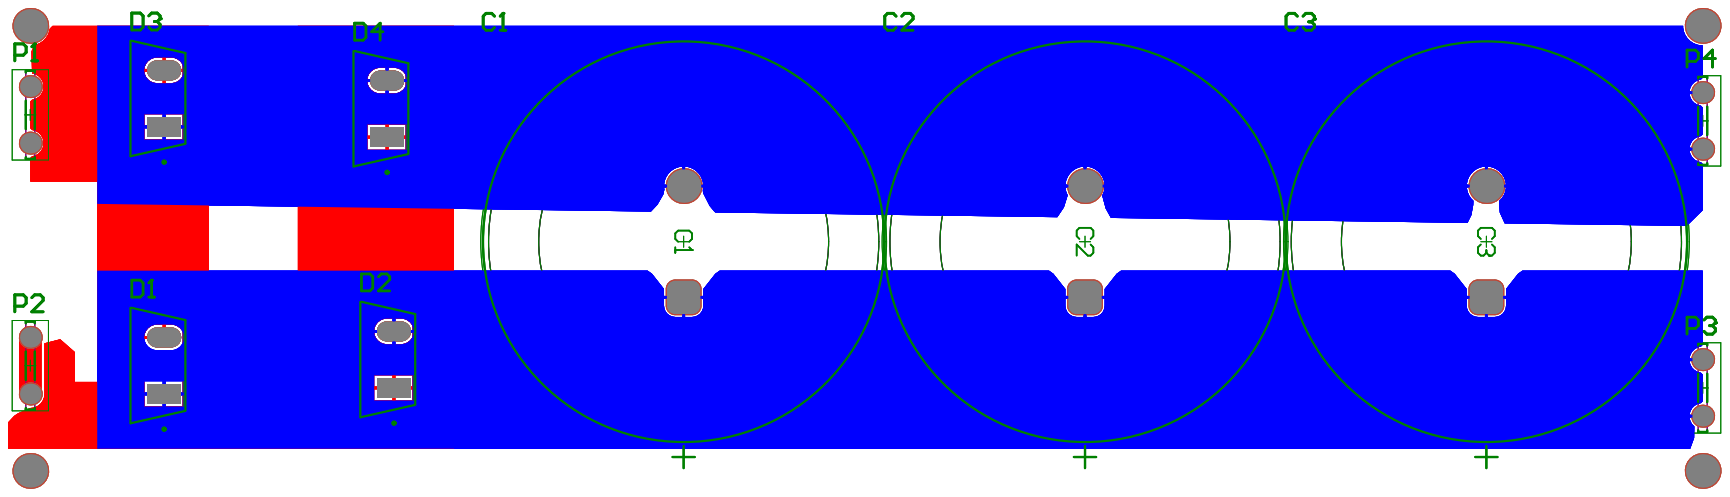
[picture p168: page 11]

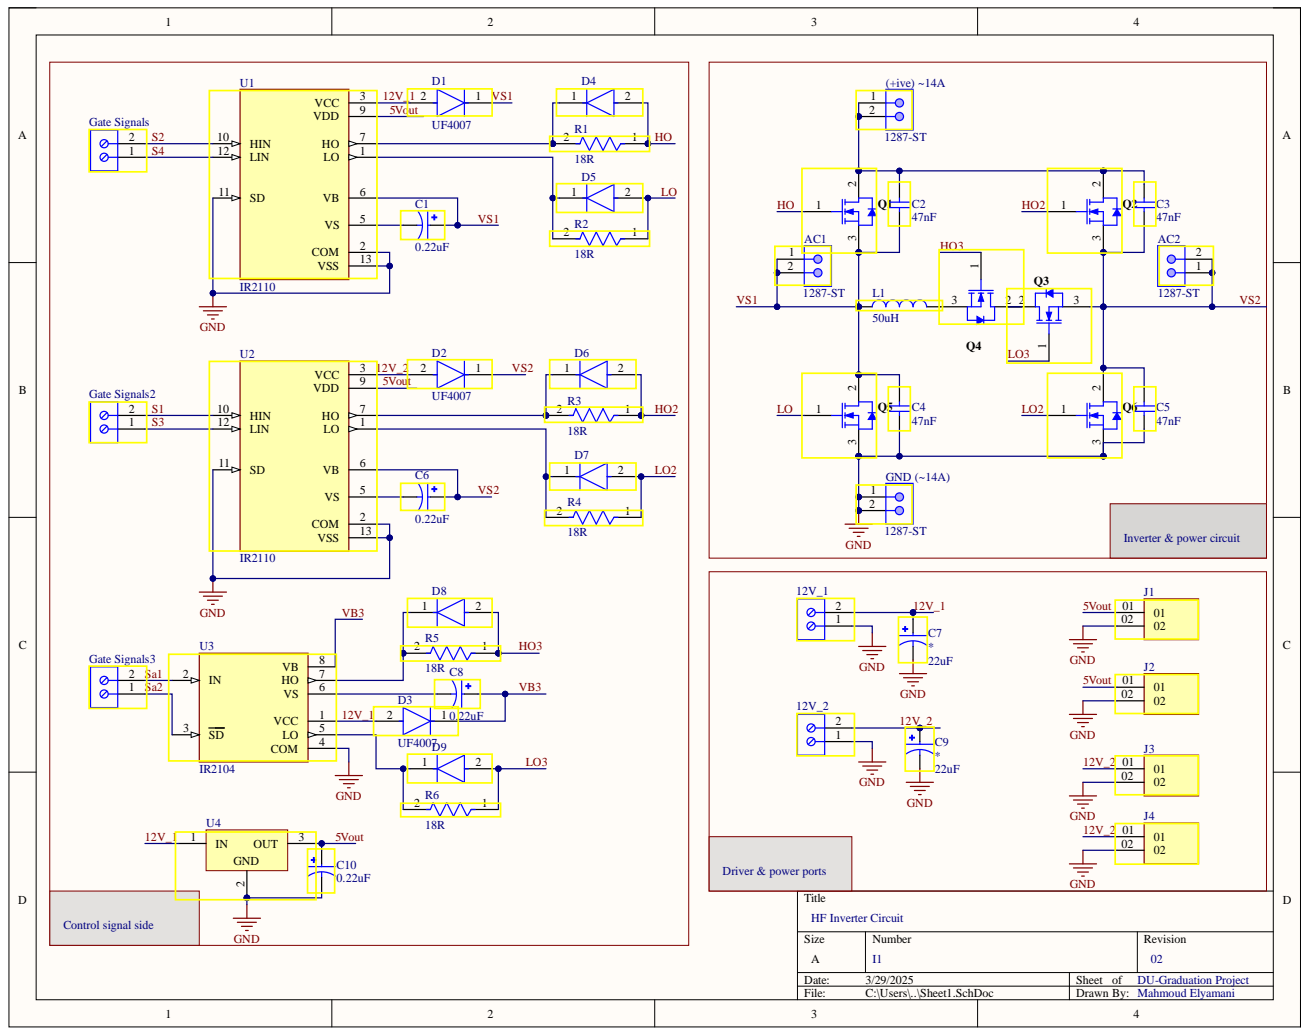
[picture p169: page 12]

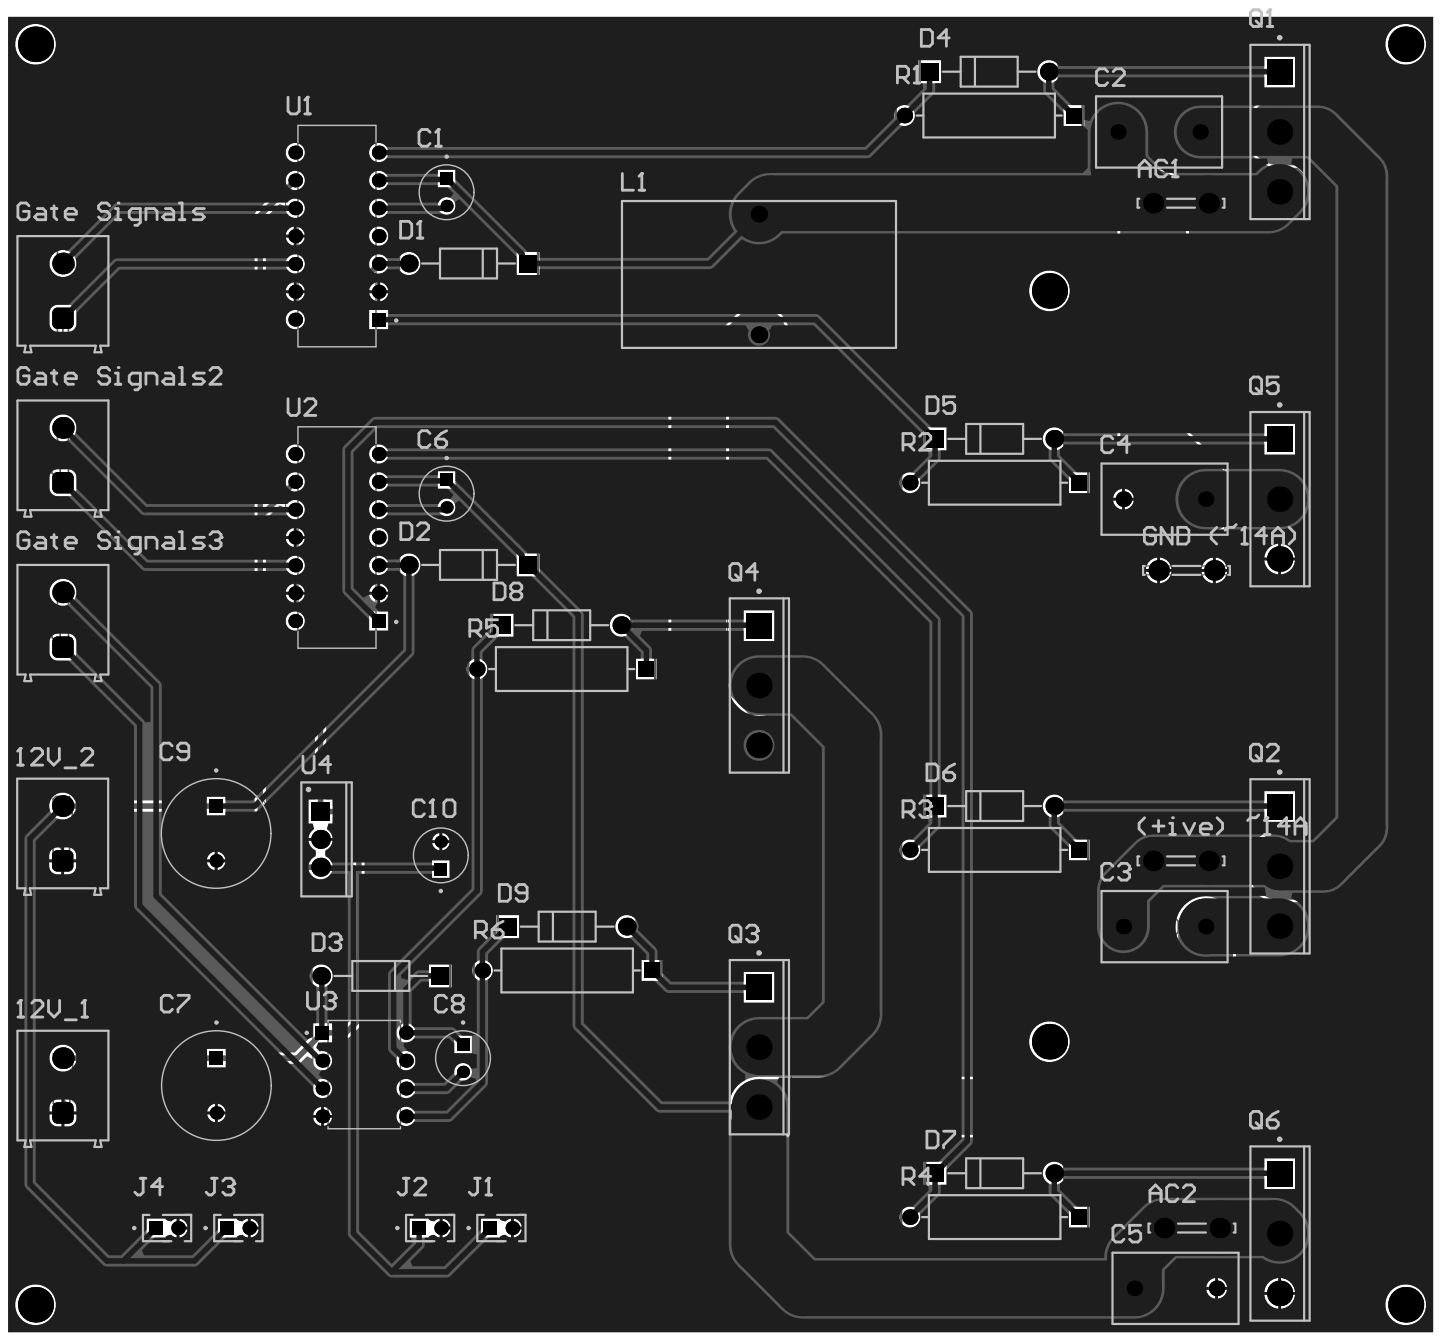
[picture p170: page 13]

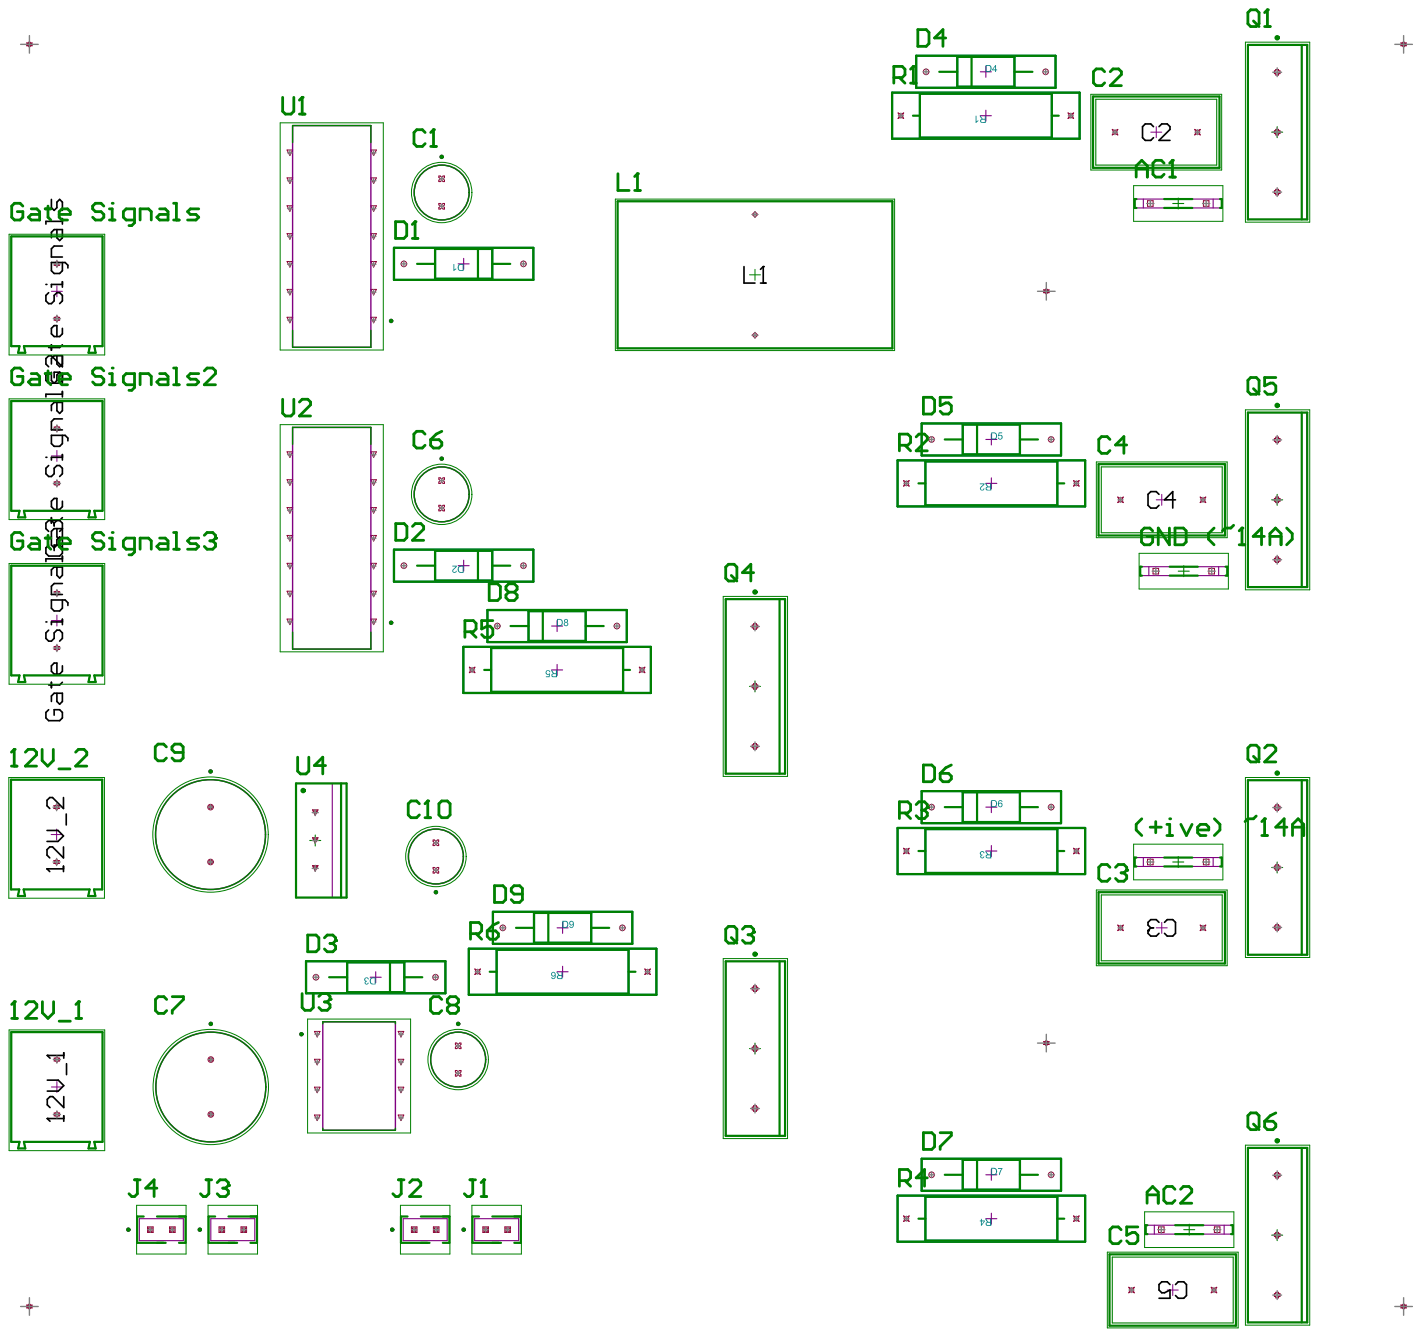
[picture p171: page 15]

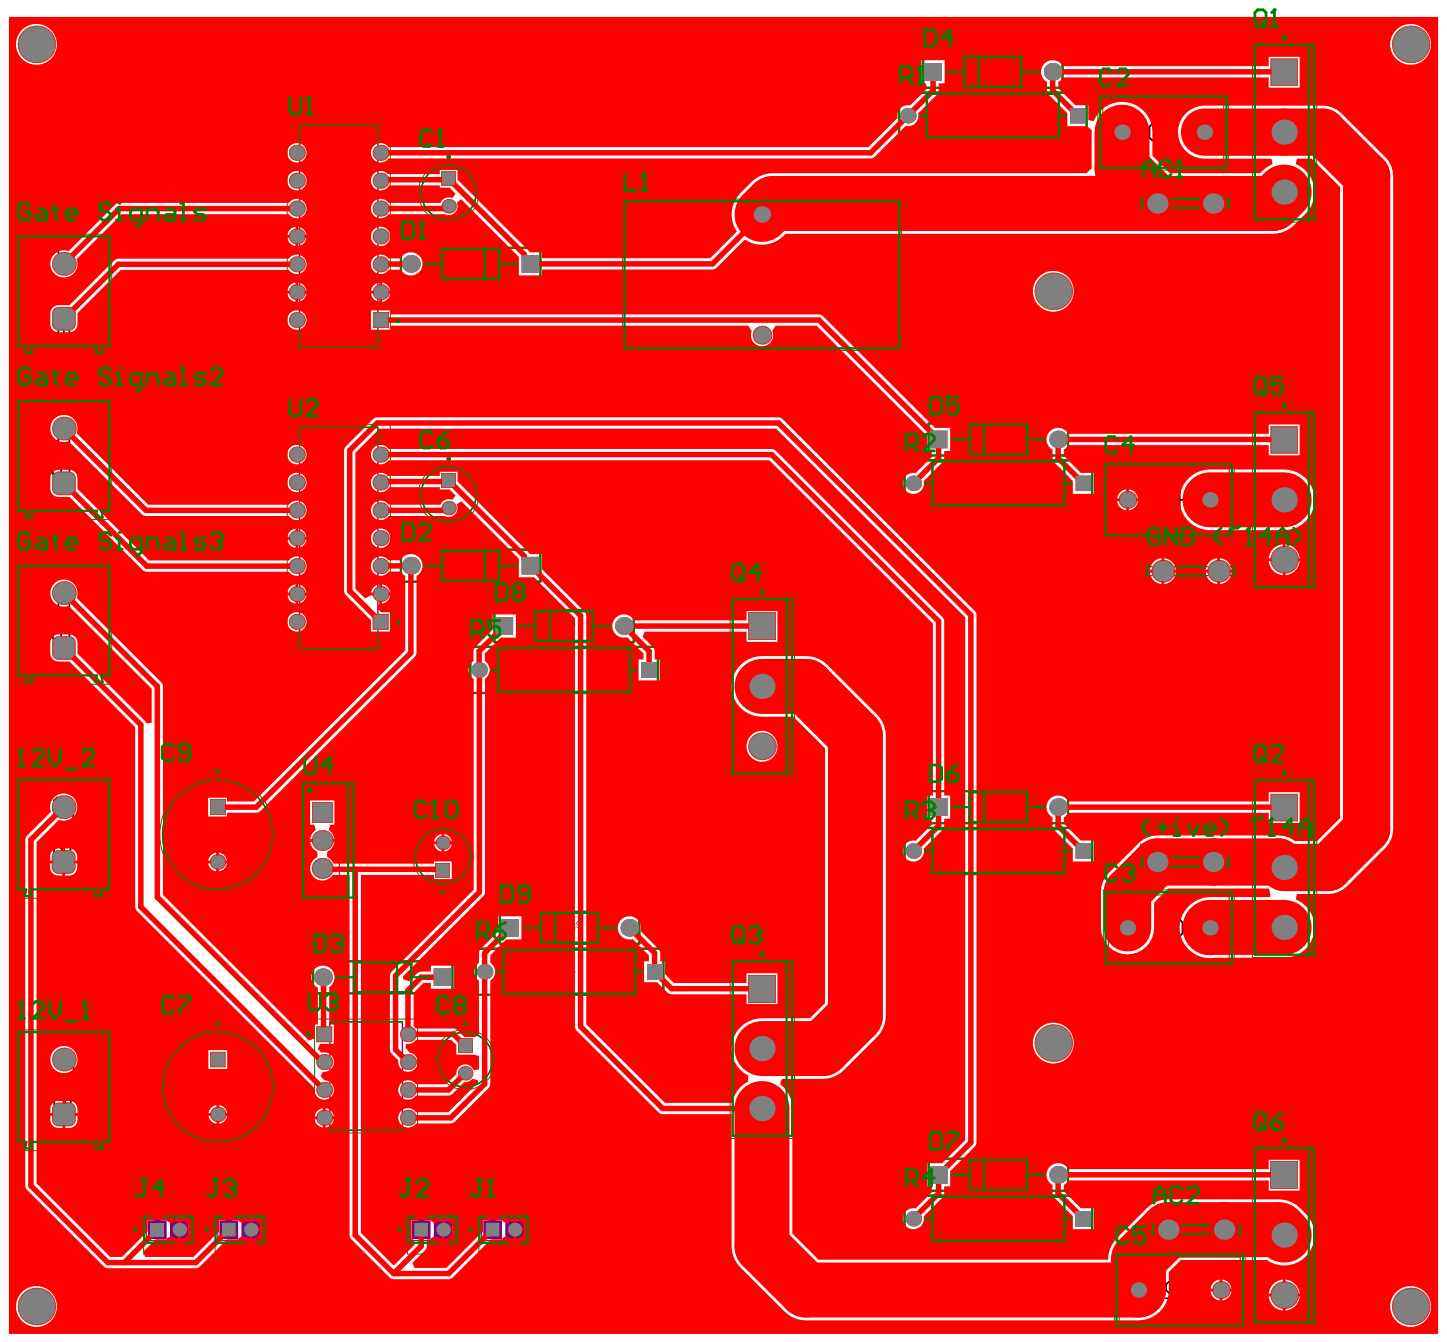
[picture p172: page 16]

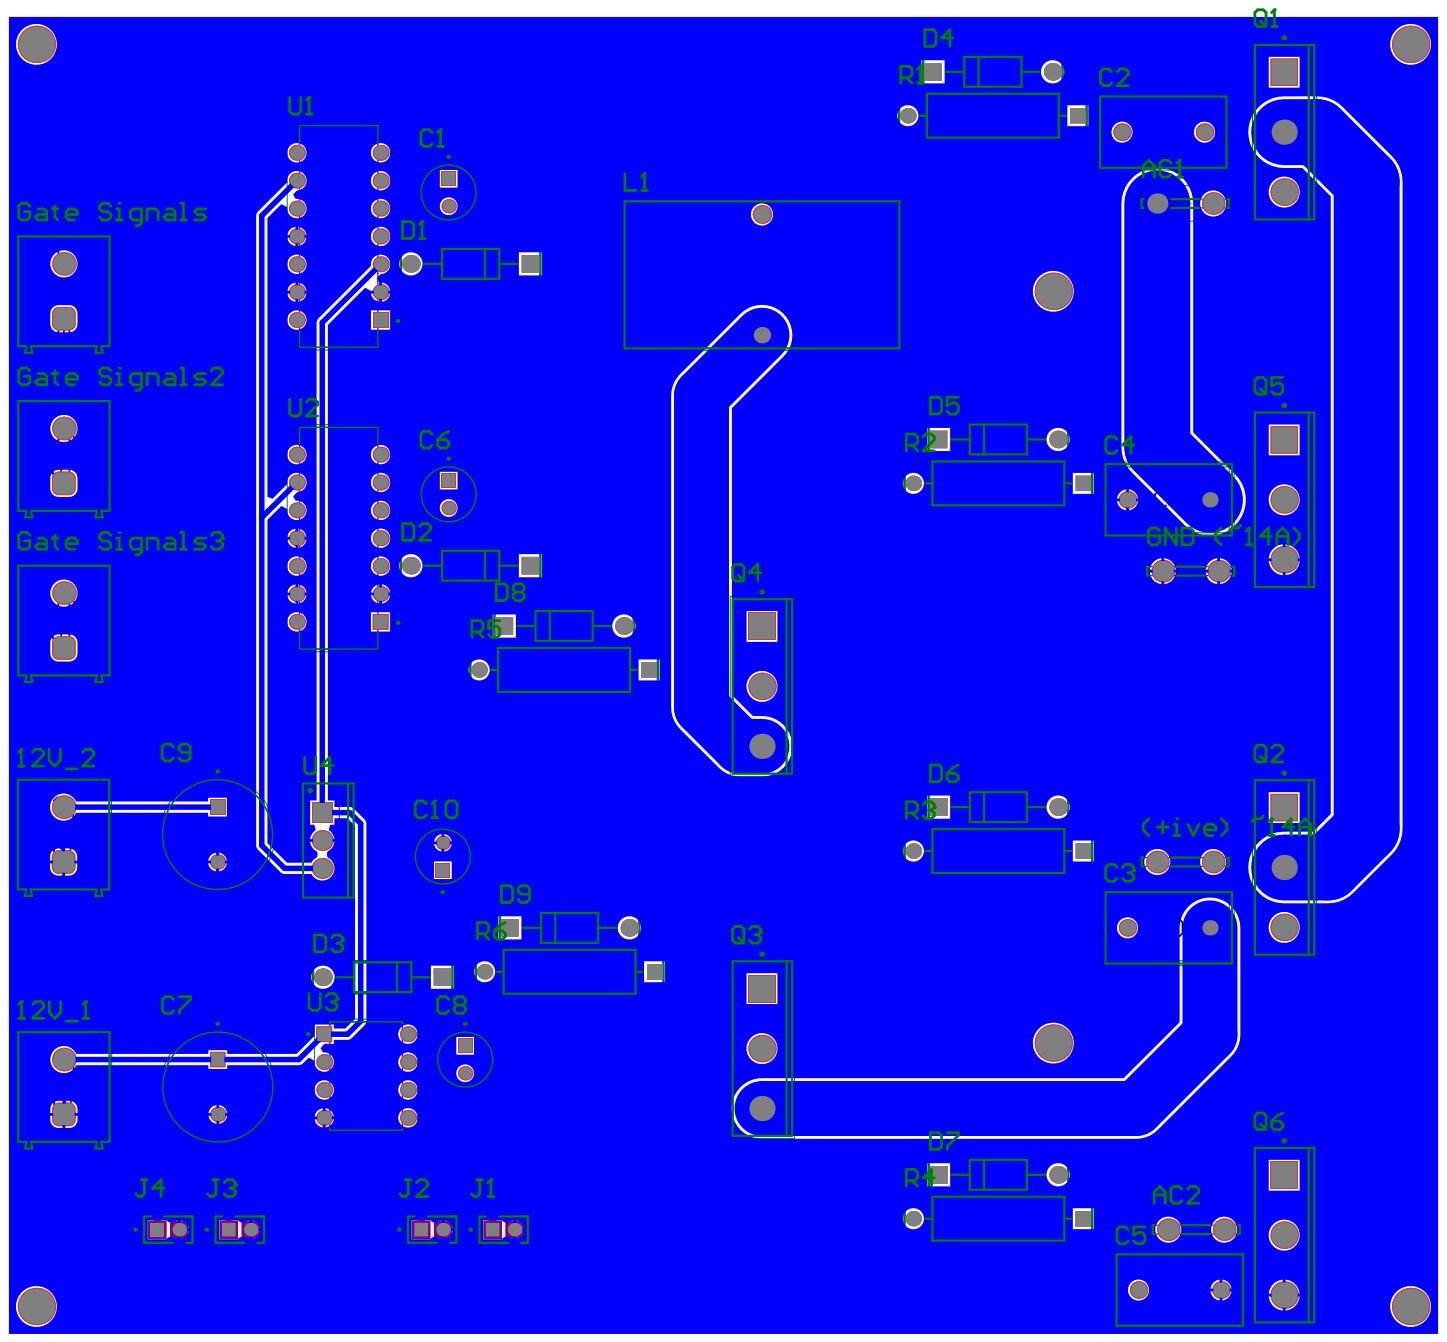
[picture p173: page 17]

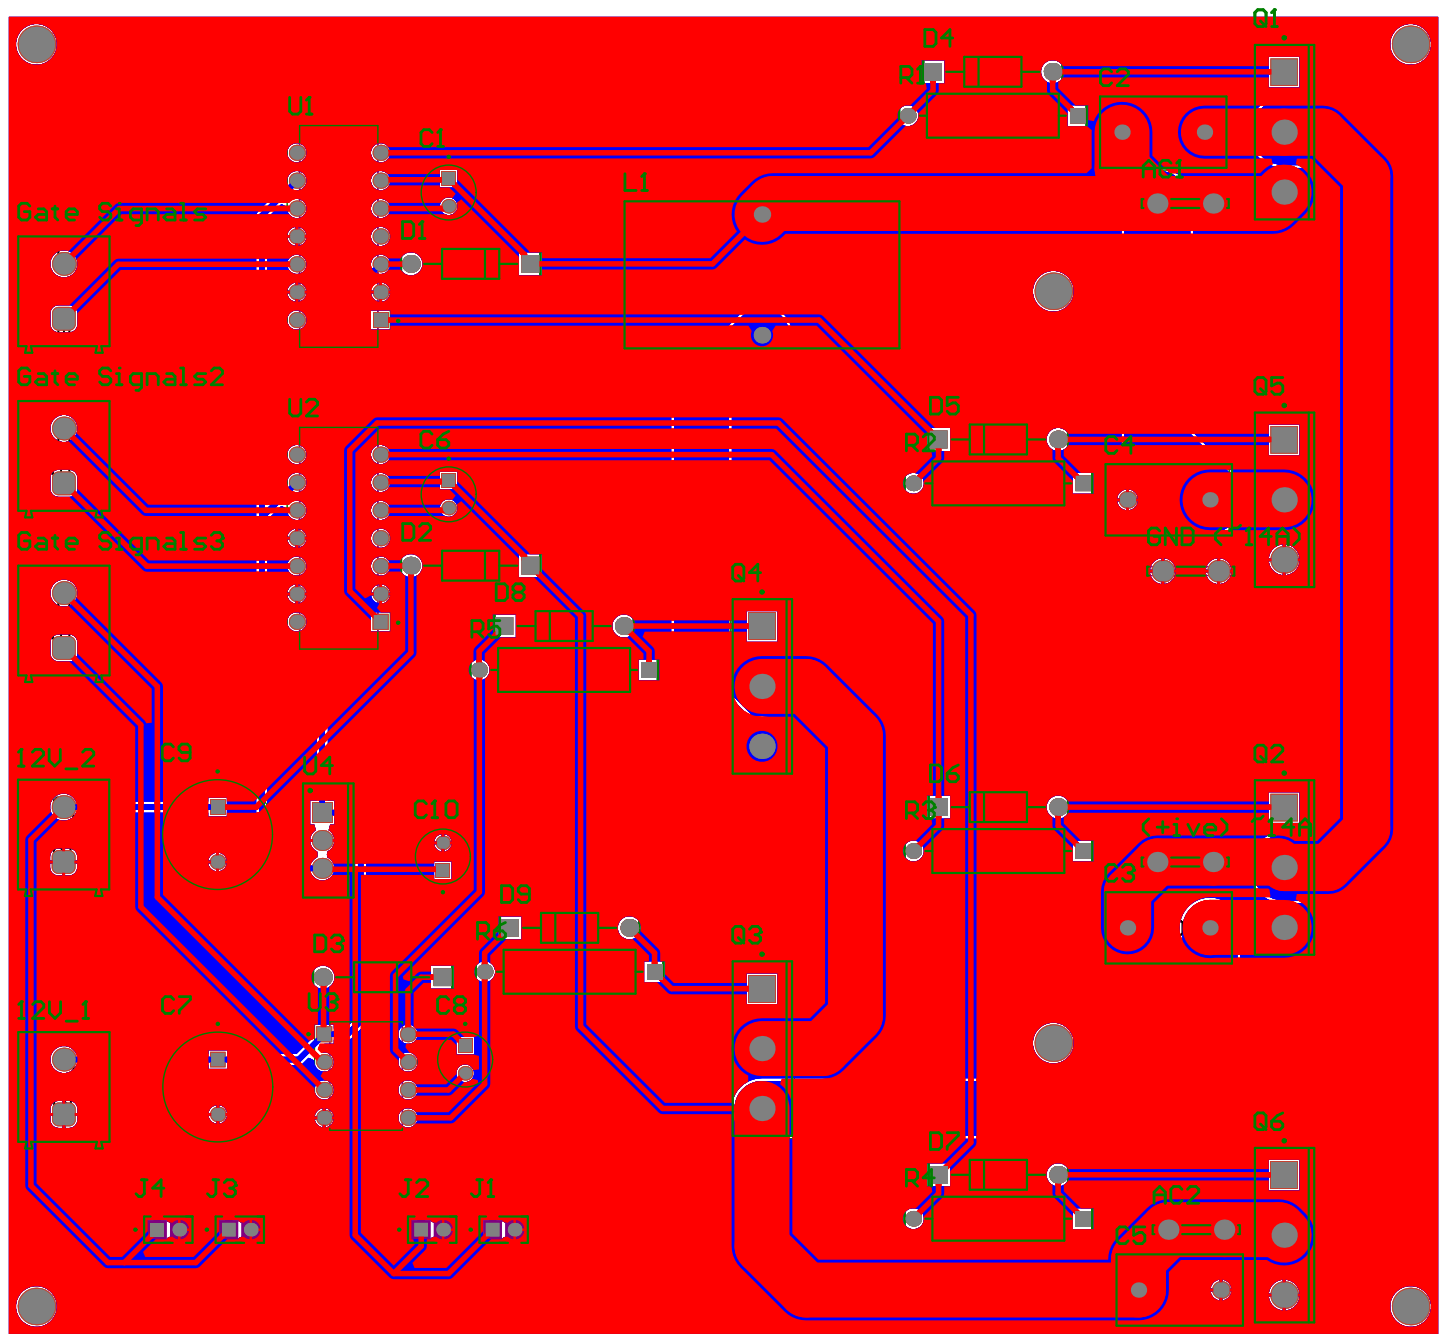
[picture p174: page 18]

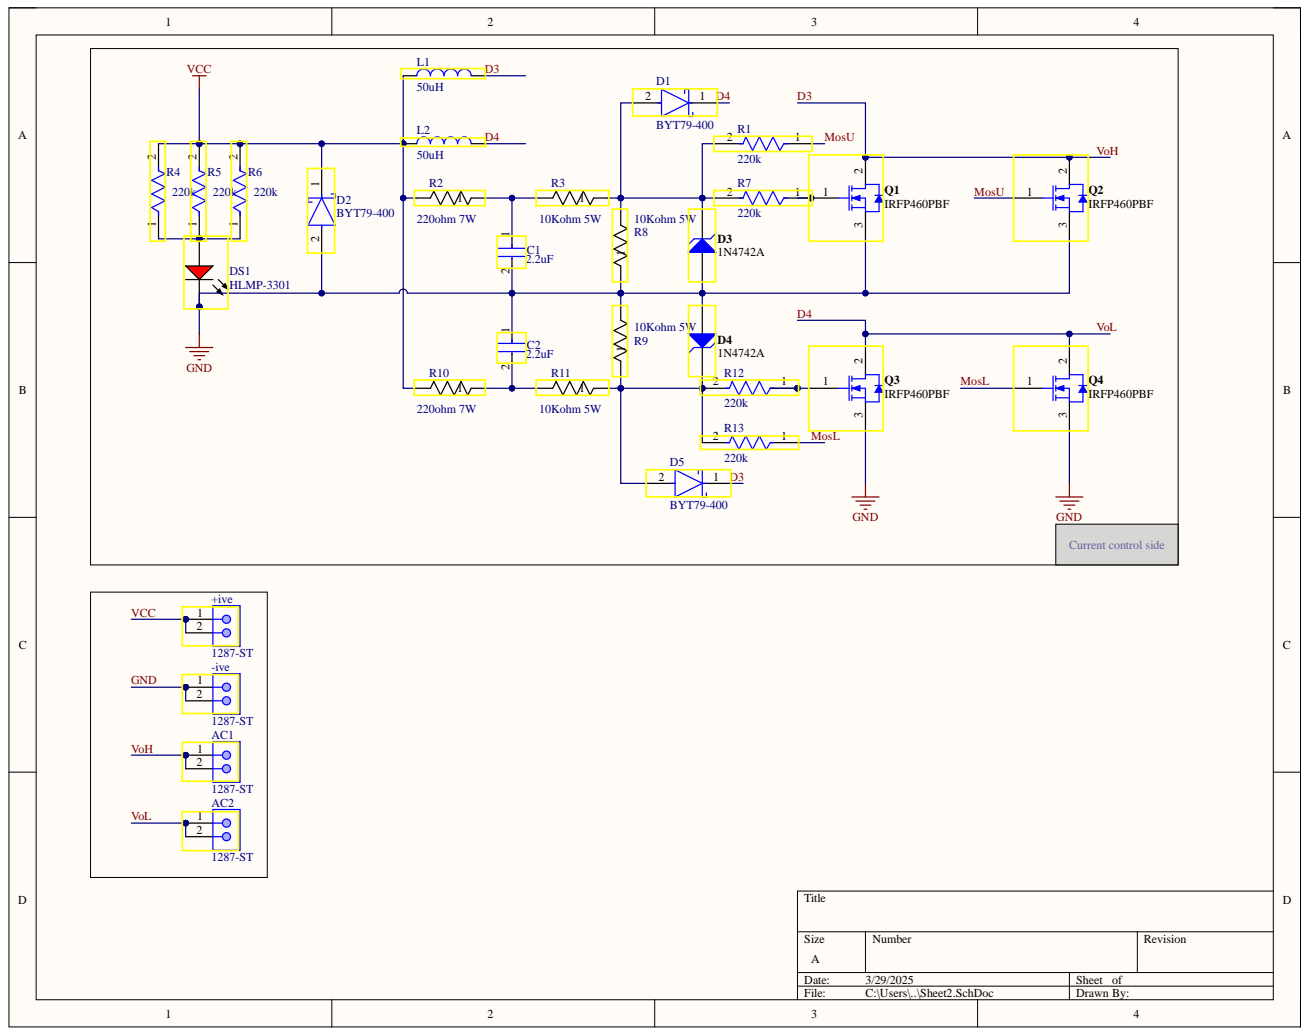
[picture p175: page 19]

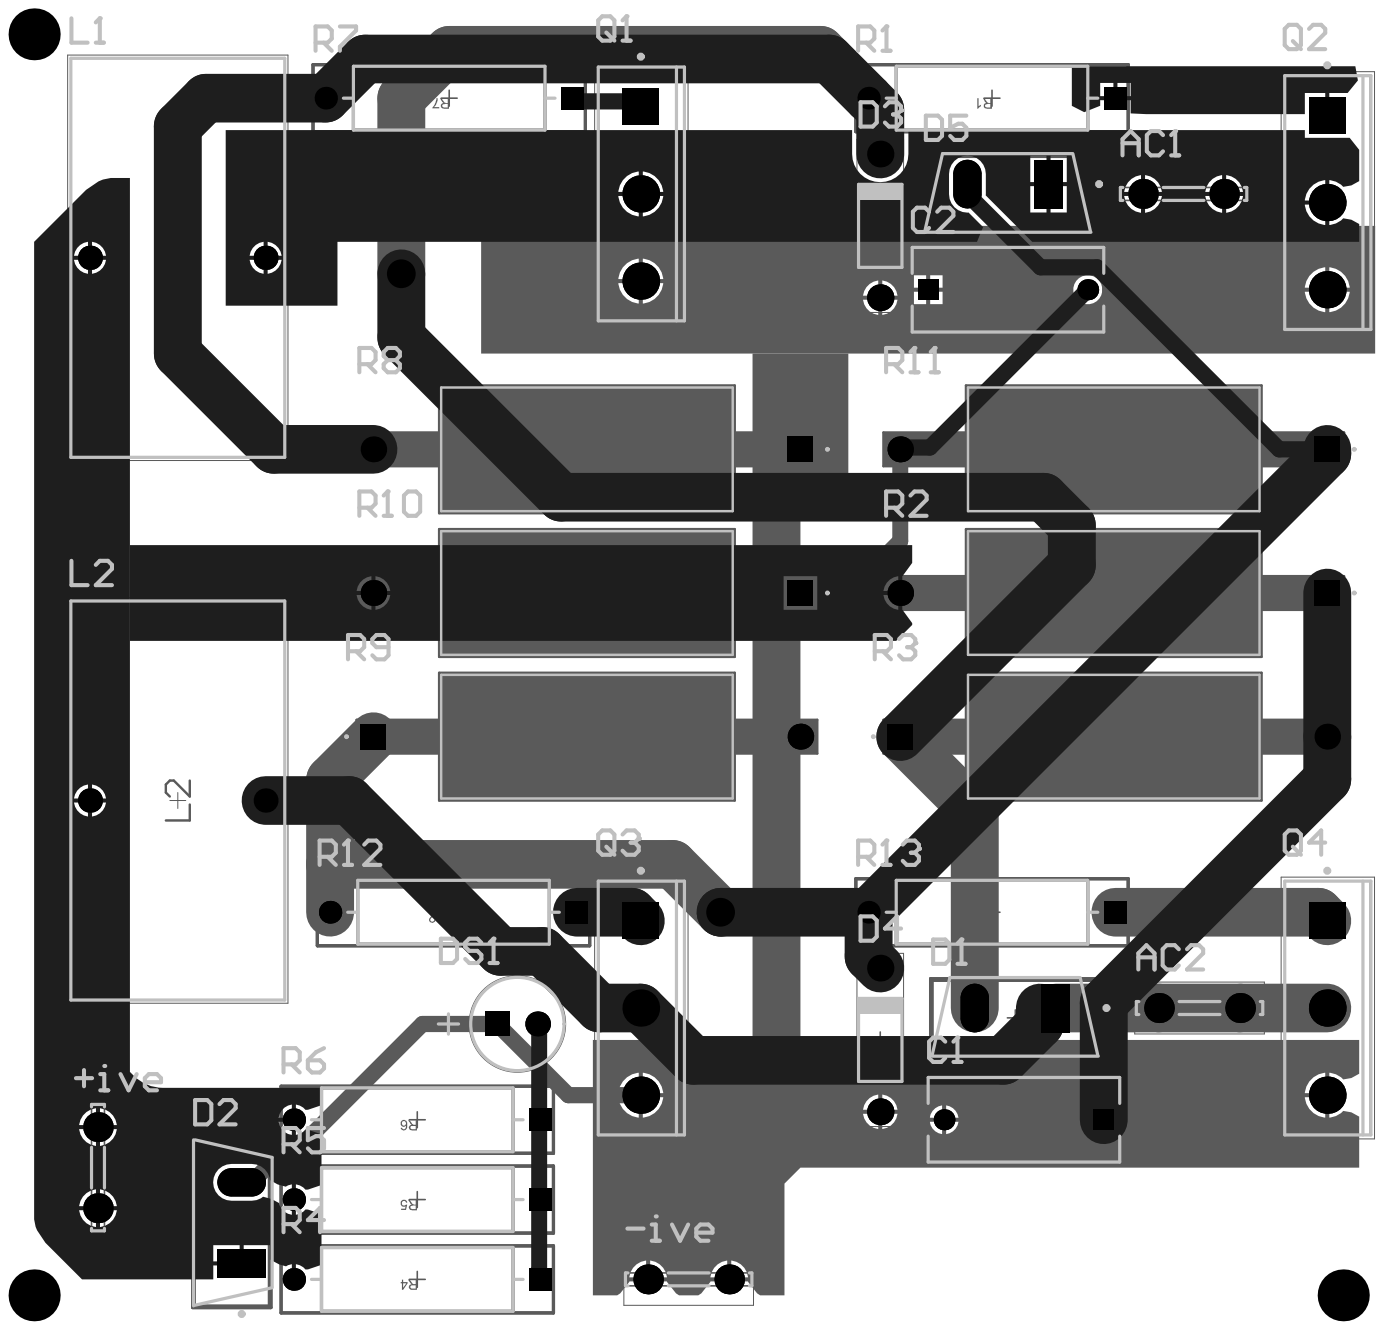
[picture p176: page 20]

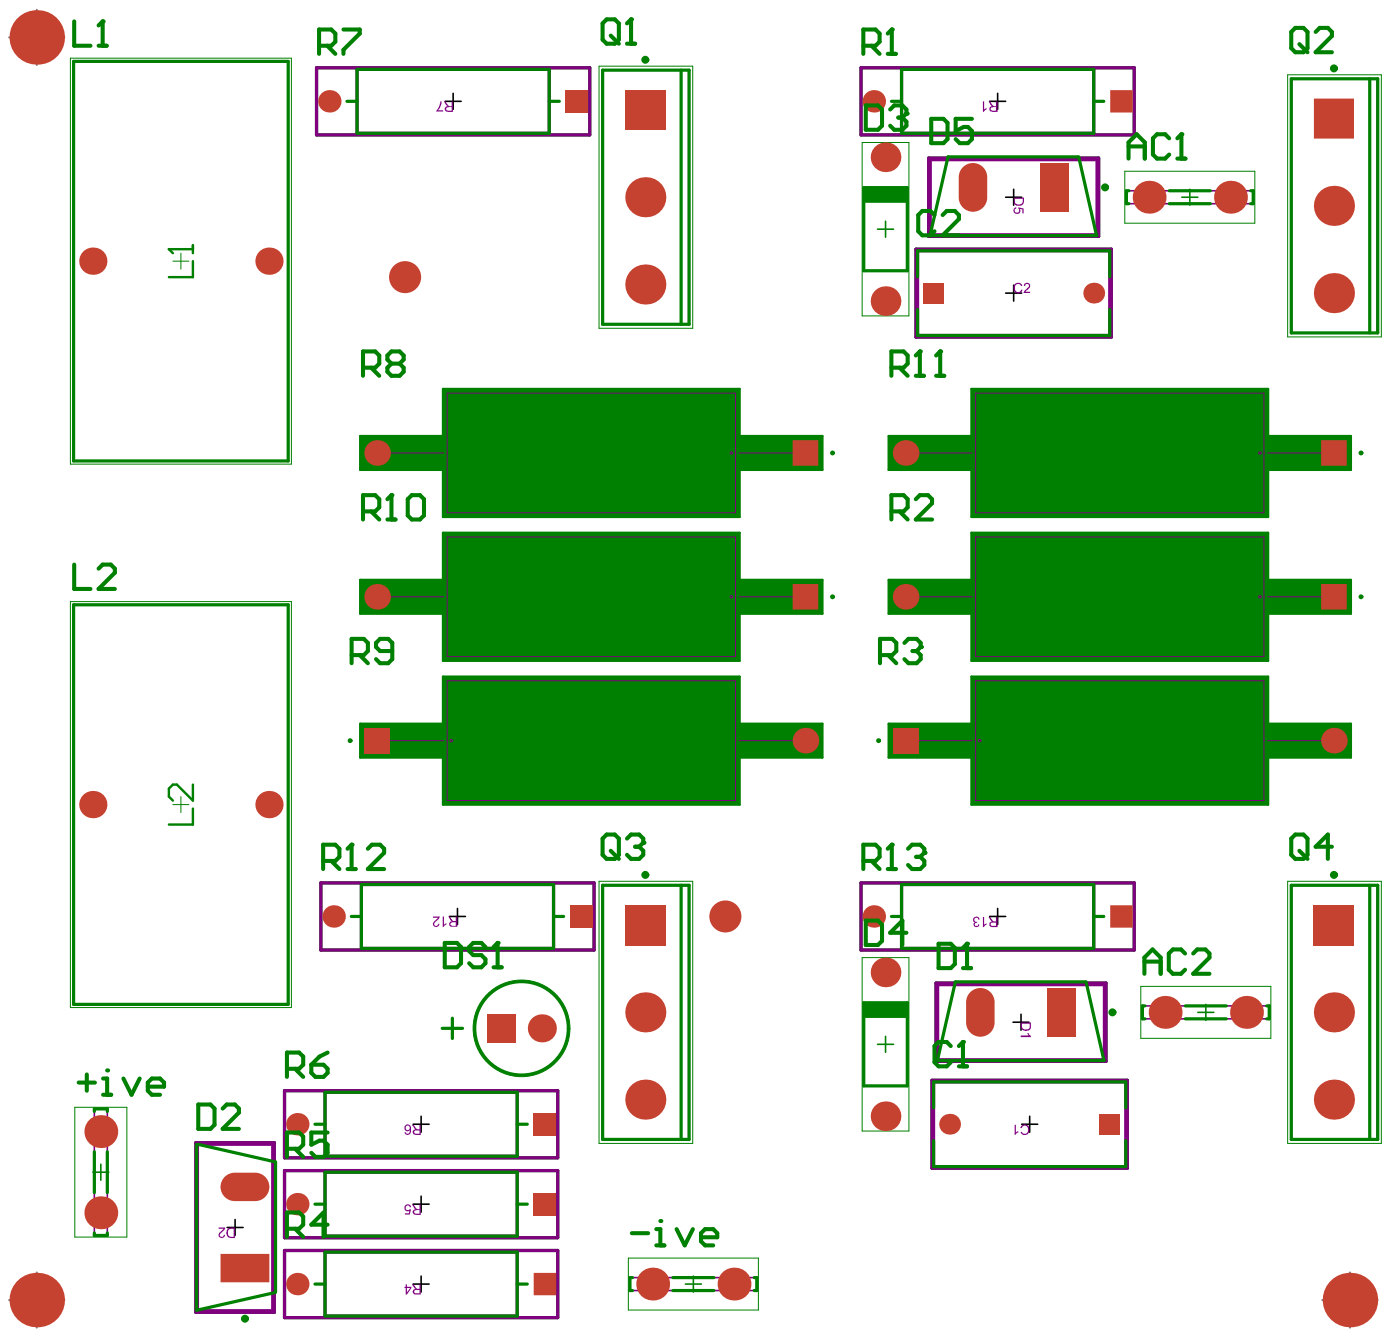
[picture p177: page 22]

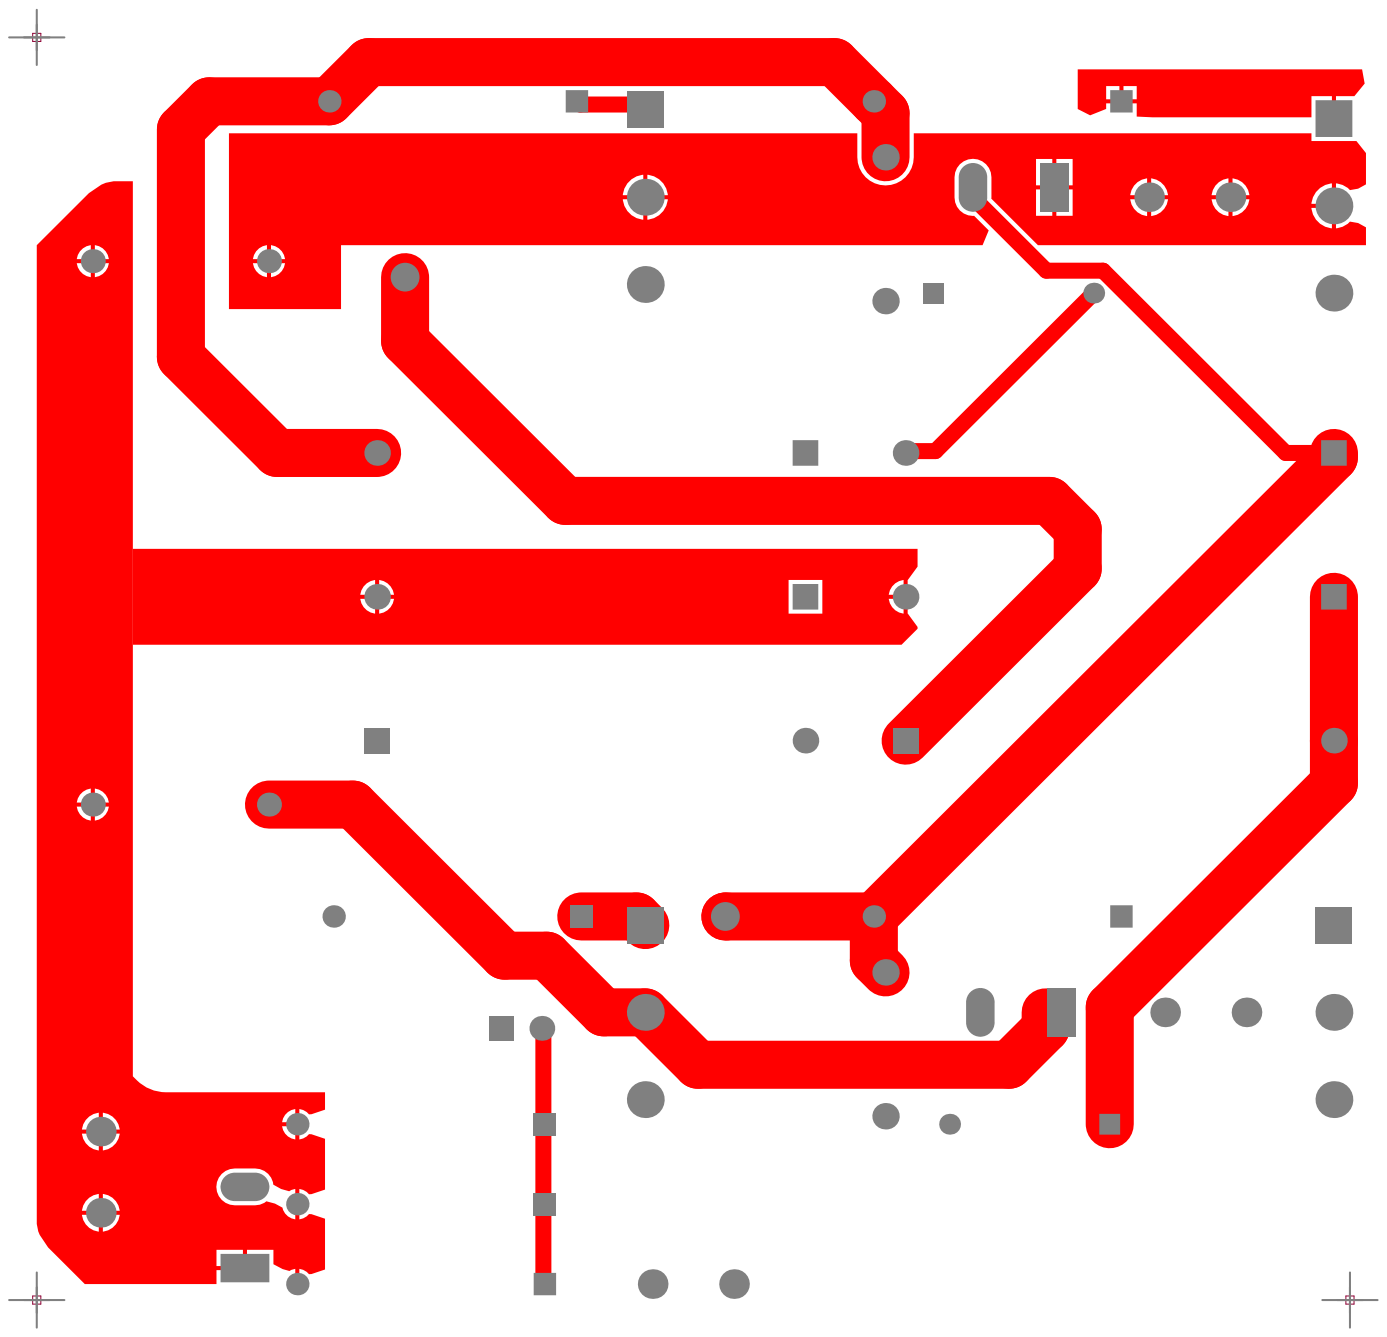
[picture p178: page 23]

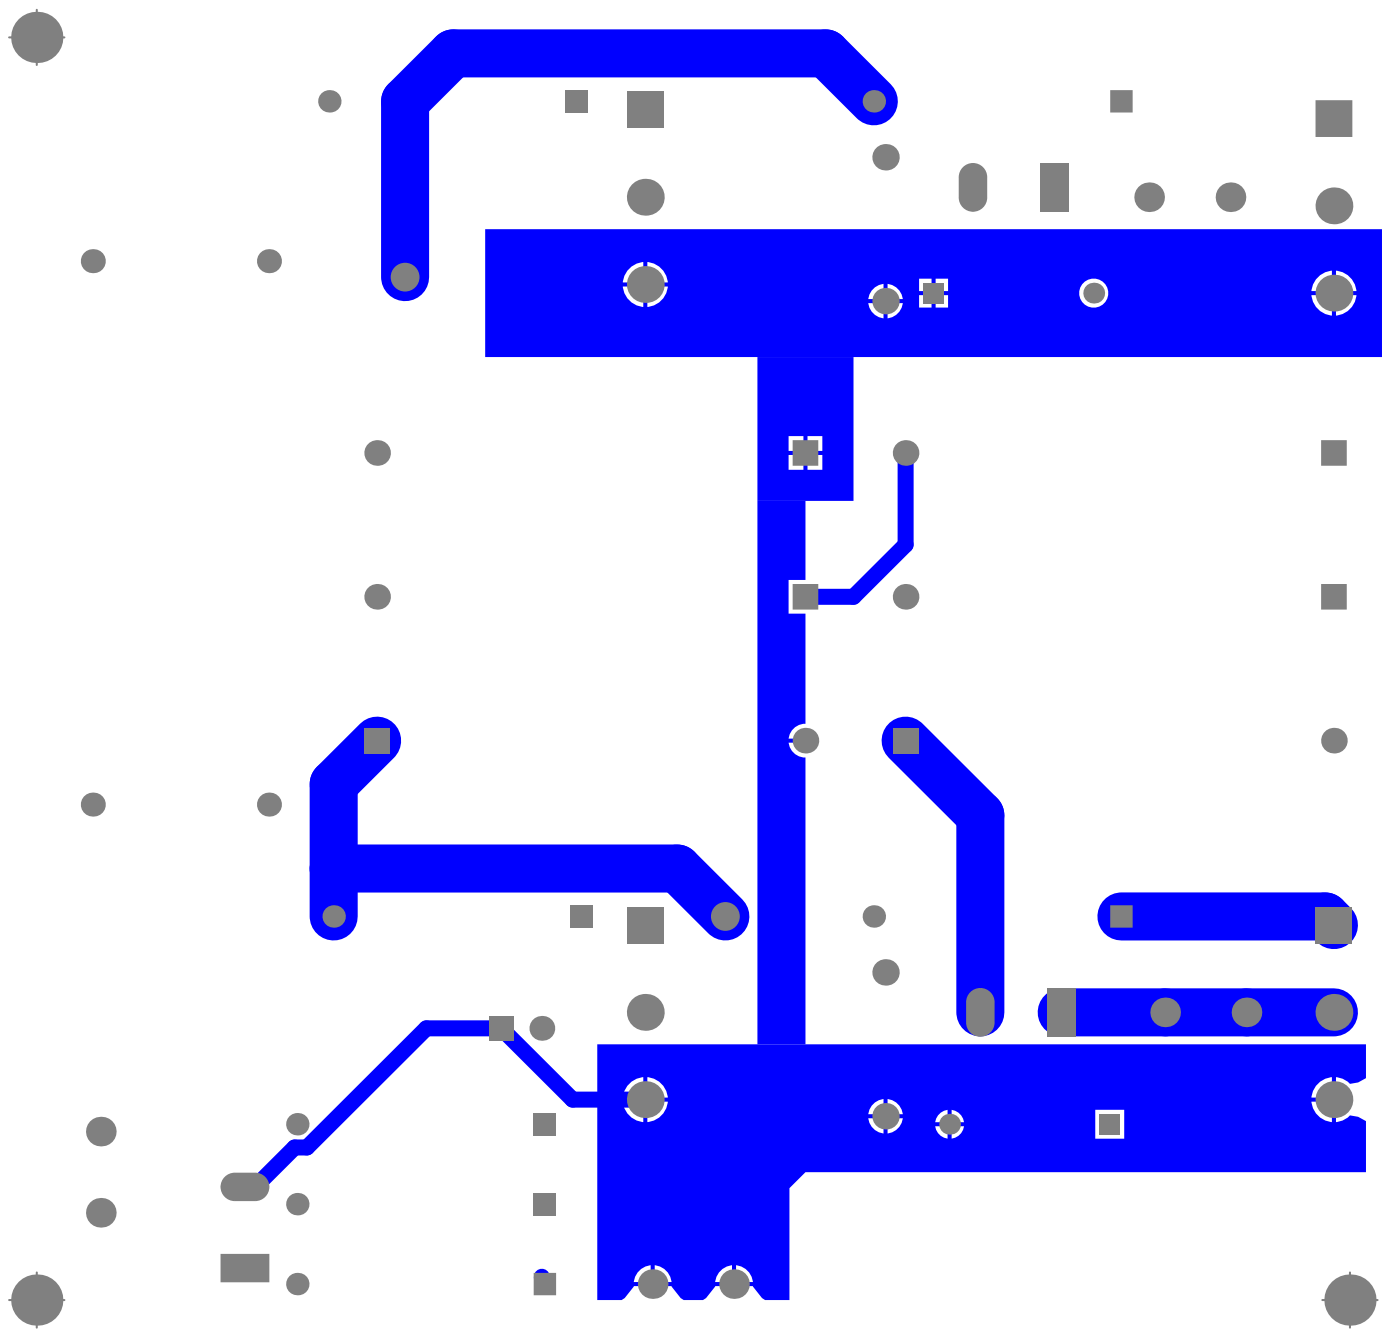
[picture p179: page 24]

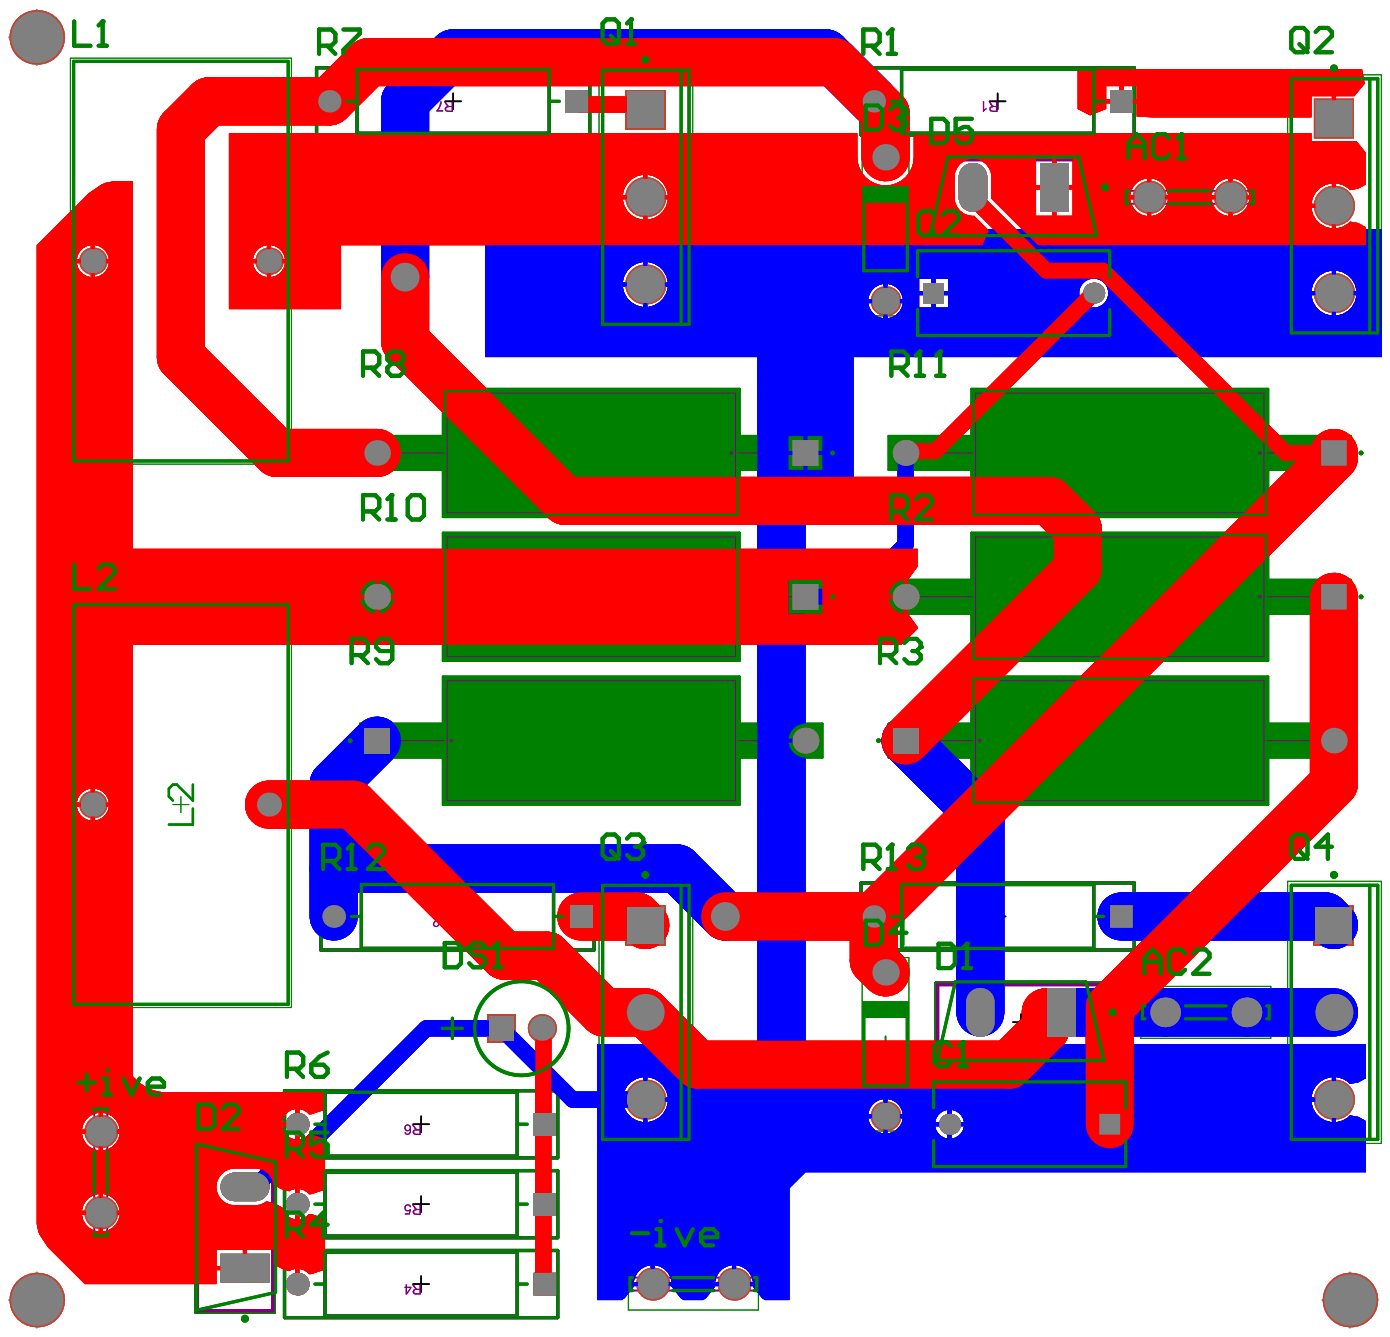
[picture p180: page 25]
