MahmudElyamani/1kW-Resonant-Inductive-Wireless-Power-Transfer-System-Graduation-Project-/Hardware/AltiumProject/PDFtype/InverterV1sch.pdf

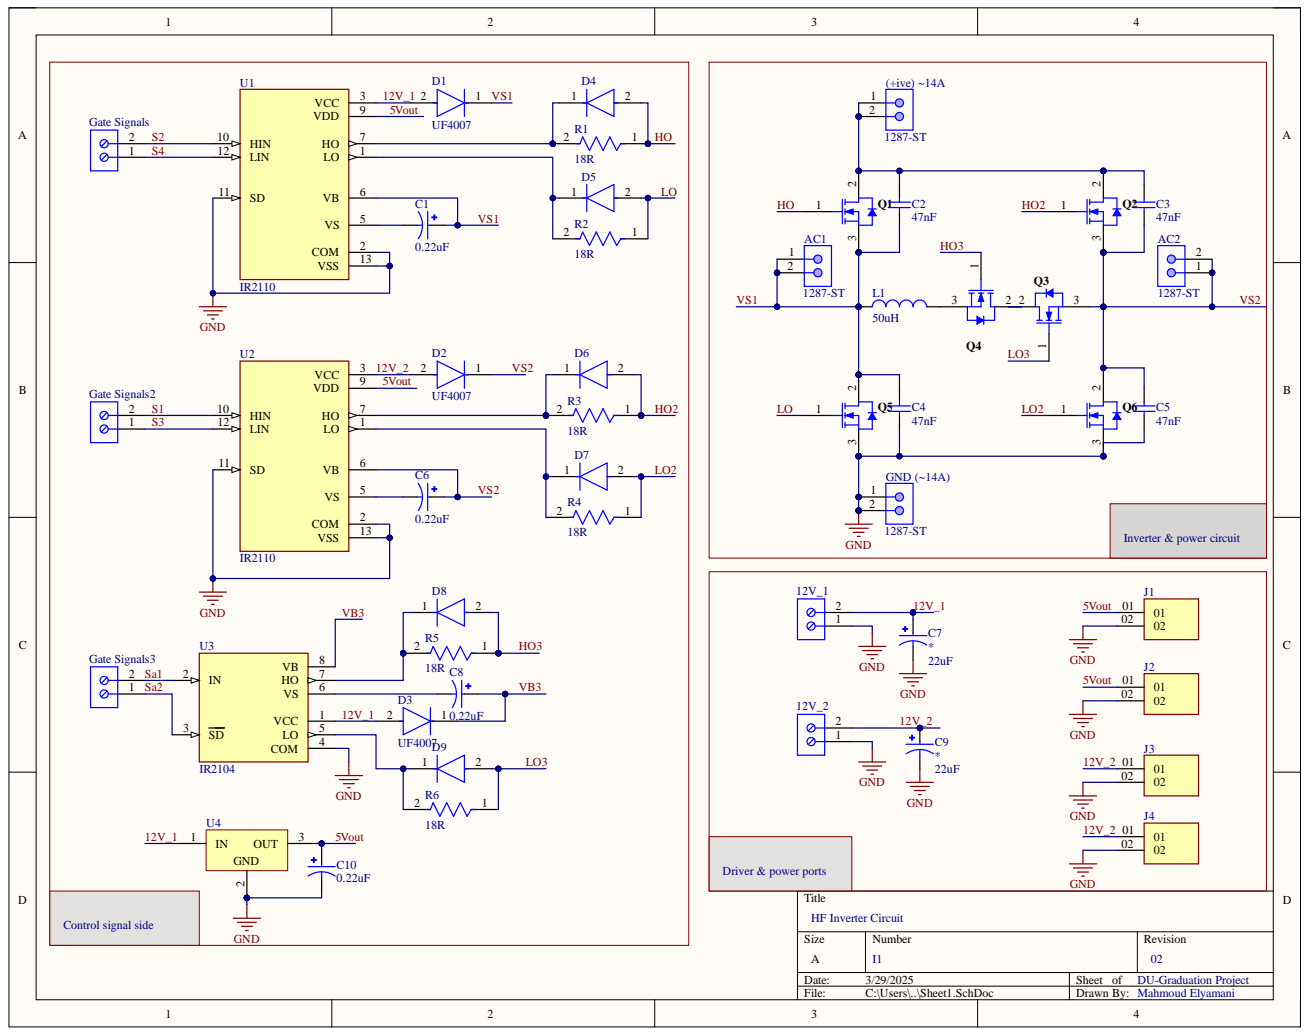
[picture p181: page 1]
