MahmudElyamani/1kW-Resonant-Inductive-Wireless-Power-Transfer-System-Graduation-Project-/Hardware/AltiumProject/PDFtype/InverterV2sch.pdf

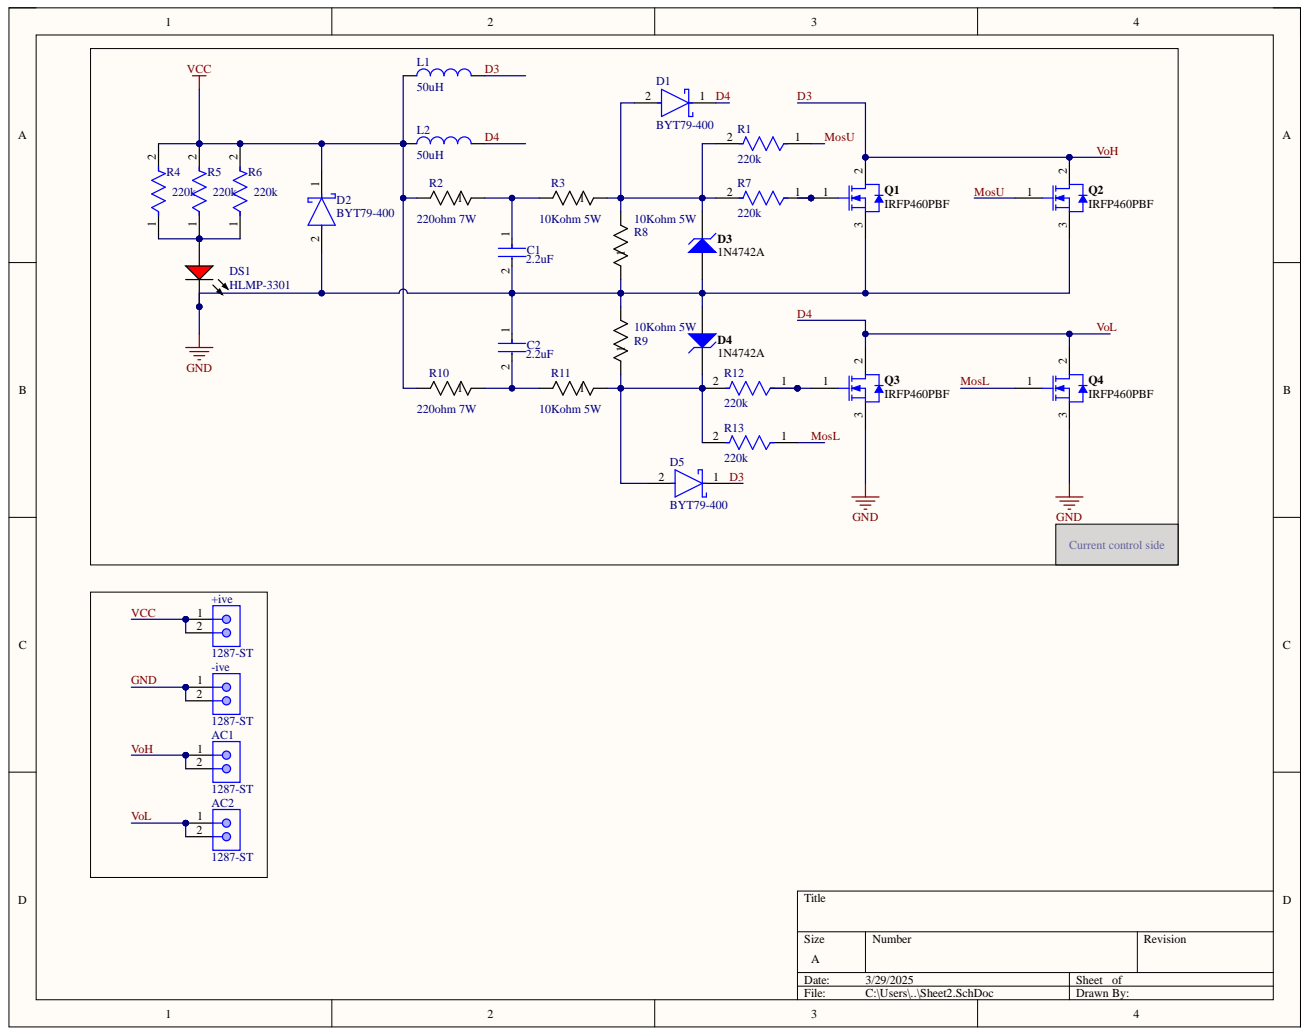
[picture p182: page 1]

VCC | L1 D3

BYT79-400 | D4
