MahmudElyamani/1kW-Resonant-Inductive-Wireless-Power-Transfer-System-Graduation-Project-/Hardware/AltiumProject/PDFtype/RectifierPrime.pdf

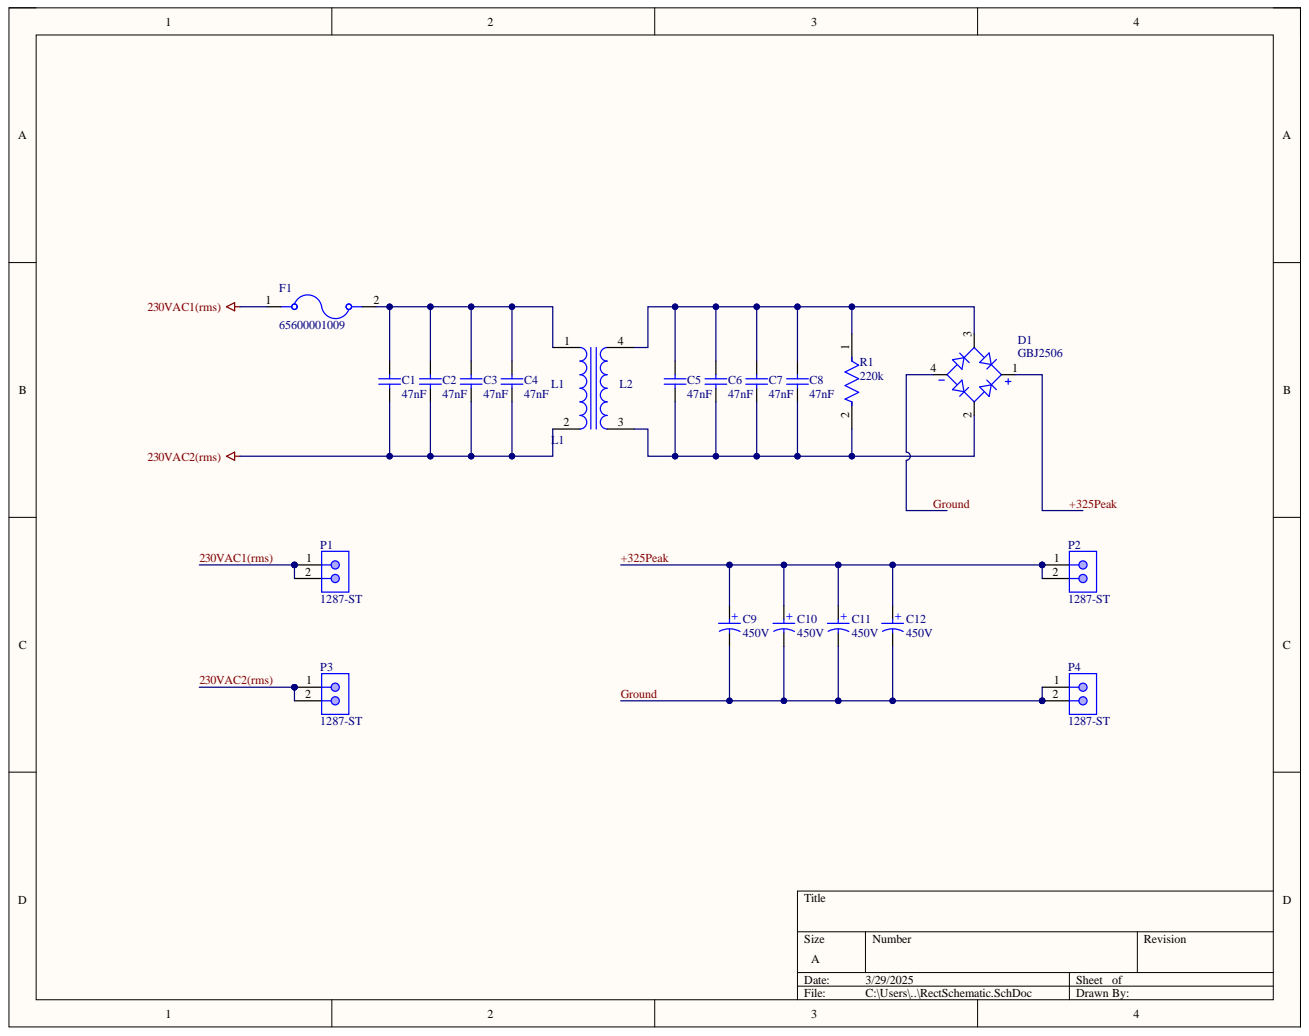
[picture p183: page 1]
