MahmudElyamani/1kW-Resonant-Inductive-Wireless-Power-Transfer-System-Graduation-Project-/Hardware/AltiumProject/PDFtype/RectifierSEcondarysch.pdf

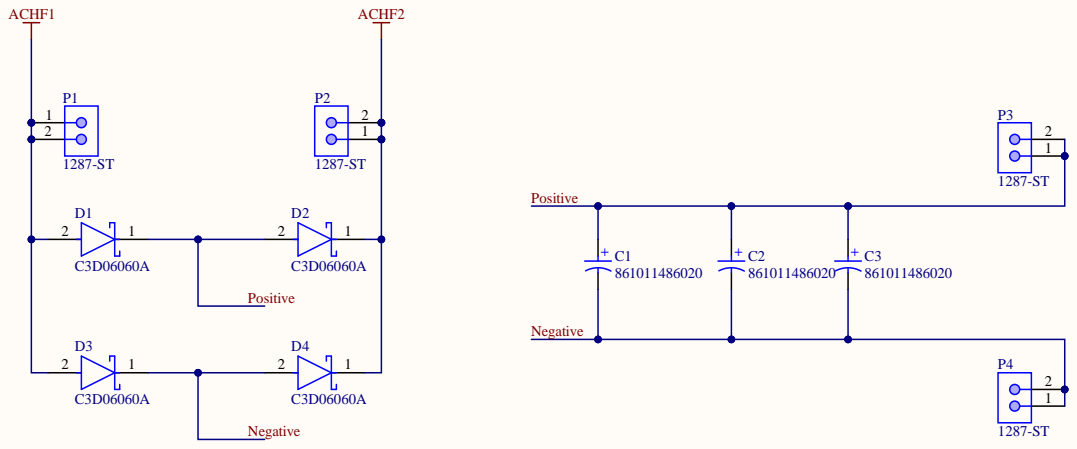
[picture p184: page 1]
