MahmudElyamani/1kW-Resonant-Inductive-Wireless-Power-Transfer-System-Graduation-Project-/(commit log)

2026-08-21 Revise README for 823W EV Charger Prototype
    Updated the README to reflect the new project title, detailed specifications, and project overview for the resonant inductive wireless EV charger prototype.
2026-08-21 Update README with frequency relation graphs
    Added graphs for output power and efficiency relations with operating frequency changes.
2026-08-22 Update README with PWM generation information
    Added PWM generation details to README.
2026-08-22 Update README with STM32F103C6 and Atmega328 info
    Added information about STM32F103C6 code and Atmega328 firmware testing.
2026-08-22 Update README with Arduino firmware image
    Added an image reference for Arduino firmware.
2026-08-22 Added Project code for STM32
2026-08-22 Update Arduino firmware image path in README
2026-08-27 Add results for input voltage vs. output power study
    Added comprehensive results and analysis for input voltage vs. output power characterization, including various load configurations and their performance metrics.
2026-08-27 Add README for System Modeling in MATLAB/Simulink
    Added detailed documentation for the System Modeling project, including modeling methodology, tooling, circuit building, resonance verification, and example readings.
2026-08-27 Add README for Power Electronics PCB Designs
    Added detailed documentation for power electronics PCB designs, including input rectifier, secondary-side rectifier, and HF inverter driver boards.
2026-08-27 Update BOM file reference in README
2026-08-27 Revise links in README for project resources
    Updated links in README for Power Electronics and Full Project Book.
